damnitzhemanth-oss/FusionBoard/Images/Additional/DaVinciWho.png

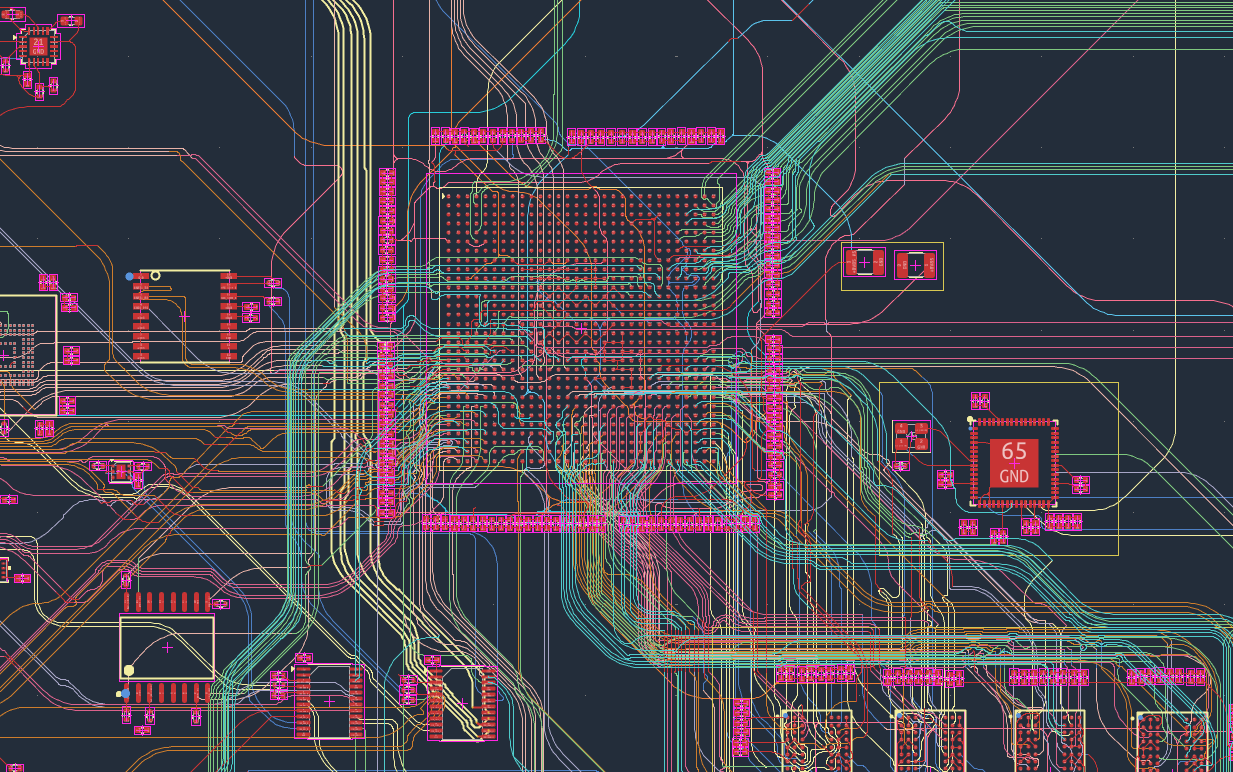
Images/Additional/DaVinciWho.png
