damnitzhemanth-oss/FusionBoard/Images/Additional/DRC.png

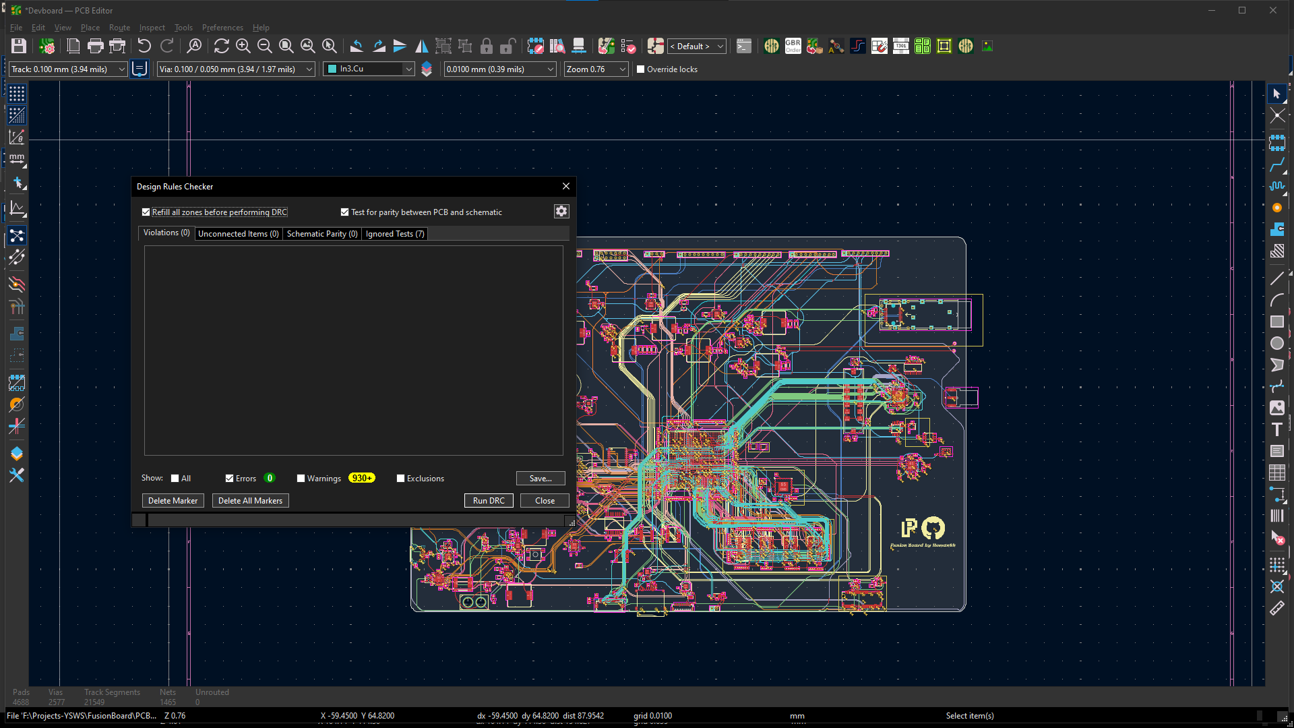
Images/Additional/DRC.png
