damnitzhemanth-oss/FusionBoard/Images/PCB/B-3D.png

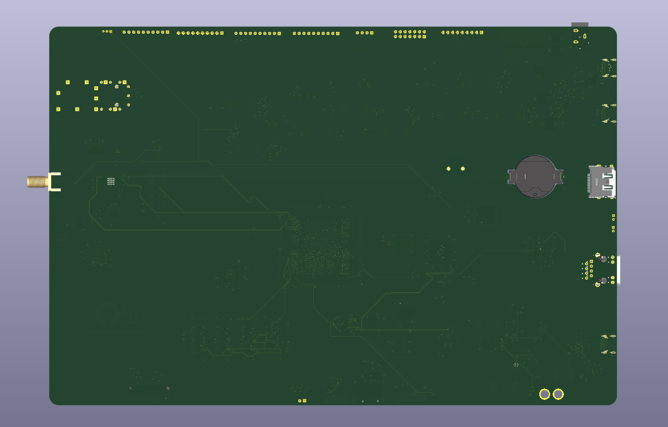
Images/PCB/B-3D.png
