damnitzhemanth-oss/FusionBoard/Images/PCB/DRC.png

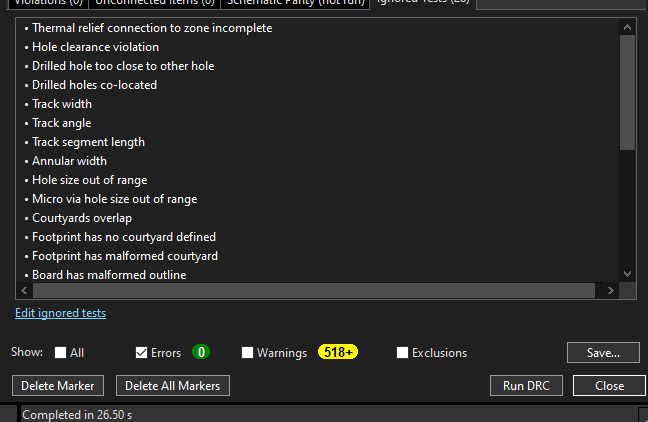
Images/PCB/DRC.png
