damnitzhemanth-oss/FusionBoard/Images/PCB/F-3D.png

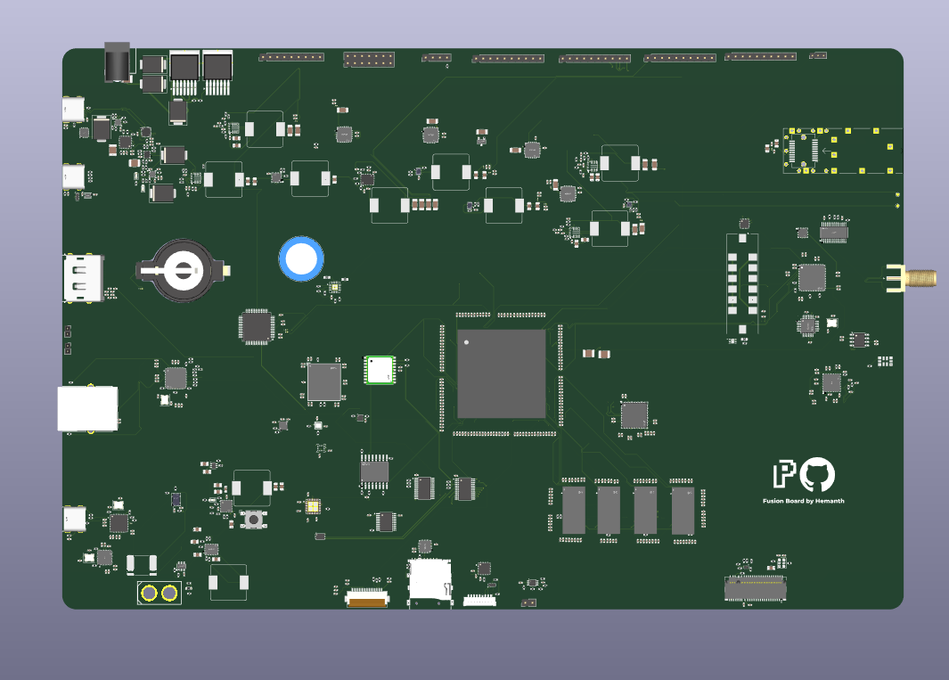
Images/PCB/F-3D.png
