damnitzhemanth-oss/FusionBoard/Images/PCB/F.cu.png

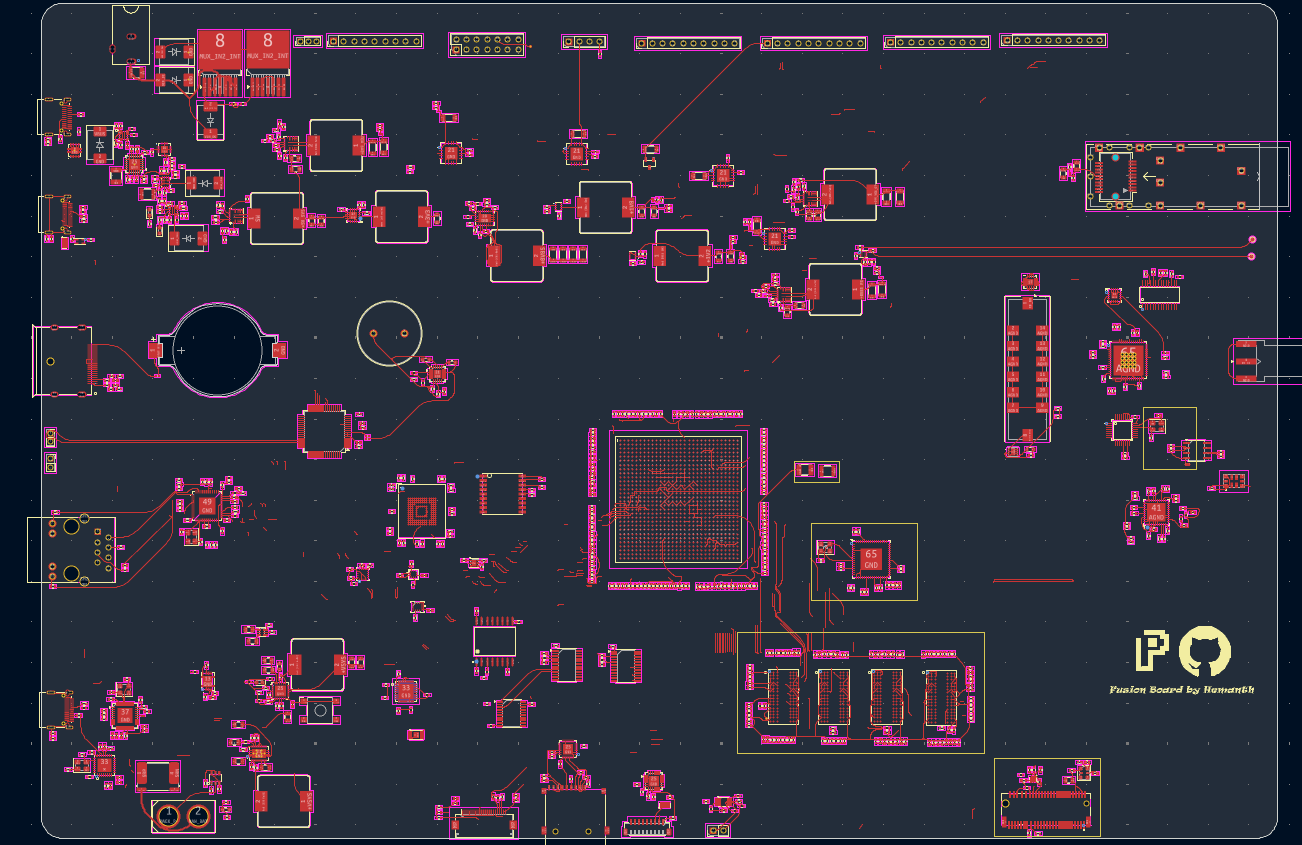
Images/PCB/F.cu.png
