damnitzhemanth-oss/FusionBoard/Images/PCB/Hero_3D.png

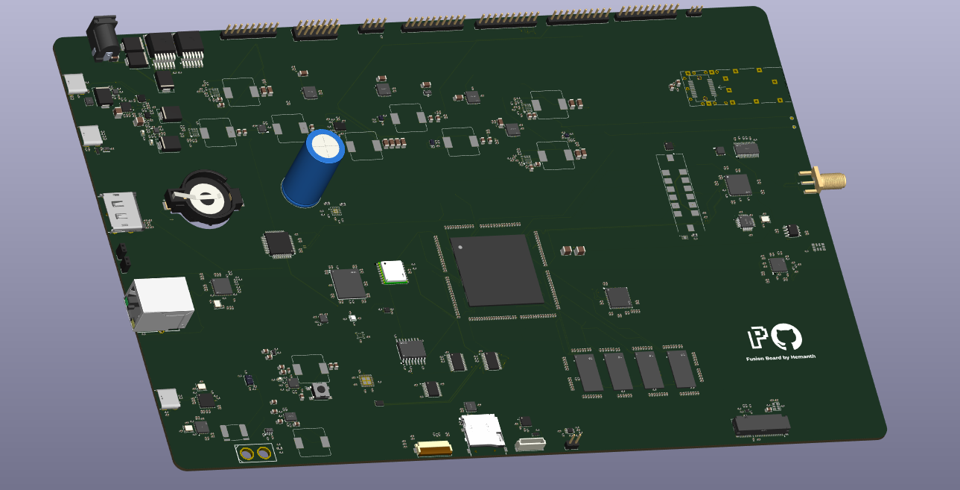
Images/PCB/Hero_3D.png
