damnitzhemanth-oss/FusionBoard/Images/PCB/In1.cu.png

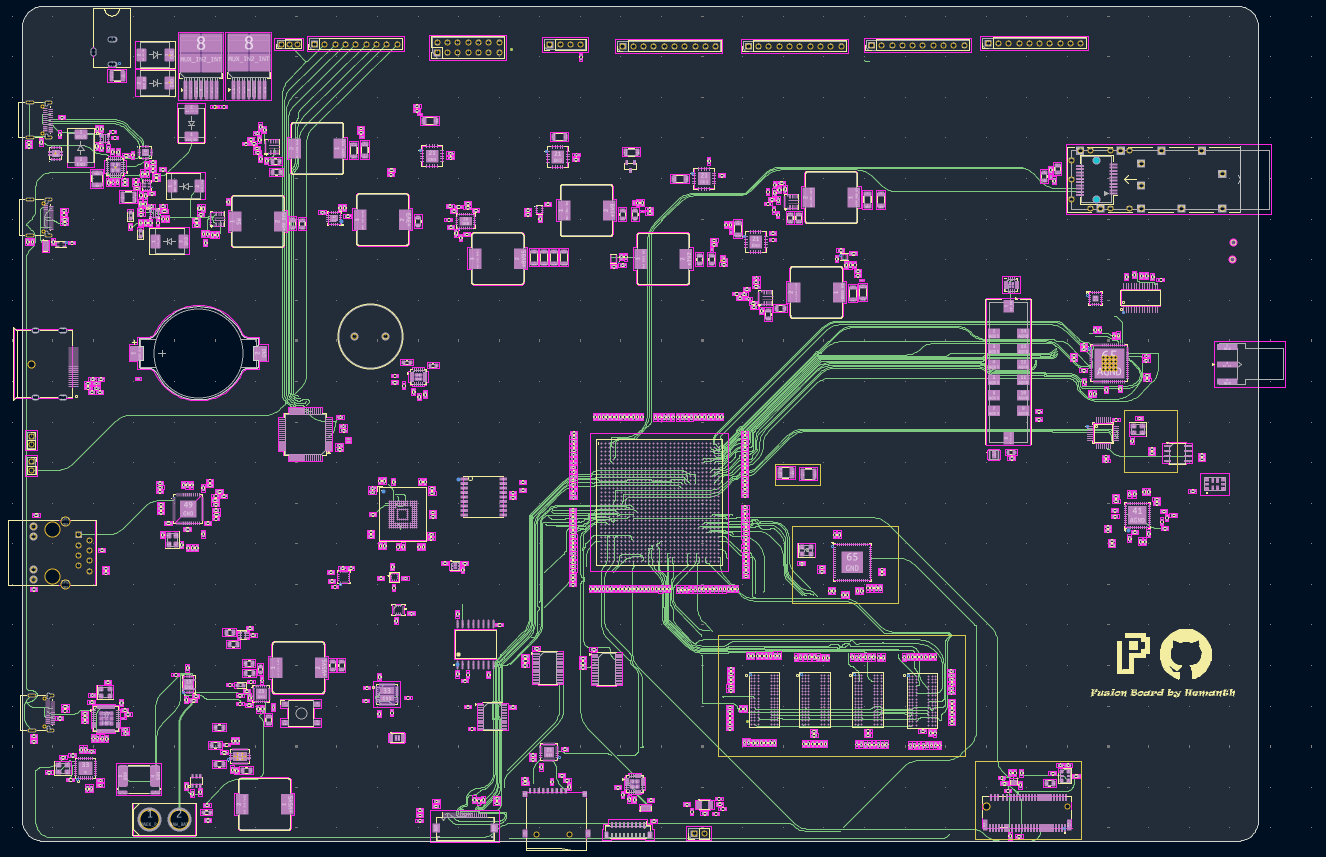
Images/PCB/In1.cu.png
