damnitzhemanth-oss/FusionBoard/Images/PCB/In2.cu.png

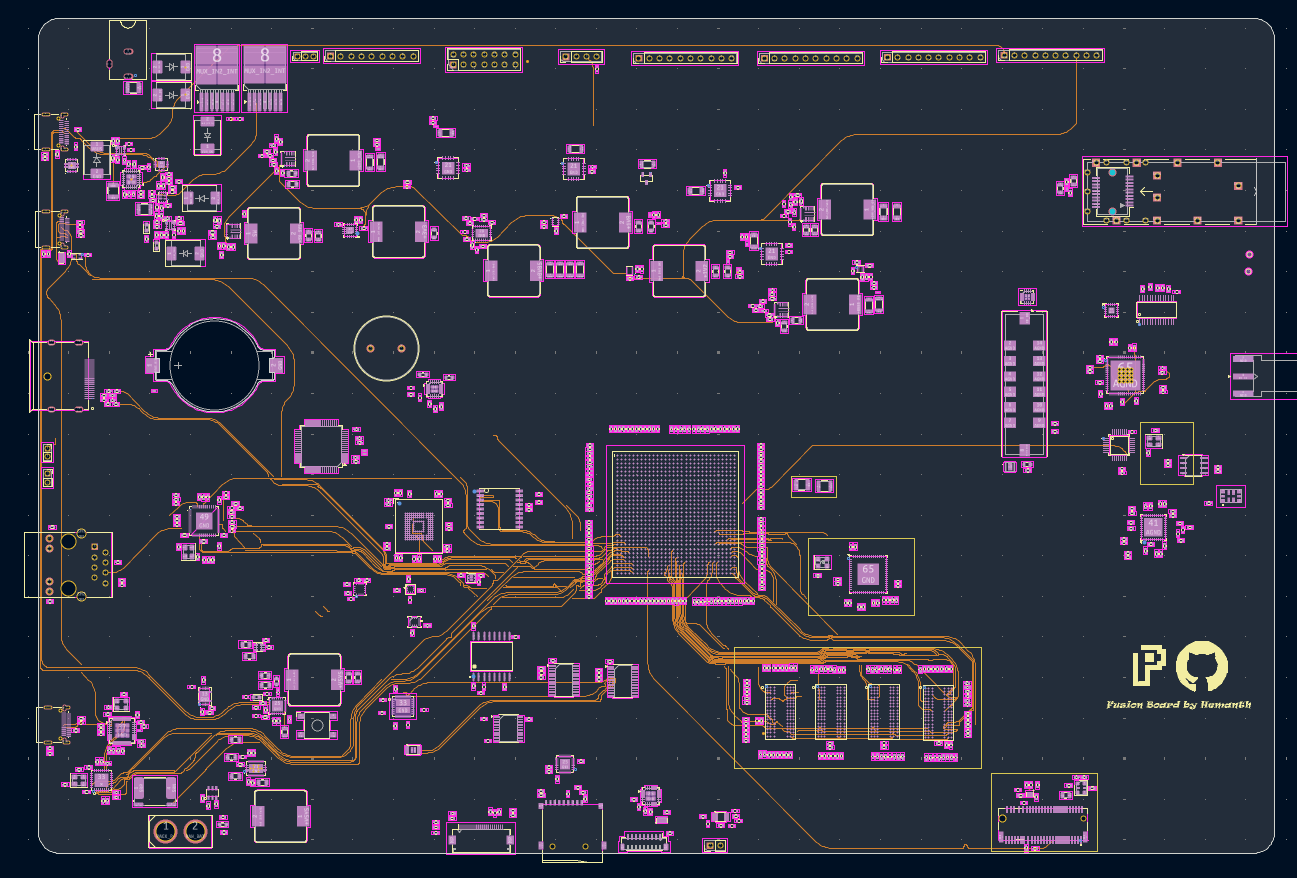
Images/PCB/In2.cu.png
