damnitzhemanth-oss/FusionBoard/Images/PCB/In3.cu.png

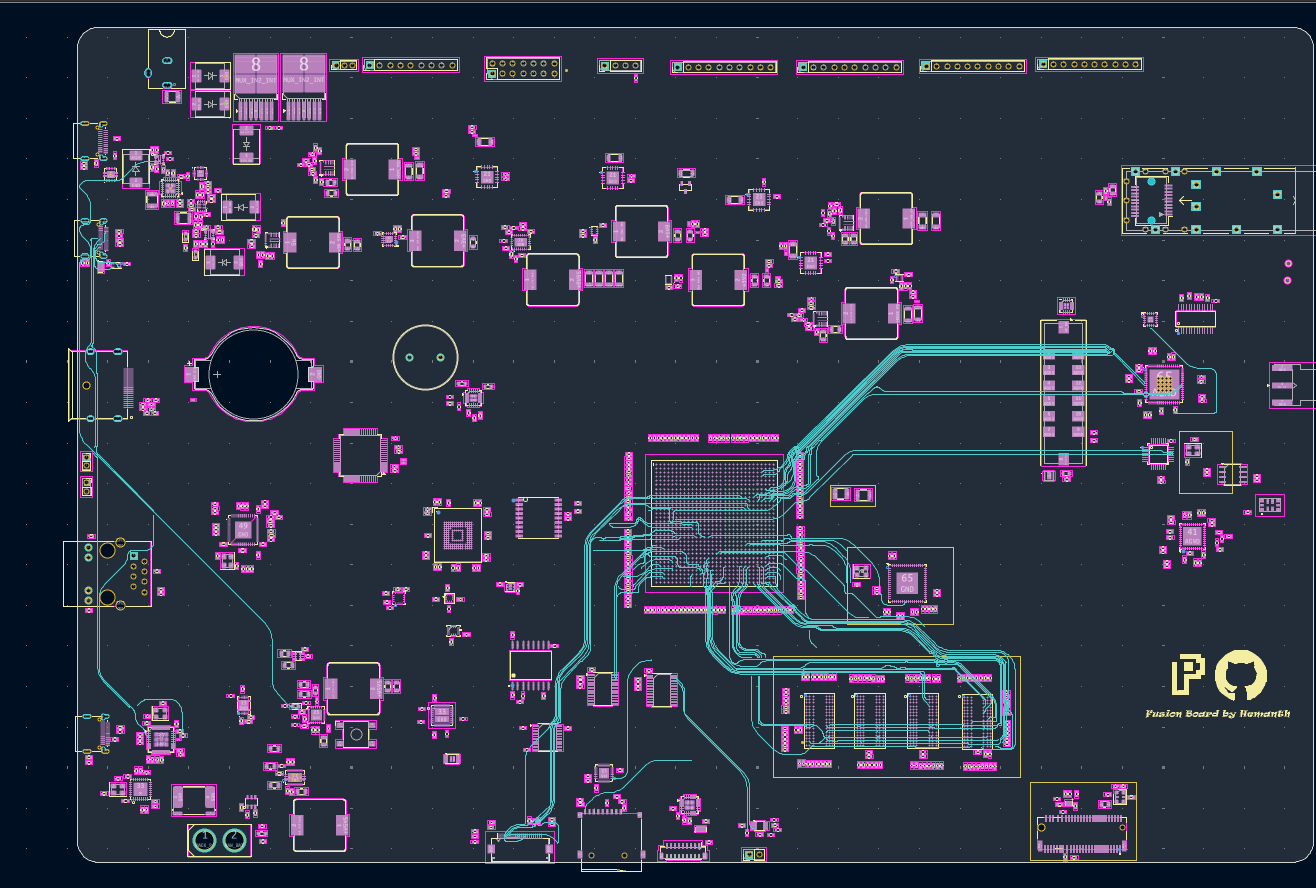
Images/PCB/In3.cu.png
