damnitzhemanth-oss/FusionBoard/Images/PCB/In4.cu.png

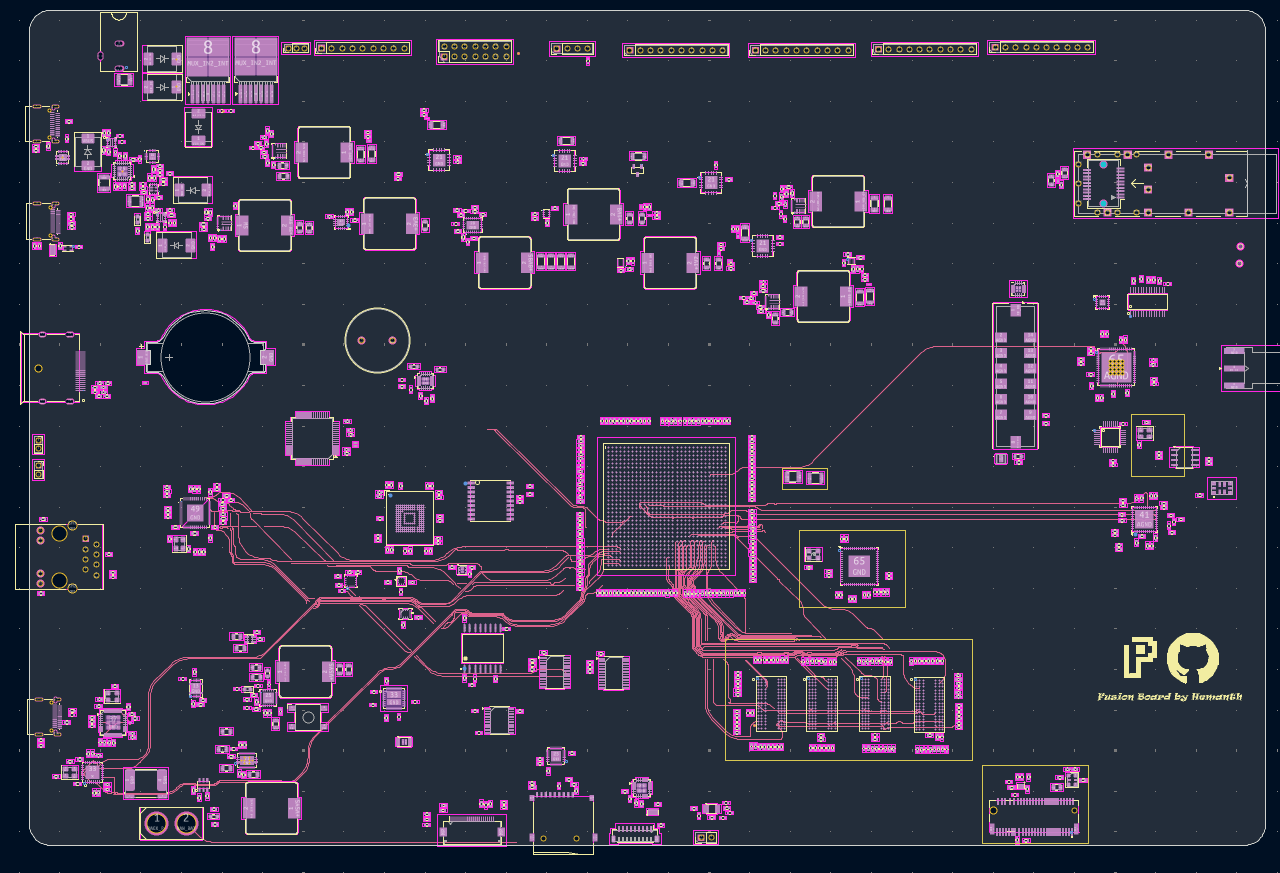
Images/PCB/In4.cu.png
