damnitzhemanth-oss/FusionBoard/Images/PCB/In5.cu.png

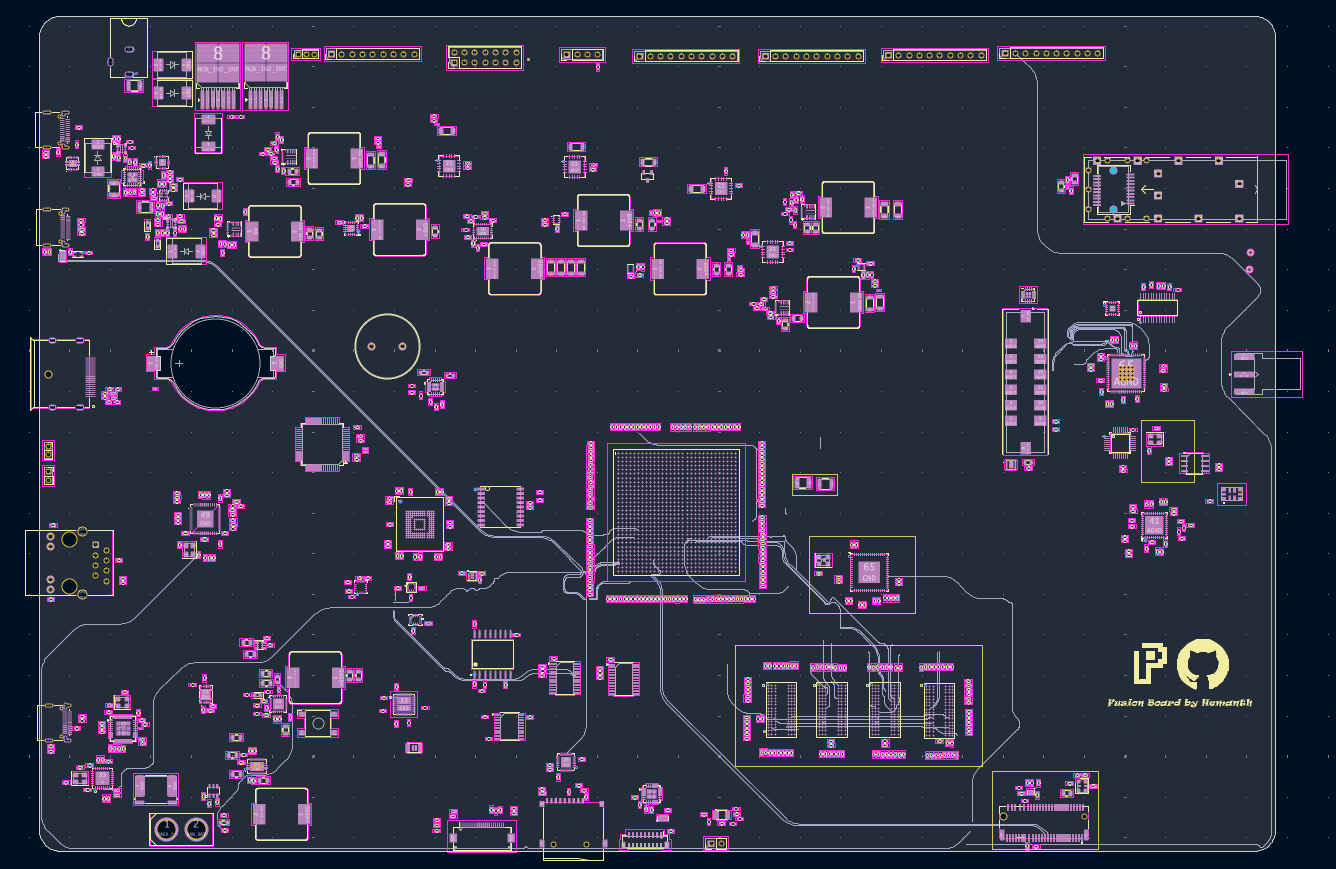
Images/PCB/In5.cu.png
