damnitzhemanth-oss/FusionBoard/PCB/Devboard/images/Schematic/01_Power/S1.5.png

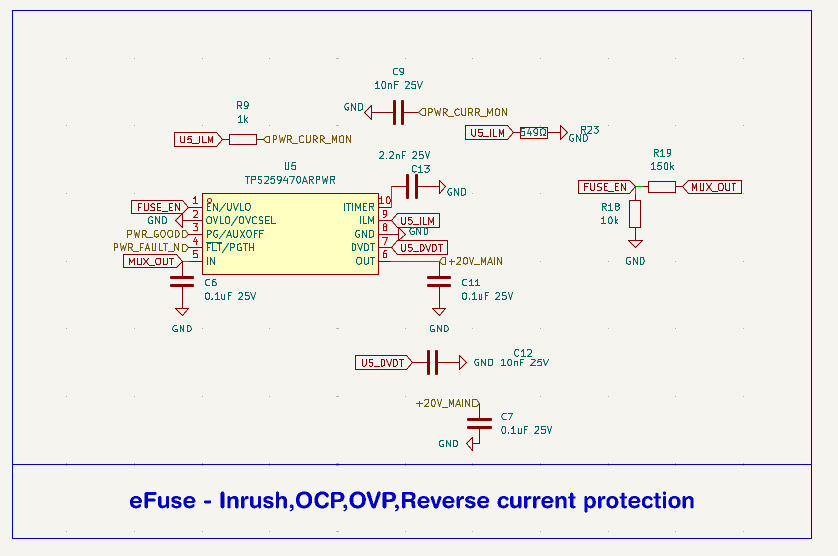
PCB/Devboard/images/Schematic/01_Power/S1.5.png
