damnitzhemanth-oss/FusionBoard/PCB/Devboard/images/Schematic/02_Battery/S2.4.png

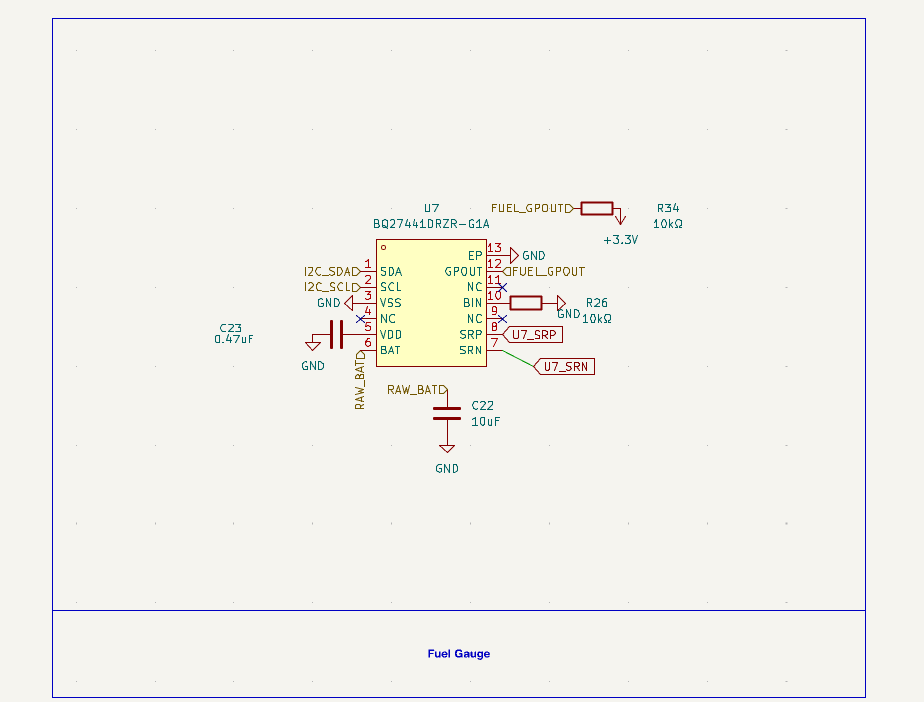
PCB/Devboard/images/Schematic/02_Battery/S2.4.png
