damnitzhemanth-oss/FusionBoard/PCB/Devboard/images/Schematic/02_Battery/S2.5.png

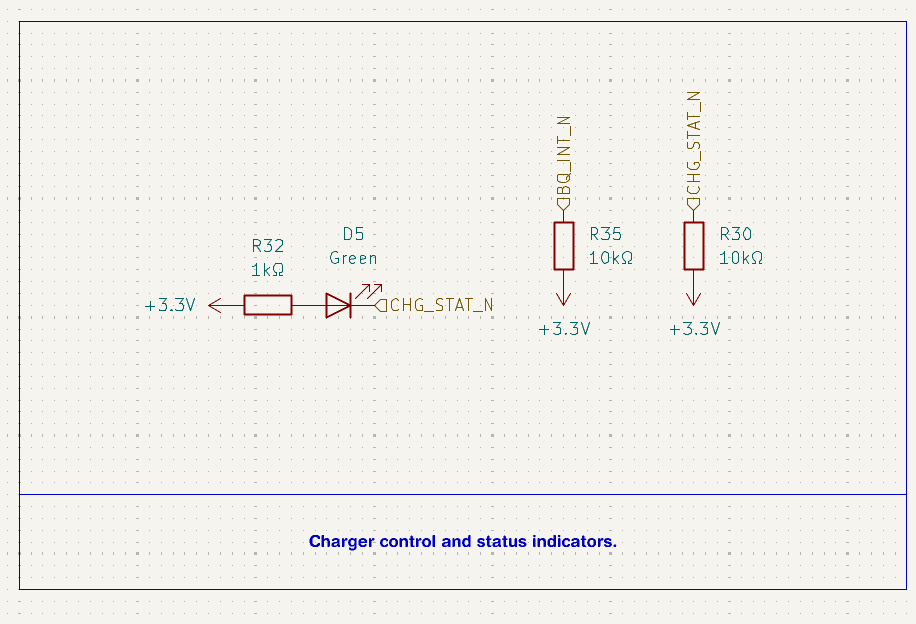
PCB/Devboard/images/Schematic/02_Battery/S2.5.png
