damnitzhemanth-oss/FusionBoard/PCB/Devboard/images/Schematic/03_Power_Tree/S3.1.png

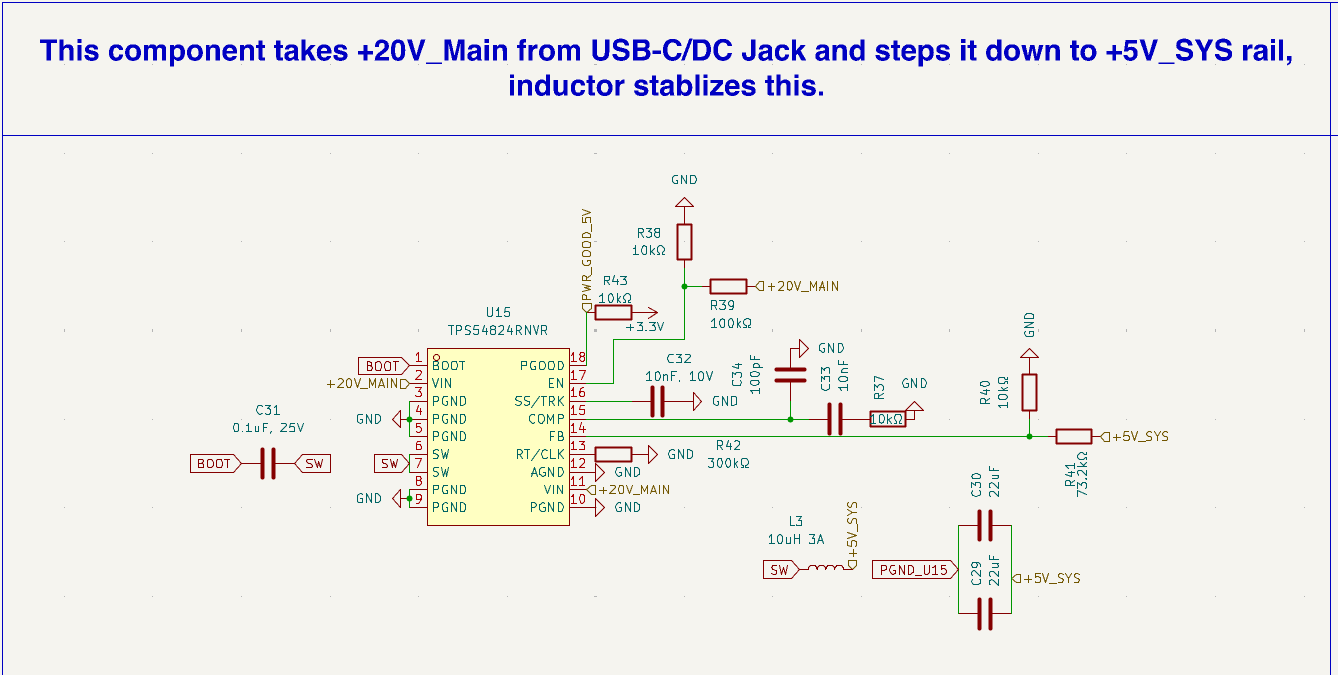
PCB/Devboard/images/Schematic/03_Power_Tree/S3.1.png
