damnitzhemanth-oss/FusionBoard/PCB/Devboard/images/Schematic/03_Power_Tree/S3.2.png

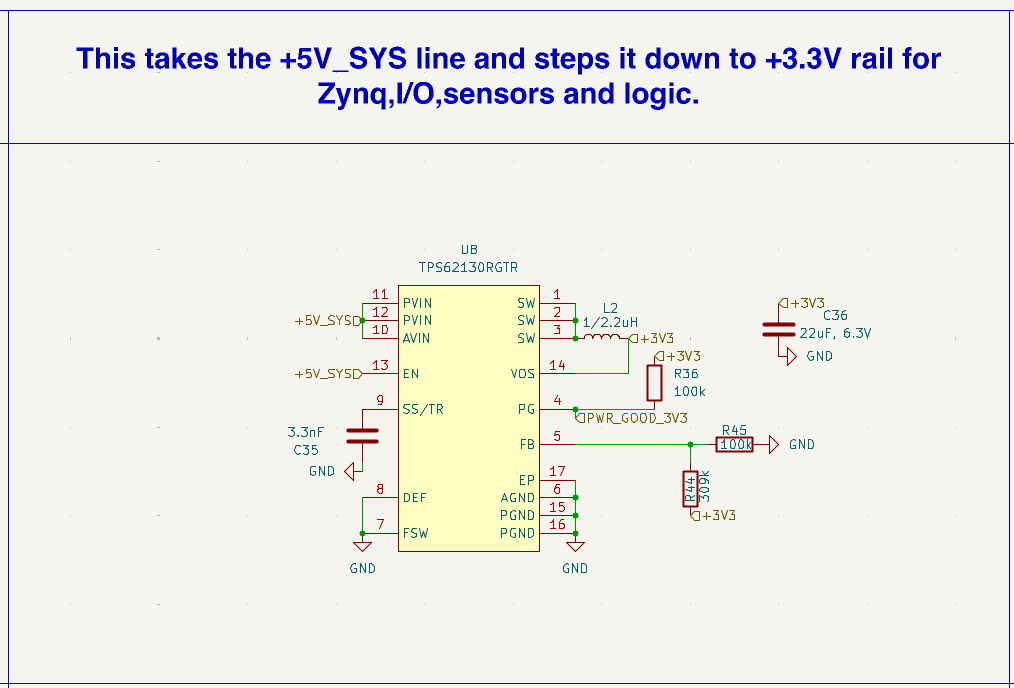
PCB/Devboard/images/Schematic/03_Power_Tree/S3.2.png
