damnitzhemanth-oss/FusionBoard/PCB/images/Before Routing.png

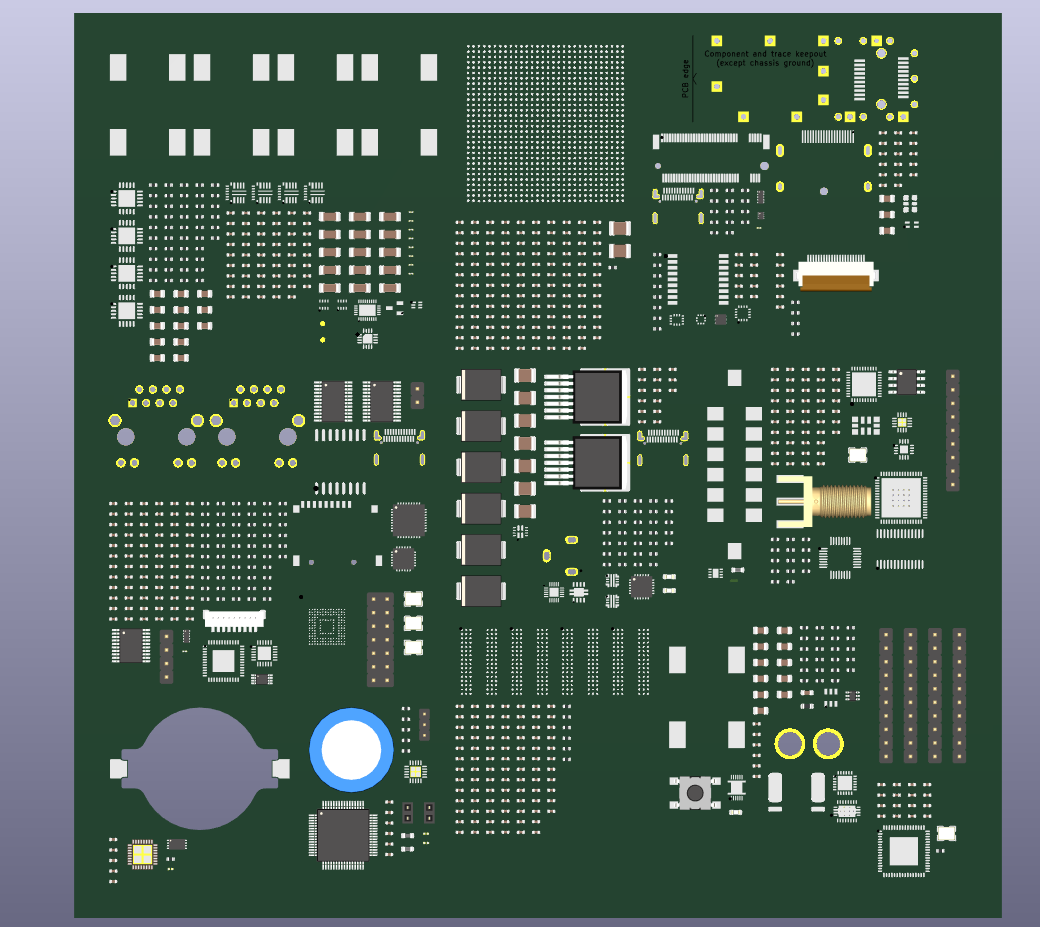
PCB/images/Before Routing.png
