damnitzhemanth-oss/FusionBoard/PCB/images/Schematic/01_Power/S1.1.png

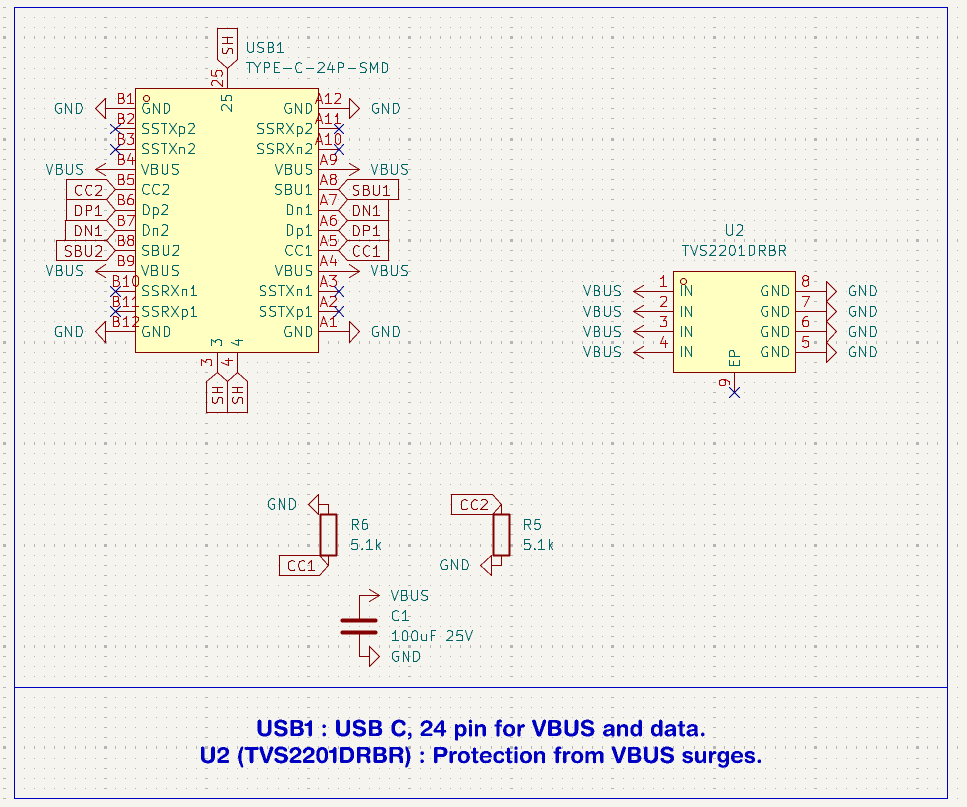
PCB/images/Schematic/01_Power/S1.1.png
