damnitzhemanth-oss/FusionBoard/PCB/images/Schematic/01_Power/S1.4.png

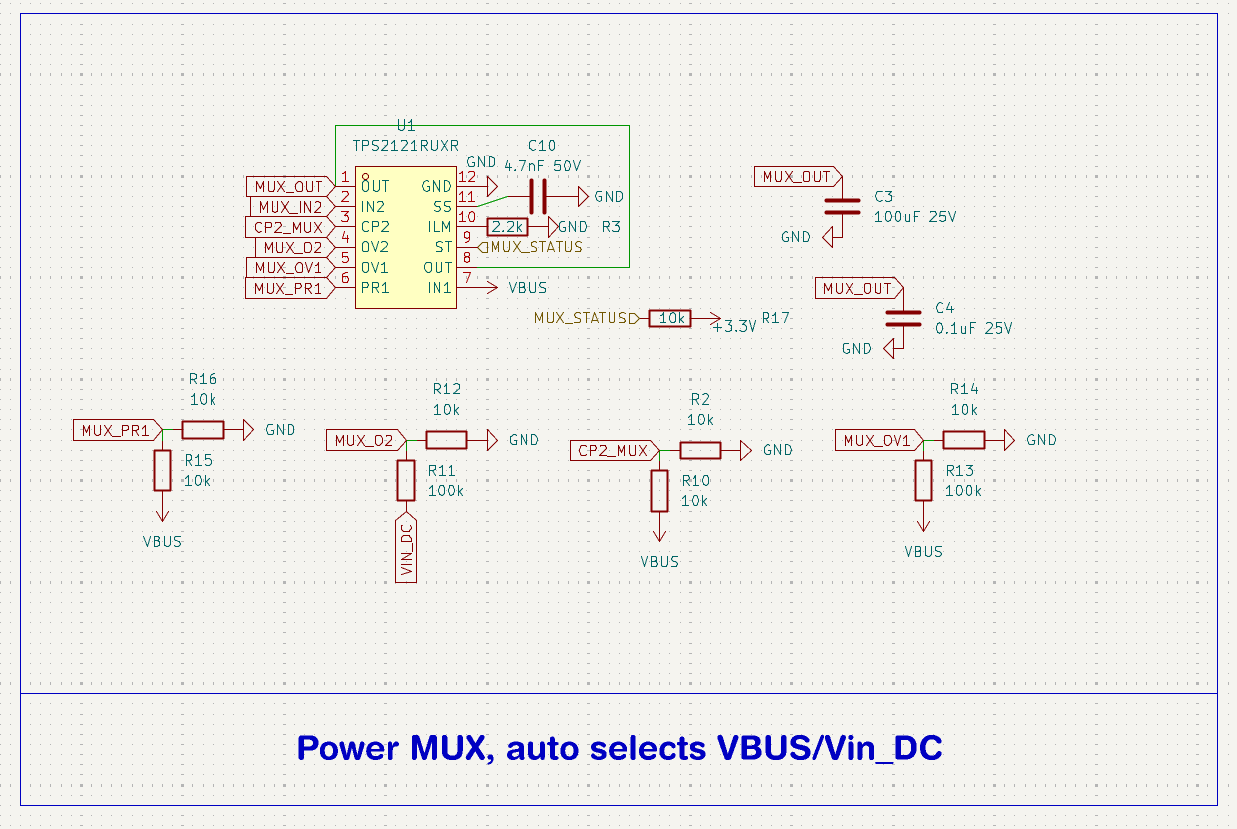
PCB/images/Schematic/01_Power/S1.4.png
