damnitzhemanth-oss/FusionBoard/PCB/images/Schematic/02_Battery/S2.1.png

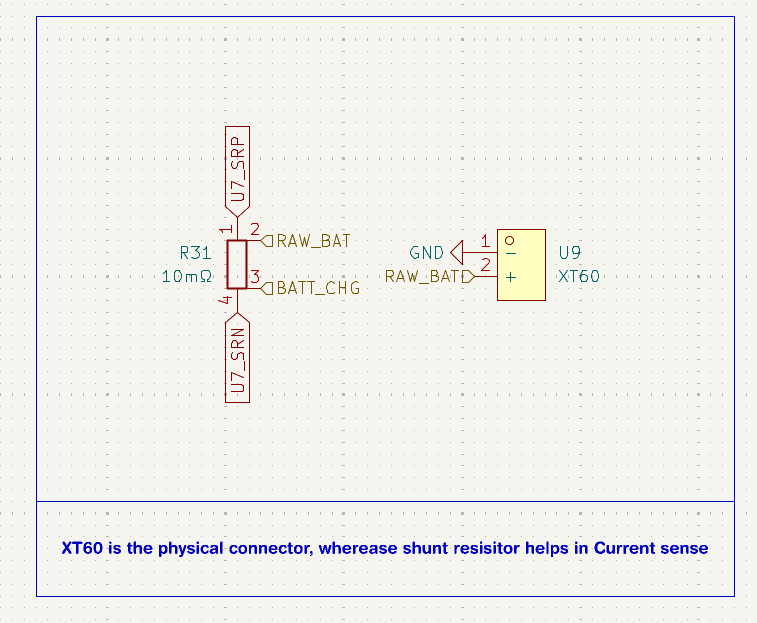
PCB/images/Schematic/02_Battery/S2.1.png
