damnitzhemanth-oss/FusionBoard/PCB/images/Schematic/02_Battery/S2.3.png

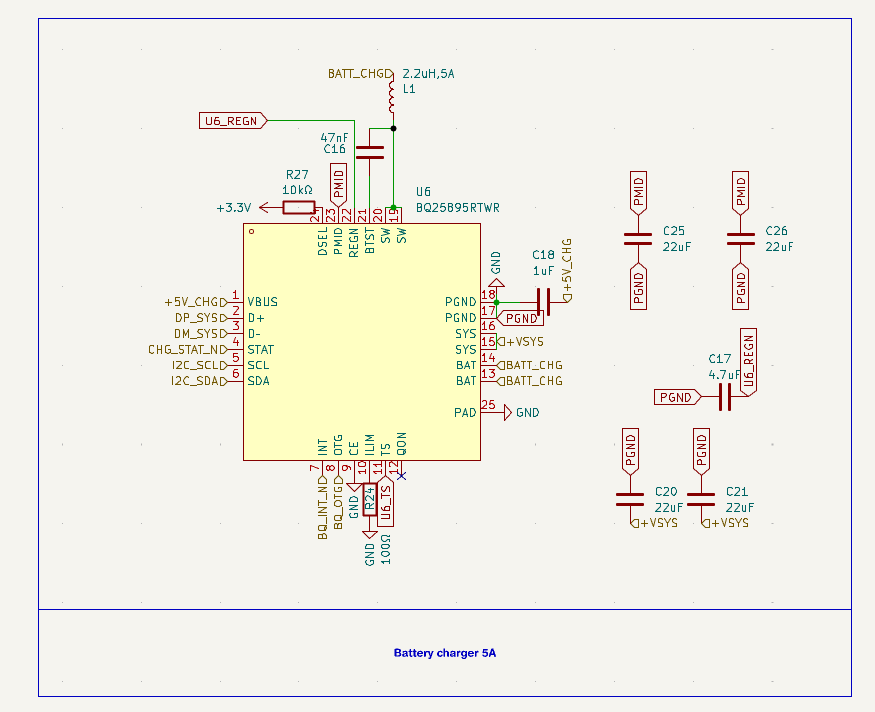
PCB/images/Schematic/02_Battery/S2.3.png
