damnitzhemanth-oss/FusionBoard/PCB/images/Schematic/02_Battery/S2.6.png

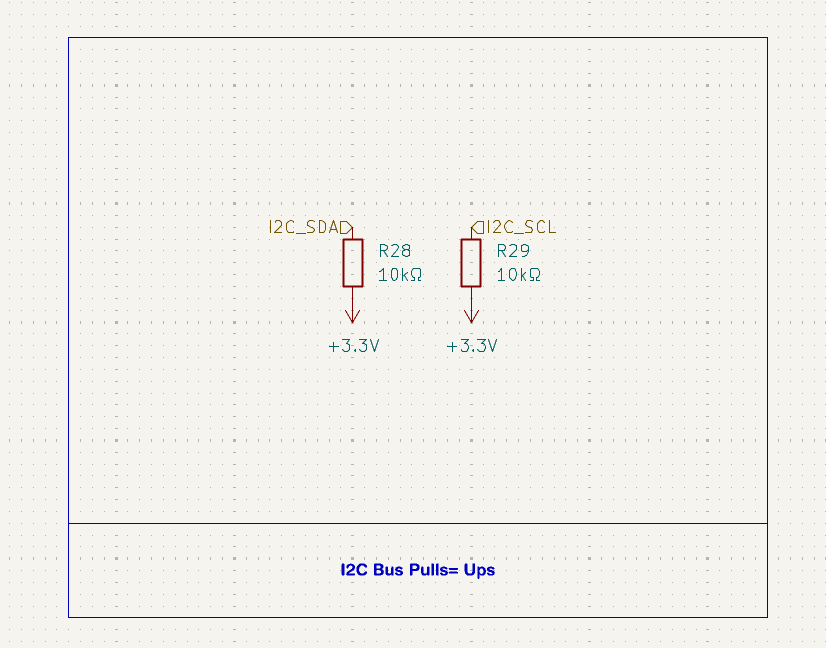
PCB/images/Schematic/02_Battery/S2.6.png
