damnitzhemanth-oss/FusionBoard/PCB/images/Schematic/03_Power_Tree/S3.3.png

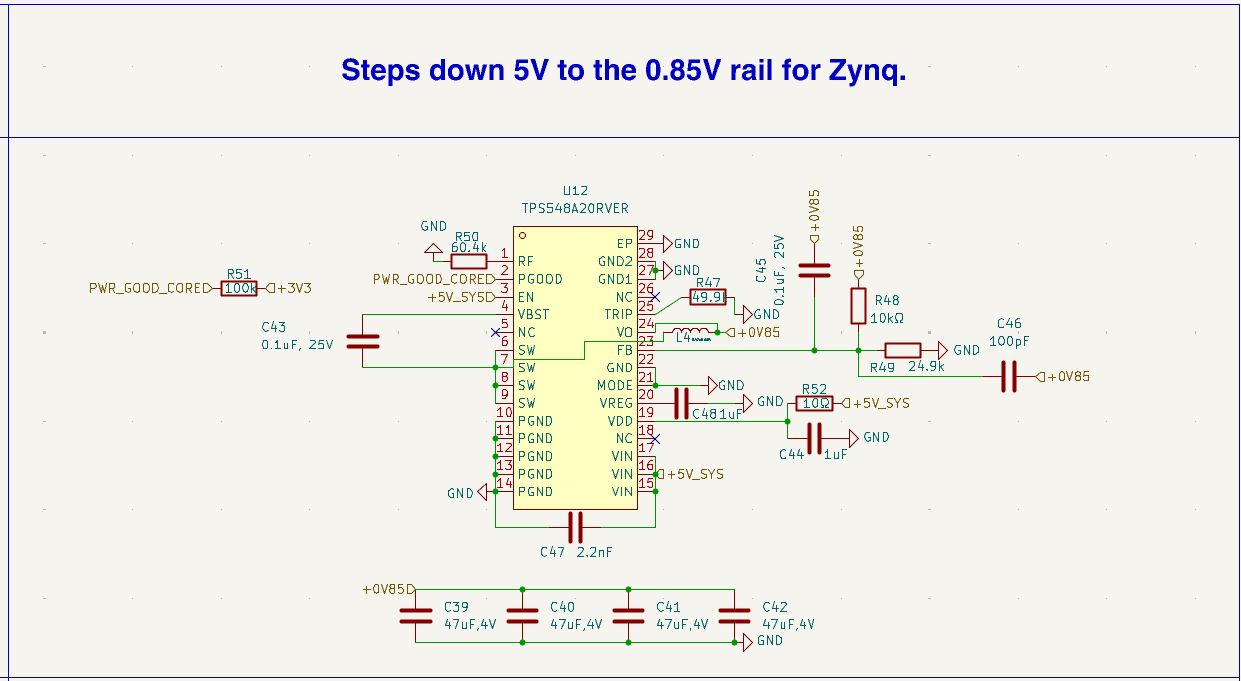
PCB/images/Schematic/03_Power_Tree/S3.3.png
