damnitzhemanth-oss/FusionBoard/PCB/images/Schematic/03_Power_Tree/S3.5.png

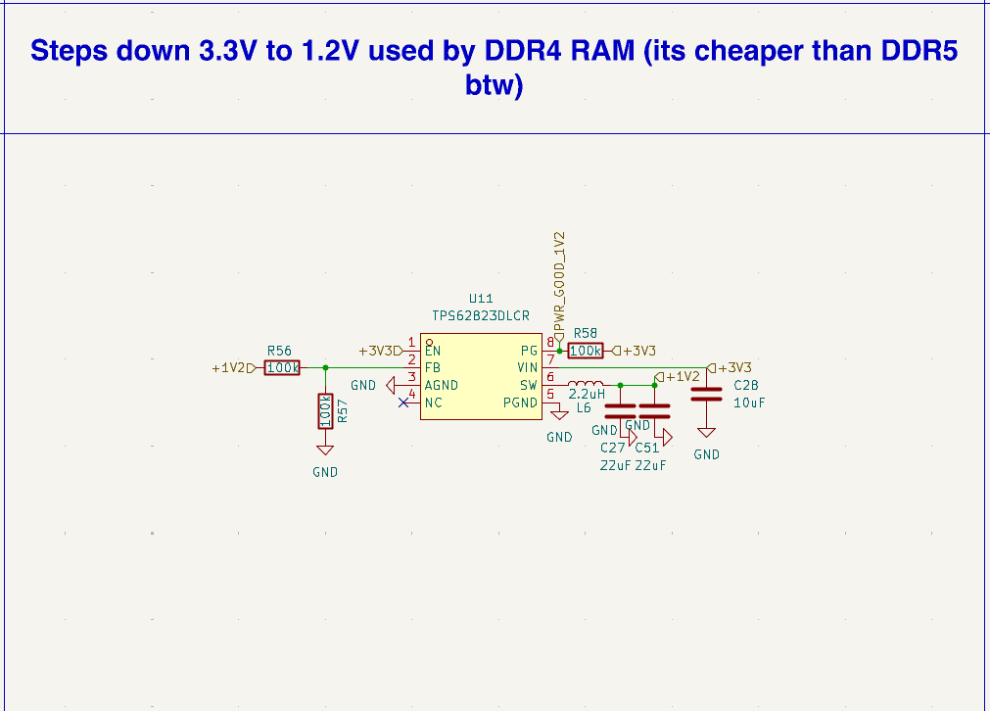
PCB/images/Schematic/03_Power_Tree/S3.5.png
