damnitzhemanth-oss/FusionBoard/Production/BOM/BillOfMaterials.csv

Reference | Qty | Value | DNP | Exclude from BOM | Exclude from Board | Exclude from Simulation | Exclude from Position Files | Footprint | Datasheet | Description | # | LCSC Part
BT1 | 1 | Battery_Cell |  |  |  |  | ${EXCLUDE_FROM_POS_FILES} | Battery:BatteryHolder_Keystone_1057_1x2032 |  | Single-cell battery | 1
C1,C3,C8 | 3 | 1uF |  |  |  |  | ${EXCLUDE_FROM_POS_FILES} | Capacitor_SMD:C_1210_3225Metric |  | Unpolarized capacitor | 2
C2,C9,C15 | 3 | 100uF 35V |  |  |  |  | ${EXCLUDE_FROM_POS_FILES} | Capacitor_SMD:C_1210_3225Metric |  | Unpolarized capacitor | 3
C4 | 1 | 100nF |  |  |  |  | ${EXCLUDE_FROM_POS_FILES} | Capacitor_SMD:C_1210_3225Metric |  | Unpolarized capacitor | 4
C5,C10 | 2 | 1uF 25V |  |  |  |  | ${EXCLUDE_FROM_POS_FILES} | Capacitor_SMD:C_0402_1005Metric |  | Unpolarized capacitor | 5
C6 | 1 | 2.2uF |  |  |  |  | ${EXCLUDE_FROM_POS_FILES} | Capacitor_SMD:C_0402_1005Metric |  | Unpolarized capacitor | 6
C7,C26,C31,C412,C413,C414,C415,C416,C417,C418,C419,C420,C421,C423,C425,C426,C427,C428,C430,C448,C449,C450,C452,C456,C458,C460,C461,C462,C463,C464,C467,C471,C476,C480,C491,C492,C500 | 37 | 100nF |  |  |  |  | ${EXCLUDE_FROM_POS_FILES} | Capacitor_SMD:C_0402_1005Metric |  | Unpolarized capacitor | 7
C11 | 1 | 0.1uF 50V X7R |  |  |  |  | ${EXCLUDE_FROM_POS_FILES} | Capacitor_SMD:C_0402_1005Metric |  | Unpolarized capacitor | 8
C12,C13,C20 | 3 | 10nF 25V |  |  |  |  | ${EXCLUDE_FROM_POS_FILES} | Capacitor_SMD:C_0402_1005Metric |  | Unpolarized capacitor | 9
C14,C81,C85,C111,C_shield1 | 5 | 4.7nF 50V |  |  |  |  | ${EXCLUDE_FROM_POS_FILES} | Capacitor_SMD:C_0402_1005Metric |  | Unpolarized capacitor | 10
C16 | 1 | 2.2nF 25V |  |  |  |  | ${EXCLUDE_FROM_POS_FILES} | Capacitor_SMD:C_0402_1005Metric |  | Unpolarized capacitor | 11
C17,C18,C66,C68,C70,C72,C74,C94,C105,C119 | 10 | 0.1uF 25V |  |  |  |  | ${EXCLUDE_FROM_POS_FILES} | Capacitor_SMD:C_0402_1005Metric |  | Unpolarized capacitor | 12
C19,C21 | 2 | 0.1uF 50V |  |  |  |  | ${EXCLUDE_FROM_POS_FILES} | Capacitor_SMD:C_0402_1005Metric |  | Unpolarized capacitor | 13
C22 | 1 | 47nF |  |  |  |  | ${EXCLUDE_FROM_POS_FILES} | Capacitor_SMD:C_0402_1005Metric |  | Unpolarized capacitor | 14
C23,C24,C28,C29,C30,C50,C52,C60,C61,C64,C65 | 11 | 22uF |  |  |  |  | ${EXCLUDE_FROM_POS_FILES} | Capacitor_SMD:C_0805_2012Metric |  | Unpolarized capacitor | 15
C25,C45,C48,C62,C101,C102,C117,C342,C344,C346,C348,C350,C352,C353,C355,C357,C359,C361,C391,C393,C394,C395,C396,C398,C400,C404,C457,C459,C466,C468,C470,C472,C479,C497,C498 | 35 | 1uF |  |  |  |  | ${EXCLUDE_FROM_POS_FILES} | Capacitor_SMD:C_0402_1005Metric |  | Unpolarized capacitor | 16
C27 | 1 | 4.7uF |  |  |  |  | ${EXCLUDE_FROM_POS_FILES} | Capacitor_SMD:C_0603_1608Metric |  | Unpolarized capacitor | 17
C32,C33,C37 | 3 | 1uF |  |  |  |  | ${EXCLUDE_FROM_POS_FILES} | Capacitor_SMD:C_0805_2012Metric |  | Unpolarized capacitor | 18
C34 | 1 | 0.47uF |  |  |  |  | ${EXCLUDE_FROM_POS_FILES} | Capacitor_SMD:C_0402_1005Metric |  | Unpolarized capacitor | 19
C35,C39 | 2 | 10nF |  |  |  |  | ${EXCLUDE_FROM_POS_FILES} | Capacitor_SMD:C_0805_2012Metric |  | Unpolarized capacitor | 20
C36,C58,C59,C63,C67,C69,C71,C73,C75,C95,C98,C100,C106,C108,C120,C451,C453,C454,C455,C465,C469,C484,C486,C488,C490,C507 | 26 | 10uF |  |  |  |  | ${EXCLUDE_FROM_POS_FILES} | Capacitor_SMD:C_0402_1005Metric |  | Unpolarized capacitor | 21
C38 | 1 | 0.1uF |  |  |  |  | ${EXCLUDE_FROM_POS_FILES} | Capacitor_SMD:C_0805_2012Metric |  | Unpolarized capacitor | 22
C40 | 1 | 22uF, 6.3V |  |  |  |  | ${EXCLUDE_FROM_POS_FILES} | Capacitor_SMD:C_0805_2012Metric |  | Unpolarized capacitor | 23
C41,C49 | 2 | 0.1uF, 25V |  |  |  |  | ${EXCLUDE_FROM_POS_FILES} | Capacitor_SMD:C_0402_1005Metric |  | Unpolarized capacitor | 24
C42,C43,C82,C86,C103,C112,C477,C478,C495,C496 | 10 | 100pF |  |  |  |  | ${EXCLUDE_FROM_POS_FILES} | Capacitor_SMD:C_0402_1005Metric |  | Unpolarized capacitor | 25
C44 | 1 | 10nF, 10V |  |  |  |  | ${EXCLUDE_FROM_POS_FILES} | Capacitor_SMD:C_0402_1005Metric |  | Unpolarized capacitor | 26
C46,C79,C83,C109 | 4 | 10nF |  |  |  |  | ${EXCLUDE_FROM_POS_FILES} | Capacitor_SMD:C_0402_1005Metric |  | Unpolarized capacitor | 27
C47 | 1 | 3.3nF |  |  |  |  | ${EXCLUDE_FROM_POS_FILES} | Capacitor_SMD:C_0402_1005Metric |  | Unpolarized capacitor | 28
C51 | 1 | 2.2nF |  |  |  |  | ${EXCLUDE_FROM_POS_FILES} | Capacitor_SMD:C_0402_1005Metric |  | Unpolarized capacitor | 29
C53,C54,C55,C56 | 4 | 47uF,4V |  |  |  |  | ${EXCLUDE_FROM_POS_FILES} | Capacitor_SMD:C_1206_3216Metric |  | Unpolarized capacitor | 30
C57,C97,C99,C107,C113 | 5 | 47uF |  |  |  |  | ${EXCLUDE_FROM_POS_FILES} | Capacitor_SMD:C_1206_3216Metric |  | Unpolarized capacitor | 31
C76,C78,C104 | 3 | 0.1uF 25v |  |  |  |  | ${EXCLUDE_FROM_POS_FILES} | Capacitor_SMD:C_0402_1005Metric |  | Unpolarized capacitor | 32
C77,C121,C122,C123,C124,C125,C126,C127,C128,C129,C130,C131,C132,C133,C134,C135,C136,C137,C138,C139,C140,C141,C142,C143,C144,C145,C146,C147,C148,C149,C150,C151,C152,C153,C155,C156,C157,C158,C159,C160,C161,C162,C163,C164,C165,C166,C167,C168,C169,C170,C171,C172,C173,C175,C176,C177,C178,C179,C180,C181,C182,C183,C184,C185,C186,C187,C188,C189,C190,C191,C192,C193,C194,C195,C196,C197,C198,C199,C200,C201,C202,C203,C204,C205,C206,C207,C208,C209,C210,C211,C212,C213,C214,C215,C216,C217,C218,C219,C220,C221,C222,C223,C224,C225,C226,C227,C228,C229,C230,C231,C232,C233,C234,C235,C236,C237,C238,C239,C240,C241,C242,C243,C244,C245,C246,C247,C248,C249,C250,C251,C252,C253,C254,C255,C256,C257,C258,C259,C260,C261,C262,C263,C264,C265,C266,C267,C268,C269,C270,C271,C272,C273,C274,C275,C276,C277,C278,C279,C280,C281,C282,C283,C284,C285,C286,C287,C288,C289,C290,C291,C292,C293,C294,C295,C296,C297,C298,C299,C300,C301,C302,C303,C304,C305,C306,C307,C308,C309,C310,C311,C312,C313,C314,C315,C316,C317,C318,C319,C320,C321,C322,C323,C324,C325,C326,C327,C328,C329,C330,C331,C332,C333,C334,C335,C336,C337,C338,C339,C340,C341,C343,C345,C347,C349,C351,C354,C356,C358,C360,C362,C363,C364,C365,C366,C367,C371,C374,C376,C377,C378,C379,C384,C386,C387,C388,C389,C390,C397,C399,C401,C402,C403,C405,C406,C407,C410,C411,C432,C433,C434,C435,C436,C437,C438,C439,C440,C441,C442,C443,C444,C445,C446,C447,C483,C485,C487,C489,C493,C494,C501,C502,C503,C504,C505,C506,C508,C509,C510,C511,C512,C513,C514,C515,C516,C517,C519,C520,C521,C522,C523 | 300 | 0.1uF |  |  |  |  | ${EXCLUDE_FROM_POS_FILES} | Capacitor_SMD:C_0402_1005Metric |  | Unpolarized capacitor | 33
C80,C84,C91,C96,C110,C118 | 6 | 22uf 25v |  |  |  |  | ${EXCLUDE_FROM_POS_FILES} | Capacitor_SMD:C_0805_2012Metric |  | Unpolarized capacitor | 34
C87,C88,C114,C481,C482 | 5 | 22pF |  |  |  |  | ${EXCLUDE_FROM_POS_FILES} | Capacitor_SMD:C_0402_1005Metric |  | Unpolarized capacitor | 35
C89,C90,C92,C93,C115,C116 | 6 | 47uF 6.3V |  |  |  |  | ${EXCLUDE_FROM_POS_FILES} | Capacitor_SMD:C_1206_3216Metric |  | Unpolarized capacitor | 36
C154,C174 | 2 | 47uF |  |  |  |  | ${EXCLUDE_FROM_POS_FILES} | Capacitor_SMD:C_1210_3225Metric |  | Unpolarized capacitor | 37
C368,C369,C370,C380,C381,C382,C383,C392,C422 | 9 | 1nF |  |  |  |  | ${EXCLUDE_FROM_POS_FILES} | Capacitor_SMD:C_0402_1005Metric |  | Unpolarized capacitor | 38
C372,C373,C408,C409 | 4 | 33pF |  |  |  |  | ${EXCLUDE_FROM_POS_FILES} | Capacitor_SMD:C_0402_1005Metric |  | Unpolarized capacitor | 39
C375,C385 | 2 | 22uF |  |  |  |  | ${EXCLUDE_FROM_POS_FILES} | Capacitor_SMD:C_0402_1005Metric |  | Unpolarized capacitor | 40
C424,C429,C431 | 3 | 10uF |  |  |  |  | ${EXCLUDE_FROM_POS_FILES} | Capacitor_SMD:C_0805_2012Metric |  | Unpolarized capacitor | 41
C473 | 1 | 0.56 nF |  |  |  |  | ${EXCLUDE_FROM_POS_FILES} | Capacitor_SMD:C_0402_1005Metric |  | Unpolarized capacitor | 42
C474 | 1 | 330 nF |  |  |  |  | ${EXCLUDE_FROM_POS_FILES} | Capacitor_SMD:C_0402_1005Metric |  | Unpolarized capacitor | 43
C475 | 1 | 3.3 nF |  |  |  |  | ${EXCLUDE_FROM_POS_FILES} | Capacitor_SMD:C_0402_1005Metric |  | Unpolarized capacitor | 44
C499 | 1 | 0.1 uF |  |  |  |  | ${EXCLUDE_FROM_POS_FILES} | Capacitor_SMD:C_0402_1005Metric |  | Unpolarized capacitor | 45
C518 | 1 | 22F 5.5V |  |  |  |  | ${EXCLUDE_FROM_POS_FILES} | Capacitor_THT:C_Radial_D16.0mm_H31.5mm_P7.50mm |  | Unpolarized capacitor | 46
Card1 | 1 | TF-01A |  |  |  |  | ${EXCLUDE_FROM_POS_FILES} | Devboard_Footprints:TF-SMD_TF-01A | https://lcsc.com/product-detail/Card-Sockets_TF-01A_C91145.html |  | 47 | C91145
CN1 | 1 | 1-2199230-6 |  |  |  |  | ${EXCLUDE_FROM_POS_FILES} | Devboard_Footprints:PCIE-SMD_1-2199230-6 | https://www.lcsc.com/datasheet/C4710843.pdf |  | 48 | C4710843
D1 | 1 | SMBJ20A |  |  |  |  | ${EXCLUDE_FROM_POS_FILES} | Diode_SMD:D_SMC |  | Bidirectional transient-voltage-suppression diode | 49
D2 | 1 | 15V |  |  |  |  | ${EXCLUDE_FROM_POS_FILES} | Diode_SMD:D_SMC |  | Zener diode | 50
D3 | 1 | TP7.OSMD24CA-XC |  |  |  |  | ${EXCLUDE_FROM_POS_FILES} | Diode_SMD:D_SMC |  | Bidirectional transient-voltage-suppression diode | 51
D4 | 1 | LSMB24CAH |  |  |  |  | ${EXCLUDE_FROM_POS_FILES} | Diode_SMD:D_SMC |  | Bidirectional transient-voltage-suppression diode | 52
D5 | 1 | Red |  |  |  |  | ${EXCLUDE_FROM_POS_FILES} | LED_SMD:LED_0603_1608Metric |  | Light emitting diode | 53
D6,D9 | 2 | Green |  |  |  |  | ${EXCLUDE_FROM_POS_FILES} | LED_SMD:LED_0603_1608Metric |  | Light emitting diode | 54
D7,D8 | 2 | D_Schottky |  |  |  |  | ${EXCLUDE_FROM_POS_FILES} | Diode_SMD:D_SMC |  | Schottky diode | 55
D10,D11,D12 | 3 | RB521S30 |  |  |  |  | ${EXCLUDE_FROM_POS_FILES} | Diode_SMD:D_0201_0603Metric |  | Schottky diode | 56
DC1 | 1 | PJ-102AH_C3096093 |  |  |  |  | ${EXCLUDE_FROM_POS_FILES} | Devboard_Footprints:DC-IN-TH_PJ-102AH | https://www.lcsc.com/datasheet/C3096093.pdf |  | 57 | C3096093
FB1,FB2,FB3,FB4,FB5,FB6,FB7,FB8,FB10 | 9 | 120Ω@100MHz |  |  |  |  | ${EXCLUDE_FROM_POS_FILES} | Inductor_SMD:L_01005_0402Metric |  | Ferrite bead | 58
FB9 | 1 | BLM18 |  |  |  |  | ${EXCLUDE_FROM_POS_FILES} | Inductor_SMD:L_01005_0402Metric |  | Ferrite bead | 59
J1 | 1 | HR911105A_C12074 |  |  |  |  | ${EXCLUDE_FROM_POS_FILES} | Devboard_Footprints:RJ45-TH_HR911105A | https://lcsc.com/product-detail/RJ45_RJ45-LED_C12074.html | RJ45-LED | 60 | C12074
J2 | 1 | Conn_01x03_Pin |  |  |  |  | ${EXCLUDE_FROM_POS_FILES} | Connector_PinHeader_2.00mm:PinHeader_1x03_P2.00mm_Vertical |  | Generic connector, single row, 01x03, script generated | 61
J3 | 1 | USB3_B |  |  |  |  | ${EXCLUDE_FROM_POS_FILES} | Connector_JST:JST_SH_BM09B-SRSS-TB_1x09-1MP_P1.00mm_Vertical |  | USB 3.0 B connector | 62
J4,J5 | 2 | Conn_01x02_Pin |  |  |  |  | ${EXCLUDE_FROM_POS_FILES} | Connector_PinSocket_2.00mm:PinSocket_1x02_P2.00mm_Vertical |  | Generic connector, single row, 01x02, script generated | 63
J6 | 1 | 3.3V_I2C |  |  |  |  | ${EXCLUDE_FROM_POS_FILES} | Connector_PinHeader_2.54mm:PinHeader_1x02_P2.54mm_Vertical |  | Generic connector, single row, 01x02, script generated | 64
J7,J14,J15,J16 | 4 | Conn_01x10 |  |  |  |  | ${EXCLUDE_FROM_POS_FILES} | Connector_PinHeader_2.54mm:PinHeader_1x10_P2.54mm_Vertical |  | Generic connector, single row, 01x10, script generated (kicad-library-utils/schlib/autogen/connector/) | 65
J8 | 1 | Conn_01x09_Pin |  |  |  |  | ${EXCLUDE_FROM_POS_FILES} | Connector_PinHeader_2.54mm:PinHeader_1x09_P2.54mm_Vertical |  | Generic connector, single row, 01x09, script generated | 66
J9 | 1 | Conn_Coaxial |  |  |  |  | ${EXCLUDE_FROM_POS_FILES} | Connector_Coaxial:SMA_Amphenol_132289_EdgeMount |  | coaxial connector (BNC, SMA, SMB, SMC, Cinch/RCA, LEMO, ...) | 67
J10 | 1 | Conn_02x07_Odd_Even |  |  |  |  | ${EXCLUDE_FROM_POS_FILES} | Connector_PinHeader_2.54mm:PinHeader_2x07_P2.54mm_Vertical |  | Generic connector, double row, 02x07, odd/even pin numbering scheme (row 1 odd numbers, row 2 even numbers), script generated (kicad-library-utils/schlib/autogen/connector/) | 68
J11 | 1 | Conn_01x04_Pin |  |  |  |  | ${EXCLUDE_FROM_POS_FILES} | Connector_PinHeader_2.54mm:PinHeader_1x04_P2.54mm_Vertical |  | Generic connector, single row, 01x04, script generated | 69
J12 | 1 | SFP+ |  |  |  |  | ${EXCLUDE_FROM_POS_FILES} | Connector:Connector_SFP_and_Cage | https://members.snia.org/document/dl/25892 | Connector for Small Form Factor Pluggable (SFP+) module, 10 Gbit/s, serial-to-serial data-agnostic optical transceiver | 70
J13 | 1 | Conn_01x22 |  |  |  |  | ${EXCLUDE_FROM_POS_FILES} | Connector_FFC-FPC:Hirose_FH12-22S-0.5SH_1x22-1MP_P0.50mm_Horizontal |  | Generic connector, single row, 01x22, script generated (kicad-library-utils/schlib/autogen/connector/) | 71
L1,L2 | 2 | 2.2uH,5A |  |  |  |  | ${EXCLUDE_FROM_POS_FILES} | Inductor_SMD:L_Bourns_SRP1245A |  | Inductor | 72
L3 | 1 | 1/2.2uH |  |  |  |  | ${EXCLUDE_FROM_POS_FILES} | Inductor_SMD:L_Bourns_SRP1245A |  | Inductor | 73
L4 | 1 | 0.47uH 15A |  |  |  |  | ${EXCLUDE_FROM_POS_FILES} | Inductor_SMD:L_Bourns_SRP1245A |  | Inductor | 74
L5 | 1 | 10uH 12A |  |  |  |  | ${EXCLUDE_FROM_POS_FILES} | Inductor_SMD:L_Bourns_SRP1245A |  | Inductor | 75
L6,L7 | 2 | 2.2uH |  |  |  |  | ${EXCLUDE_FROM_POS_FILES} | Inductor_SMD:L_Bourns_SRP1245A |  | Inductor | 76
L8,L9,L10 | 3 | 1uH |  |  |  |  | ${EXCLUDE_FROM_POS_FILES} | Inductor_SMD:L_Bourns_SRP1245A |  | Inductor | 77
L11 | 1 | DLW21HN900SQ2L-CUTTAPE |  |  |  |  | ${EXCLUDE_FROM_POS_FILES} | Devboard_Footprints:FILTER-SMD_4P-L2.0-W1.3-BL_DLW21 | https://lcsc.com/product-detail/Common-Mode-Chokes-Filters_Murata-Electronics_DLW21HN900SQ2L-CUTTAPE_Murata-Electronics-DLW21HN900SQ2L-CUTTAPE_C80529.html |  | 78 | C80529
L12,L13,L14 | 3 | 220 nH |  |  |  |  | ${EXCLUDE_FROM_POS_FILES} | Inductor_SMD:L_0603_1608Metric |  | Inductor | 79
Q1,Q2 | 2 | IPB180P04P4L-02 |  |  |  |  | ${EXCLUDE_FROM_POS_FILES} | Package_TO_SOT_SMD:TO-263-7_TabPin8 | https://www.lcsc.com/datasheet/C21547650.pdf |  | 80 | C21547650
R1,R3,R135,R138,R163,R164 | 6 | 5.1kΩ |  |  |  |  | ${EXCLUDE_FROM_POS_FILES} | Resistor_SMD:R_0402_1005Metric |  | Resistor | 81
R2,R13,R41,R49,R50,R52,R54,R56,R59,R153,R155,R165,R166 | 13 | 100kΩ |  |  |  |  | ${EXCLUDE_FROM_POS_FILES} | Resistor_SMD:R_0402_1005Metric |  | Resistor | 82
R4,R7,R20,R21,R22,R23,R24,R29,R75 | 9 | 10k |  |  |  |  | ${EXCLUDE_FROM_POS_FILES} | Resistor_SMD:R_0402_1005Metric |  | Resistor | 83
R5 | 1 | 100Ω |  |  |  |  | ${EXCLUDE_FROM_POS_FILES} | Resistor_SMD:R_0402_1005Metric |  | Resistor | 84
R6,R8,R177,R178,R181 | 5 | 4.7kΩ |  |  |  |  | ${EXCLUDE_FROM_POS_FILES} | Resistor_SMD:R_0402_1005Metric |  | Resistor | 85
R9,R25 | 2 | 124k |  |  |  |  | ${EXCLUDE_FROM_POS_FILES} | Resistor_SMD:R_0402_1005Metric |  | Resistor | 86
R10,R27,R34,R35,R36,R43,R44,R46,R47,R51,R53,R57,R61,R62,R66,R68,R79,R80,R83,R84,R96,R97,R98,R111,R113,R114,R115,R116,R117,R118,R119,R120,R121,R123,R130,R131,R141,R143,R151,R158,R162,R170,R172,R173,R174,R179,R180,R188,R189,R190,R194,R198,R207,R212 | 54 | 10kΩ |  |  |  |  | ${EXCLUDE_FROM_POS_FILES} | Resistor_SMD:R_0402_1005Metric |  | Resistor | 87
R11,R12,R60,R65,R70,R73,R74,R76,R78,R90,R101 | 11 | 100k |  |  |  |  | ${EXCLUDE_FROM_POS_FILES} | Resistor_SMD:R_0402_1005Metric |  | Resistor | 88
R14 | 1 | 549Ω |  |  |  |  | ${EXCLUDE_FROM_POS_FILES} | Resistor_SMD:R_0402_1005Metric |  | Resistor | 89
R15,R26 | 2 | 750Ω |  |  |  |  | ${EXCLUDE_FROM_POS_FILES} | Resistor_SMD:R_0402_1005Metric |  | Resistor | 90
R16,R17 | 2 | 470R |  |  |  |  | ${EXCLUDE_FROM_POS_FILES} | Resistor_SMD:R_0402_1005Metric |  | Resistor | 91
R18 | 1 | 29.8k |  |  |  |  | ${EXCLUDE_FROM_POS_FILES} | Resistor_SMD:R_0402_1005Metric |  | Resistor | 92
R19,R92 | 2 | 120k |  |  |  |  | ${EXCLUDE_FROM_POS_FILES} | Resistor_SMD:R_0402_1005Metric |  | Resistor | 93
R28 | 1 | 5.9kΩ |  |  |  |  | ${EXCLUDE_FROM_POS_FILES} | Resistor_SMD:R_0402_1005Metric |  | Resistor | 94
R30 | 1 | 442k |  |  |  |  | ${EXCLUDE_FROM_POS_FILES} | Resistor_SMD:R_0402_1005Metric |  | Resistor | 95
R31 | 1 | 210k |  |  |  |  | ${EXCLUDE_FROM_POS_FILES} | Resistor_SMD:R_0402_1005Metric |  | Resistor | 96
R32 | 1 | 20.5k |  |  |  |  | ${EXCLUDE_FROM_POS_FILES} | Resistor_SMD:R_0402_1005Metric |  | Resistor | 97
R33 | 1 | 10mΩ |  |  |  |  | ${EXCLUDE_FROM_POS_FILES} | Resistor_SMD:R_Shunt_Isabellenhuette_BVR4026 |  | Shunt resistor with Kelvin connections | 98
R37,R48,R104,R105,R140,R145 | 6 | 1kΩ |  |  |  |  | ${EXCLUDE_FROM_POS_FILES} | Resistor_SMD:R_0402_1005Metric |  | Resistor | 99
R38 | 1 | 1k |  |  |  |  | ${EXCLUDE_FROM_POS_FILES} | Resistor_SMD:R_0402_1005Metric |  | Resistor | 100
R39 | 1 | 100 |  |  |  |  | ${EXCLUDE_FROM_POS_FILES} | Resistor_SMD:R_0402_1005Metric |  | Resistor | 101
R40 | 1 | 180Ω |  |  |  |  | ${EXCLUDE_FROM_POS_FILES} | Resistor_SMD:R_0402_1005Metric |  | Resistor | 102
R42 | 1 | 30.1kΩ |  |  |  |  | ${EXCLUDE_FROM_POS_FILES} | Resistor_SMD:R_0402_1005Metric |  | Resistor | 103
R45 | 1 | 5.23kΩ |  |  |  |  | ${EXCLUDE_FROM_POS_FILES} | Resistor_SMD:R_0402_1005Metric |  | Resistor | 104
R55 | 1 | 31.6K |  |  |  |  | ${EXCLUDE_FROM_POS_FILES} | Resistor_SMD:R_0402_1005Metric |  | Resistor | 105
R58 | 1 | 60.4k |  |  |  |  | ${EXCLUDE_FROM_POS_FILES} | Resistor_SMD:R_0402_1005Metric |  | Resistor | 106
R63 | 1 | 49.9k |  |  |  |  | ${EXCLUDE_FROM_POS_FILES} | Resistor_SMD:R_0402_1005Metric |  | Resistor | 107
R64 | 1 | 24.3kΩ |  |  |  |  | ${EXCLUDE_FROM_POS_FILES} | Resistor_SMD:R_0402_1005Metric |  | Resistor | 108
R67,R183,R187 | 3 | 10Ω |  |  |  |  | ${EXCLUDE_FROM_POS_FILES} | Resistor_SMD:R_0402_1005Metric |  | Resistor | 109
R69 | 1 | 73.2kΩ |  |  |  |  | ${EXCLUDE_FROM_POS_FILES} | Resistor_SMD:R_0402_1005Metric |  | Resistor | 110
R71 | 1 | 249kΩ |  |  |  |  | ${EXCLUDE_FROM_POS_FILES} | Resistor_SMD:R_0402_1005Metric |  | Resistor | 111
R72 | 1 | 309k |  |  |  |  | ${EXCLUDE_FROM_POS_FILES} | Resistor_SMD:R_0402_1005Metric |  | Resistor | 112
R77 | 1 | 200k |  |  |  |  | ${EXCLUDE_FROM_POS_FILES} | Resistor_SMD:R_0402_1005Metric |  | Resistor | 113
R81,R82 | 2 | 49.9kΩ |  |  |  |  | ${EXCLUDE_FROM_POS_FILES} | Resistor_SMD:R_0402_1005Metric |  | Resistor | 114
R85,R87,R99 | 3 | 20k |  |  |  |  | ${EXCLUDE_FROM_POS_FILES} | Resistor_SMD:R_0402_1005Metric |  | Resistor | 115
R86,R89,R100 | 3 | 50K |  |  |  |  | ${EXCLUDE_FROM_POS_FILES} | Resistor_SMD:R_0402_1005Metric |  | Resistor | 116
R88 | 1 | 182kΩ |  |  |  |  | ${EXCLUDE_FROM_POS_FILES} | Resistor_SMD:R_0402_1005Metric |  | Resistor | 117
R91,R93,R102 | 3 | 249k |  |  |  |  | ${EXCLUDE_FROM_POS_FILES} | Resistor_SMD:R_0402_1005Metric |  | Resistor | 118
R94 | 1 | 3.24kΩ |  |  |  |  | ${EXCLUDE_FROM_POS_FILES} | Resistor_SMD:R_0402_1005Metric |  | Resistor | 119
R95 | 1 | 14.7kΩ |  |  |  |  | ${EXCLUDE_FROM_POS_FILES} | Resistor_SMD:R_0402_1005Metric |  | Resistor | 120
R103 | 1 | 220Ω |  |  |  |  | ${EXCLUDE_FROM_POS_FILES} | Resistor_SMD:R_0402_1005Metric |  | Resistor | 121
R106,R107,R108,R109 | 4 | 240Ω |  |  |  |  | ${EXCLUDE_FROM_POS_FILES} | Resistor_SMD:R_0402_1005Metric |  | Resistor | 122
R110,R112,R122,R125,R126,R127,R128,R133,R134,R136,R139 | 11 | 22Ω |  |  |  |  | ${EXCLUDE_FROM_POS_FILES} | Resistor_SMD:R_0402_1005Metric |  | Resistor | 123
R124 | 1 | 11kΩ |  |  |  |  | ${EXCLUDE_FROM_POS_FILES} | Resistor_SMD:R_0402_1005Metric |  | Resistor | 124
R129,R132 | 2 | 470Ω |  |  |  |  | ${EXCLUDE_FROM_POS_FILES} | Resistor_SMD:R_0402_1005Metric |  | Resistor | 125
R137 | 1 | 8.06kΩ |  |  |  |  | ${EXCLUDE_FROM_POS_FILES} | Resistor_SMD:R_0402_1005Metric |  | Resistor | 126
R142,R144 | 2 | 2.49kΩ |  |  |  |  | ${EXCLUDE_FROM_POS_FILES} | Resistor_SMD:R_0402_1005Metric |  | Resistor | 127
R146 | 1 | 47.5kΩ |  |  |  |  | ${EXCLUDE_FROM_POS_FILES} | Resistor_SMD:R_0402_1005Metric |  | Resistor | 128
R147 | 1 | 22.1kΩ |  |  |  |  | ${EXCLUDE_FROM_POS_FILES} | Resistor_SMD:R_0402_1005Metric |  | Resistor | 129
R148,R167,R176,R209,R210 | 5 | 1MΩ |  |  |  |  | ${EXCLUDE_FROM_POS_FILES} | Resistor_SMD:R_0402_1005Metric |  | Resistor | 130
R149,R150,R152,R156,R157,R159,R160,R199,R200 | 9 | 2.2kΩ |  |  |  |  | ${EXCLUDE_FROM_POS_FILES} | Resistor_SMD:R_0402_1005Metric |  | Resistor | 131
R154 | 1 | 200kΩ |  |  |  |  | ${EXCLUDE_FROM_POS_FILES} | Resistor_SMD:R_0402_1005Metric |  | Resistor | 132
R161 | 1 | 12kΩ |  |  |  |  | ${EXCLUDE_FROM_POS_FILES} | Resistor_SMD:R_0402_1005Metric |  | Resistor | 133
R168,R175,R186,R192,R193,R195 | 6 | 50Ω |  |  |  |  | ${EXCLUDE_FROM_POS_FILES} | Resistor_SMD:R_0402_1005Metric |  | Resistor | 134
R169,R171 | 2 | 33Ω |  |  |  |  | ${EXCLUDE_FROM_POS_FILES} | Resistor_SMD:R_0402_1005Metric |  | Resistor | 135
R182,R184,R185 | 3 | 27Ω |  |  |  |  | ${EXCLUDE_FROM_POS_FILES} | Resistor_SMD:R_0402_1005Metric |  | Resistor | 136
R191 | 1 | 1.92kΩ |  |  |  |  | ${EXCLUDE_FROM_POS_FILES} | Resistor_SMD:R_0402_1005Metric |  | Resistor | 137
R196,R197,R201,R202,R203,R204,R205,R206 | 8 | 5kΩ |  |  |  |  | ${EXCLUDE_FROM_POS_FILES} | Resistor_SMD:R_0402_1005Metric |  | Resistor | 138
R208 | 1 | 4.02MΩ |  |  |  |  | ${EXCLUDE_FROM_POS_FILES} | Resistor_SMD:R_0402_1005Metric |  | Resistor | 139
R211 | 1 | 3MΩ |  |  |  |  | ${EXCLUDE_FROM_POS_FILES} | Resistor_SMD:R_0402_1005Metric |  | Resistor | 140
RT1 | 1 | 10k NTC |  |  |  |  | ${EXCLUDE_FROM_POS_FILES} | Resistor_SMD:R_0603_1608Metric |  | Temperature dependent resistor, negative temperature coefficient | 141
R_shield1 | 1 | 1 M |  |  |  |  | ${EXCLUDE_FROM_POS_FILES} | Resistor_SMD:R_0402_1005Metric |  | Resistor | 142
SW1 | 1 | SW_Push |  |  |  |  | ${EXCLUDE_FROM_POS_FILES} | Button_Switch_SMD:SW_SPST_Omron_B3FS-100xP |  | Push button switch, generic, two pins | 143
SW2 | 1 | SW_SPDT |  |  |  |  | ${EXCLUDE_FROM_POS_FILES} | Devboard_Footprints:LFCSP-16-1EP_3x3mm_P0.5mm_EP1.6x1.6mm |  | Switch, single pole double throw | 144
TP1,TP2 | 2 | TestPoint |  |  |  |  | ${EXCLUDE_FROM_POS_FILES} | TestPoint:TestPoint_Pad_D1.0mm |  | test point | 145
U1 | 1 | TPD6S300ARUKR |  |  |  |  | ${EXCLUDE_FROM_POS_FILES} | Devboard_Footprints:WQFN-20_L3.0-W3.0-P0.40-TL-EP1.7 | https://www.lcsc.com/datasheet/C2876380.pdf |  | 146 | C2876380
U2 | 1 | STUSB4500QTR |  |  |  |  | ${EXCLUDE_FROM_POS_FILES} | Package_DFN_QFN:QFN-24-1EP_4x4mm_P0.5mm_EP2.7x2.7mm | https://www.st.com/resource/en/datasheet/stusb4500.pdf | Stand-alone USB PD controller (with sink Auto-run mode), QFN-24 | 147
U3 | 1 | TVS2201DRBR |  |  |  |  | ${EXCLUDE_FROM_POS_FILES} | Devboard_Footprints:VSON-8_L3.0-W3.0-P0.65-BL-EP | https://www.lcsc.com/datasheet/C1849889.pdf |  | 148 | C1849889
U4,U6 | 2 | TPS259470ARPWR |  |  |  |  | ${EXCLUDE_FROM_POS_FILES} | Devboard_Footprints:VQFN-10_L2.0-W2.0-P0.45-TL | https://www.lcsc.com/datasheet/C3662799.pdf |  | 149 | C3662799
U5 | 1 | TPS2121RUXR |  |  |  |  | ${EXCLUDE_FROM_POS_FILES} | Devboard_Footprints:VQFN-HR-12_L2.5-W2.0-P0.50-BL | https://lcsc.com/product-detail/New-Arrivals_Texas-Instruments-Texas-Instruments-TPS2121RUXR_C485916.html |  | 150 | C485916
U7 | 1 | XT60 |  |  |  |  | ${EXCLUDE_FROM_POS_FILES} | Custom_Footprints:CONN-TH_XT60 | https://www.lcsc.com/datasheet/C98733.pdf |  | 151 | C98733
U8 | 1 | DW06 |  |  |  |  | ${EXCLUDE_FROM_POS_FILES} | Devboard_Footprints:SOT-23-6_L2.9-W1.6-P0.95-LS2.8-BL | https://lcsc.com/product-detail/PMIC-Battery-Management_JSMSEMI-DW06_C917080.html |  | 152 | C917080
U9 | 1 | BQ25895RTWR |  |  |  |  | ${EXCLUDE_FROM_POS_FILES} | Devboard_Footprints:QFN-24_L4.0-W4.0-P0.50-TL-EP2.7 | https://lcsc.com/product-detail/PMIC-Battery-Management_TI_BQ25895RTWR_BQ25895RTWR_C80200.html |  | 153 | C80200
U10 | 1 | BQ27441DRZR-G1A |  |  |  |  | ${EXCLUDE_FROM_POS_FILES} | Devboard_Footprints:SON-12_L4.0-W2.5-P0.40-BL-EP | https://lcsc.com/product-detail/PMIC-Battery-Management_Texas-Instruments-Texas-Instruments-BQ27441DRZR-G1A_C473397.html |  | 154 | C473397
U11 | 1 | LM66100DCK |  |  |  |  | ${EXCLUDE_FROM_POS_FILES} | Package_TO_SOT_SMD:SOT-363_SC-70-6 | https://www.ti.com/lit/ds/symlink/lm66100.pdf | Ideal Diode With Input Polarity Protection 1.5 - 5.5V Input Voltage, 1.5A Output Current, Ron 141 mOhm, SC-70-6 | 155
U12 | 1 | TPS61088RHLR |  |  |  |  | ${EXCLUDE_FROM_POS_FILES} | Devboard_Footprints:VQFN-20_L4.6-W3.6-P0.50-BL | https://lcsc.com/product-detail/DC-DC-Converters_TI_TPS61088RHLR_TPS61088RHLR_C87357.html |  | 156 | C87357
U13 | 1 | TPS548A20RVER |  |  |  |  | ${EXCLUDE_FROM_POS_FILES} | Devboard_Footprints:VQFN-CLIP-28_L4.5-W3.5-P0.40-BL-EP | https://lcsc.com/product-detail/DC-DC-Converters_Texas-Instruments-Texas-Instruments-TPS548A20RVER_C468255.html |  | 157 | C468255
U14 | 1 | TPS62130RGTR |  |  |  |  | ${EXCLUDE_FROM_POS_FILES} | Devboard_Footprints:QFN-16_L3.0-W3.0-P0.50-TL-EP1.7 | https://lcsc.com/product-detail/DC-DC-Converters_TI_TPS62130RGTR_TPS62130RGTR_C43590.html | Buck Step Down Regulator with 3 to 17 V Input and 0.9 to 6 V Output, -40 to 85 degC, 16-Pin QFN (RGT), Green (RoHS no SbBr) | 158 | C43590
U15,U20,U21,U25 | 4 | TPS54824RNVR |  |  |  |  | ${EXCLUDE_FROM_POS_FILES} | Custom_Footprints:VQFN-18_L3.5-W3.5-P0.50-BL_TPS54824RNVR | https://www.lcsc.com/datasheet/C2070614.pdf |  | 159 | C2070614
U16 | 1 | TPS62823DLCR |  |  |  |  | ${EXCLUDE_FROM_POS_FILES} | Devboard_Footprints:VSON-8_L2.0-W1.5-P0.50-BL | https://www.lcsc.com/datasheet/C2693497.pdf |  | 160 | C2693497
U17 | 1 | TPS62822DLCR |  |  |  |  | ${EXCLUDE_FROM_POS_FILES} | Devboard_Footprints:VSON-8_L2.0-W1.5-P0.50-BL | https://lcsc.com/product-detail/DC-DC-Converters_Texas-Instruments-Texas-Instruments-TPS62822DLCR_C473385.html |  | 161 | C473385
U18,U22,U23,U26 | 4 | TPS7A4700RGWR |  |  |  |  | ${EXCLUDE_FROM_POS_FILES} | Devboard_Footprints:VQFN-20_L5.0-W5.0-P0.65-TL-EP | https://lcsc.com/product-detail/PMIC-AC-DC-Converters_TI_TPS7A4700RGWR_TPS7A4700RGWR_C114839.html |  | 162 | C114839
U19 | 1 | TPS3700DSET |  |  |  |  | ${EXCLUDE_FROM_POS_FILES} | Devboard_Footprints:WSON-6_L1.5-W1.5-P0.50-TL | https://www.lcsc.com/datasheet/C2869244.pdf |  | 163 | C2869244
U24 | 1 | RS3112-1.25XSF3 |  |  |  |  | ${EXCLUDE_FROM_POS_FILES} | Devboard_Footprints:SOT-23-3_L2.9-W1.3-P0.95-LS2.4-BR | https://www.lcsc.com/datasheet/C19269195.pdf |  | 164 | C19269195
U27 | 1 | xczu4evfbvb900pkg |  |  |  |  | ${EXCLUDE_FROM_POS_FILES} | Devboard_Footprints:XCZU4EVFBVB900PKG | kicad-embed://XCZU4EVFBVB900PKG.pdf | 900 PIN AMD Board Zynq Ultrascale+ Architecture. | 165
U28 | 1 | TXS02612RTWR |  |  |  |  | ${EXCLUDE_FROM_POS_FILES} | Devboard_Footprints:WQFN-24_L4.0-W4.0-P0.50-TL-EP2.5 | https://lcsc.com/product-detail/Interface-ICs_TI_TXS02612RTWR_TXS02612RTWR_C140276.html |  | 166 | C140276
U29 | 1 | MT25QU256ABA8ESF-0SIT TR |  |  |  |  | ${EXCLUDE_FROM_POS_FILES} | Devboard_Footprints:SOP-16_L10.3-W7.5-P1.27-LS10.4-BL | https://www.lcsc.com/datasheet/C2061781.pdf |  | 167 | C2061781
U30 | 1 | FEMDNN032G-A3A55 |  |  |  |  | ${EXCLUDE_FROM_POS_FILES} | Devboard_Footprints:FBGA-153_L13.0-W11.5-P0.50_KLMAG1JETD-B041 | https://www.lcsc.com/datasheet/C5117593.pdf |  | 168 | C5117593
U31 | 1 | DP83867IRRGZR |  |  |  |  | ${EXCLUDE_FROM_POS_FILES} | Devboard_Footprints:VQFN-48_L7.0-W7.0-P0.50-TL-EP4.1 | https://www.lcsc.com/datasheet/C2678038.pdf |  | 169 | C2678038
U32 | 1 | CP2102N-A02-GQFN24 |  |  |  |  | ${EXCLUDE_FROM_POS_FILES} | Package_DFN_QFN:QFN-24-1EP_4x4mm_P0.5mm_EP2.6x2.6mm | https://www.silabs.com/documents/public/data-sheets/cp2102n-datasheet.pdf | USB to UART master bridge, QFN-24 | 170
U33 | 1 | USB3320C-EZK-TR |  |  |  |  | ${EXCLUDE_FROM_POS_FILES} | Devboard_Footprints:QFN-32_L5.0-W5.0-P0.50-BL-EP3.4 | https://lcsc.com/product-detail/USB_MICROCHIP_USB3320C-EZK-TR_USB3320C-EZK-TR_C132156.html |  | 171 | C132156
U34,U39 | 2 | TPD4E05U06DQA |  |  |  |  | ${EXCLUDE_FROM_POS_FILES} | Package_SON:USON-10_2.5x1.0mm_P0.5mm | https://www.ti.com/lit/ds/symlink/tpd4e05u06.pdf | 4-Channel ESD Protection for Super-Speed USB 3.0 Interface, USON-10 | 172
U35,U53 | 2 | TCA9548APWR |  |  |  |  | ${EXCLUDE_FROM_POS_FILES} | Package_SO:TSSOP-24_4.4x7.8mm_P0.65mm | http://www.ti.com/lit/ds/symlink/tca9548a.pdf | Low voltage 8-channel I2C switch with reset, TSSOP-24 | 173
U36 | 1 | TXB0108PW |  |  |  |  | ${EXCLUDE_FROM_POS_FILES} | Package_SO:TSSOP-20_4.4x6.5mm_P0.65mm | http://www.ti.com/lit/ds/symlink/txb0108.pdf | 8-Bit Bidirectional Voltage-Level Translator, Auto Direction Sensing and ±15-kV ESD Protection, 1.2 - 3.6V APort, 1.65 - 5.5V BPort, TSSOP-20 | 174
U37 | 1 | PCA9306 |  |  |  |  | ${EXCLUDE_FROM_POS_FILES} | Package_SO:VSSOP-8_2.3x2mm_P0.5mm | http://www.ti.com/lit/ds/symlink/pca9306.pdf | Dual bidirectional I2C Bus and SMBus voltage level translator | 175
U38 | 1 | USB2514B_Bi |  |  |  |  | ${EXCLUDE_FROM_POS_FILES} | Package_DFN_QFN:QFN-36-1EP_6x6mm_P0.5mm_EP3.7x3.7mm | http://ww1.microchip.com/downloads/en/DeviceDoc/00001692C.pdf | USB 2.0 Hi-Speed Hub Controller | 176
U40 | 1 | TXS0102DQE |  |  |  |  | ${EXCLUDE_FROM_POS_FILES} | Package_SON:X2SON-8_1.4x1mm_P0.35mm | http://www.ti.com/lit/gpn/txs0102 | 2-Bit Bidirectional Voltage-Level Shifter for Open-Drain and Push-Pull Application, X2SON-8 | 177
U41 | 1 | SI5341A-D12636-GM |  |  |  |  | ${EXCLUDE_FROM_POS_FILES} | Devboard_Footprints:QFN-64_L9.0-W9.0-P0.50-TL-EP5.2 | https://www.lcsc.com/datasheet/C3609093.pdf |  | 178 | C3609093
U42 | 1 | REF5025AD |  |  |  |  | ${EXCLUDE_FROM_POS_FILES} | Package_SO:SOIC-8_3.9x4.9mm_P1.27mm | https://www.ti.com/lit/ds/symlink/ref5030a-q1.pdf | 2.5V 0.1% 10mA Low Noise Precision Voltage Reference, SO-8 | 179
U43 | 1 | LMX2594RHAR |  |  |  |  | ${EXCLUDE_FROM_POS_FILES} | Devboard_Footprints:QFN-40_L6.0-W6.0-P0.50-BL-EP4.5 | https://www.lcsc.com/datasheet/C2862572.pdf |  | 180 | C2862572
U44 | 1 | ADS131M08IPBS |  |  |  |  | ${EXCLUDE_FROM_POS_FILES} | Devboard_Footprints:TQFP-32_L5.0-W5.0-P0.50-LS7.0-TL | https://www.lcsc.com/datasheet/C2685451.pdf |  | 181 | C2685451
U45 | 1 | ADS4245IRGCT |  |  |  |  | ${EXCLUDE_FROM_POS_FILES} | Devboard_Footprints:VQFN-64_L9.0-W9.0-P0.50-TL-EP7.4 | https://www.lcsc.com/datasheet/C2670075.pdf |  | 182 | C2670075
U46 | 1 | AD9744ARUZRL7 |  |  |  |  | ${EXCLUDE_FROM_POS_FILES} | Devboard_Footprints:TSSOP-28_L9.7-W4.4-P0.65-LS6.4-BL | https://lcsc.com/product-detail/Digital-To-Analog-Converters-DACs_Analog-Devices-ADI-AD9744ARUZRL7_C461519.html |  | 183 | C461519
U47 | 1 | THS4509RGTT |  |  |  |  | ${EXCLUDE_FROM_POS_FILES} | Devboard_Footprints:VQFN-16_L3.0-W3.0-P0.50-TL-EP1.5 | https://www.lcsc.com/datasheet/C2057531.pdf |  | 184 | C2057531
U48 | 1 | ADL8100ACPZN |  |  |  |  | ${EXCLUDE_FROM_POS_FILES} | Devboard_Footprints:CP-8-30_ADI | ADL8100ACPZN |  | 185
U49 | 1 | BPF-A355 |  |  |  |  | ${EXCLUDE_FROM_POS_FILES} | RF_Mini-Circuits:Mini-Circuits_HQ1157 | https://www.minicircuits.com/pdfs/BPF-A355+.pdf | Bandpass Filter, 310 to 400 MHz, 50 Ohm, Mini-Circuits HQ1157 | 186
U50 | 1 | TMP117DRVR |  |  |  |  | ${EXCLUDE_FROM_POS_FILES} | Package_SON:WSON-6-1EP_2x2mm_P0.65mm_EP1x1.6mm | https://www.ti.com/lit/ds/symlink/tmp116.pdf | Digital Temperature Sensor with I2C/SMBus Interface, 16 bits, ±0.3°C, one-shot conversion, alert, nist traceable, EEPROM, WSON | 187
U51 | 1 | ICM-42688-P |  |  |  |  | ${EXCLUDE_FROM_POS_FILES} | Custom_Footprints:LGA14_2P5X3X0P91_TDK-L | ICM-42688-P |  | 188
U52 | 1 | MMC5983MA |  |  |  |  | ${EXCLUDE_FROM_POS_FILES} | Devboard_Footprints:LGA-16_L3.0-W3.0-P0.50-BL_SQ | https://lcsc.com/product-detail/Magnetic-Sensors_MEMSIC-MMC5983MA_C404329.html |  | 189 | C404329
U54 | 1 | BMP581 |  |  |  |  | ${EXCLUDE_FROM_POS_FILES} | Devboard_Footprints:LGA-10_L2.0-W2.0-P0.50-TL_BMP581 | https://www.lcsc.com/datasheet/C5362283.pdf |  | 190 | C5362283
U55 | 1 | MAX-M10S-00B |  |  |  |  | ${EXCLUDE_FROM_POS_FILES} | Devboard_Footprints:SMD-18_L10.1-W9.7-P1.10-TL_SKG09F | https://www.lcsc.com/datasheet/C4153167.pdf |  | 191 | C4153167
U56 | 1 | ATECC608B-MAHDA |  |  |  |  | ${EXCLUDE_FROM_POS_FILES} | Package_DFN_QFN:DFN-8-1EP_3x2mm_P0.5mm_EP1.3x1.5mm | https://ww1.microchip.com/downloads/aemDocuments/documents/SCBU/ProductDocuments/DataSheets/ATECC608B-CryptoAuthentication-Device-Summary-Data-Sheet-DS4000223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 | Cryptographic Co-Processor with Secure Hardware-based 16 Key Storage, ECDSA and ECDH support, I2C, UDFN-8 | 192
U57 | 1 | OPTIGA TPM SLB 9673 FW26 |  |  |  |  | ${EXCLUDE_FROM_POS_FILES} | Devboard_Footprints:QFN50P500X500X60-33N-V2 |  |  | 193
U58 | 1 | BQ25570 |  |  |  |  | ${EXCLUDE_FROM_POS_FILES} | Package_DFN_QFN:QFN-20-1EP_3.5x3.5mm_P0.5mm_EP2x2mm | http://www.ti.com/lit/ds/symlink/bq25570.pdf | Nano Power Boost Charger and Buck Converter for Energy Harvester Powered Applications, QFN-20 | 194
U59 | 1 | STM32G0B1RBT6 |  |  |  |  | ${EXCLUDE_FROM_POS_FILES} | Package_QFP:LQFP-64_10x10mm_P0.5mm | https://www.st.com/resource/en/datasheet/stm32g0b1rb.pdf | STMicroelectronics Arm Cortex-M0+ MCU, 128KB flash, 144KB RAM, 64 MHz, 1.7-3.6V, 60 GPIO, LQFP64 | 195
USB1,USB2,USB3 | 3 | TYPE-C-24P-SMD |  |  |  |  | ${EXCLUDE_FROM_POS_FILES} | Devboard_Footprints:USB-C-SMD_TYPE-C-24P-SMD | https://www.lcsc.com/datasheet/C53207146.pdf |  | 196 | C53207146
USB4 | 1 | 472720001 |  |  |  |  | ${EXCLUDE_FROM_POS_FILES} | Devboard_Footprints:CONN-SMD_472720001 | https://lcsc.com/product-detail/Pre-ordered-Products_MOLEX_472720001_MOLEX-472720001_C587824.html |  | 197 | C587824
U_RAM1,U_RAM2,U_RAM3,U_RAM4 | 4 | MT40A512M16LY-075:E |  |  |  |  | ${EXCLUDE_FROM_POS_FILES} | Devboard_Footprints:FBGA-96_L13.5-W7.5-R16-C6-P0.80-TL | https://lcsc.com/product-detail/Pre-ordered-Products_Micron-Tech_MT40A512M16LY-075-E_Micron-Tech-MT40A512M16LY-075-E_C598779.html |  | 198 | C598779
Y1,Y2,Y7 | 3 | 25 MHz |  |  |  |  | ${EXCLUDE_FROM_POS_FILES} | Crystal:Crystal_SMD_3225-4Pin_3.2x2.5mm |  | Four pin crystal, GND on pins 2 and 4 | 199
Y3 | 1 | 26 MHz |  |  |  |  | ${EXCLUDE_FROM_POS_FILES} | Crystal:Crystal_SMD_3225-4Pin_3.2x2.5mm |  | Four pin crystal, GND on pins 2 and 4 | 200
Y4 | 1 | SiT9365AI-4B2-33E100.0000000 |  |  |  |  | ${EXCLUDE_FROM_POS_FILES} | Oscillator:Oscillator_SMD_SiTime_PQFD-6L_3.2x2.5mm | https://www.sitime.com/datasheet/SiT9365 | SiTime Standard Frequency Ultra-low Jitter Differential Oscillator, 25-325MHz, PQFD-6, 3.2x2.5mm (with enable pin) | 201
Y5 | 1 | ECS_480-8-37-A-D-P-TR |  |  |  |  | ${EXCLUDE_FROM_POS_FILES} | Crystal:Crystal_SMD_3225-4Pin_3.2x2.5mm |  | Four pin crystal, GND on pins 2 and 4 | 202
Y6 | 1 | SiT5356AI-FP-25VT-16.367667 |  |  |  |  | ${EXCLUDE_FROM_POS_FILES} | Devboard_Footprints:Ceramic_QFN_5032_10pins | https://www.sitime.com/support/resource-library/datasheets/sit5356-datasheet | Stratum 3 Elite Platform +/-100 ppb precision MEMS Super-TCXO | 203
