damnitzhemanth-oss/FusionBoard/Guides/RepoNav.md

``` Repo nav (generated using my plugin)
FusionBoard
├── CAD
│   └── Devboard-gencad.cad
├── Guides
│   ├── DetailsForNerds.md
│   ├── GuideForReviewers.md
│   ├── RepoNav.md
│   └── journal.md
├── Images
│   ├── Additional
│   │   ├── DRC.png
│   │   └── DaVinciWho.png
│   ├── PCB
│   │   ├── 3D_HERO.png
│   │   ├── F.cu.png
│   │   ├── In1.cu.png
│   │   ├── In2.cu.png
│   │   ├── In3.cu.png
│   │   ├── In4.cu.png
│   │   ├── In5.cu.png
│   │   ├── PCB.png
│   │   └── PCB_NZ.png
│   └── Schematics
│       ├── 01_Power
│       │   └── Devboard-Power,Input,Protection.svg
│       ├── 02_Battery
│       │   └── Devboard-Battery.Charger,Fuel Gauge.svg
│       ├── 03_Power_Tree
│       │   └── Devboard-Power Tree.svg
│       ├── 04_Zynq
│       │   ├── Devboard-Zynq Section-DDR4 Memory.svg
│       │   ├── Devboard-Zynq Section-High Speed Peripherals.svg
│       │   ├── Devboard-Zynq Section-Peripherals.svg
│       │   ├── Devboard-Zynq Section-Zynq CORE.svg
│       │   └── Devboard-Zynq Section.svg
│       ├── 05_Clocking
│       │   └── Devboard-Clocking.svg
│       ├── 06_Video
│       │   └── Devboard-Video.svg
│       ├── 07_Analog_RF
│       │   └── Devboard-Analog_RF.svg
│       ├── 08_Sensors_GNSS
│       │   └── Devboard-Sensors and GNSS.svg
│       ├── 09_RTC_Security
│       │   └── Devboard-RTC & Security.svg
│       ├── 10_Harvester_BMC_Telemetry
│       │   └── Devboard-Harvester, BMC, Telemetry.svg
│       ├── 11_ePaper
│       │   └── Devboard-ePaper Ink Display.svg
│       ├── 12_Expansion
│       │   └── Devboard-Expansion.svg
│       └── Devboard.svg
├── License.md
├── PCB
│   ├── .history
│   │   ├── Devboard.kicad_pcb
│   │   ├── Devboard.kicad_sch
│   │   ├── README.txt
│   │   ├── schematics
│   │   │   ├── 01_Power
│   │   │   │   └── Power_Input_Protection.kicad_sch
│   │   │   ├── 02_Battery
│   │   │   │   └── Battery_Charger_FuelGauge.kicad_sch
│   │   │   ├── 03_Power_Tree
│   │   │   │   └── 03_Power_Tree.kicad_sch
│   │   │   ├── 04_Zynq
│   │   │   │   ├── 04_Zynq.kicad_sch
│   │   │   │   ├── 04a_Zynq_Core.kicad_sch
│   │   │   │   ├── 04b_Zynq_DDR4.kicad_sch
│   │   │   │   ├── 04c_Zynq_PS_Perhipherals.kicad_sch
│   │   │   │   └── 04d_Zynq_PS_HighSpeed.kicad_sch
│   │   │   ├── 05_Clocking
│   │   │   │   └── 05_Clocking.kicad_sch
│   │   │   ├── 06_Video
│   │   │   │   └── 06_Video.kicad_sch
│   │   │   ├── 07_Analog_RF
│   │   │   │   └── 07_Analog_RF.kicad_sch
│   │   │   ├── 08_Sensors_GNSS
│   │   │   │   └── 08_Sensors_GNSS.kicad_sch
│   │   │   ├── 08_Sesnsors_GNSS
│   │   │   │   └── 08_Sensors_GNSS.kicad_sch
│   │   │   ├── 09_RTC_Security
│   │   │   │   └── 09_RTC_Security.kicad_sch
│   │   │   ├── 10_Harvester_BMC_Telemetry
│   │   │   │   └── 10_Harvester_BMC_Telemetry.kicad_sch
│   │   │   ├── 11_ePaper
│   │   │   │   └── 11_ePaper.kicad_sch
│   │   │   └── 12_Expansion
│   │   │       └── 12_Expansion.kicad_sch
│   │   └── ~.repo..lck
│   ├── Devboard.kicad_pcb
│   ├── Devboard.kicad_prl
│   ├── Devboard.kicad_pro
│   ├── Devboard.kicad_sch
│   ├── Devboard.round-tracks-config
│   ├── Libraries
│   │   ├── 3DModeld.pretty
│   │   │   └── ddr4.kicad_mod
│   │   ├── 3dmodels
│   │   │   ├── CONN-SMD_472720001.step
│   │   │   ├── CONN-SMD_APCI0120-P001A.step
│   │   │   ├── CP-8-30_ADI.step
│   │   │   ├── DC-IN-TH_PJ-102AH.step
│   │   │   ├── FBGA-153_L13.0-W11.5-H1.1-P0.50_KLMAG1JETD-B041.step
│   │   │   ├── Infineon-PG-UQFN-32-1_3D_STP-Package-v01_00-EN.stp
│   │   │   ├── LGA-10_L2.0-W2.0-P0.50-TL_BMP581.step
│   │   │   ├── LGA-16_L3.0-W3.0-H0.9-P0.50.step
│   │   │   ├── MSOP-10_L3.0-W3.0-H1.1-LS5.0-P0.50.step
│   │   │   ├── PCIE-SMD_1-2199230-6.step
│   │   │   ├── QFN-16_L3.0-W3.0-P0.50-EP1.7.step
│   │   │   ├── QFN-24_L4.0-W4.0-P0.50-TL-EP2.7.step
│   │   │   ├── QFN-32_L5.0-W5.0-H0.9-P0.50.step
│   │   │   ├── QFN-40_L6.0-W6.0-H0.8-P0.50.step
│   │   │   ├── QFN-64_L9.0-W9.0-P0.50-TL-EP5.2.step
│   │   │   ├── RJ45 to SFP Adapter.stp
│   │   │   ├── RJ45-TH_HR911105A.step
│   │   │   ├── SMD-18_L10.1-W9.7-P1.10-TL_SKG09F.step
│   │   │   ├── SMD-4_L2.0-W1.2-H1.3.step
│   │   │   ├── SON-12_L4.0-W2.5-H1-P0.40-BL-EP.step
│   │   │   ├── SOP-16_L10.3-W7.5-H2.1-LS10.0-P1.27.step
│   │   │   ├── SOT-23-3P_L2.9-W1.3-H1.0-LS2.4-P0.95.step
│   │   │   ├── SOT-23-6_L2.9-W1.6-H1.5-LS2.8-P0.95.step
│   │   │   ├── SiT5356AI-FP-25VT-16.367667.stp
│   │   │   ├── TF-SMD_TF-01A.step
│   │   │   ├── TO-263-7_L10.2-W9.2-P1.27-LS15.4.step
│   │   │   ├── TQFP-32_L5.0-W5.0-H1.2-LS7.0-P0.50.step
│   │   │   ├── TSSOP-28_L9.7-W4.4-H1.0-LS6.4-P0.65.step
│   │   │   ├── USB-C-SMD_TYPE-C-24P-SMD.step
│   │   │   ├── VQFN-10_L2.0-W2.0-P0.45-TL.step
│   │   │   ├── VQFN-16_L3.0-W3.0-P0.50-TL-EP1.5.step
│   │   │   ├── VQFN-20_L4.5-W3.5-H1.0-P0.50.step
│   │   │   ├── VQFN-20_L5.0-W5.0-H1.0-P0.65.step
│   │   │   ├── VQFN-48_L7.0-W7.0-P0.50-TL-EP4.1.step
│   │   │   ├── VQFN-64_L9.0-W9.0-P0.50-TL-EP7.4.step
│   │   │   ├── VQFN-CLIP-28_L4.5-W3.5-H0.9-P0.40-BL-EP.step
│   │   │   ├── VQFN-HR-12_L2.5-W2.0-H1.0-P0.50-BL.step
│   │   │   ├── VSON-8_L2.0-W1.5-H1.0-P0.50-BL.step
│   │   │   ├── VSON-8_L3.0-W3.0-H0.9-P0.65.step
│   │   │   ├── WQFN-20_L3.0-W3.0-H0.8-P0.40-TL-EP1.7.step
│   │   │   ├── WQFN-24_L4.0-W4.0-H0.8-P0.50.step
│   │   │   ├── WSON-10_L3.0-W3.0-H1.0-P0.50.step
│   │   │   └── WSON-6_L1.5-W1.5-H0.8-P0.50-TL.step
│   │   ├── Devboard_custom.kicad_sym
│   │   │   ├── 2026-10-31_03-35-15.kicad_sym
│   │   │   ├── OPTIGA TPM SLB 9673 FW26.kicad_sym
│   │   │   ├── SiT5356AI-FP-25VT-16_367667.kicad_sym
│   │   │   ├── easyeda2kicad.kicad_sym
│   │   │   └── my_zynq.kicad_sym
│   │   ├── custom
│   │   │   ├── my_zynq.bak
│   │   │   ├── my_zynq.kicad_sym
│   │   │   └── xczu4evfbvb900pkg.csv
│   │   └── footprints.pretty
│   │       ├── CONN-SMD_472720001.kicad_mod
│   │       ├── CONN-SMD_APCI0120-P001A.kicad_mod
│   │       ├── CP-8-30_ADI-L.kicad_mod
│   │       ├── CP-8-30_ADI-M.kicad_mod
│   │       ├── CP-8-30_ADI.kicad_mod
│   │       ├── Ceramic_QFN_5032_10pins.kicad_mod
│   │       ├── DC-IN-TH_PJ-102AH.kicad_mod
│   │       ├── FBGA-153_L13.0-W11.5-P0.50_KLMAG1JETD-B041.kicad_mod
│   │       ├── FBGA-96_L13.5-W7.5-R16-C6-P0.80-TL.kicad_mod
│   │       ├── FILTER-SMD_4P-L2.0-W1.3-BL_DLW21.kicad_mod
│   │       ├── Github.kicad_mod
│   │       ├── INDUCTOR.kicad_mod
│   │       ├── LFCSP-16-1EP_3x3mm_P0.5mm_EP1.6x1.6mm.kicad_mod
│   │       ├── LGA-10_L2.0-W2.0-P0.50-TL_BMP581.kicad_mod
│   │       ├── LGA-16_L3.0-W3.0-P0.50-BL_SQ.kicad_mod
│   │       ├── MSOP-10_L3.0-W3.0-P0.50-LS5.0-BL-EP.kicad_mod
│   │       ├── PCIE-SMD_1-2199230-6.kicad_mod
│   │       ├── Pixl.kicad_mod
│   │       ├── QFN-16_L3.0-W3.0-P0.50-TL-EP1.7.kicad_mod
│   │       ├── QFN-24_L4.0-W4.0-P0.50-TL-EP2.7.kicad_mod
│   │       ├── QFN-32_L5.0-W5.0-P0.50-BL-EP3.4.kicad_mod
│   │       ├── QFN-40_L6.0-W6.0-P0.50-BL-EP4.5.kicad_mod
│   │       ├── QFN-64_L9.0-W9.0-P0.50-TL-EP5.2.kicad_mod
│   │       ├── QFN50P500X500X60-33N-V2.kicad_mod
│   │       ├── RJ45-TH_HR911105A.kicad_mod
│   │       ├── SMD-18_L10.1-W9.7-P1.10-TL_SKG09F.kicad_mod
│   │       ├── SON-12_L4.0-W2.5-P0.40-BL-EP.kicad_mod
│   │       ├── SOP-16_L10.3-W7.5-P1.27-LS10.4-BL.kicad_mod
│   │       ├── SOT-23-3_L2.9-W1.3-P0.95-LS2.4-BR.kicad_mod
│   │       ├── SOT-23-6_L2.9-W1.6-P0.95-LS2.8-BL.kicad_mod
│   │       ├── SOT-23-6_L2.9-W1.6-P0.95-LS2.8-BR.kicad_mod
│   │       ├── TF-SMD_TF-01A.kicad_mod
│   │       ├── TO-263-7_L10.2-W9.2-P1.27-LS15.0-TL.kicad_mod
│   │       ├── TQFP-32_L5.0-W5.0-P0.50-LS7.0-TL.kicad_mod
│   │       ├── TSSOP-28_L9.7-W4.4-P0.65-LS6.4-BL.kicad_mod
│   │       ├── USB-C-SMD_TYPE-C-24P-SMD.kicad_mod
│   │       ├── VQFN-10_L2.0-W2.0-P0.45-TL.kicad_mod
│   │       ├── VQFN-16_L3.0-W3.0-P0.50-TL-EP1.5.kicad_mod
│   │       ├── VQFN-20_L4.6-W3.6-P0.50-BL.kicad_mod
│   │       ├── VQFN-20_L5.0-W5.0-P0.65-TL-EP.kicad_mod
│   │       ├── VQFN-48_L7.0-W7.0-P0.50-TL-EP4.1.kicad_mod
│   │       ├── VQFN-64_L9.0-W9.0-P0.50-TL-EP7.4.kicad_mod
│   │       ├── VQFN-CLIP-28_L4.5-W3.5-P0.40-BL-EP.kicad_mod
│   │       ├── VQFN-HR-12_L2.5-W2.0-P0.50-BL.kicad_mod
│   │       ├── VSON-8_L2.0-W1.5-P0.50-BL.kicad_mod
│   │       ├── VSON-8_L3.0-W3.0-P0.65-BL-EP.kicad_mod
│   │       ├── WQFN-20_L3.0-W3.0-P0.40-TL-EP1.7.kicad_mod
│   │       ├── WQFN-24_L4.0-W4.0-P0.50-TL-EP2.5.kicad_mod
│   │       ├── WSON-10_L3.0-W3.0-P0.50-BL-EP.kicad_mod
│   │       ├── WSON-6_L1.5-W1.5-P0.50-TL.kicad_mod
│   │       └── XCZU4EVFBVB900PKG.kicad_mod
│   ├── Schematics
│   │   ├── 01_Power
│   │   │   └── Power_Input_Protection.kicad_sch
│   │   ├── 02_Battery
│   │   │   └── Battery_Charger_FuelGauge.kicad_sch
│   │   ├── 03_Power_Tree
│   │   │   ├── 03_Power_Tree.kicad_sch
│   │   │   └── 04d_Zynq_PS_HighSpeed.kicad_sch
│   │   ├── 04_Zynq
│   │   │   ├── 04_Zynq.kicad_sch
│   │   │   ├── 04a_Zynq_Core.kicad_sch
│   │   │   ├── 04b_Zynq_DDR4.kicad_sch
│   │   │   ├── 04c_Zynq_PS_Perhipherals.kicad_sch
│   │   │   └── 04d_Zynq_PS_HighSpeed.kicad_sch
│   │   ├── 05_Clocking
│   │   │   └── 05_Clocking.kicad_sch
│   │   ├── 06_Video
│   │   │   └── 06_Video.kicad_sch
│   │   ├── 07_Analog_RF
│   │   │   └── 07_Analog_RF.kicad_sch
│   │   ├── 08_Sesnsors_GNSS
│   │   │   └── 08_Sensors_GNSS.kicad_sch
│   │   ├── 09_RTC_Security
│   │   │   └── 09_RTC_Security.kicad_sch
│   │   ├── 10_Harvester_BMC_Telemetry
│   │   │   └── 10_Harvester_BMC_Telemetry.kicad_sch
│   │   ├── 11_ePaper
│   │   │   └── 11_ePaper.kicad_sch
│   │   └── 12_Expansion
│   │       └── 12_Expansion.kicad_sch
│   ├── gerber_to_order
│   │   ├── Devboard_304.55x205.56mm_for_Default
│   │   │   ├── Devboard-B_Cu.gbr
│   │   │   ├── Devboard-B_Mask.gbr
│   │   │   ├── Devboard-B_Paste.gbr
│   │   │   ├── Devboard-B_Silks.gbr
│   │   │   ├── Devboard-Edge_Cuts.gbr
│   │   │   ├── Devboard-F_Cu.gbr
│   │   │   ├── Devboard-F_Mask.gbr
│   │   │   ├── Devboard-F_Paste.gbr
│   │   │   ├── Devboard-F_Silks.gbr
│   │   │   ├── Devboard-In1_Cu.gbr
│   │   │   ├── Devboard-In2_Cu.gbr
│   │   │   ├── Devboard-In3_Cu.gbr
│   │   │   └── Devboard-In4_Cu.gbr
│   │   └── Devboard_304.55x205.56mm_for_JLCPCB
│   │       ├── Devboard-B_Cu.gbl
│   │       ├── Devboard-B_Mask.gbs
│   │       ├── Devboard-B_Paste.gbp
│   │       ├── Devboard-B_Silks.gbo
│   │       ├── Devboard-Edge_Cuts.gm1
│   │       ├── Devboard-F_Cu.gtl
│   │       ├── Devboard-F_Mask.gts
│   │       ├── Devboard-F_Paste.gtp
│   │       ├── Devboard-F_Silks.gto
│   │       ├── Devboard-In1_Cu.g1
│   │       ├── Devboard-In2_Cu.g2
│   │       ├── Devboard-In3_Cu.g3
│   │       └── Devboard-In4_Cu.g4
│   ├── ~Devboard.kicad_pcb.lck
│   └── ~Devboard.kicad_pro.lck
├── Production
│   ├── BOM
│   │   ├── BillOfMaterials.csv
│   │   ├── BillOfMaterials.md
│   │   └── ibom.html
│   ├── Devboard-all-pos.csv
│   └── Gerbers
│       ├── Gerbers.zip
│       └── RawFiles
│           ├── Devboard-B_Cu.gbr
│           ├── Devboard-B_Mask.gbr
│           ├── Devboard-B_Paste.gbr
│           ├── Devboard-B_Silkscreen.gbr
│           ├── Devboard-Edge_Cuts.gbr
│           ├── Devboard-F_Cu.gbr
│           ├── Devboard-F_Mask.gbr
│           ├── Devboard-F_Paste.gbr
│           ├── Devboard-F_Silkscreen.gbr
│           ├── Devboard-In10_Cu.gbr
│           ├── Devboard-In11_Cu.gbr
│           ├── Devboard-In12_Cu.gbr
│           ├── Devboard-In13_Cu.gbr
│           ├── Devboard-In14_Cu.gbr
│           ├── Devboard-In1_Cu.gbr
│           ├── Devboard-In2_Cu.gbr
│           ├── Devboard-In3_Cu.gbr
│           ├── Devboard-In4_Cu.gbr
│           ├── Devboard-In5_Cu.gbr
│           ├── Devboard-In6_Cu.gbr
│           ├── Devboard-In7_Cu.gbr
│           ├── Devboard-In8_Cu.gbr
│           ├── Devboard-In9_Cu.gbr
│           ├── Devboard-NPTH.drl
│           ├── Devboard-PTH.drl
│           └── Devboard-job.gbrjob
├── README.md
└── firmware.c
```
