damnitzhemanth-oss/FusionBoard/Guides/GuideForReviewers.md

For tech justif, read README.
For additional notes checkout my repo.

I added round corners as Om told, and tried KiCanvas which worked but the link didnt work.

You should watch around 100 minutes of lapse sob.
