damnitzhemanth-oss/FusionBoard/journal.md

# Journal : Fusion Board

*Author : Hemanth*
*YSWS : Pixl*
*Goal : Make a beacon worthy project and put up at least 100 hours*

---

## Notes :

Please read this Journal for clear day to day insights + not so funny jokes + AI Usage.

---

## Session 1 :
[Lapse](https://lapse.hackclub.com/timelapse/AL27EAvf0Gup)

**Time : 6 hr 15 min**

I decided to make a custom Dev Board which is *Unique*, *Hard to make* and most importantly *built from scratch* with least amount of **AI usage**. 

Today I completed setup of my project, setup included Pixl Project, Github Repo, File structure and KiCad setup. 

I planned the design and layout, basically all my other projects till this point involved Sections in a sheet, but thats not enough for a Dev Board this scale. so it requires multiple hierarchical sheets with separate sections.

Today I completed Section 1 which is related to Power. It simply receives power and safely passes it to other section.

**AI USAGE** : 5-15 minutes, when we search in google we get AI insights so I just read them, and used Deepseek for connections in only two instants where I didn't understand connections of MUX so I used Deepseek

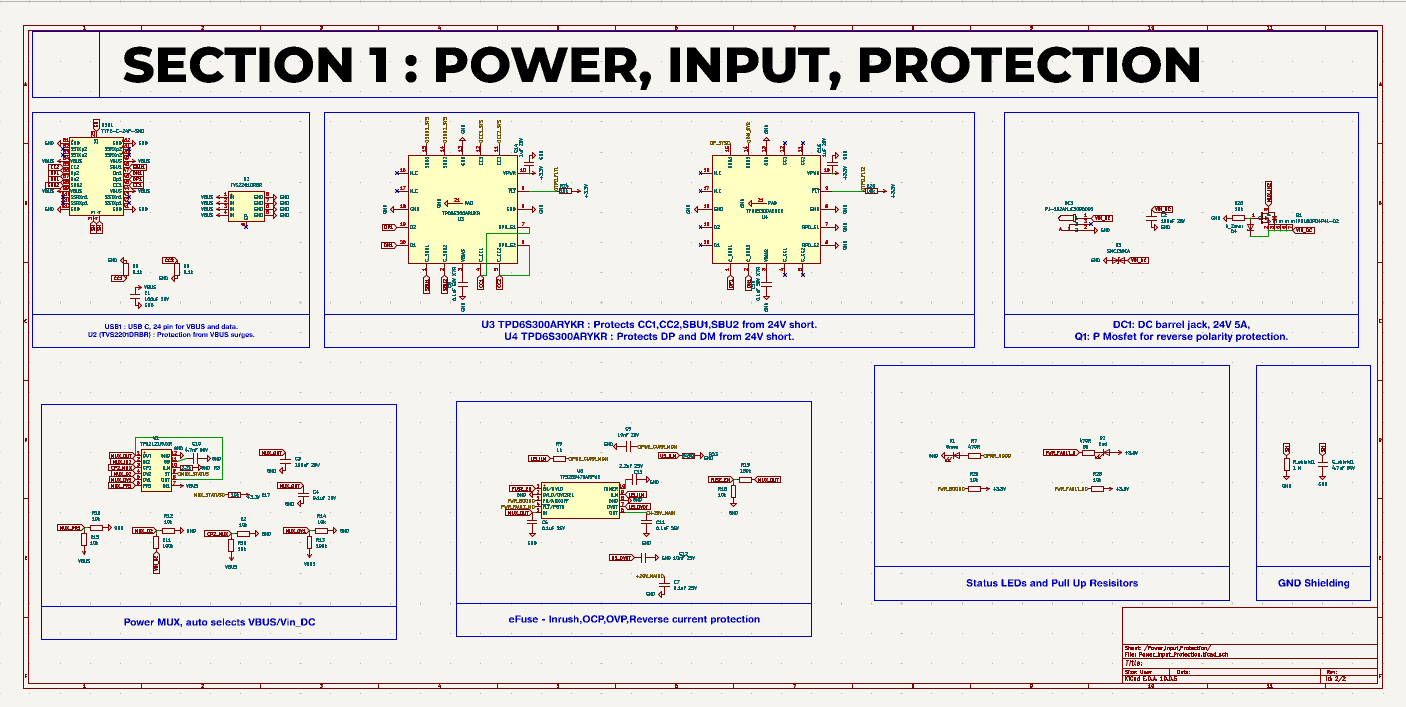
[picture p37: PCB/Devboard/images/Schematic/01_Power/S01_Full.png]
Schematic


---

## Session 2 :

[Lapse](https://lapse.hackclub.com/timelapse/RgZXFPeaefZ3)

**Time : 2 hr 30 min**

Today I completed Section 1 and worked on Section 2. Section 2 is about battery charging + power gauge. 

**AI USAGE** : 2 minutes, once I used to check pin names of a shunt resistor and ideal connection (Search insights). And once to verify sanity.

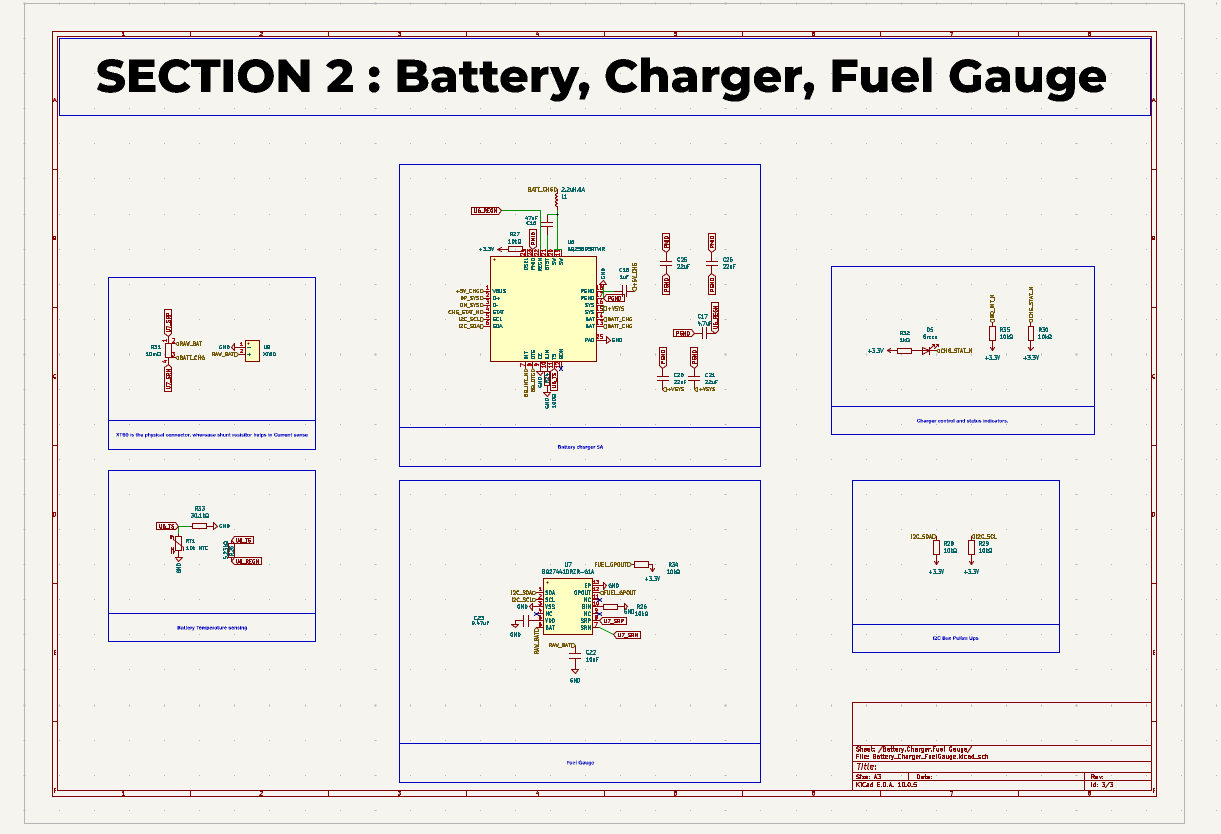
[picture p38: PCB/Devboard/images/Schematic/02_Battery/S2.png]
Schematic


---

## Session 3 : 

[Lapse](https://lapse.hackclub.com/timelapse/42OSYWENe3S8)

**Time : 4 hrs 18 min**

Today I completed Section 3 which is responsible to step-down main power line into different voltages like +5V, +3.3V, +0.8V, +1.5V.
And this time I actually read datasheets !!

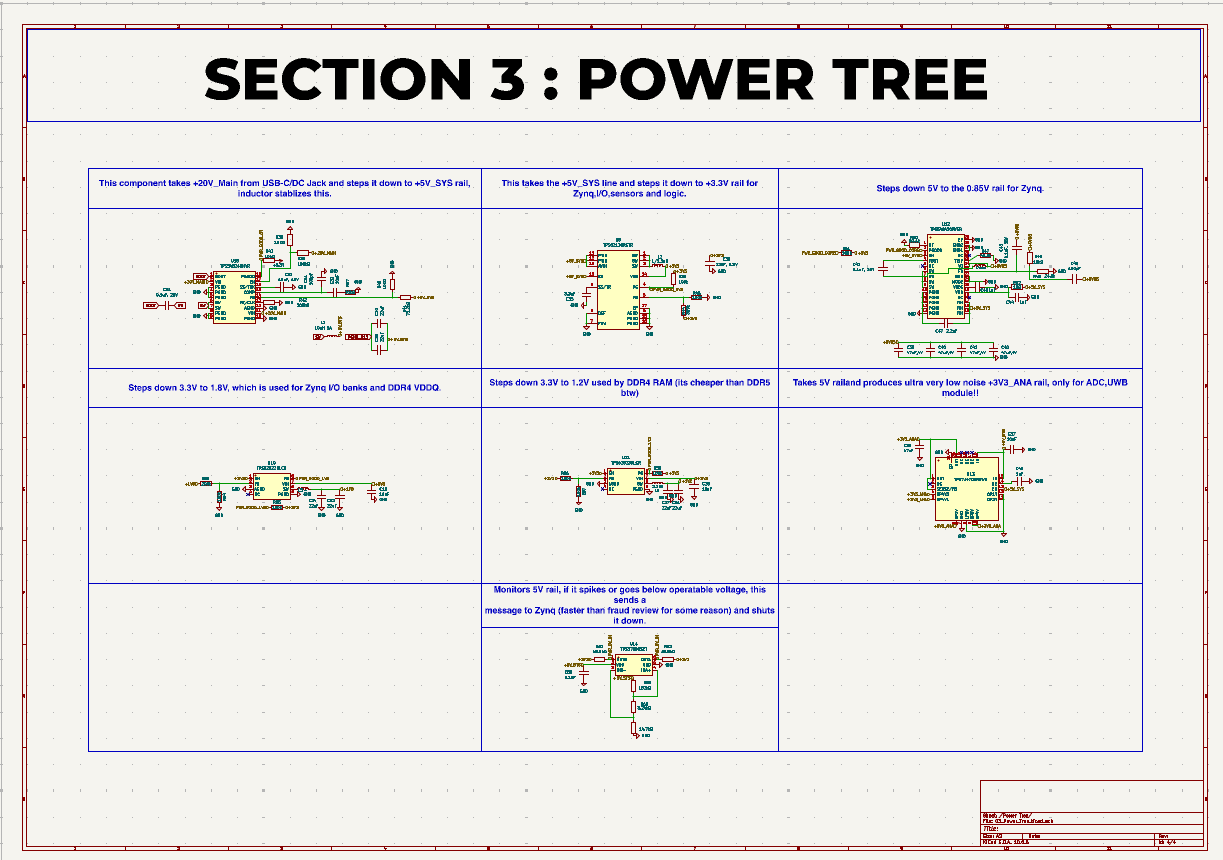
[picture p39: PCB/Devboard/images/Schematic/03_Power_Tree/S3_F.png]
Schematic


And I created new repo !!

**AI USAGE** : None.

---

## Session 4 :

**Time : 11 hrs 52 min**

[Lapse](https://lapse.hackclub.com/timelapse/BUebwhysWVGx)

Fixed a few mistakes in previous section, chose 900 pin Zynq (regretting my life choices), and discovered KiPart a python package to create Symbol, and created footprint manually.

**AI USAGE**: None.

---

## Session 5 :

[Lapse](https://lapse.hackclub.com/timelapse/Iurz7R1SKVbi)

**Time : 7 hr 32 min**

Began on DDR4 memory and realized that I followed wrong datasheet, and had to scrap it and begin over.

**AI USAGE** : Two small instances (less than 2 minutes) for understanding chinese parts of my datasheet.

---

##  Session 6 :

[Lapse](https://lapse.hackclub.com/timelapse/Otw7jyXCwGHQ)

**Time : 2 hr 42 min**

Fixed mistakes and began on Zynq, completed power rails + capacitors.

**AI USAGE** : None.

---

## Decision 

I decided to not use AI at all (very strict). Not even for understanding something. (Google search insights excluded).

---

## Session 7 : 

[Lapse](https://lapse.hackclub.com/timelapse/XaJOH0bwTB7O)

**Time : 1 hr 19 min**

Before I begin Zynq again I corrected few mistakes, and checked from beginning. Read Zynq User guide once again.
Restructured Repo.

- [x] Section 1
- [x] Section 2
- [x] Section 3
- [x] Check 1
- [x] Check 2
- [ ] Power Section, adding missing nets.
- [ ] Zynq
- [ ] DDR4 Memory

**AI USAGE** : None.

---

## Summary of WEEK 1

| Session | Time | Work completed / summary | Lapse link | AI usage (0–5) | AI usage notes |
|---|---:|---|---|---:|---|
| 1 | 6 hr 15 min | Project setup: Pixl project, GitHub repo, file structure, KiCad setup; planned hierarchical sheets; completed Power Section 1. | [Lapse](https://lapse.hackclub.com/timelapse/AL27EAvf0Gup) | **3** | 5–15 min total: Google AI insights; DeepSeek used twice for MUX connections. |
| 2 | 2 hr 30 min | Completed Section 1; worked on Section 2: battery charging + power gauge. | [Lapse](https://lapse.hackclub.com/timelapse/RgZXFPeaefZ3) | **1** | ~2 min: shunt resistor pin names/ideal connection; sanity check via search insights. |
| 3 | 4 hr 18 min | Completed Section 3: power tree stepping down to +5V, +3.3V, +0.8V, +1.5V; read datasheets; created new repo. | [Lapse](https://lapse.hackclub.com/timelapse/42OSYWENe3S8) | **0** | None. |
| 4 | 11 hr 52 min | Fixed previous-section mistakes; chose 900-pin Zynq; used KiPart to create symbol; created footprint manually. | [Lapse](https://lapse.hackclub.com/timelapse/BUebwhysWVGx) | **0** | None. |
| 5 | 7 hr 32 min | Began DDR4 memory; found wrong datasheet and scrapped/restarted. | [Lapse](https://lapse.hackclub.com/timelapse/Iurz7R1SKVbi) | **1** | <2 min total: two small instances for understanding Chinese parts of datasheet. |
| 6 | 2 hr 42 min | Fixed mistakes; began Zynq; completed power rails + capacitors. | [Lapse](https://lapse.hackclub.com/timelapse/Otw7jyXCwGHQ) | **0** | None. |
| 7 | 1 hr 19 min | Corrected mistakes; rechecked from beginning; reread Zynq User Guide; updated checklist: S1–S3 + Check 1/2 done; power missing nets, Zynq, DDR4 pending. | [Lapse](https://lapse.hackclub.com/timelapse/XaJOH0bwTB7O) | **0** | None. |
| 8 | ~ 4 hr | Journal, etc | - | 0 | None. |
| **Total** | **40 hr 12 min** |  |  |  |  |

**AI usage score:** `0 = none`, `5 = Highest in this log.` (Session 1); brief or minor lookups scored as `1`. Google search AI insights are counted only where the log explicitly mentions them.

**Decision after Session 6:** strict no-AI policy — not even for understanding something; Google search insights excluded.

---

## Session 8

[Lapse](https://lapse.hackclub.com/timelapse/mQAbmNkva20k)

**Time : 7 hrs**

Today I read Zynq Ultrascale+ user guide + datasheets and added missing power lines and completed wiring up power portions of Zynq. Then I added decoupling caps (200+). Next I planned future components like USB2,USB3 and created global labels for I2C, System Monitor etc. 

Next Steps : 
- [ ] DDR4 Memory
- [ ] Peripherals

Challenges :

We were facing severe droughts here in our area, fortunately it rained today but electricity went off. So 9 hours turned into 7 hours, but in free time I read datasheets , don't know whether I need to journal it.

Feat :

Nearing 50 hrs !!

**AI USAGE** : None.

---

## Session 9

[Lapse](https://lapse.hackclub.com/timelapse/UzQu37tnS4zK)

**Time : 6 hrs 50 min**

Today I completed DDR4 Memory section (4GB of memory). And I started working on peripherals (completed SD Card, Ethernet etc)
My goal today was 9 hrs but I read datasheets offline so I was not able to hit it. And my phone's USB Port is damaged so USB tethering had problems (this is the reason I check time frequently in Lapse). 
Next Steps : 
- [x] DDR4 Memory
- [ ] Complete Peripherals

Challenges :

Loose USB + Power Cuts.

Feat :

50 hours completed !!!

**AI USAGE** : None.

---

## Session 10

[Lapse](https://lapse.hackclub.com/timelapse/eKkvBAt7k13z)

**Time : 1 hrs 22 min**

Today I completed a part of Peripherals. 

Next Steps : 
- [x] DDR4 Memory
- [ ] Complete Peripherals

Challenges :

Loose USB + Power Cuts.

**AI USAGE** : None.

---

## Session 11

[Lapse](https://lapse.hackclub.com/timelapse/DB7lABWo2sH_)

**Time : 2 hrs 54 min**

Completed peripherals, and added high speed peripherals.

Next Steps : 
- [x] Peripherals
- [ ] High Speed Peripherals

Challenges :

Kicad Crash so PC got struck.

**AI USAGE** : None.

---
