damnitzhemanth-oss/FusionBoard/PCB/Devboard.kicad_pcb

## KiCad design PCB/Devboard.kicad_pcb (2026-11-09)

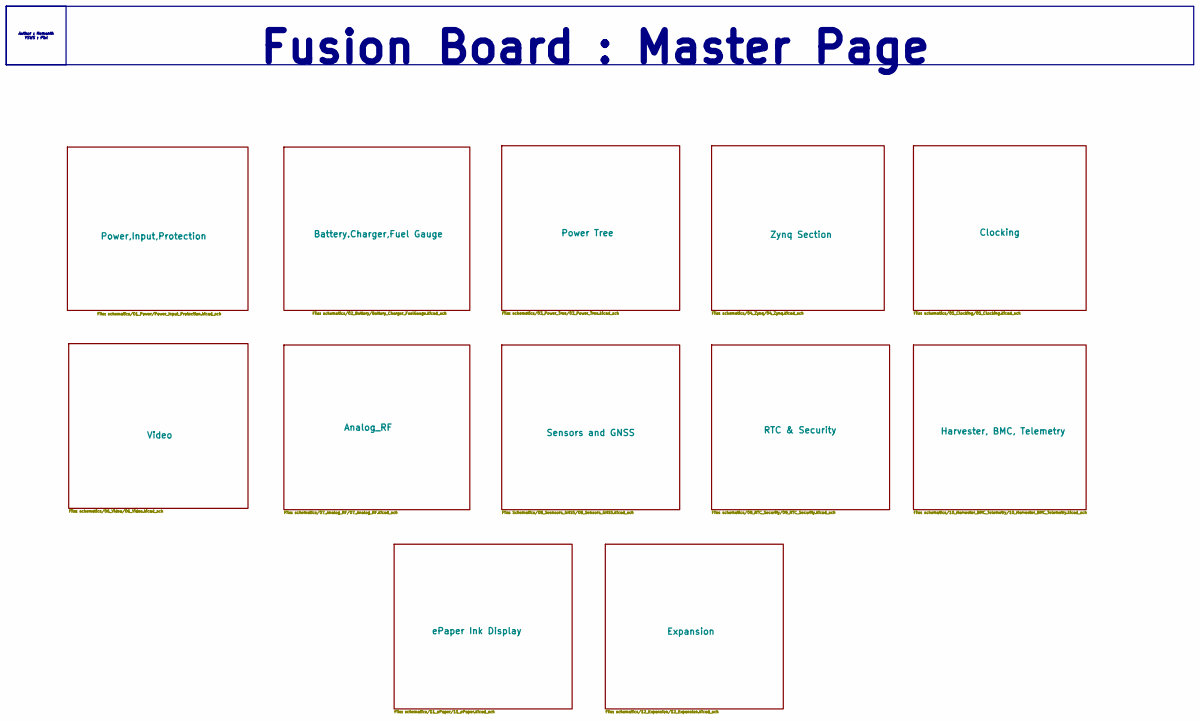
[picture p40: schematic Devboard.kicad_sch]

Notes on the sheet:
Fusion Board : Master Page
Author : Hemanth YSWS : Pixl

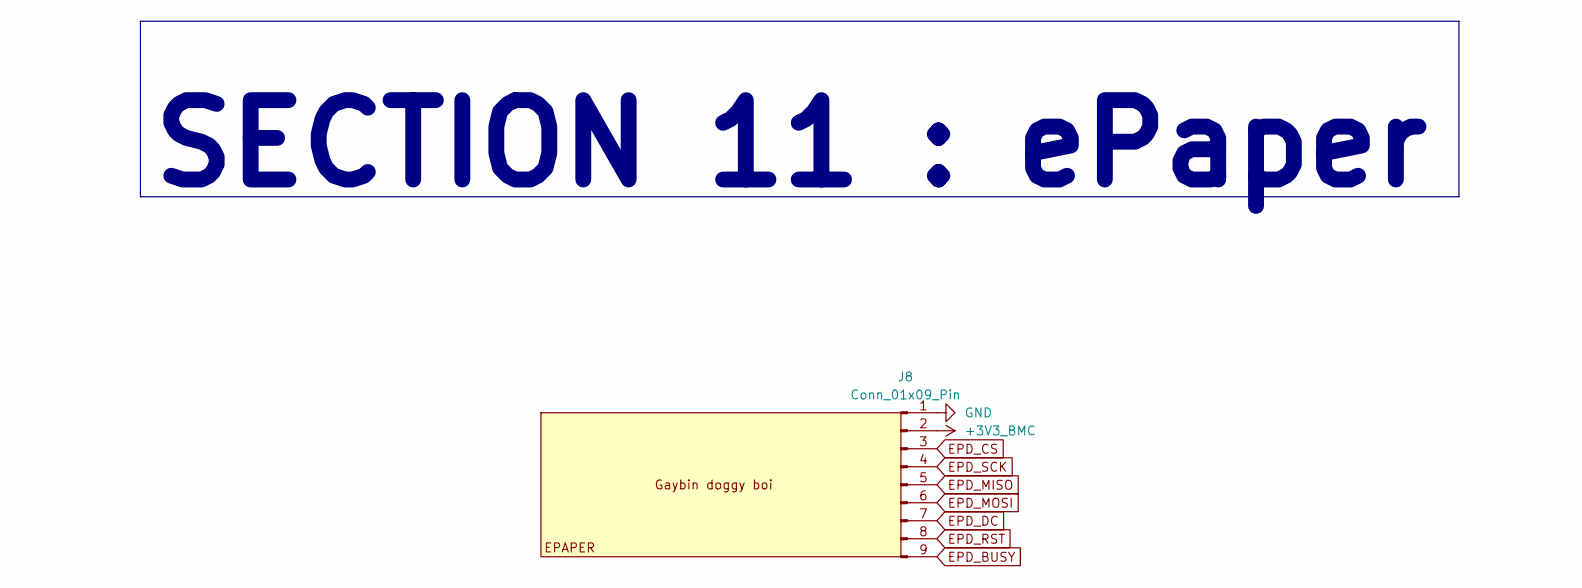
[picture p41: schematic 11_ePaper.kicad_sch]

Parts:
J8: Conn_01x09_Pin; PinHeader_1x09_P2.54mm_Vertical

Connections:
+3V3_BMC: J8.2; also elsewhere on the board
EPD_BUSY: J8.9; also elsewhere on the board
EPD_CS: J8.3; also elsewhere on the board
EPD_DC: J8.7; also elsewhere on the board
EPD_MISO: J8.5; also elsewhere on the board
EPD_MOSI: J8.6; also elsewhere on the board
EPD_RST: J8.8; also elsewhere on the board
EPD_SCK: J8.4; also elsewhere on the board
GND: J8.1; also elsewhere on the board

Notes on the sheet:
SECTION 11 : ePaper

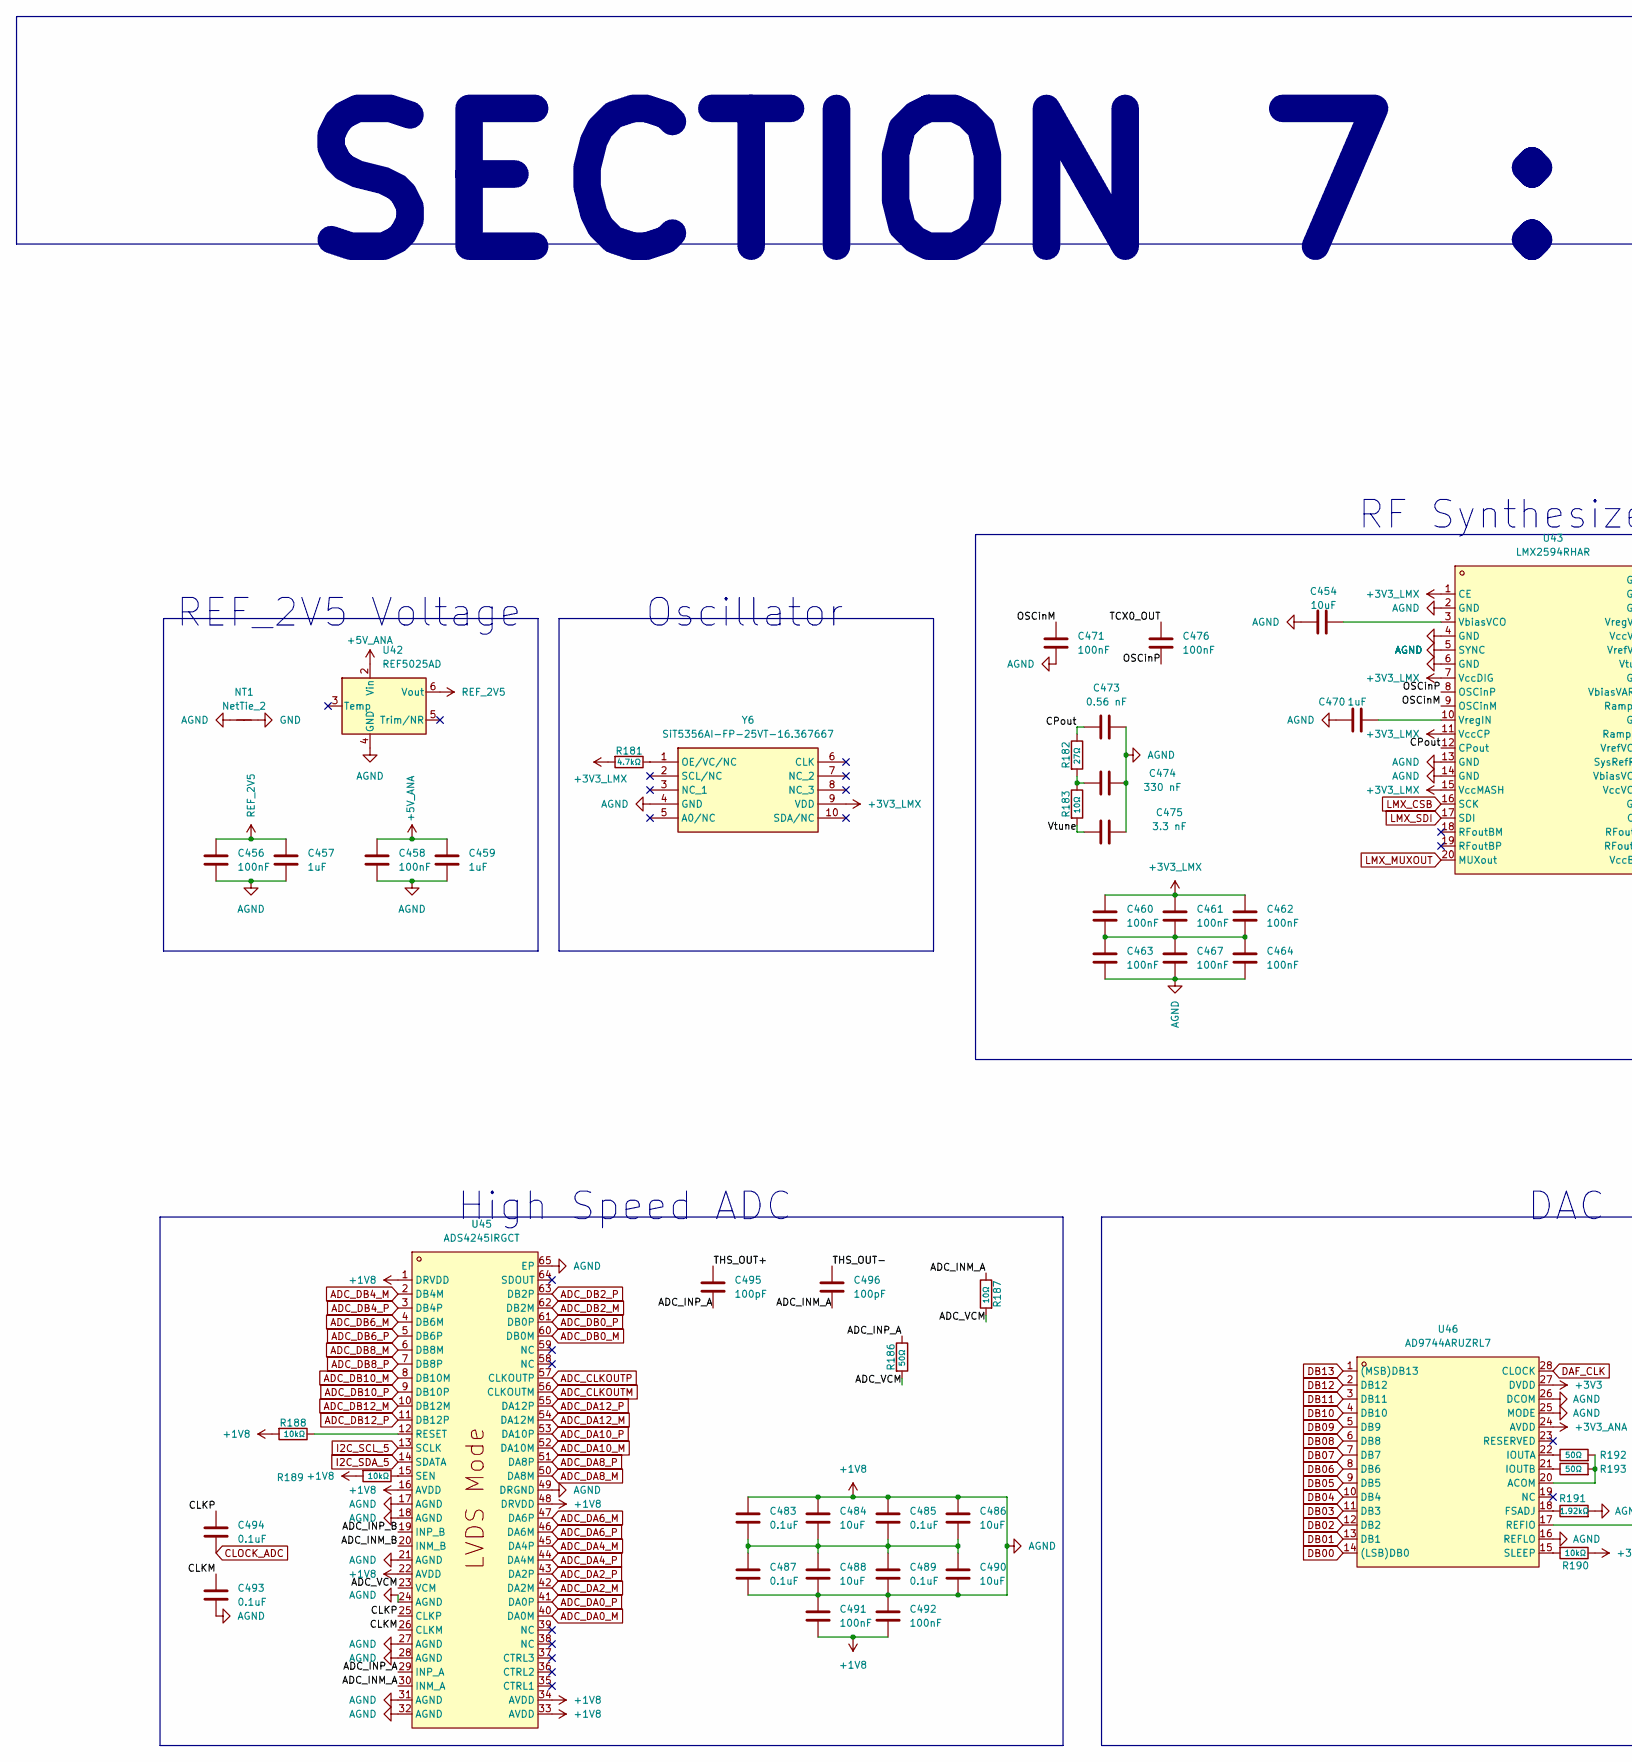
[picture p42: schematic 07_Analog_RF.kicad_sch, part in row 1, column 1]

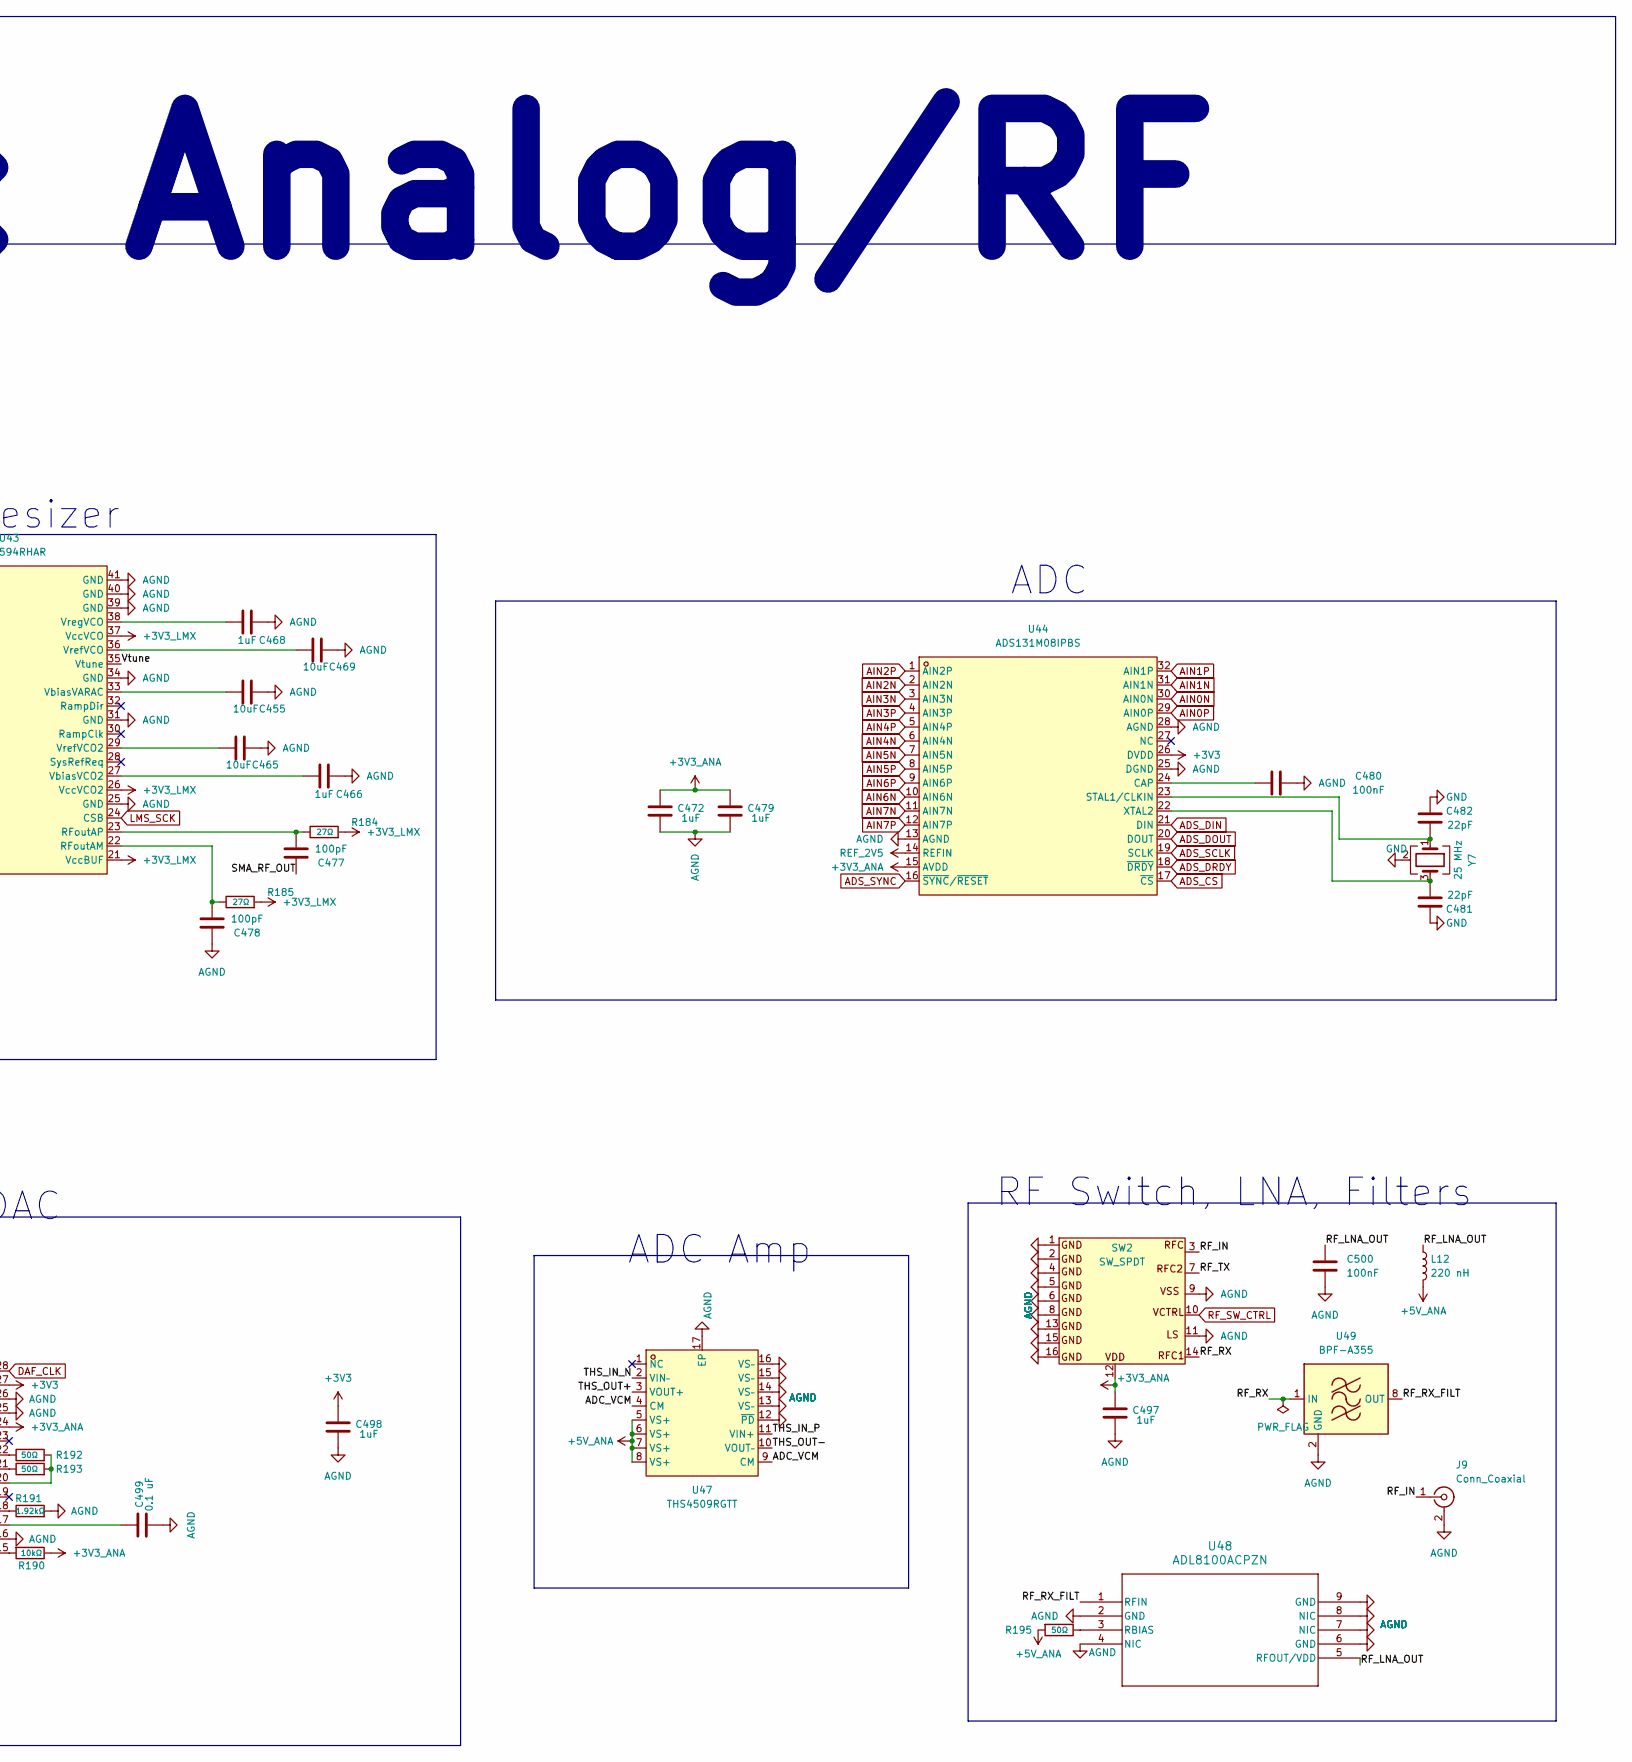
[picture p43: schematic 07_Analog_RF.kicad_sch, part in row 1, column 2]

Parts:
C454, C455, C465, C469, C484, C486, C488, C490: 10uF; C_0402_1005Metric
C456, C458, C460, C461, C462, C463, C464, C467, C471, C476, C480, C491, C492, C500: 100nF; C_0402_1005Metric
C457, C459, C466, C468, C470, C472, C479, C497, C498: 1uF; C_0402_1005Metric
C473: 0.56 nF; C_0402_1005Metric
C474: 330 nF; C_0402_1005Metric
C475: 3.3 nF; C_0402_1005Metric
C477, C478, C495, C496: 100pF; C_0402_1005Metric
C481, C482: 22pF; C_0402_1005Metric
C483, C485, C487, C489, C493, C494: 0.1uF; C_0402_1005Metric
C499: 0.1 uF; C_0402_1005Metric
J9: Conn_Coaxial; SMA_Amphenol_132289_EdgeMount
L12: 220 nH; L_0603_1608Metric
NT1: NetTie_2; NetTie-2_SMD_Pad0.5mm
R181: 4.7kΩ; R_0402_1005Metric
R182, R184, R185: 27Ω; R_0402_1005Metric
R183, R187: 10Ω; R_0402_1005Metric
R186, R192, R193, R195: 50Ω; R_0402_1005Metric
R188, R189, R190: 10kΩ; R_0402_1005Metric
R191: 1.92kΩ; R_0402_1005Metric
SW2: SW_SPDT; LFCSP-16-1EP_3x3mm_P0.5mm_EP1.6x1.6mm
U42: REF5025AD; SOIC-8_3.9x4.9mm_P1.27mm
U43: LMX2594RHAR; QFN-40_L6.0-W6.0-P0.50-BL-EP4.5; MPN LMX2594RHAR; LCSC Part C2862572
U44: ADS131M08IPBS; TQFP-32_L5.0-W5.0-P0.50-LS7.0-TL; MPN ADS131M08IPBS; LCSC Part C2685451
U45: ADS4245IRGCT; VQFN-64_L9.0-W9.0-P0.50-TL-EP7.4; MPN ADS4245IRGCT; LCSC Part C2670075
U46: AD9744ARUZRL7; TSSOP-28_L9.7-W4.4-P0.65-LS6.4-BL; MPN AD9744ARUZRL7; LCSC Part C461519
U47: THS4509RGTT; VQFN-16_L3.0-W3.0-P0.50-TL-EP1.5; MPN THS4509RGTT; LCSC Part C2057531
U48: ADL8100ACPZN; CP-8-30_ADI
U49: BPF-A355; Mini-Circuits_HQ1157
Y6: SiT5356AI-FP-25VT-16.367667; Ceramic_QFN_5032_10pins; Manufacturer_Part_Number SiT5356AI-FP-25VT-16.367667
Y7: 25 MHz; Crystal_SMD_3225-4Pin_3.2x2.5mm

Connections:
+1V8: C454.1, C455.1, C456.1, C457.1, C458.1, C459.1, C463.1, C464.1, C465.1, C466.1, C467.1, C468.1, C469.1, C470.1, C471.1, C472.1, C473.1, C474.1, C475.1, C478.2, C479.1, C480.1, C483.1, C484.2, C485.1, C486.2, C487.2, C488.1, C489.2, C490.1, C491.1, C491.2, C492.1, C492.2, C493.2, C497.1, C498.1, C499.1, C500.2, J9.2 (Ext), NT1.1, R188.2, R189.2, R191.2, SW2.1 (GND), SW2.2 (GND), SW2.4 (GND), SW2.5 (GND), SW2.6 (GND), SW2.8 (GND), SW2.9 (VSS), SW2.11 (LS), SW2.13 (GND), SW2.15 (GND), SW2.16 (GND), U42.4 (GND), U43.2 (GND), U43.4 (GND), U43.5 (SYNC), U43.6 (GND), U43.13 (GND), U43.14 (GND), U43.25 (GND), U43.31 (GND), U43.34 (GND), U43.39 (GND), U43.40 (GND), U43.41 (GND), U44.13 (AGND), U44.25 (DGND), U44.28 (AGND), U45.1 (DRVDD), U45.16 (AVDD), U45.17 (AGND), U45.18 (AGND), U45.21 (AGND), U45.22 (AVDD), U45.24 (AGND), U45.27 (AGND), U45.28 (AGND), U45.31 (AGND), U45.32 (AGND), U45.33 (AVDD), U45.34 (AVDD), U45.48 (DRVDD), U45.49 (DRGND), U45.65 (EP), U46.16 (REFLO), U46.25 (MODE), U46.26 (DCOM), U47.12 (~PD), U47.13 (VS–), U47.14 (VS–), U47.15 (VS–), U47.16 (VS–), U47.17 (EP), U48.2 (GND), U48.4 (NIC), U48.6 (GND), U48.7 (NIC), U48.8 (NIC), U48.9 (GND), U49.2 (GND), U49.3 (GND), U49.4 (GND), U49.5 (GND), U49.6 (GND), U49.7 (GND), U49.9 (GND), U49.10 (GND), U49.11 (GND), U49.12 (GND), U49.13 (GND), U49.14 (GND), Y6.4 (GND); also elsewhere on the board
+3V3: C498.2, U44.26 (DVDD), U46.27 (DVDD); also elsewhere on the board
+3V3_ANA: C472.2, C479.2, C497.2, R190.1, SW2.12 (VDD), U44.15 (AVDD), U46.24 (AVDD); also elsewhere on the board
+3V3_LMX: C460.2, C461.2, C462.2, R181.2, R184.2, R185.2, U43.1 (CE), U43.7 (VccDIG), U43.11 (VccCP), U43.15 (VccMASH), U43.21 (VccBUF), U43.26 (VccVCO2), U43.37 (VccVCO), Y6.9 (VDD); also elsewhere on the board
+5V_ANA: C458.2, C459.2, L12.2, R195.2, U42.2 (Vin), U47.5 (VS+), U47.6 (VS+), U47.7 (VS+), U47.8 (VS+); also elsewhere on the board
/Analog_RF/ADC_INM_A: C496.2, R187.1, U45.30 (INM_A)
/Analog_RF/ADC_INM_B: U45.20 (INM_B)
/Analog_RF/ADC_INP_A: C495.2, R186.1, U45.29 (INP_A)
/Analog_RF/ADC_INP_B: U45.19 (INP_B)
/Analog_RF/ADC_VCM: R186.2, R187.2, U45.23 (VCM), U47.4 (CM), U47.9 (CM)
/Analog_RF/CLKM: C493.1, U45.26 (CLKM)
/Analog_RF/CLKP: C494.1, U45.25 (CLKP)
/Analog_RF/CPout: C473.2, R182.1, U43.12 (CPout)
/Analog_RF/OSCinM: C471.2, U43.9 (OSCinM)
/Analog_RF/OSCinP: C476.1, U43.8 (OSCinP)
/Analog_RF/RF_IN: J9.1 (In), SW2.3 (RFC)
/Analog_RF/RF_LNA_OUT: C500.1, L12.1, U48.5 (RFOUT/VDD)
/Analog_RF/RF_RX: SW2.14 (RF2), U49.1 (IN)
/Analog_RF/RF_RX_FILT: U48.1 (RFIN), U49.8 (OUT)
/Analog_RF/RF_TX: SW2.7 (RF2)
/Analog_RF/SMA_RF_OUT: C477.2
/Analog_RF/TCX0_OUT: C476.2
/Analog_RF/THS_IN_N: U47.2 (VIN–)
/Analog_RF/THS_IN_P: U47.11 (VIN+)
/Analog_RF/THS_OUT+: C495.1, U47.3 (VOUT+)
/Analog_RF/THS_OUT-: C496.1, U47.10 (VOUT–)
/Analog_RF/Vtune: C475.2, R183.2, U43.35 (Vtune)
ADC_CLKOUTM: U45.56 (CLKOUTM); also elsewhere on the board
ADC_CLKOUTP: U45.57 (CLKOUTP); also elsewhere on the board
ADC_DA0_M: U45.40 (DA0M); also elsewhere on the board
ADC_DA0_P: U45.41 (DA0P); also elsewhere on the board
ADC_DA2_M: U45.42 (DA2M); also elsewhere on the board
ADC_DA2_P: U45.43 (DA2P); also elsewhere on the board
ADC_DA4_M: U45.45 (DA4P); also elsewhere on the board
ADC_DA4_P: U45.44 (DA4M); also elsewhere on the board
ADC_DA6_M: U45.47 (DA6P); also elsewhere on the board
ADC_DA6_P: U45.46 (DA6M); also elsewhere on the board
ADC_DA8_M: U45.50 (DA8M); also elsewhere on the board
ADC_DA8_P: U45.51 (DA8P); also elsewhere on the board
ADC_DA10_M: U45.52 (DA10M); also elsewhere on the board
ADC_DA10_P: U45.53 (DA10P); also elsewhere on the board
ADC_DA12_M: U45.54 (DA12M); also elsewhere on the board
ADC_DA12_P: U45.55 (DA12P); also elsewhere on the board
ADC_DB0_M: U45.60 (DB0M); also elsewhere on the board
ADC_DB0_P: U45.61 (DB0P); also elsewhere on the board
ADC_DB2_M: U45.62 (DB2M); also elsewhere on the board
ADC_DB2_P: U45.63 (DB2P); also elsewhere on the board
ADC_DB4_M: U45.2 (DB4M); also elsewhere on the board
ADC_DB4_P: U45.3 (DB4P); also elsewhere on the board
ADC_DB6_M: U45.4 (DB6M); also elsewhere on the board
ADC_DB6_P: U45.5 (DB6P); also elsewhere on the board
ADC_DB8_M: U45.6 (DB8M); also elsewhere on the board
ADC_DB8_P: U45.7 (DB8P); also elsewhere on the board
ADC_DB10_M: U45.8 (DB10M); also elsewhere on the board
ADC_DB10_P: U45.9 (DB10P); also elsewhere on the board
ADC_DB12_M: U45.10 (DB12M); also elsewhere on the board
ADC_DB12_P: U45.11 (DB12P); also elsewhere on the board
ADS_CS: U44.17 (~CS); also elsewhere on the board
ADS_DIN: U44.21 (DIN); also elsewhere on the board
ADS_DOUT: U44.20 (DOUT); also elsewhere on the board
ADS_DRDY: U44.18 (~DRDY); also elsewhere on the board
ADS_SCLK: U44.19 (SCLK); also elsewhere on the board
ADS_SYNC: U44.16 (~SYNC/~RESET); also elsewhere on the board
AIN0N: U44.30 (AIN0N)
AIN0P: U44.29 (AIN0P)
AIN1N: U44.31 (AIN1N)
AIN1P: U44.32 (AIN1P)
AIN2N: U44.2 (AIN2N)
AIN2P: U44.1 (AIN2P)
AIN3N: U44.3 (AIN3N)
AIN3P: U44.4 (AIN3P)
AIN4N: U44.6 (AIN4N)
AIN4P: U44.5 (AIN4P)
AIN5N: U44.7 (AIN5N)
AIN5P: U44.8 (AIN5P)
AIN6N: U44.10 (AIN6N)
AIN6P: U44.9 (AIN6P)
AIN7N: U44.11 (AIN7N)
AIN7P: U44.12 (AIN7P)
CLOCK_ADC: C494.2; also elsewhere on the board
DAF_CLK: U46.28 (CLOCK); also elsewhere on the board
DB00: U46.14 ((LSB)DB0)
DB01: U46.13 (DB1)
DB02: U46.12 (DB2)
DB03: U46.11 (DB3)
DB04: U46.10 (DB4)
DB05: U46.9 (DB5)
DB06: U46.8 (DB6)
DB07: U46.7 (DB7)
DB08: U46.6 (DB8)
DB09: U46.5 (DB9)
DB10: U46.4 (DB10)
DB11: U46.3 (DB11)
DB12: U46.2 (DB12)
DB13: U46.1 ((MSB)DB13)
GND: C481.1, C482.1, NT1.2, Y7.2 (G), Y7.4 (G); also elsewhere on the board
I2C_SCL_5: U45.13 (SCLK); also elsewhere on the board
I2C_SDA_5: U45.14 (SDATA); also elsewhere on the board
LMS_SCK: U43.24 (CSB); also elsewhere on the board
LMX_CSB: U43.16 (SCK); also elsewhere on the board
LMX_MUXOUT: U43.20 (MUXout); also elsewhere on the board
LMX_SDI: U43.17 (SDI); also elsewhere on the board
unnamed: C460.1, C461.1, C462.1, C463.2, C464.2, C467.2
unnamed: C474.2, R182.2, R183.1
unnamed: C483.2, C484.1, C485.2, C486.1, C487.1, C488.2, C489.1, C490.2
unnamed: C478.1, R185.1, U43.22 (RFoutAM)
unnamed: C477.1, R184.1, U43.23 (RFoutAP)
unnamed: C455.2, U43.33 (VbiasVARAC)
unnamed: C466.2, U43.27 (VbiasVCO2)
unnamed: C454.2, U43.3 (VbiasVCO)
unnamed: C465.2, U43.29 (VrefVCO2)
unnamed: C469.2, U43.36 (VrefVCO)
unnamed: C470.2, U43.10 (VregIN)
unnamed: C468.2, U43.38 (VregVCO)
unnamed: C480.2, U44.24 (CAP)
unnamed: C482.2, U44.23 (STAL1/CLKIN), Y7.1
unnamed: C481.2, U44.22 (XTAL2), Y7.3
unnamed: R188.1, U45.12 (RESET)
unnamed: R189.1, U45.15 (SEN)
unnamed: R192.2, R193.2, U46.20 (ACOM)
unnamed: R191.1, U46.18 (FSADJ)
unnamed: R192.1, U46.22 (IOUTA)
unnamed: R193.1, U46.21 (IOUTB)
unnamed: C499.2, U46.17 (REFIO)
unnamed: R190.2, U46.15 (SLEEP)
unnamed: R195.1, U48.3 (RBIAS)
unnamed: R181.1, Y6.1 (OE/VC/NC)
REF_2V5: C456.2, C457.2, U42.6 (Vout), U44.14 (REFIN)
RF_SW_CTRL: SW2.10 (VCTRL)

Notes on the sheet:
ADC Amp
DAC
RF Synthesizer
REF_2V5 Voltage
High Speed ADC
RF Switch, LNA, Filters
ADC
Oscillator
SECTION 7 : Analog/RF

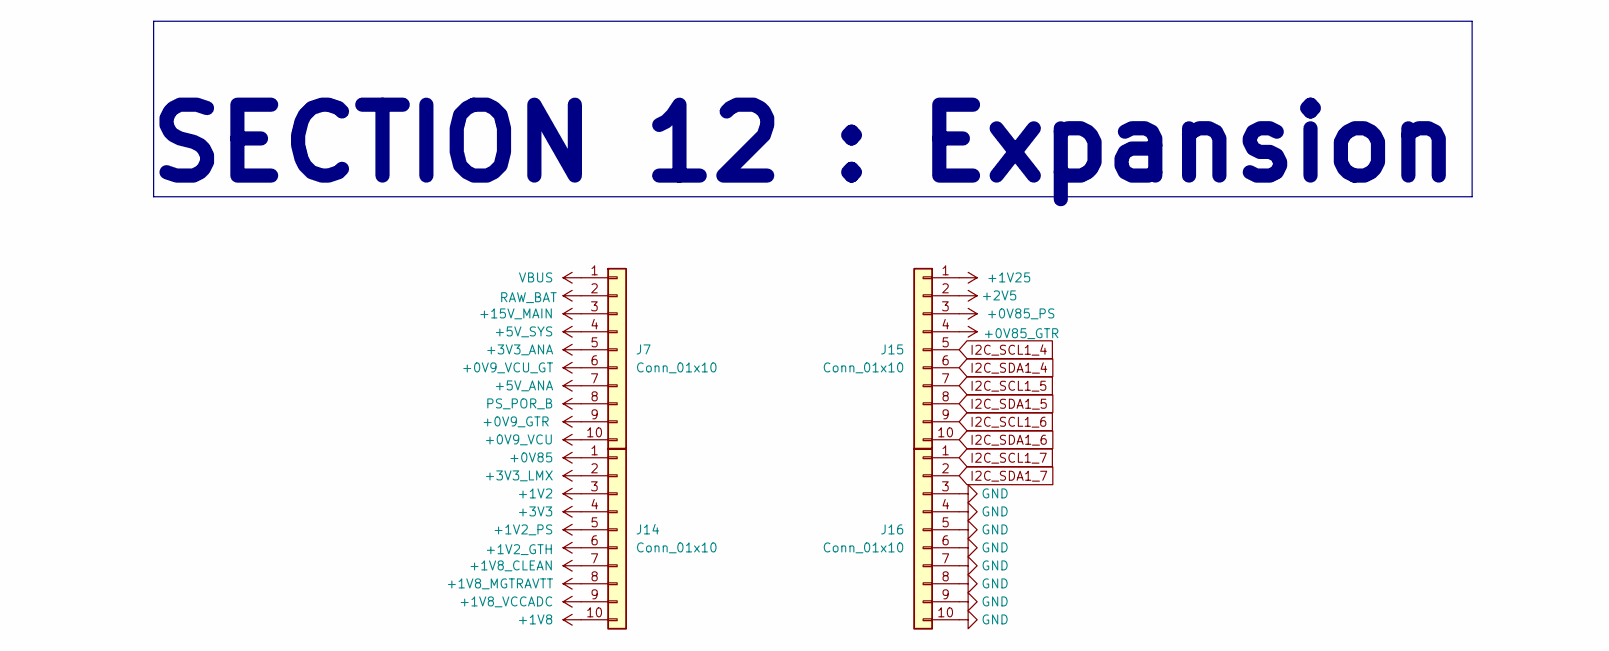
[picture p44: schematic 12_Expansion.kicad_sch]

Parts:
J7, J14, J15, J16: Conn_01x10; PinHeader_1x10_P2.54mm_Vertical

Connections:
+0V9_GTR: J7.9; also elsewhere on the board
+0V9_VCU: J7.10; also elsewhere on the board
+0V9_VCU_GT: J7.6; also elsewhere on the board
+0V85: J14.1; also elsewhere on the board
+0V85_GTR: J15.4; also elsewhere on the board
+0V85_PS: J15.3; also elsewhere on the board
+1V2: J14.3; also elsewhere on the board
+1V2_GTH: J14.6; also elsewhere on the board
+1V2_PS: J14.5; also elsewhere on the board
+1V8: J14.10; also elsewhere on the board
+1V8_CLEAN: J14.7; also elsewhere on the board
+1V8_MGTRAVTT: J14.8; also elsewhere on the board
+1V8_VCCADC: J14.9; also elsewhere on the board
+1V25: J15.1; also elsewhere on the board
+2V5: J15.2; also elsewhere on the board
+3V3: J14.4; also elsewhere on the board
+3V3_ANA: J7.5; also elsewhere on the board
+3V3_LMX: J14.2; also elsewhere on the board
+5V_ANA: J7.7; also elsewhere on the board
+5V_SYS: J7.4; also elsewhere on the board
+15V_MAIN: J7.3; also elsewhere on the board
GND: J16.3, J16.4, J16.5, J16.6, J16.7, J16.8, J16.9, J16.10; also elsewhere on the board
I2C_SCL1_4: J15.5; also elsewhere on the board
I2C_SCL1_5: J15.7; also elsewhere on the board
I2C_SCL1_6: J15.9; also elsewhere on the board
I2C_SCL1_7: J16.1; also elsewhere on the board
I2C_SDA1_4: J15.6; also elsewhere on the board
I2C_SDA1_5: J15.8; also elsewhere on the board
I2C_SDA1_6: J15.10; also elsewhere on the board
I2C_SDA1_7: J16.2; also elsewhere on the board
PS_POR_B: J7.8; also elsewhere on the board
RAW_BAT: J7.2; also elsewhere on the board
VBUS: J7.1; also elsewhere on the board

Notes on the sheet:
SECTION 12 : Expansion
