damnitzhemanth-oss/FusionBoard/PCB/Devboard.kicad_pcb

## KiCad design PCB/Devboard.kicad_pcb (continued)

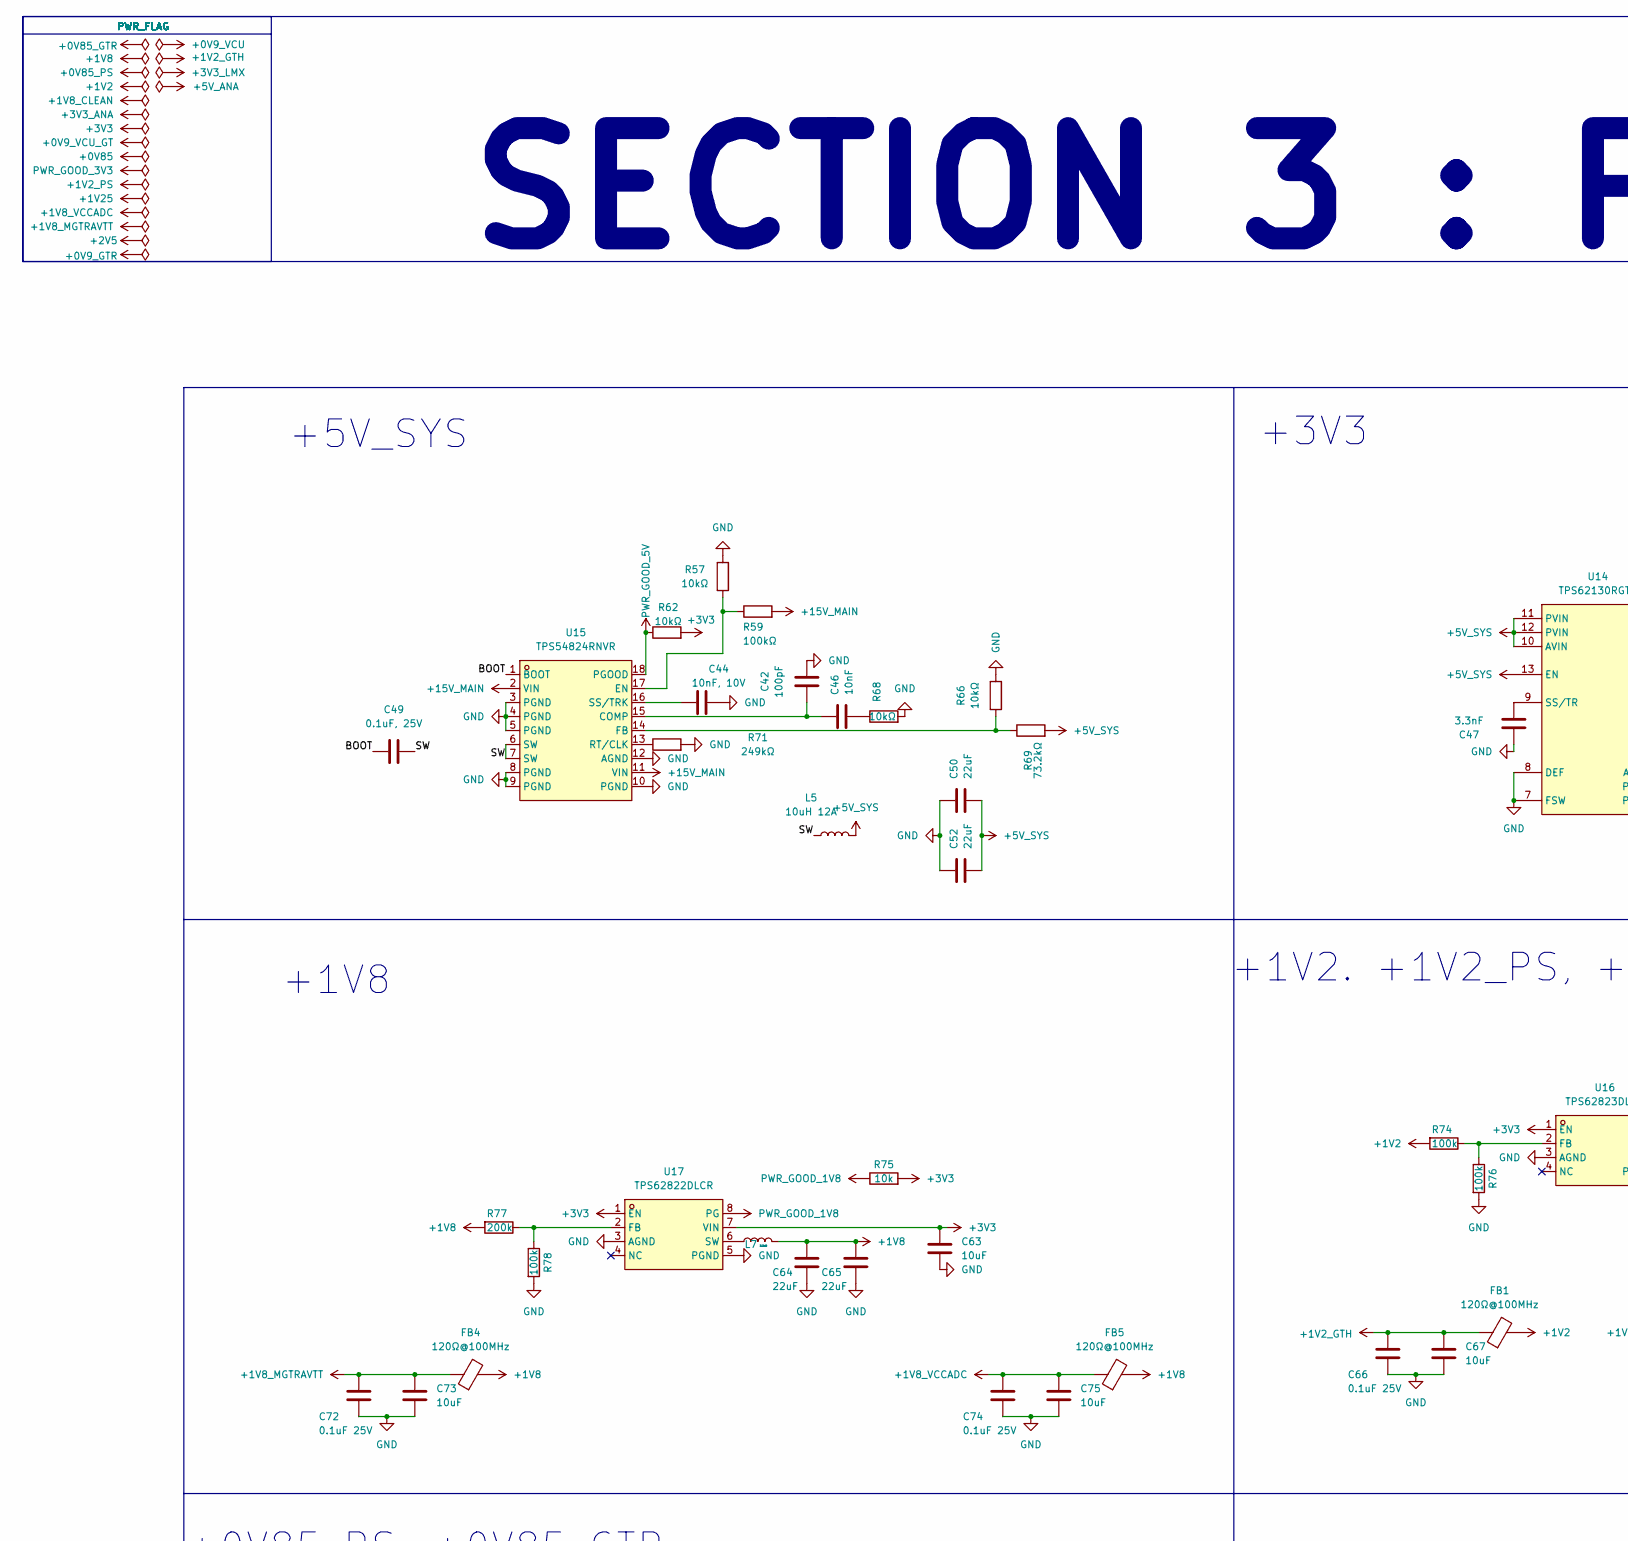
[picture p45: schematic 03_Power_Tree.kicad_sch, part in row 1, column 1]

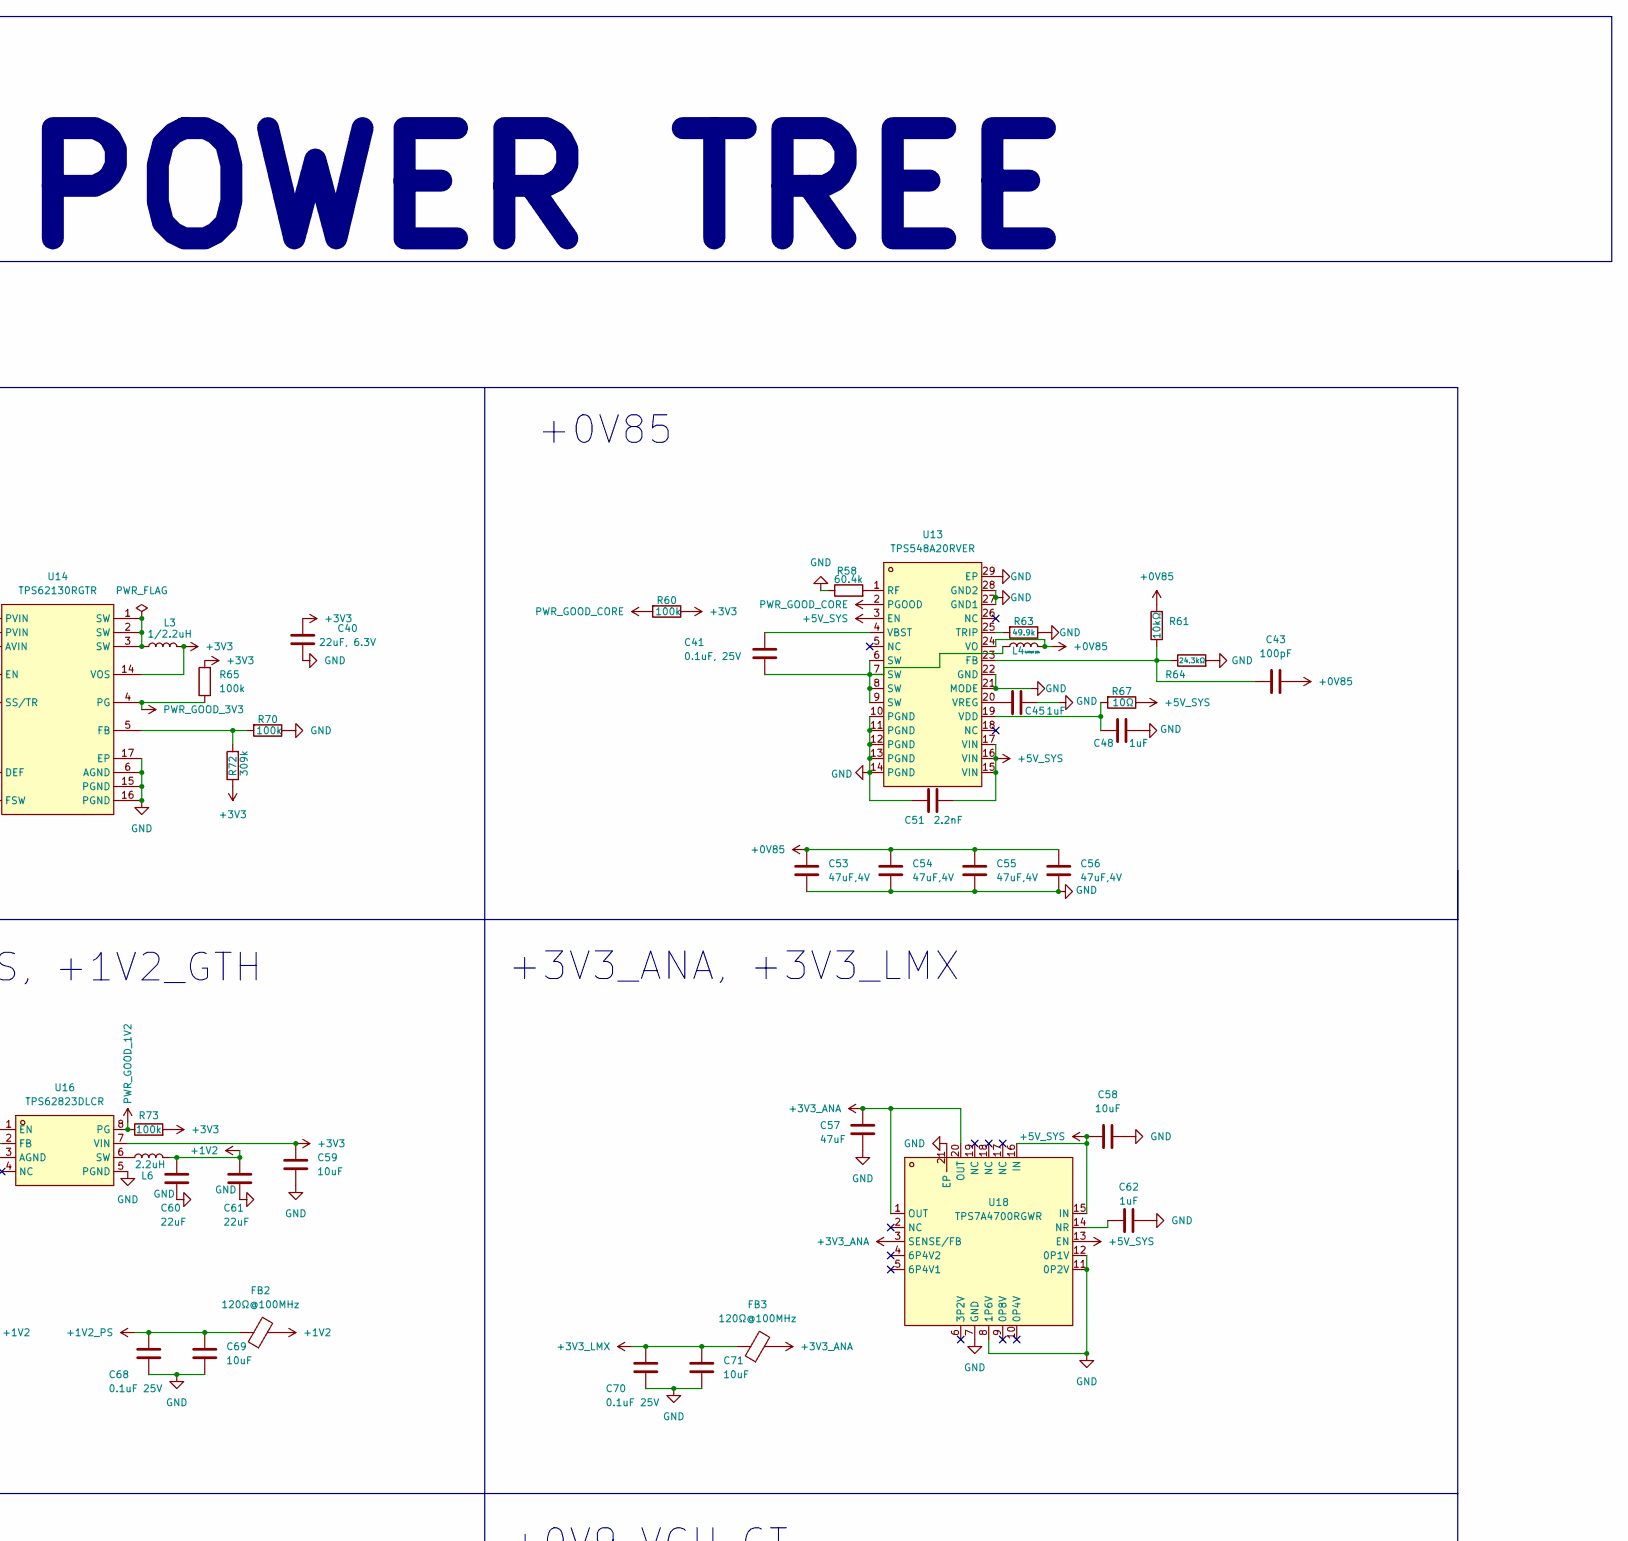
[picture p46: schematic 03_Power_Tree.kicad_sch, part in row 1, column 2]

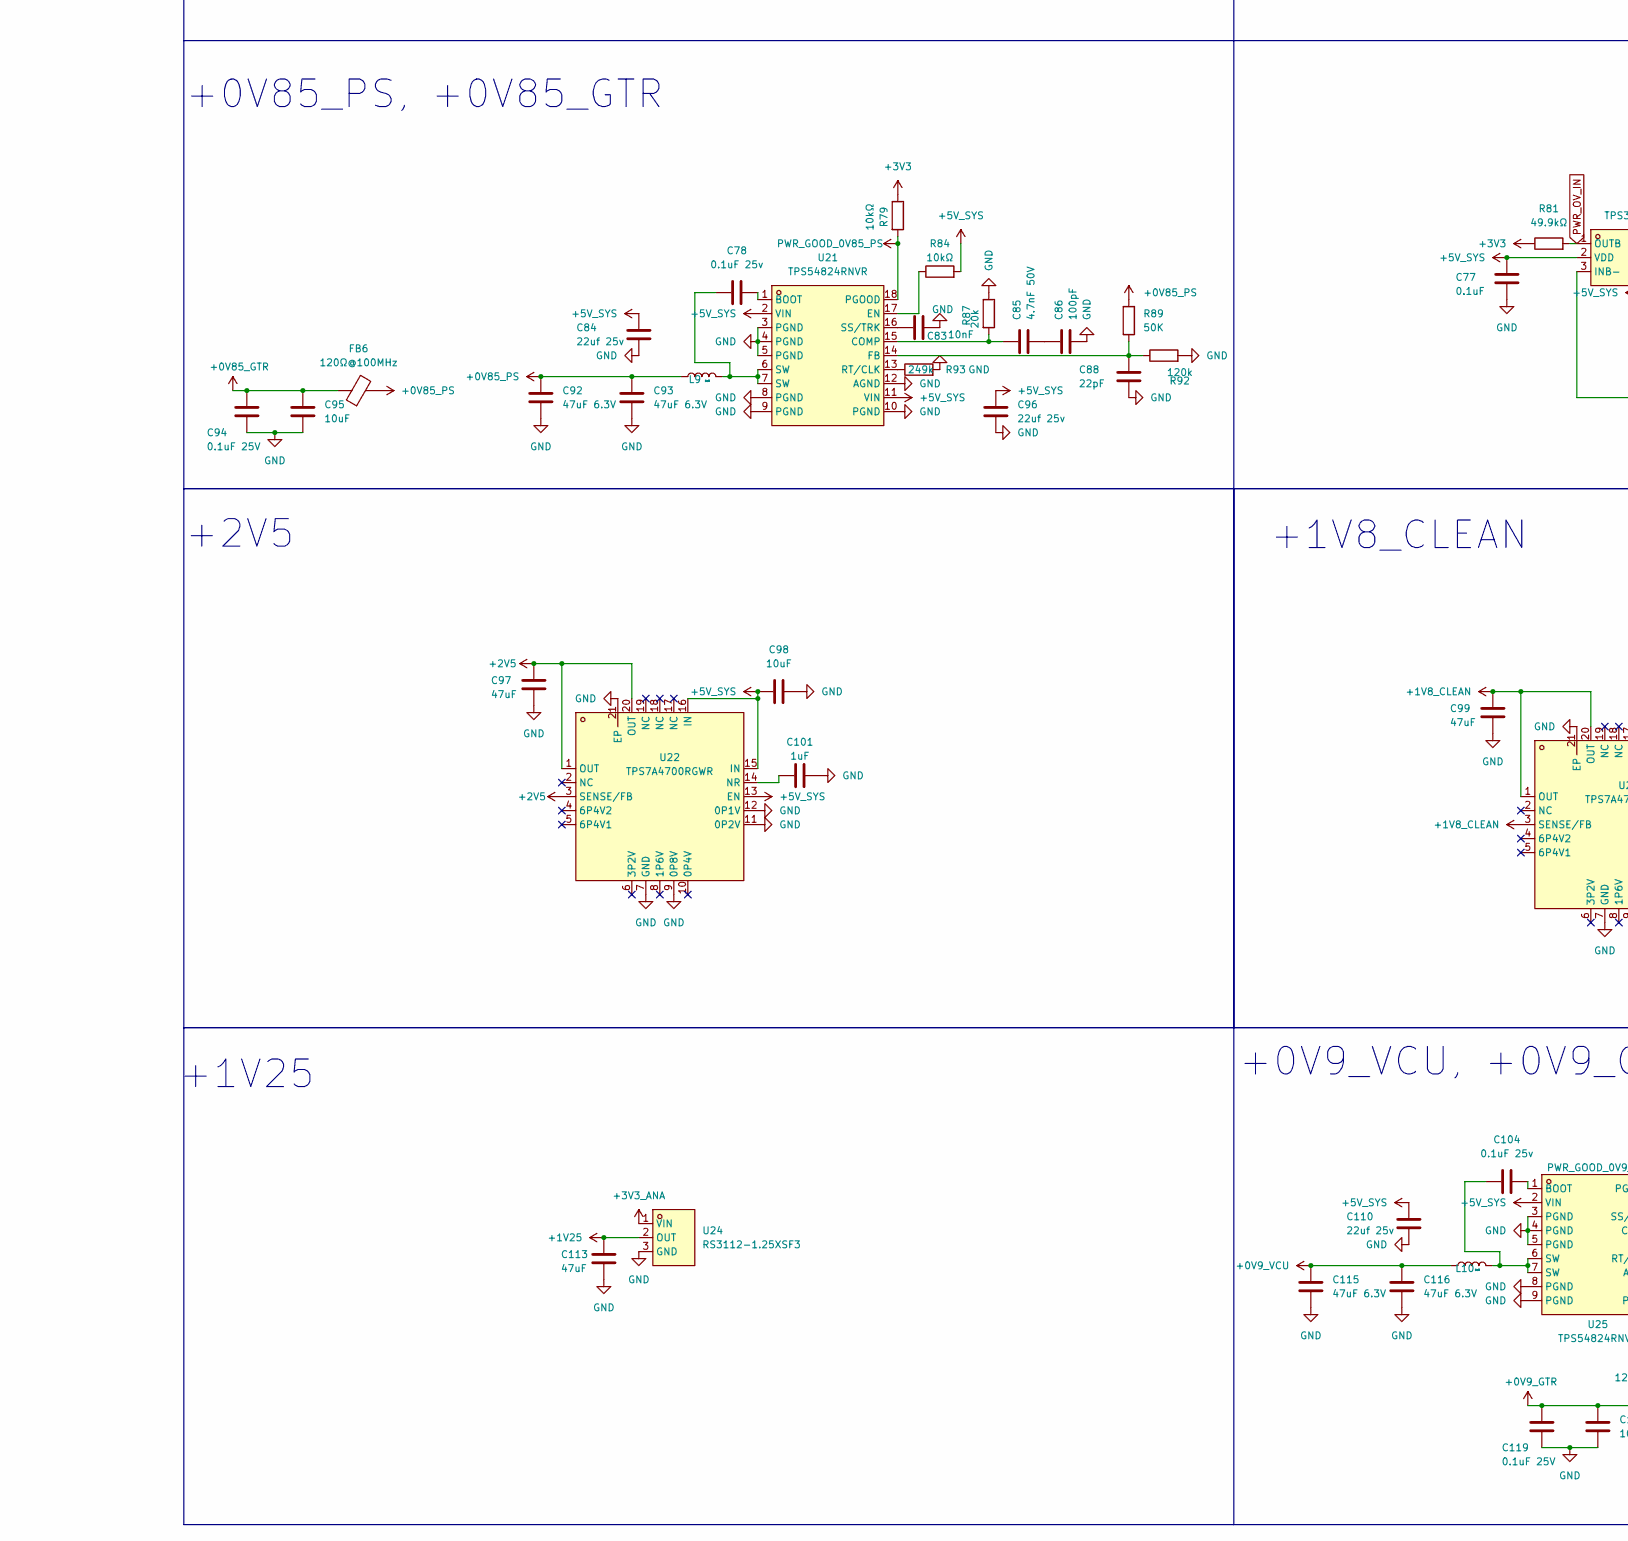
[picture p47: schematic 03_Power_Tree.kicad_sch, part in row 2, column 1]

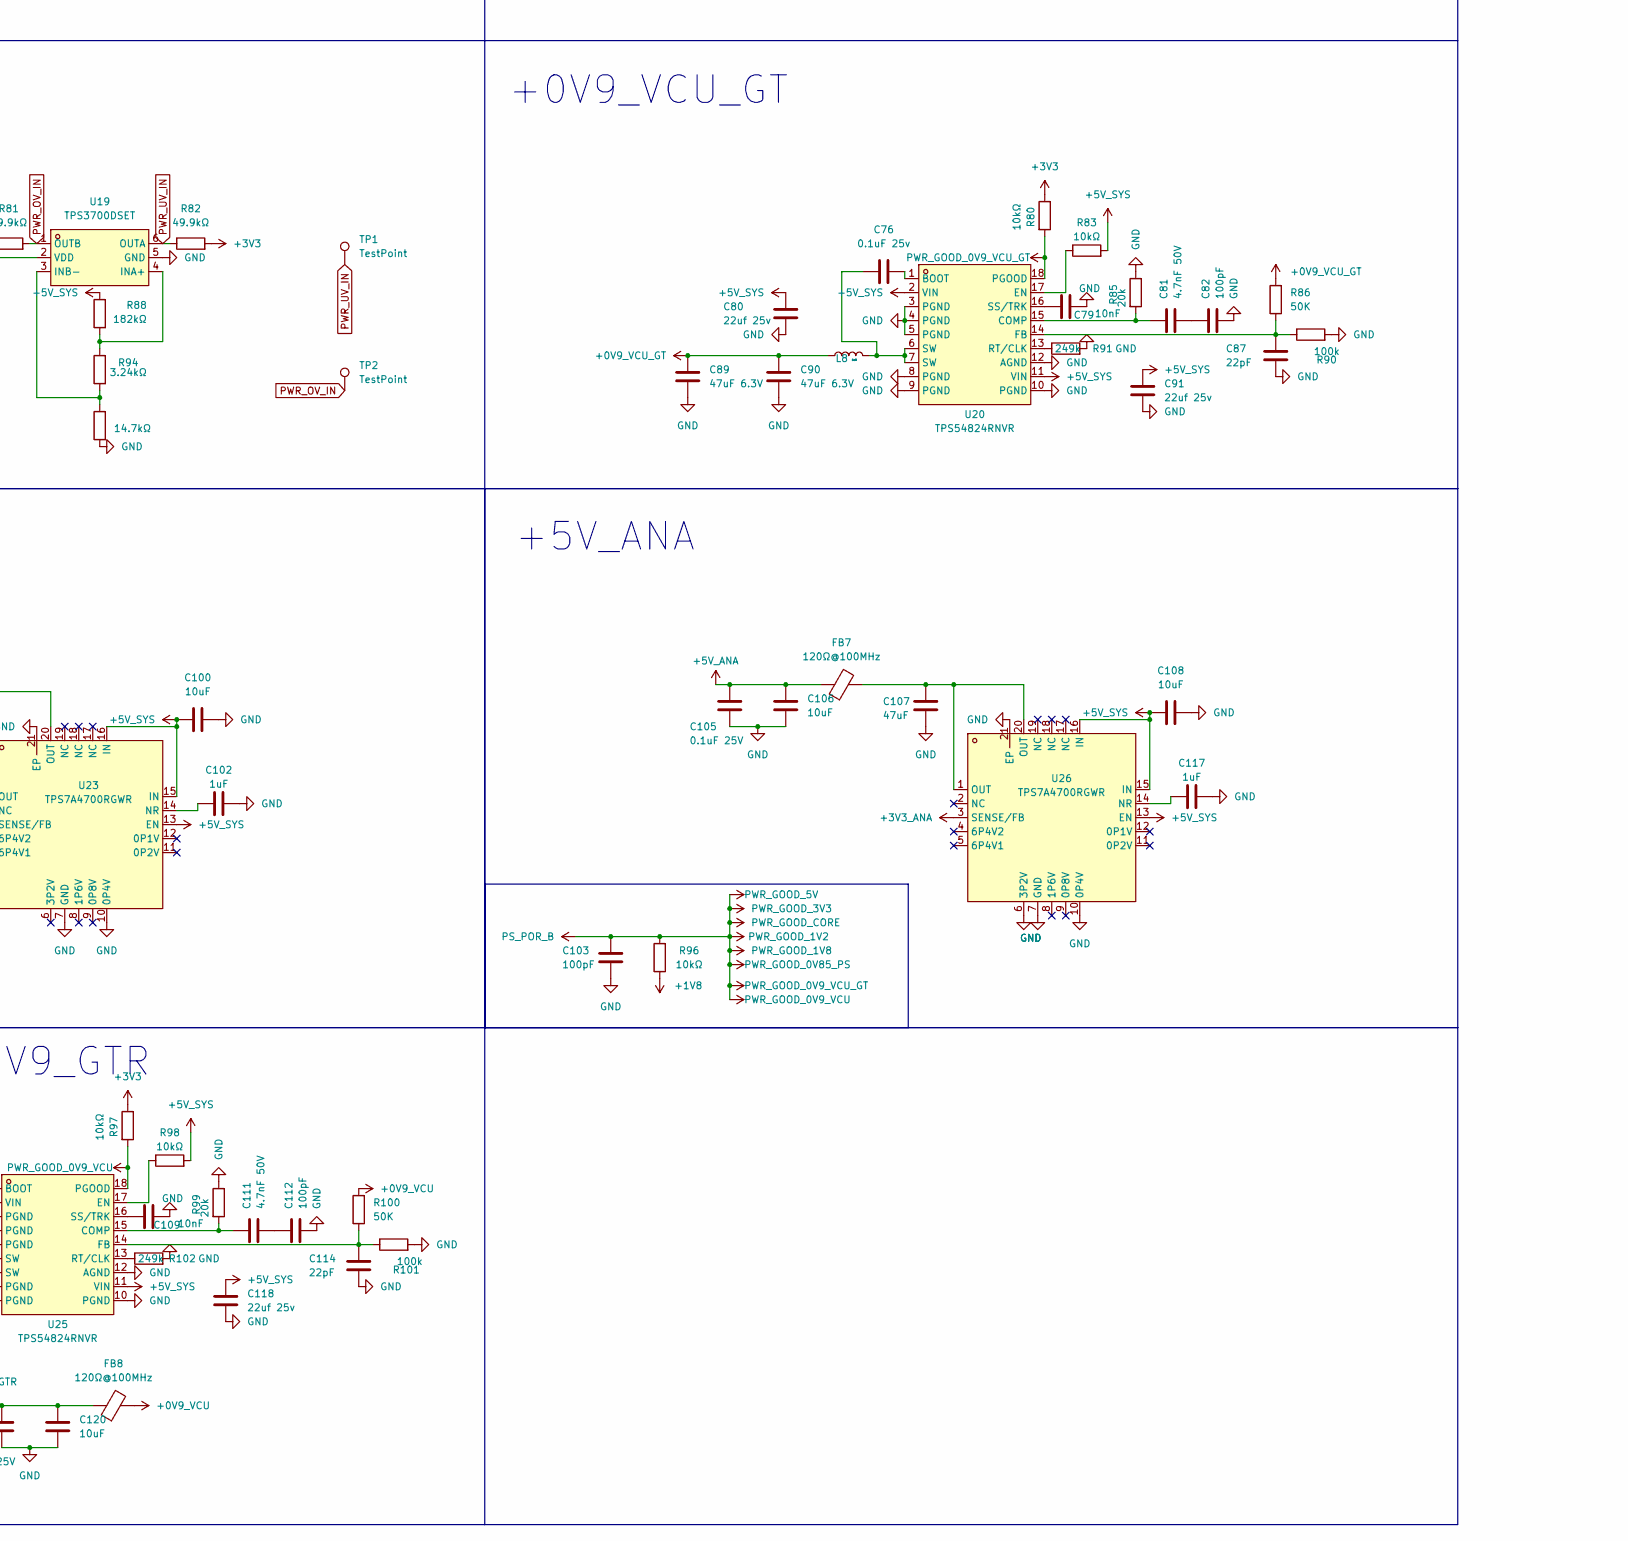
[picture p48: schematic 03_Power_Tree.kicad_sch, part in row 2, column 2]

Parts:
C40: 22uF, 6.3V; C_0805_2012Metric
C41, C49: 0.1uF, 25V; C_0402_1005Metric
C42, C43, C82, C86, C103, C112: 100pF; C_0402_1005Metric
C44: 10nF, 10V; C_0402_1005Metric
C45, C48, C62, C101, C102, C117: 1uF; C_0402_1005Metric
C46, C79, C83, C109: 10nF; C_0402_1005Metric
C47: 3.3nF; C_0402_1005Metric
C50, C52, C60, C61, C64, C65: 22uF; C_0805_2012Metric
C51: 2.2nF; C_0402_1005Metric
C53, C54, C55, C56: 47uF,4V; C_1206_3216Metric
C57, C97, C99, C107, C113: 47uF; C_1206_3216Metric
C58, C59, C63, C67, C69, C71, C73, C75, C95, C98, C100, C106, C108, C120: 10uF; C_0402_1005Metric
C66, C68, C70, C72, C74, C94, C105, C119: 0.1uF 25V; C_0402_1005Metric
C76, C78, C104: 0.1uF 25v; C_0402_1005Metric
C77: 0.1uF; C_0402_1005Metric
C80, C84, C91, C96, C110, C118: 22uf 25v; C_0805_2012Metric
C81, C85, C111: 4.7nF 50V; C_0402_1005Metric
C87, C88, C114: 22pF; C_0402_1005Metric
C89, C90, C92, C93, C115, C116: 47uF 6.3V; C_1206_3216Metric
FB1, FB2, FB3, FB4, FB5, FB6, FB7, FB8: 120Ω@100MHz; L_01005_0402Metric
L3: 1/2.2uH; INDUCTOR
L4: 0.47uH 15A; INDUCTOR
L5: 10uH 12A; INDUCTOR
L6, L7: 2.2uH; INDUCTOR
L8, L9, L10: 1uH; INDUCTOR
R57, R61, R62, R66, R68, R79, R80, R83, R84, R96, R97, R98: 10kΩ; R_0402_1005Metric
R58: 60.4k; R_0402_1005Metric
R59: 100kΩ; R_0402_1005Metric
R60, R65, R70, R73, R74, R76, R78, R90, R101: 100k; R_0402_1005Metric
R63: 49.9k; R_0402_1005Metric
R64: 24.3kΩ; R_0402_1005Metric
R67: 10Ω; R_0402_1005Metric
R69: 73.2kΩ; R_0402_1005Metric
R71: 249kΩ; R_0402_1005Metric
R72: 309k; R_0402_1005Metric
R75: 10k; R_0402_1005Metric
R77: 200k; R_0402_1005Metric
R81, R82: 49.9kΩ; R_0402_1005Metric
R85, R87, R99: 20k; R_0402_1005Metric
R86, R89, R100: 50K; R_0402_1005Metric
R88: 182kΩ; R_0402_1005Metric
R91, R93, R102: 249k; R_0402_1005Metric
R92: 120k; R_0402_1005Metric
R94: 3.24kΩ; R_0402_1005Metric
R95: 14.7kΩ; R_0402_1005Metric
TP1, TP2: TestPoint; TestPoint_Pad_D1.0mm
U13: TPS548A20RVER; VQFN-CLIP-28_L4.5-W3.5-P0.40-BL-EP; MPN TPS548A20RVER; LCSC Part C468255
U14: TPS62130RGTR; QFN-16_L3.0-W3.0-P0.50-TL-EP1.7; MPN TPS62130RGTR; LCSC Part C43590
U15, U20, U21, U25: TPS54824RNVR; VQFN-18_L3.5-W3.5-P0.50-BL_TPS54824RNVR; MPN TPS54824RNVR; LCSC Part C2070614
U16: TPS62823DLCR; VSON-8_L2.0-W1.5-P0.50-BL; MPN TPS62823DLCR; LCSC Part C2693497
U17: TPS62822DLCR; VSON-8_L2.0-W1.5-P0.50-BL; MPN TPS62822DLCR; LCSC Part C473385
U18, U22, U23, U26: TPS7A4700RGWR; VQFN-20_L5.0-W5.0-P0.65-TL-EP; MPN TPS7A4700RGWR; LCSC Part C114839
U19: TPS3700DSET; WSON-6_L1.5-W1.5-P0.50-TL; MPN TPS3700DSET; LCSC Part C2869244
U24: RS3112-1.25XSF3; SOT-23-3_L2.9-W1.3-P0.95-LS2.4-BR; MPN RS3112-1.25XSF3; LCSC Part C19269195

Connections:
+0V9_GTR: C119.1, C120.2, FB8.1; also elsewhere on the board
+0V9_VCU: C115.1, C116.1, FB8.2, L10.1, R100.2; also elsewhere on the board
+0V9_VCU_GT: C89.1, C90.1, L8.1, R86.2; also elsewhere on the board
+0V85: C43.2, C53.1, C54.1, C55.1, C56.1, L4.2, R61.2, U13.24 (VO); also elsewhere on the board
+0V85_GTR: C94.1, C95.2, FB6.1; also elsewhere on the board
+0V85_PS: C92.1, C93.1, FB6.2, L9.1, R89.2; also elsewhere on the board
+1V2: C60.1, C61.1, FB1.2, FB2.2, L6.2, R74.2; also elsewhere on the board
+1V2_GTH: C66.1, C67.2, FB1.1; also elsewhere on the board
+1V2_PS: C68.1, C69.2, FB2.1; also elsewhere on the board
+1V8: C64.1, C65.1, FB4.2, FB5.2, L7.2, R77.2, R96.1; also elsewhere on the board
+1V8_CLEAN: C99.1, U23.1 (OUT), U23.3 (SENSE/FB), U23.20 (OUT); also elsewhere on the board
+1V8_MGTRAVTT: C72.1, C73.2, FB4.1; also elsewhere on the board
+1V8_VCCADC: C74.1, C75.2, FB5.1; also elsewhere on the board
+1V25: C113.1, U24.2 (OUT); also elsewhere on the board
+2V5: C97.1, U22.1 (OUT), U22.3 (SENSE/FB), U22.20 (OUT); also elsewhere on the board
+3V3: C40.1, C59.1, C63.1, L3.2, R60.1, R62.2, R65.2, R72.1, R73.2, R75.2, R79.1, R80.1, R81.1, R82.2, R97.1, U14.14 (VOS), U16.1 (EN), U16.7 (VIN), U17.1 (EN), U17.7 (VIN); also elsewhere on the board
+3V3_ANA: C57.1, FB3.2, U18.1 (OUT), U18.3 (SENSE/FB), U18.20 (OUT), U24.1 (VIN), U26.3 (SENSE/FB); also elsewhere on the board
+3V3_LMX: C70.1, C71.2, FB3.1; also elsewhere on the board
+5V_ANA: C105.1, C106.2, FB7.1; also elsewhere on the board
+5V_SYS: C50.2, C51.2, C52.2, C58.1, C77.1, C80.1, C84.1, C91.1, C96.1, C98.1, C100.1, C108.1, C110.1, C118.1, L5.2, R67.1, R69.2, R83.2, R84.2, R88.1, R98.2, U13.3 (EN), U13.15 (VIN), U13.16 (VIN), U13.17 (VIN), U14.10 (AVIN), U14.11 (PVIN), U14.12 (PVIN), U14.13 (EN), U18.13 (EN), U18.15 (IN), U18.16 (IN), U19.2 (VDD), U20.2 (VIN), U20.11 (VIN), U21.2 (VIN), U21.11 (VIN), U22.13 (EN), U22.15 (IN), U22.16 (IN), U23.13 (EN), U23.15 (IN), U23.16 (IN), U25.2 (VIN), U25.11 (VIN), U26.13 (EN), U26.15 (IN), U26.16 (IN); also elsewhere on the board
+15V_MAIN: R59.2, U15.2 (VIN), U15.11 (VIN); also elsewhere on the board
/Power Tree/BOOT: C49.1, U15.1 (BOOT)
/Power Tree/SW: C49.2, L5.1, U15.6 (SW), U15.7 (SW)
GND: C40.2, C42.2, C44.2, C45.2, C47.1, C48.2, C50.1, C51.1, C52.1, C53.2, C54.2, C55.2, C56.2, C57.2, C58.2, C59.2, C60.2, C61.2, C62.2, C63.2, C64.2, C65.2, C66.2, C67.1, C68.2, C69.1, C70.2, C71.1, C72.2, C73.1, C74.2, C75.1, C77.2, C79.2, C80.2, C82.2, C83.2, C84.2, C86.2, C87.2, C88.2, C89.2, C90.2, C91.2, C92.2, C93.2, C94.2, C95.1, C96.2, C97.2, C98.2, C99.2, C100.2, C101.2, C102.2, C103.1, C105.2, C106.1, C107.2, C108.2, C109.2, C110.2, C112.2, C113.2, C114.2, C115.2, C116.2, C117.2, C118.2, C119.2, C120.1, R57.2, R58.1, R63.1, R64.2, R66.2, R68.2, R70.1, R71.2, R76.2, R78.2, R85.1, R87.1, R90.2, R91.2, R92.2, R93.2, R95.2, R99.1, R101.2, R102.2, U13.10 (PGND), U13.11 (PGND), U13.12 (PGND), U13.13 (PGND), U13.14 (PGND), U13.21 (MODE), U13.22 (GND), U13.27 (GND1), U13.28 (GND2), U13.29 (EP), U14.6 (AGND), U14.7 (FSW), U14.8 (DEF), U14.15 (PGND), U14.16 (PGND), U14.17 (EP), U15.3 (PGND), U15.4 (PGND), U15.5 (PGND), U15.8 (PGND), U15.9 (PGND), U15.10 (PGND), U15.12 (AGND), U16.3 (AGND), U16.5 (PGND), U17.3 (AGND), U17.5 (PGND), U18.7 (GND), U18.8 (1P6V), U18.11 (0P2V), U18.12 (0P1V), U18.21 (EP), U19.5 (GND), U20.3 (PGND), U20.4 (PGND), U20.5 (PGND), U20.8 (PGND), U20.9 (PGND), U20.10 (PGND), U20.12 (AGND), U21.3 (PGND), U21.4 (PGND), U21.5 (PGND), U21.8 (PGND), U21.9 (PGND), U21.10 (PGND), U21.12 (AGND), U22.7 (GND), U22.9 (0P8V), U22.11 (0P2V), U22.12 (0P1V), U22.21 (EP), U23.7 (GND), U23.10 (0P4V), U23.21 (EP), U24.3 (GND), U25.3 (PGND), U25.4 (PGND), U25.5 (PGND), U25.8 (PGND), U25.9 (PGND), U25.10 (PGND), U25.12 (AGND), U26.6 (3P2V), U26.7 (GND), U26.10 (0P4V), U26.21 (EP); also elsewhere on the board
unnamed: C41.1, L4.1, U13.6 (SW), U13.7 (SW), U13.8 (SW), U13.9 (SW)
unnamed: C46.2, R68.1
unnamed: C76.1, L8.2, U20.6 (SW), U20.7 (SW)
unnamed: C78.1, L9.2, U21.6 (SW), U21.7 (SW)
unnamed: C81.2, C82.1
unnamed: C85.2, C86.1
unnamed: C104.1, L10.2, U25.6 (SW), U25.7 (SW)
unnamed: C107.1, FB7.2, U26.1 (OUT), U26.20 (OUT)
unnamed: C111.2, C112.1
unnamed: L3.1, U14.1 (SW), U14.2 (SW), U14.3 (SW)
unnamed: C43.1, R61.1, R64.1, U13.23 (FB)
unnamed: R58.2, U13.1 (RF)
unnamed: R63.2, U13.25 (TRIP)
unnamed: C41.2, U13.4 (VBST)
unnamed: C48.1, R67.2, U13.19 (VDD)
unnamed: C45.1, U13.20 (VREG)
unnamed: R70.2, R72.2, U14.5 (FB)
unnamed: C47.2, U14.9 (SS/TR)
unnamed: C42.1, C46.1, U15.15 (COMP)
unnamed: R57.1, R59.1, U15.17 (EN)
unnamed: R66.1, R69.1, U15.14 (FB)
unnamed: R71.1, U15.13 (RT/CLK)
unnamed: C44.1, U15.16 (SS/TRK)
unnamed: R74.1, R76.1, U16.2 (FB)
unnamed: L6.1, U16.6 (SW)
unnamed: R77.1, R78.1, U17.2 (FB)
unnamed: L7.1, U17.6 (SW)
unnamed: C62.1, U18.14 (NR)
unnamed: R88.2, R94.1, U19.4 (INA+)
unnamed: R94.2, R95.1, U19.3 (INB-)
unnamed: C76.2, U20.1 (BOOT)
unnamed: C81.1, R85.2, U20.15 (COMP)
unnamed: R83.1, U20.17 (EN)
unnamed: C87.1, R86.1, R90.1, U20.14 (FB)
unnamed: R91.1, U20.13 (RT/CLK)
unnamed: C79.1, U20.16 (SS/TRK)
unnamed: C78.2, U21.1 (BOOT)
unnamed: C85.1, R87.2, U21.15 (COMP)
unnamed: R84.1, U21.17 (EN)
unnamed: C88.1, R89.1, R92.1, U21.14 (FB)
unnamed: R93.1, U21.13 (RT/CLK)
unnamed: C83.1, U21.16 (SS/TRK)
unnamed: C101.1, U22.14 (NR)
unnamed: C102.1, U23.14 (NR)
unnamed: C104.2, U25.1 (BOOT)
unnamed: C111.1, R99.2, U25.15 (COMP)
unnamed: R98.1, U25.17 (EN)
unnamed: C114.1, R100.1, R101.1, U25.14 (FB)
unnamed: R102.1, U25.13 (RT/CLK)
unnamed: C109.1, U25.16 (SS/TRK)
unnamed: C117.1, U26.14 (NR)
PS_POR_B: C103.2, R60.2, R62.1, R65.1, R73.1, R75.1, R79.2, R80.2, R96.2, R97.2, U13.2 (PGOOD), U14.4 (PG), U15.18 (PGOOD), U16.8 (PG), U17.8 (PG), U20.18 (PGOOD), U21.18 (PGOOD), U25.18 (PGOOD); also elsewhere on the board
PWR_OV_IN: R81.2, TP2.1 (1_1), U19.1 (OUTB)
PWR_UV_IN: R82.1, TP1.1 (1_1), U19.6 (OUTA)

Notes on the sheet:
+1V8
+0V9_VCU, +0V9_GTR
+1V8_CLEAN
+3V3_ANA, +3V3_LMX
+1V25
+5V_SYS
+3V3
+0V85_PS, +0V85_GTR
SECTION 3 : POWER TREE
+1V2. +1V2_PS, +1V2_GTH
+0V85
+2V5
+0V9_VCU_GT
+5V_ANA

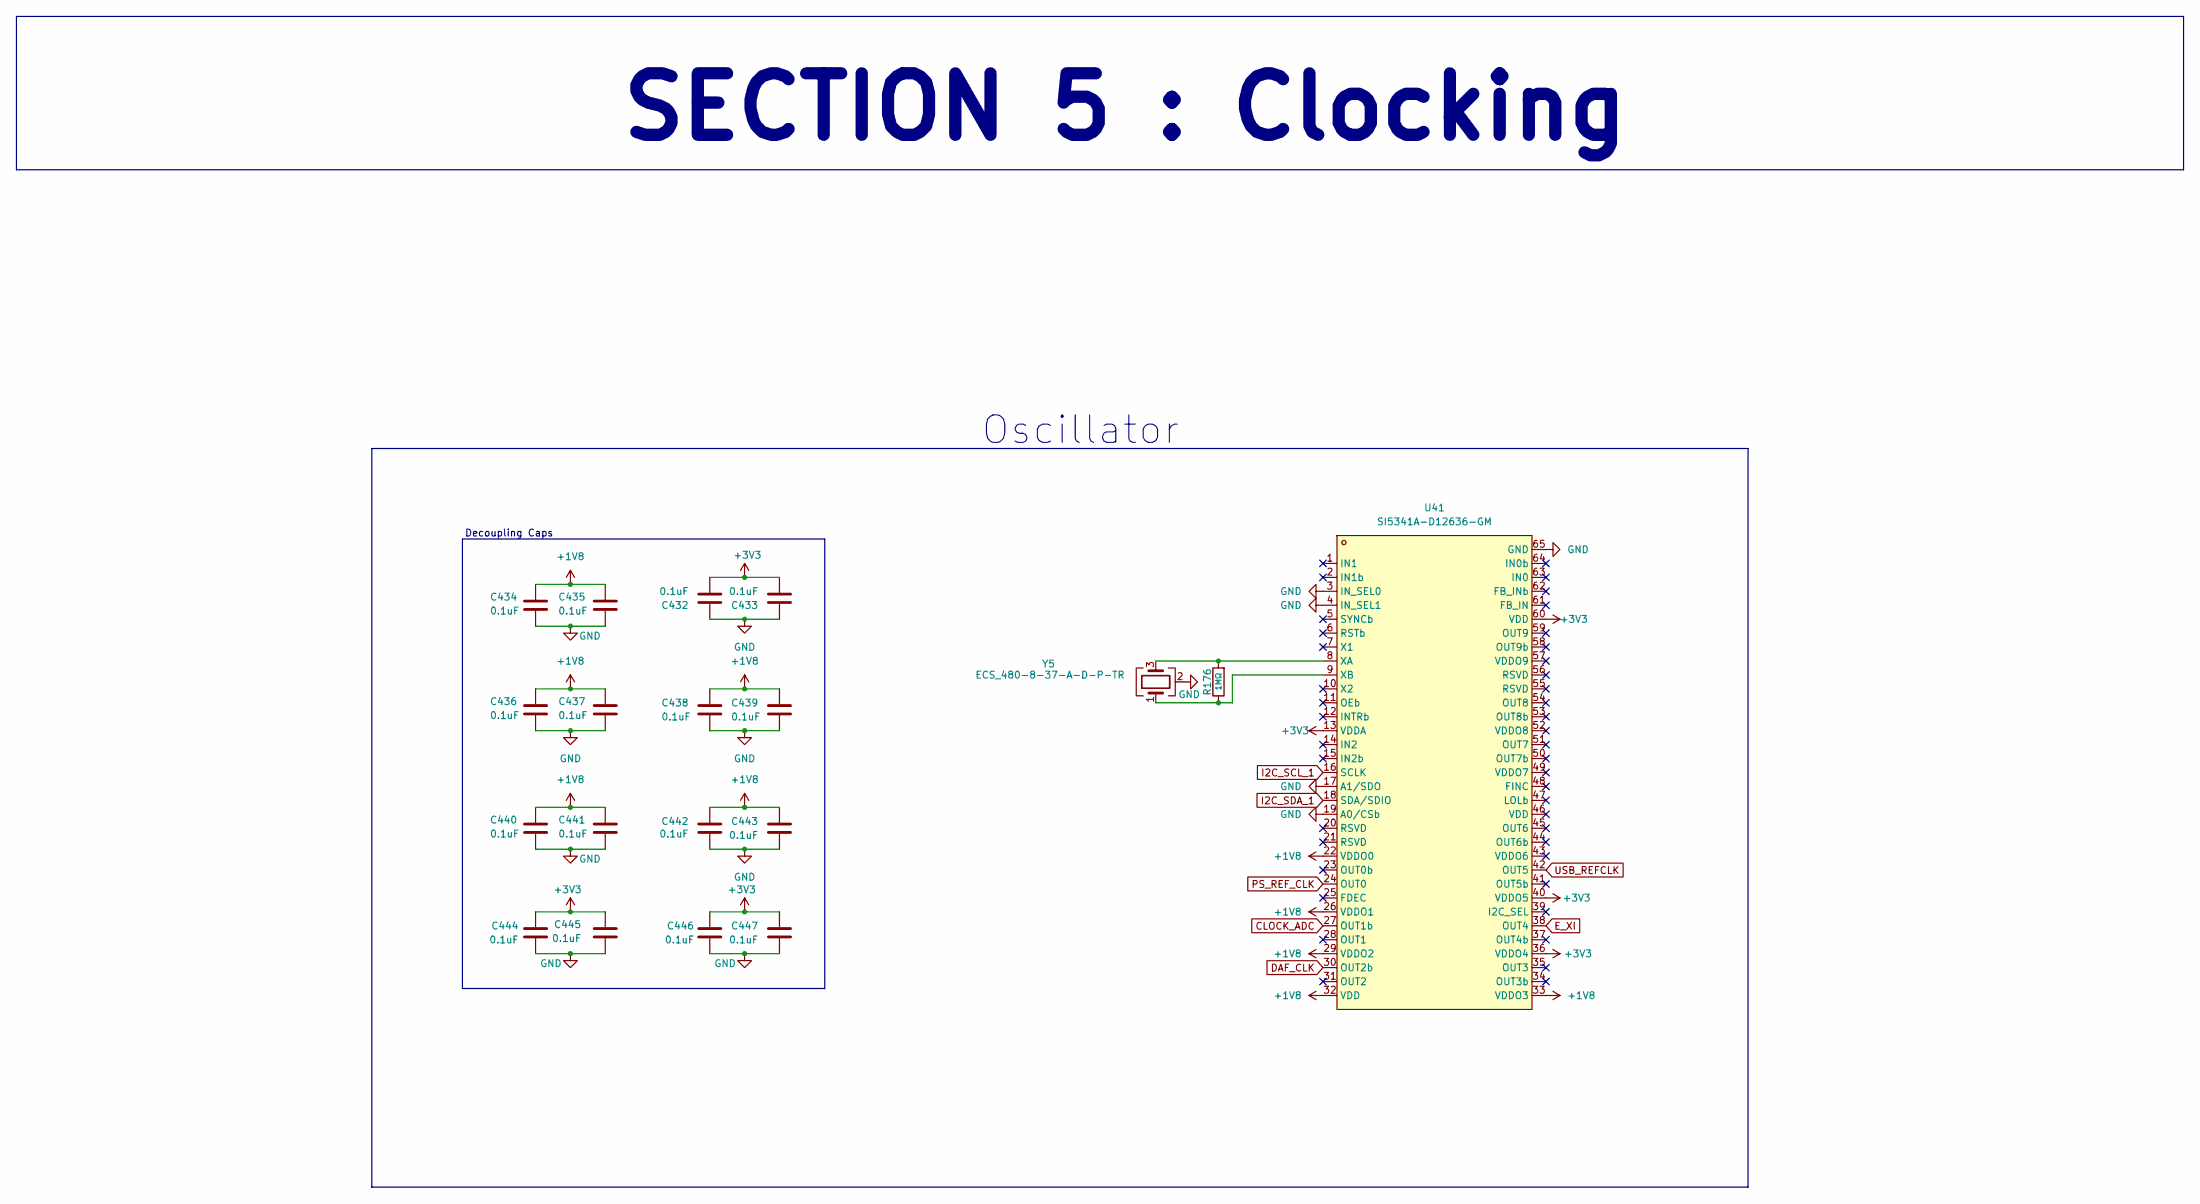
[picture p49: schematic 05_Clocking.kicad_sch]

Parts:
C432, C433, C434, C435, C436, C437, C438, C439, C440, C441, C442, C443, C444, C445, C446, C447: 0.1uF; C_0402_1005Metric
R176: 1MΩ; R_0402_1005Metric
U41: SI5341A-D12636-GM; QFN-64_L9.0-W9.0-P0.50-TL-EP5.2; MPN SI5341A-D12636-GM; LCSC Part C3609093
Y5: ECS_480-8-37-A-D-P-TR; Crystal_SMD_3225-4Pin_3.2x2.5mm

Connections:
+1V8: C434.1, C435.1, C436.1, C437.1, C438.1, C439.1, C440.1, C441.1, C442.1, C443.1, U41.22 (VDDO0), U41.26 (VDDO1), U41.29 (VDDO2), U41.32 (VDD), U41.33 (VDDO3); also elsewhere on the board
+3V3: C432.2, C433.2, C444.1, C445.1, C446.1, C447.1, U41.13 (VDDA), U41.36 (VDDO4), U41.40 (VDDO5), U41.60 (VDD); also elsewhere on the board
CLOCK_ADC: U41.27 (OUT1b); also elsewhere on the board
DAF_CLK: U41.30 (OUT2b); also elsewhere on the board
E_XI: U41.38 (OUT4); also elsewhere on the board
GND: C432.1, C433.1, C434.2, C435.2, C436.2, C437.2, C438.2, C439.2, C440.2, C441.2, C442.2, C443.2, C444.2, C445.2, C446.2, C447.2, U41.3 (IN_SEL0), U41.4 (IN_SEL1), U41.17 (A1/SDO), U41.19 (A0/CSb), U41.65 (GND), Y5.2 (G), Y5.4 (G); also elsewhere on the board
I2C_SCL_1: U41.16 (SCLK); also elsewhere on the board
I2C_SDA_1: U41.18 (SDA/SDIO); also elsewhere on the board
unnamed: R176.2, U41.8 (XA), Y5.3
unnamed: R176.1, U41.9 (XB), Y5.1
PS_REF_CLK: U41.24 (OUT0); also elsewhere on the board
USB_REFCLK: U41.42 (OUT5); also elsewhere on the board

Notes on the sheet:
Decoupling Caps
SECTION 5 : Clocking
Oscillator
