damnitzhemanth-oss/FusionBoard/PCB/Devboard.kicad_pcb

## KiCad design PCB/Devboard.kicad_pcb (continued)

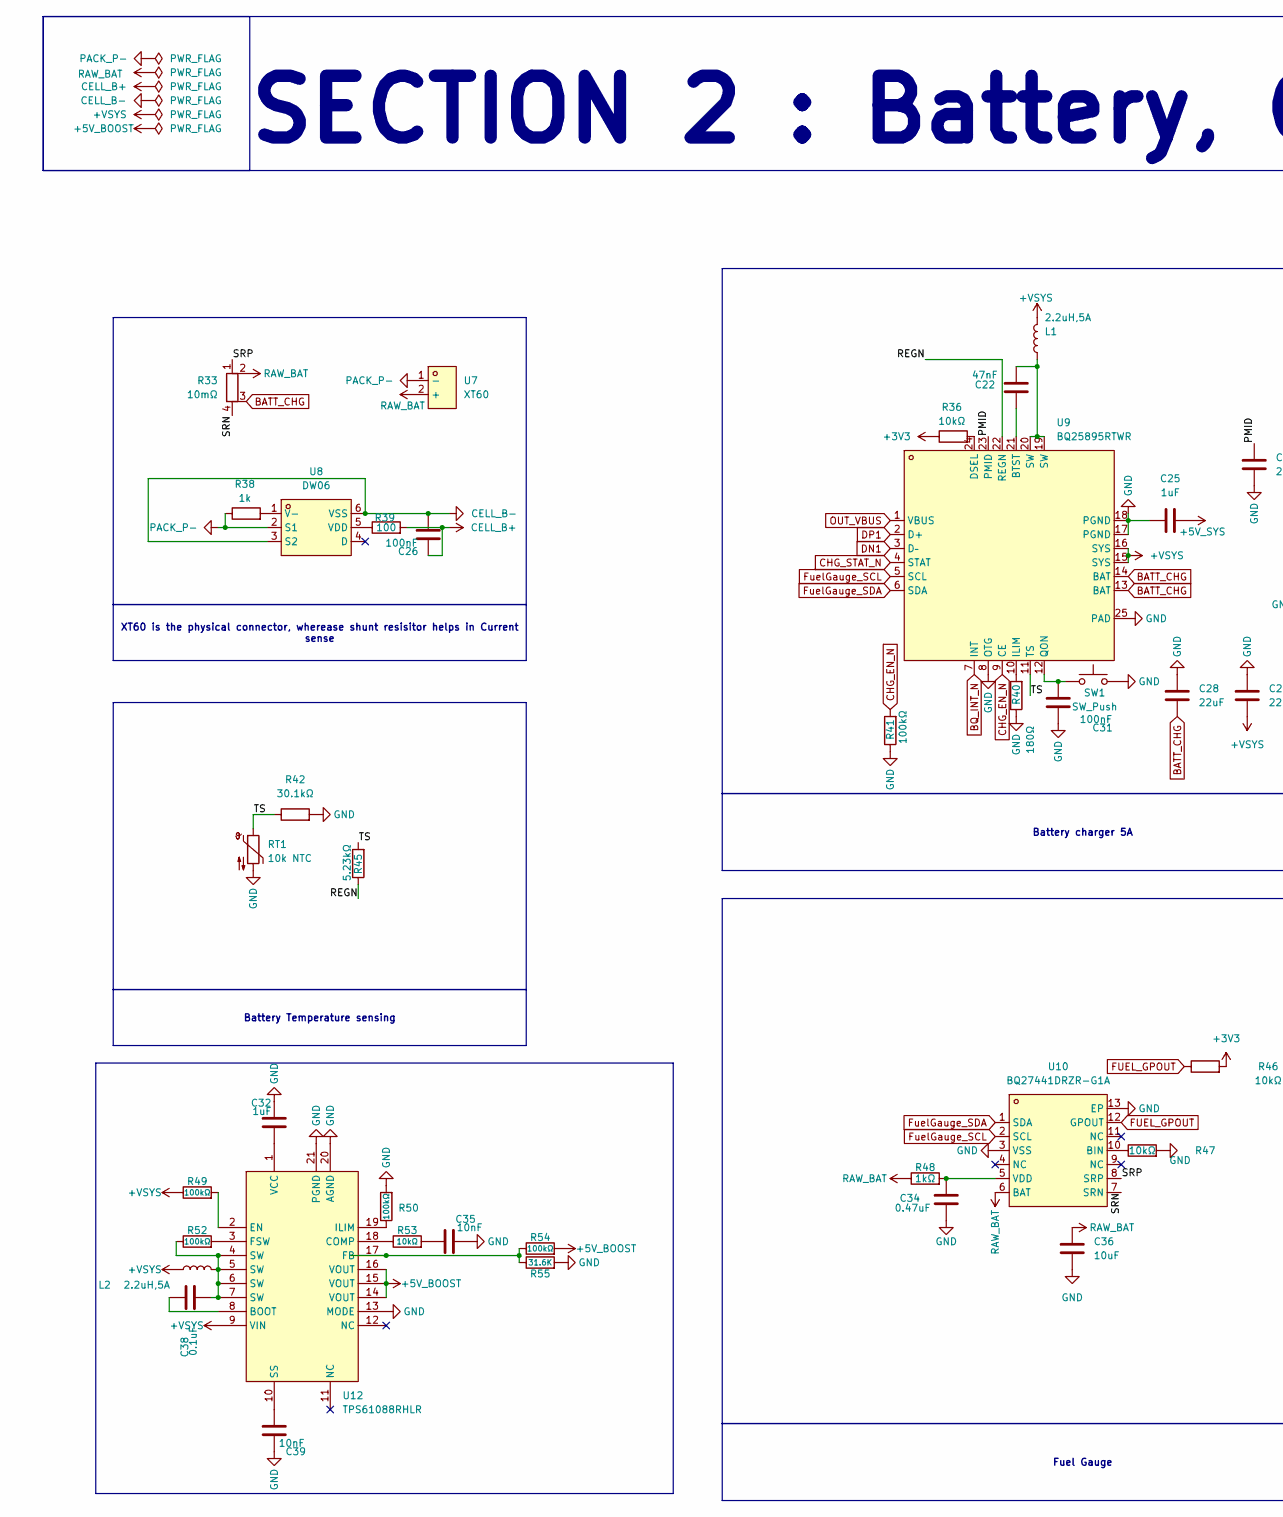
[picture p50: schematic Battery_Charger_FuelGauge.kicad_sch, part in row 1, column 1]

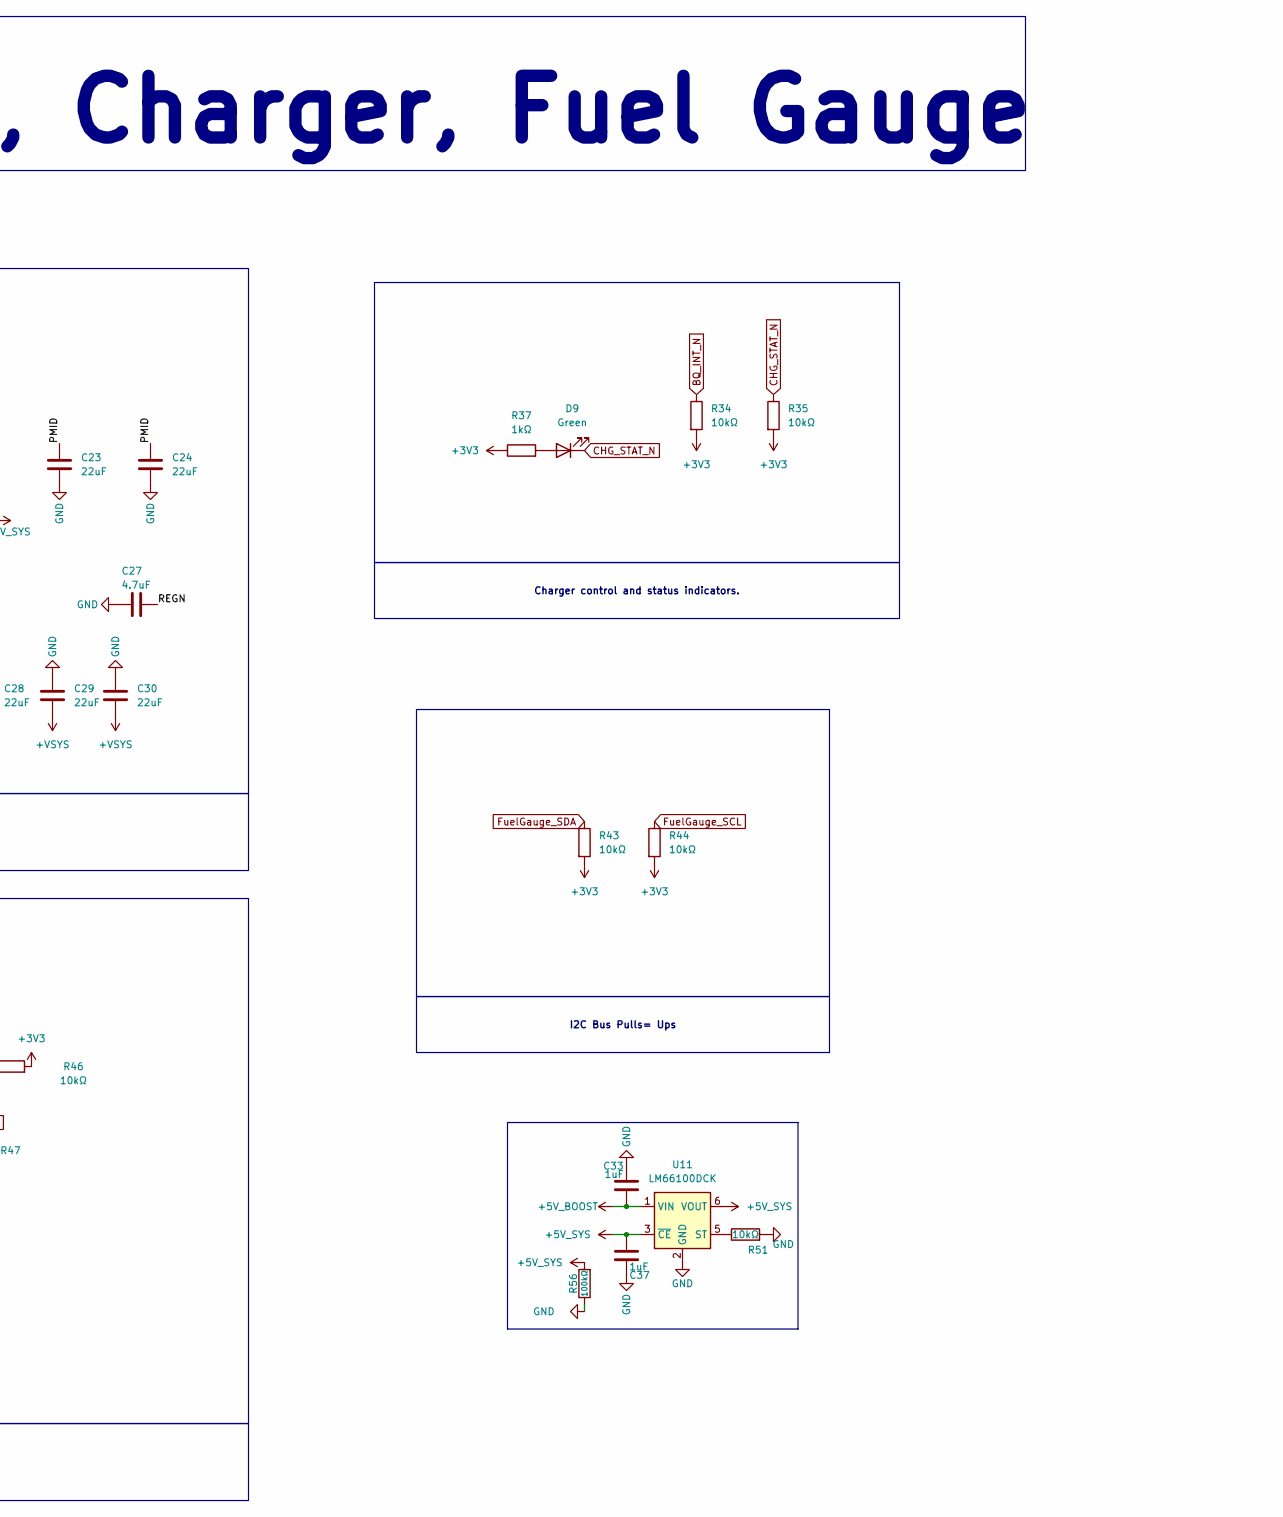
[picture p51: schematic Battery_Charger_FuelGauge.kicad_sch, part in row 1, column 2]

Parts:
C22: 47nF; C_0402_1005Metric
C23, C24, C28, C29, C30: 22uF; C_0805_2012Metric
C25: 1uF; C_0402_1005Metric
C26, C31: 100nF; C_0402_1005Metric
C27: 4.7uF; C_0603_1608Metric
C32, C33, C37: 1uF; C_0805_2012Metric
C34: 0.47uF; C_0402_1005Metric
C35, C39: 10nF; C_0805_2012Metric
C36: 10uF; C_0402_1005Metric
C38: 0.1uF; C_0805_2012Metric
D9: Green; LED_0603_1608Metric
L1, L2: 2.2uH,5A; INDUCTOR
R33: 10mΩ; R_Shunt_Isabellenhuette_BVR4026
R34, R35, R36, R43, R44, R46, R47, R51, R53: 10kΩ; R_0402_1005Metric
R37, R48: 1kΩ; R_0402_1005Metric
R38: 1k; R_0402_1005Metric
R39: 100; R_0402_1005Metric
R40: 180Ω; R_0402_1005Metric
R41, R49, R50, R52, R54, R56: 100kΩ; R_0402_1005Metric
R42: 30.1kΩ; R_0402_1005Metric
R45: 5.23kΩ; R_0402_1005Metric
R55: 31.6K; R_0402_1005Metric
RT1: 10k NTC; R_0603_1608Metric
SW1: SW_Push; SW_SPST_Omron_B3FS-100xP
U7: XT60; CONN-TH_XT60; MPN XT60-M.; LCSC Part C98733
U8: DW06; SOT-23-6_L2.9-W1.6-P0.95-LS2.8-BL; MPN DW06; LCSC Part C917080
U9: BQ25895RTWR; QFN-24_L4.0-W4.0-P0.50-TL-EP2.7; MPN BQ25895RTWR; LCSC Part C80200
U10: BQ27441DRZR-G1A; SON-12_L4.0-W2.5-P0.40-BL-EP; MPN BQ27441DRZR-G1A; LCSC Part C473397
U11: LM66100DCK; SOT-363_SC-70-6
U12: TPS61088RHLR; VQFN-20_L4.6-W3.6-P0.50-BL; MPN TPS61088RHLR; LCSC Part C87357

Connections:
+3V3: R34.2, R35.2, R36.1, R37.1, R43.2, R44.2, R46.2; also elsewhere on the board
+5V_BOOST: C33.2, R54.2, U11.1 (VIN), U12.14 (VOUT), U12.15 (VOUT), U12.16 (VOUT)
+5V_SYS: C25.2, C37.2, R56.2, U11.3 (~CE), U11.6 (VOUT); also elsewhere on the board
+VSYS: C29.1, C30.1, L1.2, L2.1, R49.1, U9.15 (SYS), U9.16 (SYS), U12.9 (VIN)
/Battery.Charger,Fuel Gauge/PMID: C23.2, C24.2, U9.23 (PMID)
/Battery.Charger,Fuel Gauge/REGN: C27.1, R45.1, U9.22 (REGN)
/Battery.Charger,Fuel Gauge/SRN: R33.4, U10.7 (SRN)
/Battery.Charger,Fuel Gauge/SRP: R33.1, U10.8 (SRP)
/Battery.Charger,Fuel Gauge/TS: R42.1, R45.2, RT1.1, U9.11 (TS)
BATT_CHG: C28.1, R33.3, U9.13 (BAT), U9.14 (BAT)
BQ_INT_N: R34.1, U9.7 (INT)
CELL_B+: C26.1, R39.2
CELL_B-: C26.2, U8.3 (S2), U8.6 (VSS)
CHG_EN_N: R41.2, U9.9 (CE)
CHG_STAT_N: D9.1 (K), R35.1, U9.4 (STAT)
DN1: U9.3 (D–); also elsewhere on the board
DP1: U9.2 (D+); also elsewhere on the board
FUEL_GPOUT: R46.1, U10.12 (GPOUT)
FuelGauge_SCL: R44.1, U9.5 (SCL), U10.2 (SCL)
FuelGauge_SDA: R43.1, U9.6 (SDA), U10.1 (SDA)
GND: C23.1, C24.1, C25.1, C27.2, C28.2, C29.2, C30.2, C31.1, C32.1, C33.1, C34.1, C35.1, C36.1, C37.1, C39.1, R40.1, R41.1, R42.2, R47.2, R50.2, R51.2, R55.2, R56.1, RT1.2, SW1.2, U9.8 (OTG), U9.17 (PGND), U9.18 (PGND), U9.25 (PAD), U10.3 (VSS), U10.13 (EP), U11.2 (GND), U12.13 (MODE), U12.20 (AGND), U12.21 (PGND); also elsewhere on the board
unnamed: C22.2, L1.1, U9.19 (SW), U9.20 (SW)
unnamed: C35.2, R53.2
unnamed: C38.1, L2.2, R52.1, U12.4 (SW), U12.5 (SW), U12.6 (SW), U12.7 (SW)
unnamed: D9.2 (A), R37.2
unnamed: R38.2, U8.1 (V-)
unnamed: R39.1, U8.5 (VDD)
unnamed: C22.1, U9.21 (BTST)
unnamed: R36.2, U9.24 (DSEL)
unnamed: R40.2, U9.10 (ILIM)
unnamed: C31.2, SW1.1, U9.12 (QON)
unnamed: R47.1, U10.10 (BIN)
unnamed: C34.2, R48.2, U10.5 (VDD)
unnamed: R51.1, U11.5 (ST)
unnamed: C38.2, U12.8 (BOOT)
unnamed: R53.1, U12.18 (COMP)
unnamed: R49.2, U12.2 (EN)
unnamed: R54.1, R55.1, U12.17 (FB)
unnamed: R52.2, U12.3 (FSW)
unnamed: R50.1, U12.19 (ILIM)
unnamed: C39.2, U12.10 (SS)
unnamed: C32.2, U12.1 (VCC)
OUT_VBUS: U9.1 (VBUS); also elsewhere on the board
PACK_P-: R38.1, U7.1 (-), U8.2 (S1)
RAW_BAT: C36.2, R33.2, R48.1, U7.2 (+), U10.6 (BAT); also elsewhere on the board

Notes on the sheet:
SECTION 2 : Battery, Charger, Fuel Gauge
I2C Bus Pulls= Ups
Charger control and status indicators.
Battery Temperature sensing
Fuel Gauge
XT60 is the physical connector, wherease shunt resisitor helps in Current sense
Battery charger 5A

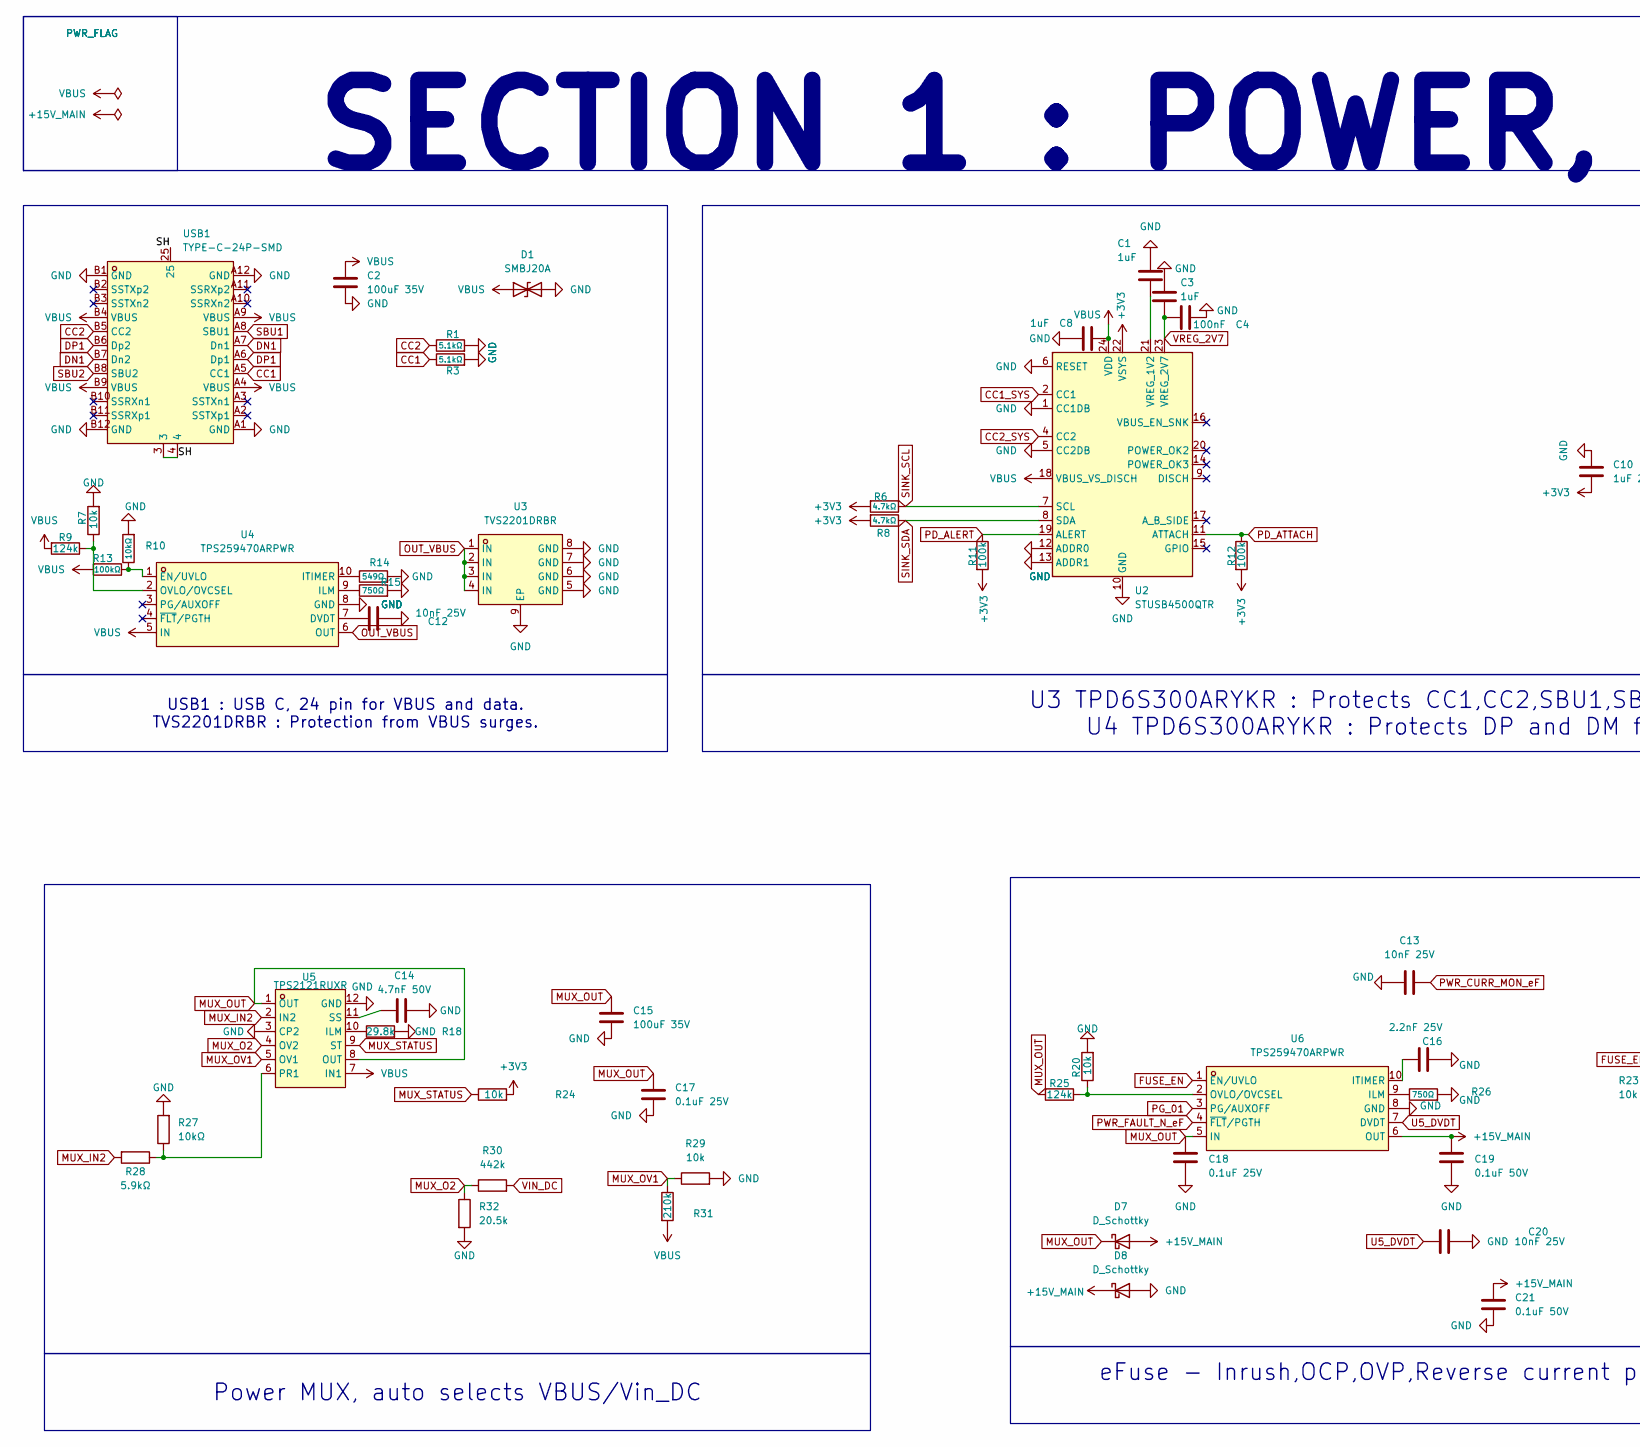
[picture p52: schematic Power_Input_Protection.kicad_sch, part in row 1, column 1]

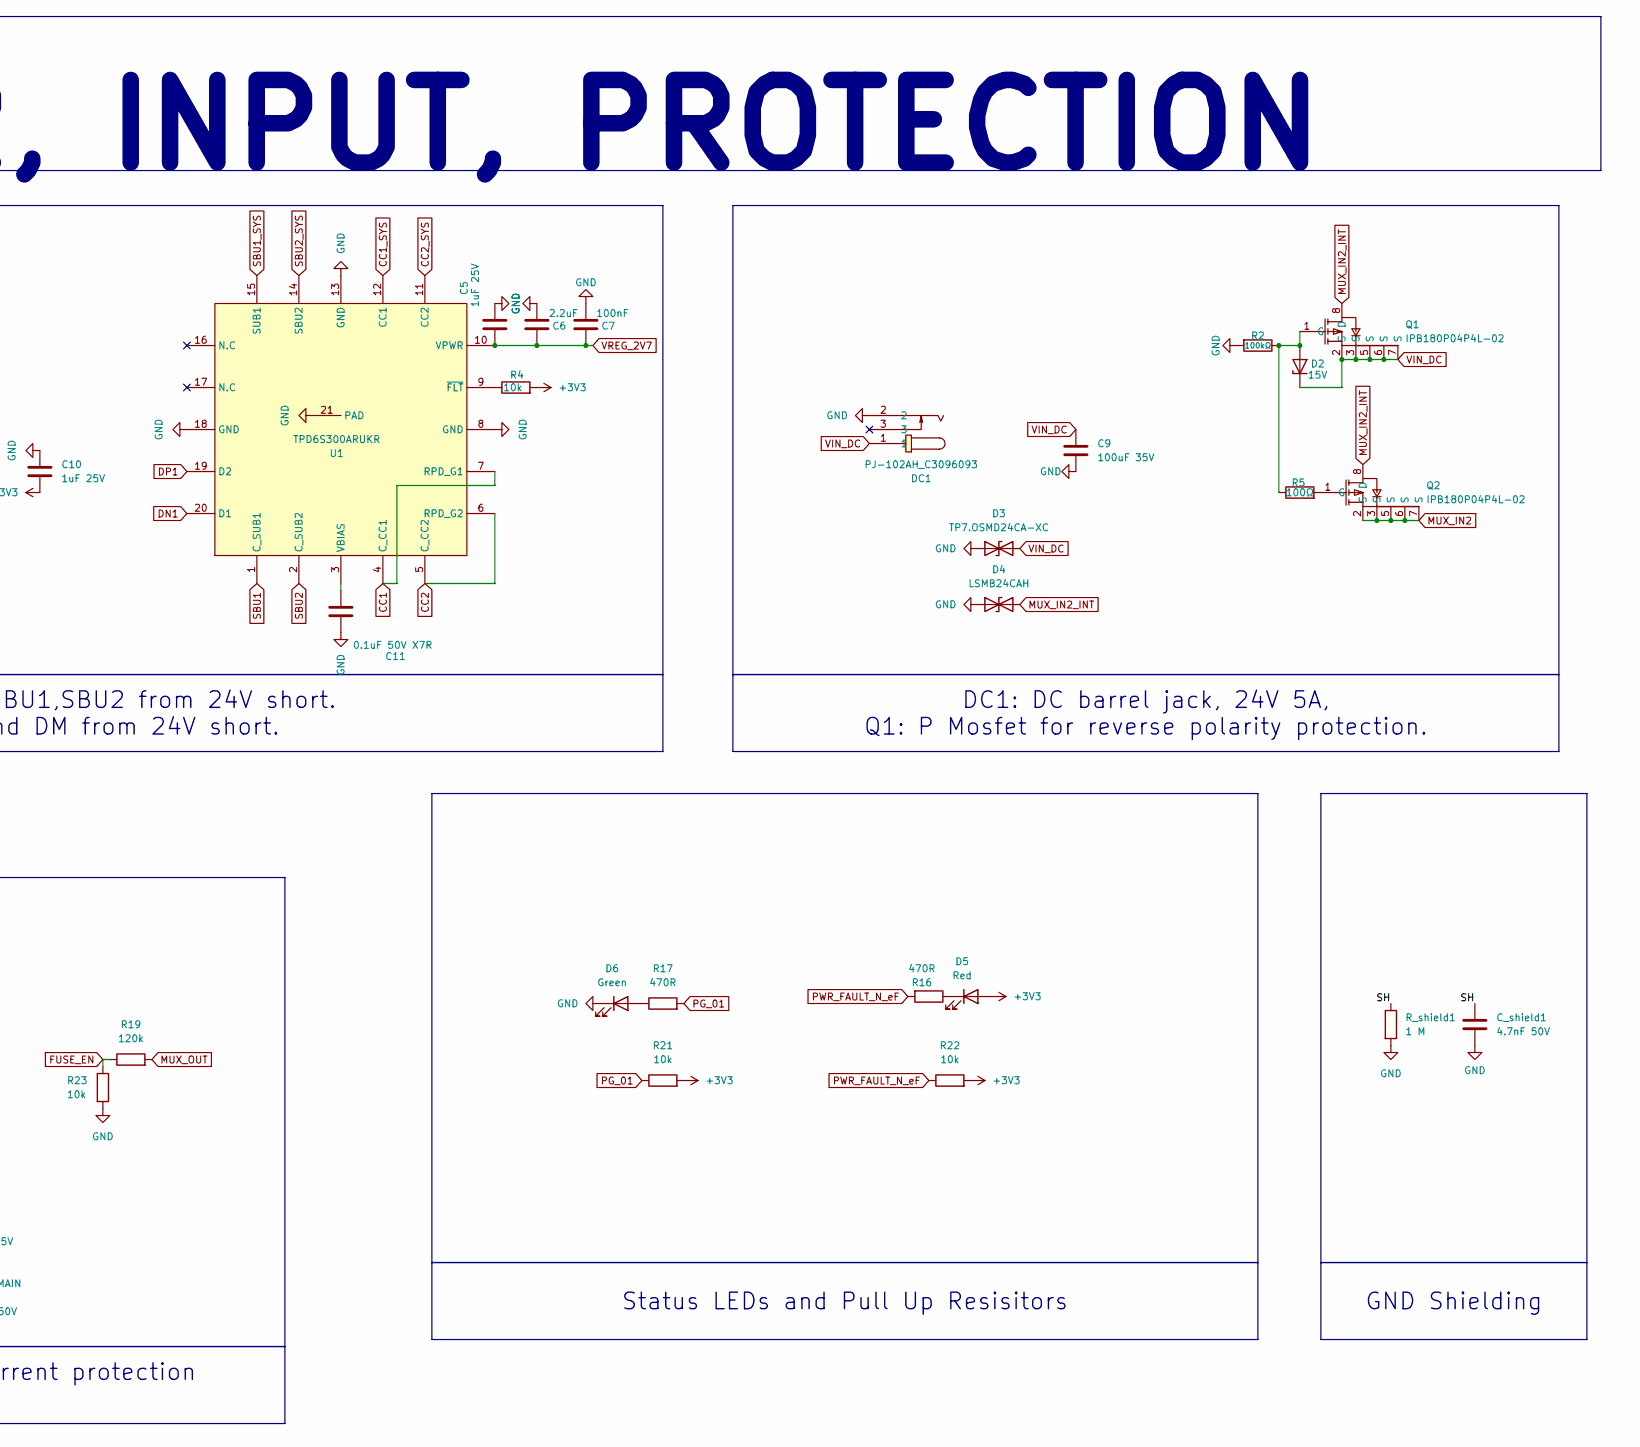
[picture p53: schematic Power_Input_Protection.kicad_sch, part in row 1, column 2]

Parts:
C1, C3: 1uF; C_0402_1005Metric
C2: 100uF 35V; C_0402_1005Metric
C4, C7: 100nF; C_0402_1005Metric
C5, C10: 1uF 25V; C_0402_1005Metric
C6: 2.2uF; C_0402_1005Metric
C8: 1uF; C_1210_3225Metric
C9, C15: 100uF 35V; C_1210_3225Metric
C11: 0.1uF 50V X7R; C_0402_1005Metric
C12, C13, C20: 10nF 25V; C_0402_1005Metric
C14: 4.7nF 50V; C_0402_1005Metric
C16: 2.2nF 25V; C_0402_1005Metric
C17, C18: 0.1uF 25V; C_0402_1005Metric
C19, C21: 0.1uF 50V; C_0402_1005Metric
C_shield1: 4.7nF 50V; C_0402_1005Metric
D1: SMBJ20A; D_SMC
D2: 15V; D_SMC
D3: TP7.OSMD24CA-XC; D_SMC
D4: LSMB24CAH; D_SMC
D5: Red; LED_0603_1608Metric
D6: Green; LED_0603_1608Metric
D7, D8: D_Schottky; D_SMC
DC1: PJ-102AH_C3096093; DC-IN-TH_PJ-102AH; MPN PJ-102AH; LCSC Part C3096093
Q1, Q2: IPB180P04P4L-02; TO-263-7_TabPin8; MPN IPB180P04P4L-02(TOKMAS); LCSC Part C21547650
R1, R3: 5.1kΩ; R_0402_1005Metric
R2, R13: 100kΩ; R_0402_1005Metric
R4, R7, R20, R21, R22, R23, R24, R29: 10k; R_0402_1005Metric
R5: 100Ω; R_0402_1005Metric
R6, R8: 4.7kΩ; R_0402_1005Metric
R9, R25: 124k; R_0402_1005Metric
R10, R27: 10kΩ; R_0402_1005Metric
R11, R12: 100k; R_0402_1005Metric
R14: 549Ω; R_0402_1005Metric
R15, R26: 750Ω; R_0402_1005Metric
R16, R17: 470R; R_0402_1005Metric
R18: 29.8k; R_0402_1005Metric
R19: 120k; R_0402_1005Metric
R28: 5.9kΩ; R_0402_1005Metric
R30: 442k; R_0402_1005Metric
R31: 210k; R_0402_1005Metric
R32: 20.5k; R_0402_1005Metric
R_shield1: 1 M; R_0402_1005Metric
U1: TPD6S300ARUKR; WQFN-20_L3.0-W3.0-P0.40-TL-EP1.7; MPN TPD6S300ARUKR; LCSC Part C2876380
U2: STUSB4500QTR; QFN-24-1EP_4x4mm_P0.5mm_EP2.7x2.7mm
U3: TVS2201DRBR; VSON-8_L3.0-W3.0-P0.65-BL-EP; MPN TVS2201DRBR; LCSC Part C1849889
U4, U6: TPS259470ARPWR; VQFN-10_L2.0-W2.0-P0.45-TL; MPN TPS259470ARPWR; LCSC Part C3662799
U5: TPS2121RUXR; VQFN-HR-12_L2.5-W2.0-P0.50-BL; MPN TPS2121RUXR; LCSC Part C485916
USB1: TYPE-C-24P-SMD; USB-C-SMD_TYPE-C-24P-SMD; MPN TYPE-C-24P-SMD; LCSC Part C53207146

Connections:
+3V3: C10.2, D5.2 (A), R4.2, R6.2, R8.2, R11.2, R12.2, R21.2, R22.2, R24.2, U2.22 (VSYS); also elsewhere on the board
+15V_MAIN: C19.1, C21.1, D7.2 (A), D8.1 (K), U6.6 (OUT); also elsewhere on the board
/Power,Input,Protection/SH: C_shield1.1, R_shield1.1, USB1.3, USB1.4, USB1.25
CC1: R3.1, U1.4 (C_CC1), U1.7 (RPD_G1), USB1.A5 (CC1)
CC1_SYS: U1.12 (CC1), U2.2 (CC1)
CC2: R1.1, U1.5 (C_CC2), U1.6 (RPD_G2), USB1.B5 (CC2)
CC2_SYS: U1.11 (CC2), U2.4 (CC2)
DN1: U1.20 (D1), USB1.A7 (Dn1), USB1.B7 (Dn2); also elsewhere on the board
DP1: U1.19 (D2), USB1.A6 (Dp1), USB1.B6 (Dp2); also elsewhere on the board
FUSE_EN: R19.1, R23.1, U6.1 (EN/UVLO)
GND: C1.2, C2.2, C3.2, C4.1, C5.1, C6.1, C7.1, C8.2, C9.2, C10.1, C11.1, C12.2, C13.1, C14.2, C15.2, C16.2, C17.2, C18.2, C19.2, C20.2, C21.2, C_shield1.2, D1.2 (A2), D3.1 (A1), D4.1 (A1), D6.1 (K), D8.2 (A), DC1.2, R1.2, R2.2, R3.2, R7.2, R10.2, R14.2, R15.2, R18.2, R20.2, R23.2, R26.2, R27.2, R29.2, R32.2, R_shield1.2, U1.8 (GND), U1.13 (GND), U1.18 (GND), U1.21 (PAD), U2.1 (CC1DB), U2.5 (CC2DB), U2.6 (RESET), U2.10 (GND), U2.12 (ADDR0), U2.13 (ADDR1), U2.25 (GND), U3.5 (GND), U3.6 (GND), U3.7 (GND), U3.8 (GND), U3.9 (EP), U4.8 (GND), U5.3 (CP2), U5.12 (GND), U6.8 (GND), USB1.A1 (GND), USB1.A12 (GND), USB1.B1 (GND), USB1.B12 (GND); also elsewhere on the board
MUX_IN2: Q2.2 (S), Q2.3 (S), Q2.5 (S), Q2.6 (S), Q2.7 (S), R28.2, U5.2 (IN2)
MUX_IN2_INT: D4.2 (A2), Q1.8 (D), Q2.8 (D)
MUX_O2: R30.1, R32.1, U5.4 (OV2)
MUX_OUT: C15.1, C17.1, C18.1, D7.1 (K), R19.2, R25.2, U5.1 (OUT), U5.8 (OUT), U6.5 (IN)
MUX_OV1: R29.1, R31.1, U5.5 (OV1)
MUX_STATUS: R24.1, U5.9 (ST)
unnamed: D2.2 (A), Q1.1 (G), R2.1, R5.1
unnamed: D5.1 (K), R16.1
unnamed: D6.2 (A), R17.1
unnamed: Q2.1 (G), R5.2
unnamed: C11.2, U1.3 (VBIAS)
unnamed: R4.1, U1.9 (~FLT)
unnamed: C1.1, U2.21 (VREG_1V2)
unnamed: C12.1, U4.7 (DVDT)
unnamed: R10.1, R13.1, U4.1 (EN/UVLO)
unnamed: R15.1, U4.9 (ILM)
unnamed: R14.1, U4.10 (ITIMER)
unnamed: R7.1, R9.1, U4.2 (OVLO/OVCSEL)
unnamed: R18.1, U5.10 (ILM)
unnamed: R27.1, R28.1, U5.6 (PR1)
unnamed: C14.1, U5.11 (SS)
unnamed: R26.1, U6.9 (ILM)
unnamed: C16.1, U6.10 (ITIMER)
unnamed: R20.1, R25.1, U6.2 (OVLO/OVCSEL)
OUT_VBUS: U3.1 (IN), U3.2 (IN), U3.3 (IN), U3.4 (IN), U4.6 (OUT); also elsewhere on the board
PD_ALERT: R11.1, U2.19 (ALERT)
PD_ATTACH: R12.1, U2.11 (ATTACH)
PG_01: R17.2, R21.1, U6.3 (PG/AUXOFF)
PWR_CURR_MON_eF: C13.2
PWR_FAULT_N_eF: R16.2, R22.1, U6.4 (~FLT/PGTH)
SBU1: U1.1 (C_SUB1), USB1.A8 (SBU1)
SBU1_SYS: U1.15 (SUB1)
SBU2: U1.2 (C_SUB2), USB1.B8 (SBU2)
SBU2_SYS: U1.14 (SBU2)
SINK_SCL: R6.1, U2.7 (SCL)
SINK_SDA: R8.1, U2.8 (SDA)
U5_DVDT: C20.1, U6.7 (DVDT)
VBUS: C2.1, C8.1, D1.1 (A1), R9.2, R13.2, R31.2, U2.18 (VBUS_VS_DISCH), U2.24 (VDD), U4.5 (IN), U5.7 (IN1), USB1.A4 (VBUS), USB1.A9 (VBUS), USB1.B4 (VBUS), USB1.B9 (VBUS); also elsewhere on the board
VIN_DC: C9.1, D2.1 (K), D3.2 (A2), DC1.1, Q1.2 (S), Q1.3 (S), Q1.5 (S), Q1.6 (S), Q1.7 (S), R30.2
VREG_2V7: C3.1, C4.2, C5.2, C6.2, C7.2, U1.10 (VPWR), U2.23 (VREG_2V7)

Notes on the sheet:
SECTION 1 : POWER, INPUT, PROTECTION
USB1 : USB C, 24 pin for VBUS and data. TVS2201DRBR : Protection from VBUS surges.
eFuse - Inrush,OCP,OVP,Reverse current protection
DC1: DC barrel jack, 24V 5A, Q1: P Mosfet for reverse polarity protection.
Power MUX, auto selects VBUS/Vin_DC
Status LEDs and Pull Up Resisitors
U3 TPD6S300ARYKR : Protects CC1,CC2,SBU1,SBU2 from 24V short. U4 TPD6S300ARYKR : Protects DP and DM from 24V short.
GND Shielding

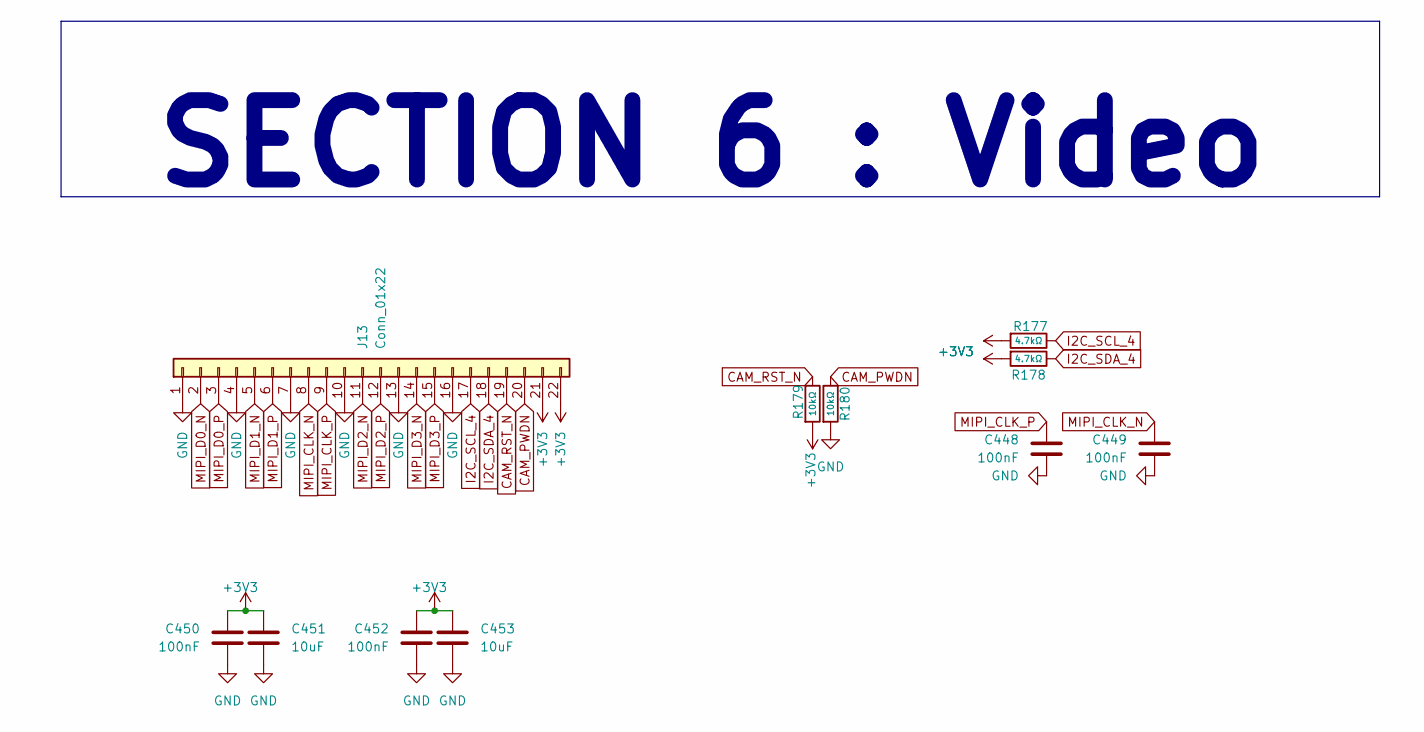
[picture p54: schematic 06_Video.kicad_sch]

Parts:
C448, C449, C450, C452: 100nF; C_0402_1005Metric
C451, C453: 10uF; C_0402_1005Metric
J13: Conn_01x22; Hirose_FH12-22S-0.5SH_1x22-1MP_P0.50mm_Horizontal
R177, R178: 4.7kΩ; R_0402_1005Metric
R179, R180: 10kΩ; R_0402_1005Metric

Connections:
+3V3: C450.1, C451.2, C452.1, C453.2, J13.21, J13.22, R177.2, R178.2, R179.2; also elsewhere on the board
CAM_PWDN: J13.20, R180.1; also elsewhere on the board
CAM_RST_N: J13.19, R179.1; also elsewhere on the board
GND: C448.2, C449.2, C450.2, C451.1, C452.2, C453.1, J13.1, J13.4, J13.7, J13.10, J13.13, J13.16, R180.2; also elsewhere on the board
I2C_SCL_4: J13.17, R177.1; also elsewhere on the board
I2C_SDA_4: J13.18, R178.1; also elsewhere on the board
MIPI_CLK_N: C449.1, J13.8; also elsewhere on the board
MIPI_CLK_P: C448.1, J13.9; also elsewhere on the board
MIPI_D0_N: J13.2; also elsewhere on the board
MIPI_D0_P: J13.3; also elsewhere on the board
MIPI_D1_N: J13.5; also elsewhere on the board
MIPI_D1_P: J13.6; also elsewhere on the board
MIPI_D2_N: J13.11; also elsewhere on the board
MIPI_D2_P: J13.12; also elsewhere on the board
MIPI_D3_N: J13.14; also elsewhere on the board
MIPI_D3_P: J13.15; also elsewhere on the board

Notes on the sheet:
SECTION 6 : Video

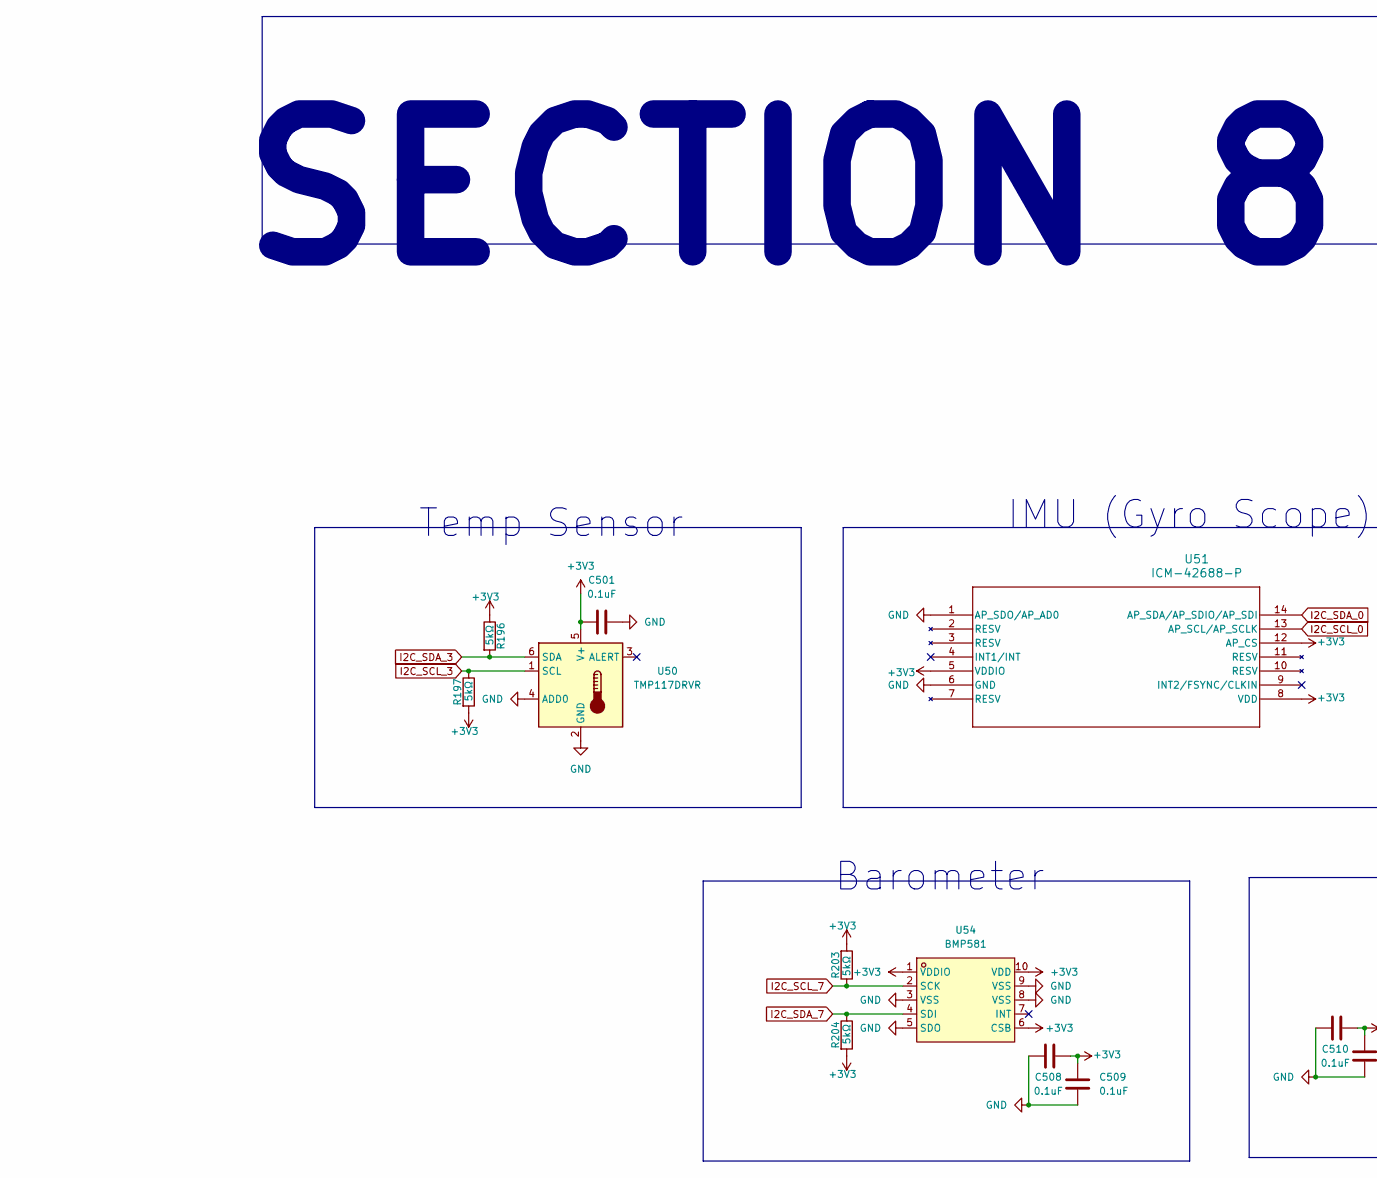
[picture p55: schematic 08_Sensors_GNSS.kicad_sch, part in row 1, column 1]

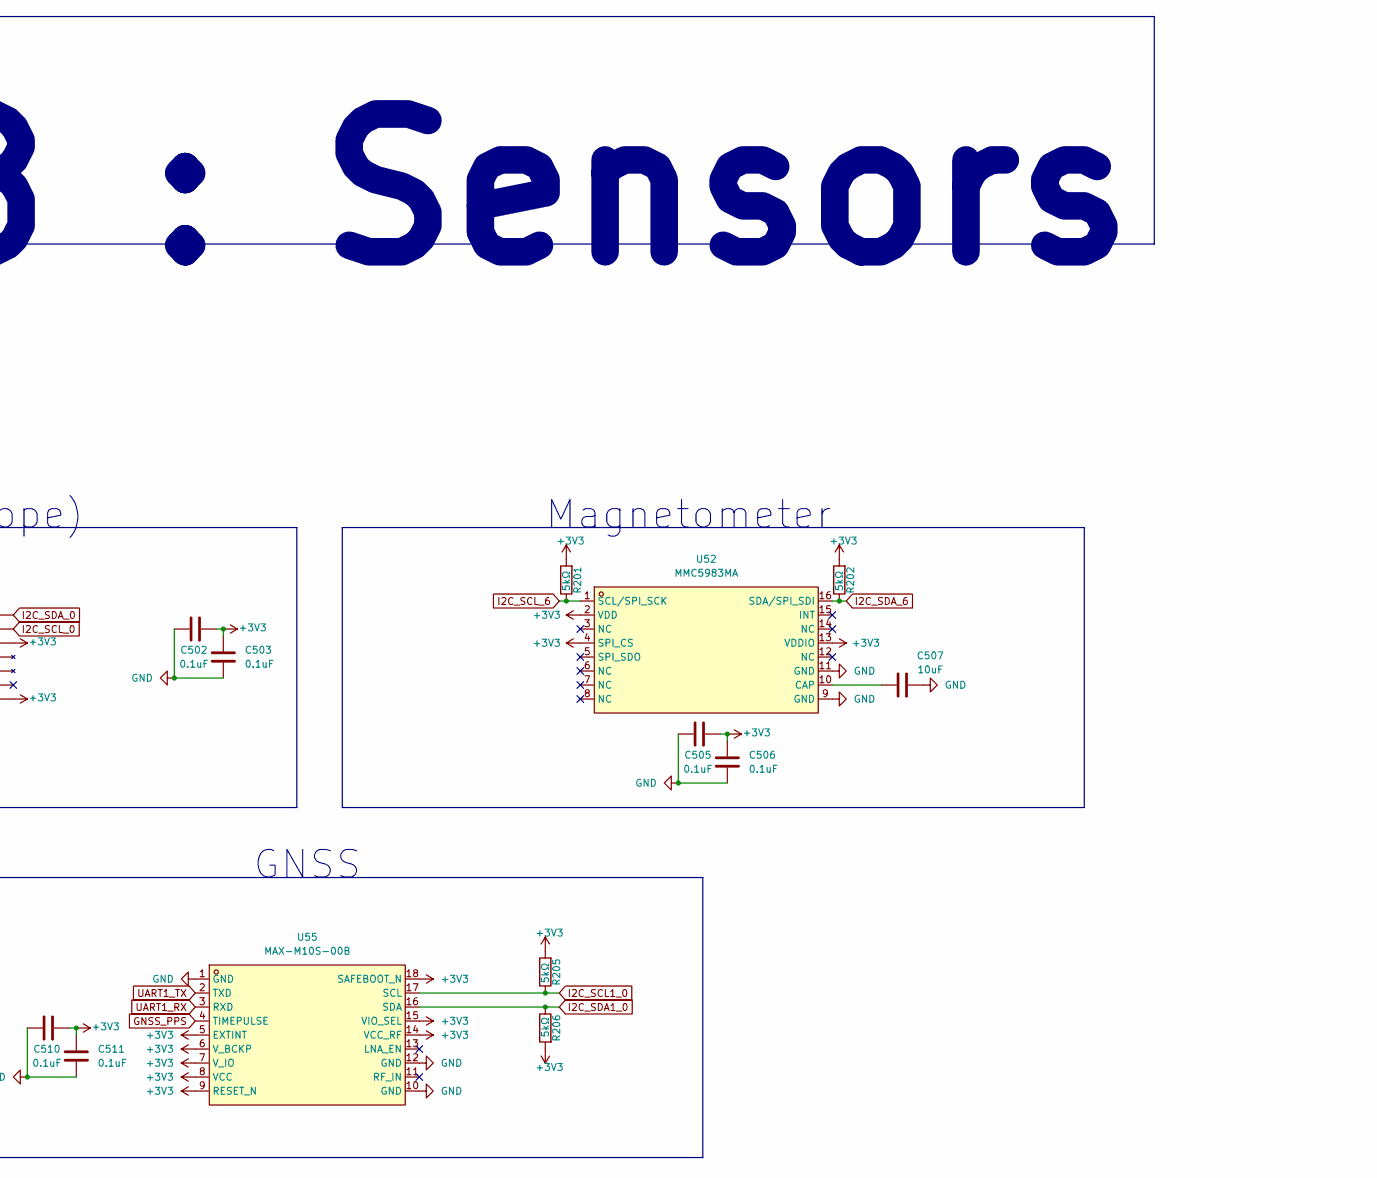
[picture p56: schematic 08_Sensors_GNSS.kicad_sch, part in row 1, column 2]

Parts:
C501, C502, C503, C505, C506, C508, C509, C510, C511: 0.1uF; C_0402_1005Metric
C507: 10uF; C_0402_1005Metric
R196, R197, R201, R202, R203, R204, R205, R206: 5kΩ; R_0402_1005Metric
U50: TMP117DRVR; WSON-6-1EP_2x2mm_P0.65mm_EP1x1.6mm
U51: ICM-42688-P; LGA14_2P5X3X0P91_TDK-L
U52: MMC5983MA; LGA-16_L3.0-W3.0-P0.50-BL_SQ; MPN MMC5983MA; LCSC Part C404329
U54: BMP581; LGA-10_L2.0-W2.0-P0.50-TL_BMP581; MPN BMP581; LCSC Part C5362283
U55: MAX-M10S-00B; SMD-18_L10.1-W9.7-P1.10-TL_SKG09F; MPN MAX-M10S-00B; LCSC Part C4153167

Connections:
+3V3: C501.2, C502.1, C503.2, C505.1, C506.2, C508.1, C509.2, C510.1, C511.2, R196.1, R197.2, R201.2, R202.2, R203.2, R204.2, R205.2, R206.2, U50.5 (V+), U51.5 (VDDIO), U51.8 (VDD), U51.12 (AP_CS), U52.2 (VDD), U52.4 (SPI_CS), U52.13 (VDDIO), U54.1 (VDDIO), U54.6 (CSB), U54.10 (VDD), U55.5 (EXTINT), U55.6 (V_BCKP), U55.7 (V_IO), U55.8 (VCC), U55.9 (RESET_N), U55.14 (VCC_RF), U55.15 (VIO_SEL), U55.18 (SAFEBOOT_N); also elsewhere on the board
GND: C501.1, C502.2, C503.1, C505.2, C506.1, C507.1, C508.2, C509.1, C510.2, C511.1, U50.2 (GND), U50.4 (ADD0), U51.1 (AP_SDO/AP_AD0), U51.6 (GND), U52.9 (GND), U52.11 (GND), U54.3 (VSS), U54.5 (SDO), U54.8 (VSS), U54.9 (VSS), U55.1 (GND), U55.10 (GND), U55.12 (GND); also elsewhere on the board
GNSS_PPS: U55.4 (TIMEPULSE); also elsewhere on the board
I2C_SCL1_0: R205.1, U55.17 (SCL); also elsewhere on the board
I2C_SCL_0: U51.13 (AP_SCL/AP_SCLK); also elsewhere on the board
I2C_SCL_3: R197.1, U50.1 (SCL); also elsewhere on the board
I2C_SCL_6: R201.1, U52.1 (SCL/SPI_SCK); also elsewhere on the board
I2C_SCL_7: R203.1, U54.2 (SCK); also elsewhere on the board
I2C_SDA1_0: R206.1, U55.16 (SDA); also elsewhere on the board
I2C_SDA_0: U51.14 (AP_SDA/AP_SDIO/AP_SDI); also elsewhere on the board
I2C_SDA_3: R196.2, U50.6 (SDA); also elsewhere on the board
I2C_SDA_6: R202.1, U52.16 (SDA/SPI_SDI); also elsewhere on the board
I2C_SDA_7: R204.1, U54.4 (SDI); also elsewhere on the board
unnamed: C507.2, U52.10 (CAP)
UART1_RX: U55.3 (RXD); also elsewhere on the board
UART1_TX: U55.2 (TXD); also elsewhere on the board

Notes on the sheet:
SECTION 8 : Sensors
IMU (Gyro Scope)
Magnetometer
GNSS
Temp Sensor
Barometer

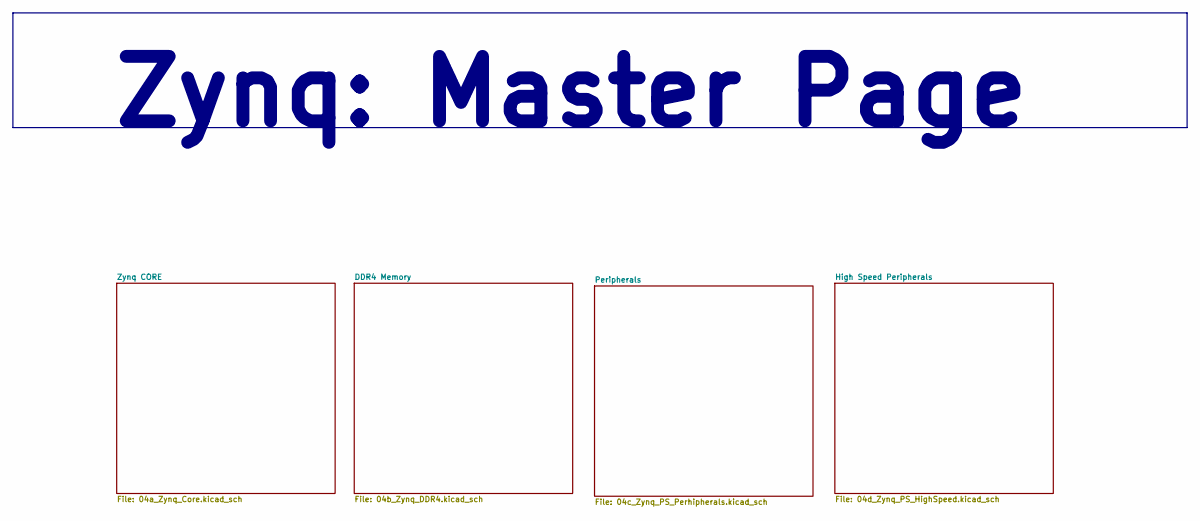
[picture p57: schematic 04_Zynq.kicad_sch]

Notes on the sheet:
Zynq: Master Page
