damnitzhemanth-oss/FusionBoard/PCB/Devboard.kicad_pcb

## KiCad design PCB/Devboard.kicad_pcb (continued)

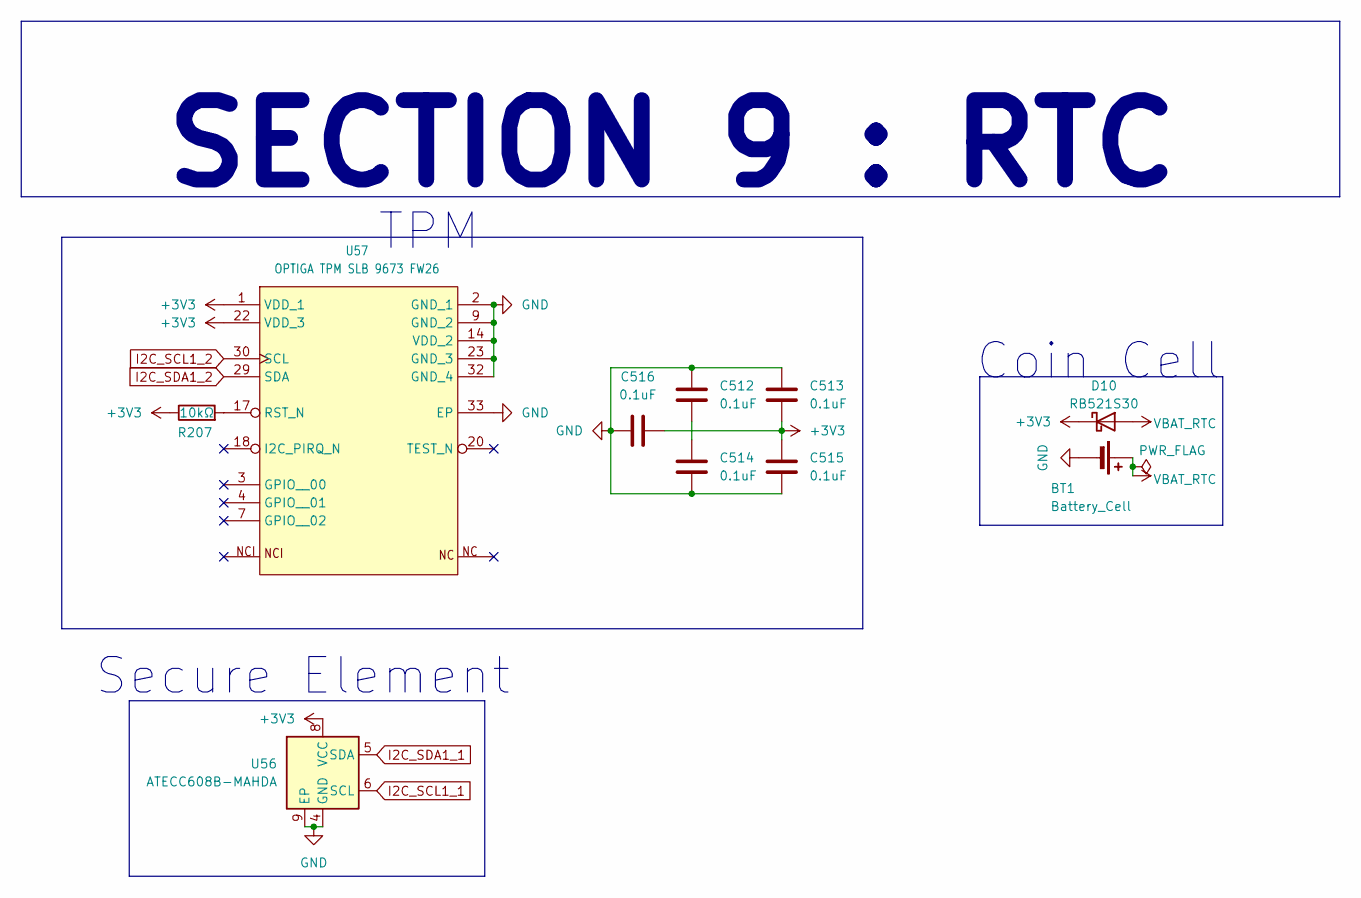
[picture p58: schematic 09_RTC_Security.kicad_sch]

Parts:
BT1: Battery_Cell; BatteryHolder_Keystone_1057_1x2032
C512, C513, C514, C515, C516: 0.1uF; C_0402_1005Metric
D10: RB521S30; D_0201_0603Metric
R207: 10kΩ; R_0402_1005Metric
U56: ATECC608B-MAHDA; DFN-8-1EP_3x2mm_P0.5mm_EP1.3x1.5mm
U57: OPTIGA TPM SLB 9673 FW26; QFN50P500X500X60-33N-V2

Connections:
+3V3: C513.1, C515.2, C516.1, D10.1 (K), R207.1, U56.8 (VCC), U57.1 (VDD_1), U57.22 (VDD_3); also elsewhere on the board
GND: BT1.2 (-), C512.2, C513.2, C514.1, C515.1, C516.2, U56.4 (GND), U56.9 (EP), U57.2 (GND_1), U57.9 (GND_2), U57.14 (VDD_2), U57.23 (GND_3), U57.32 (GND_4), U57.33 (EP); also elsewhere on the board
I2C_SCL1_1: U56.6 (SCL); also elsewhere on the board
I2C_SCL1_2: U57.30 (SCL); also elsewhere on the board
I2C_SDA1_1: U56.5 (SDA); also elsewhere on the board
I2C_SDA1_2: U57.29 (SDA); also elsewhere on the board
unnamed: C512.1, C514.2
unnamed: R207.2, U57.17 (RST_N)
VBAT_RTC: BT1.1 (+), D10.2 (A)

Notes on the sheet:
Coin Cell
TPM
Secure Element
SECTION 9 : RTC

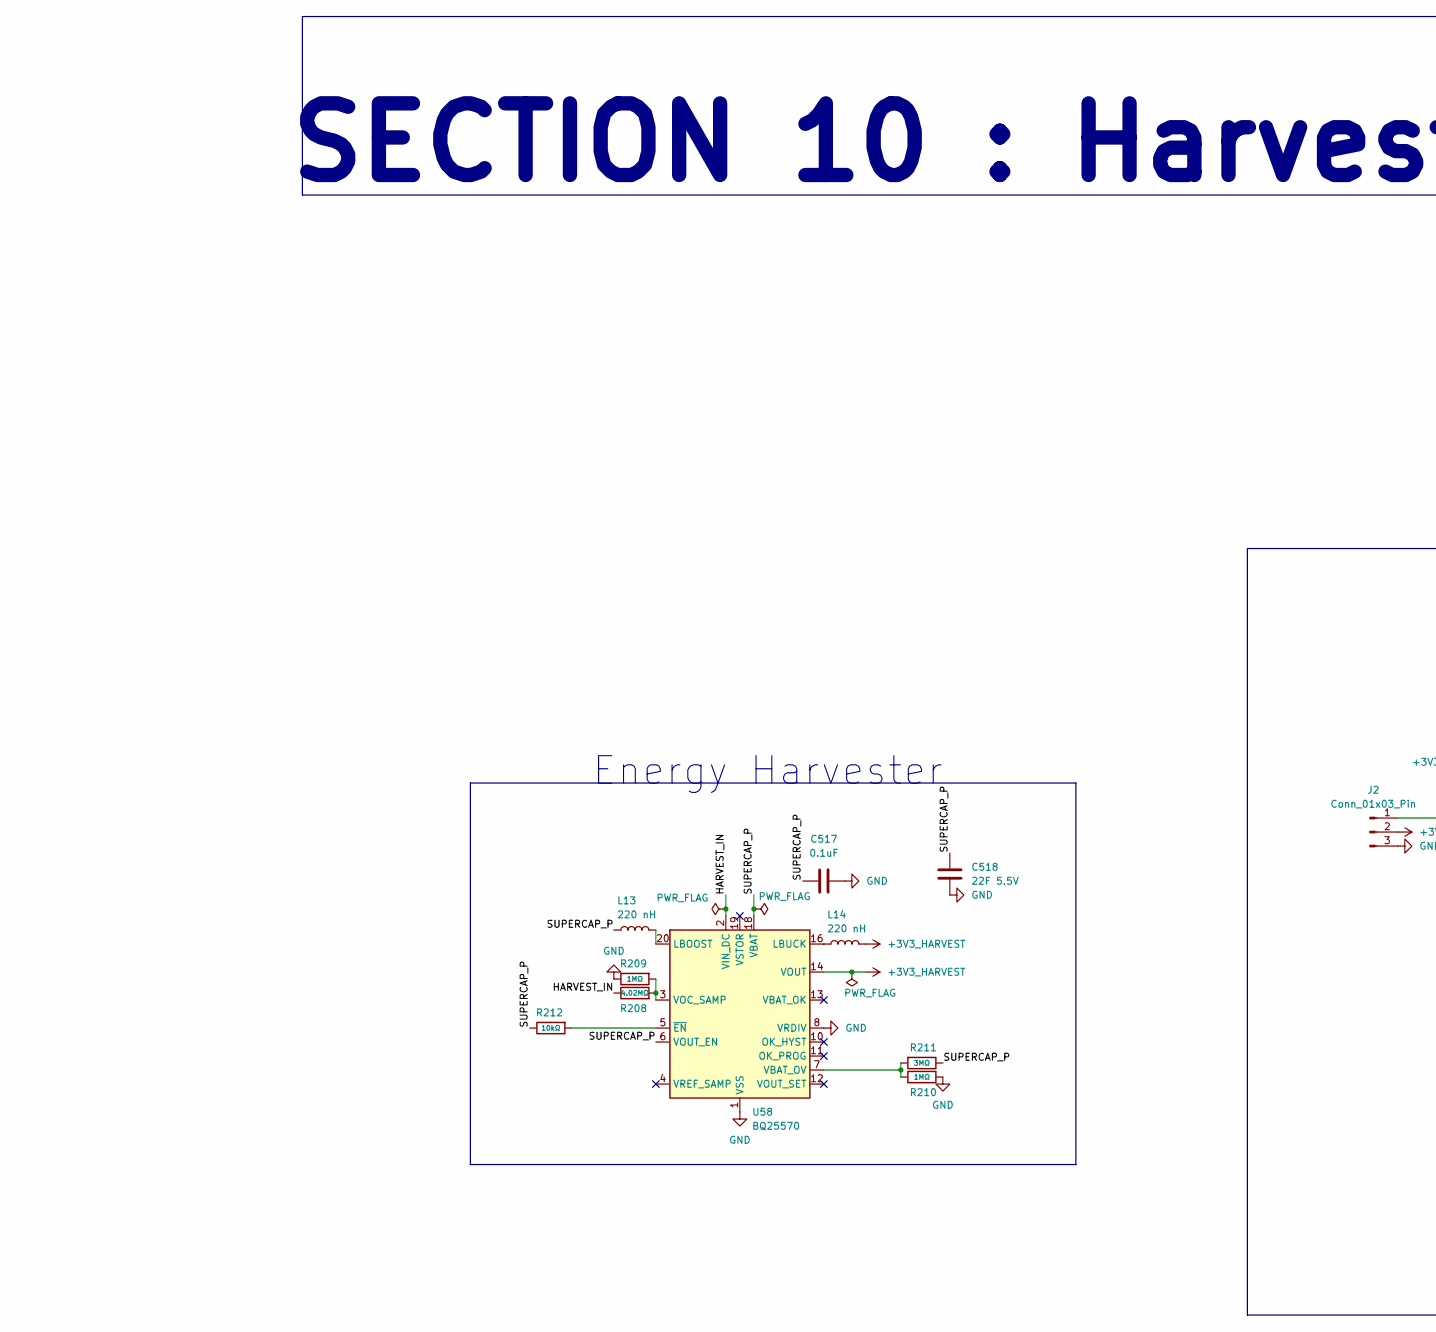
[picture p59: schematic 10_Harvester_BMC_Telemetry.kicad_sch, part in row 1, column 1]

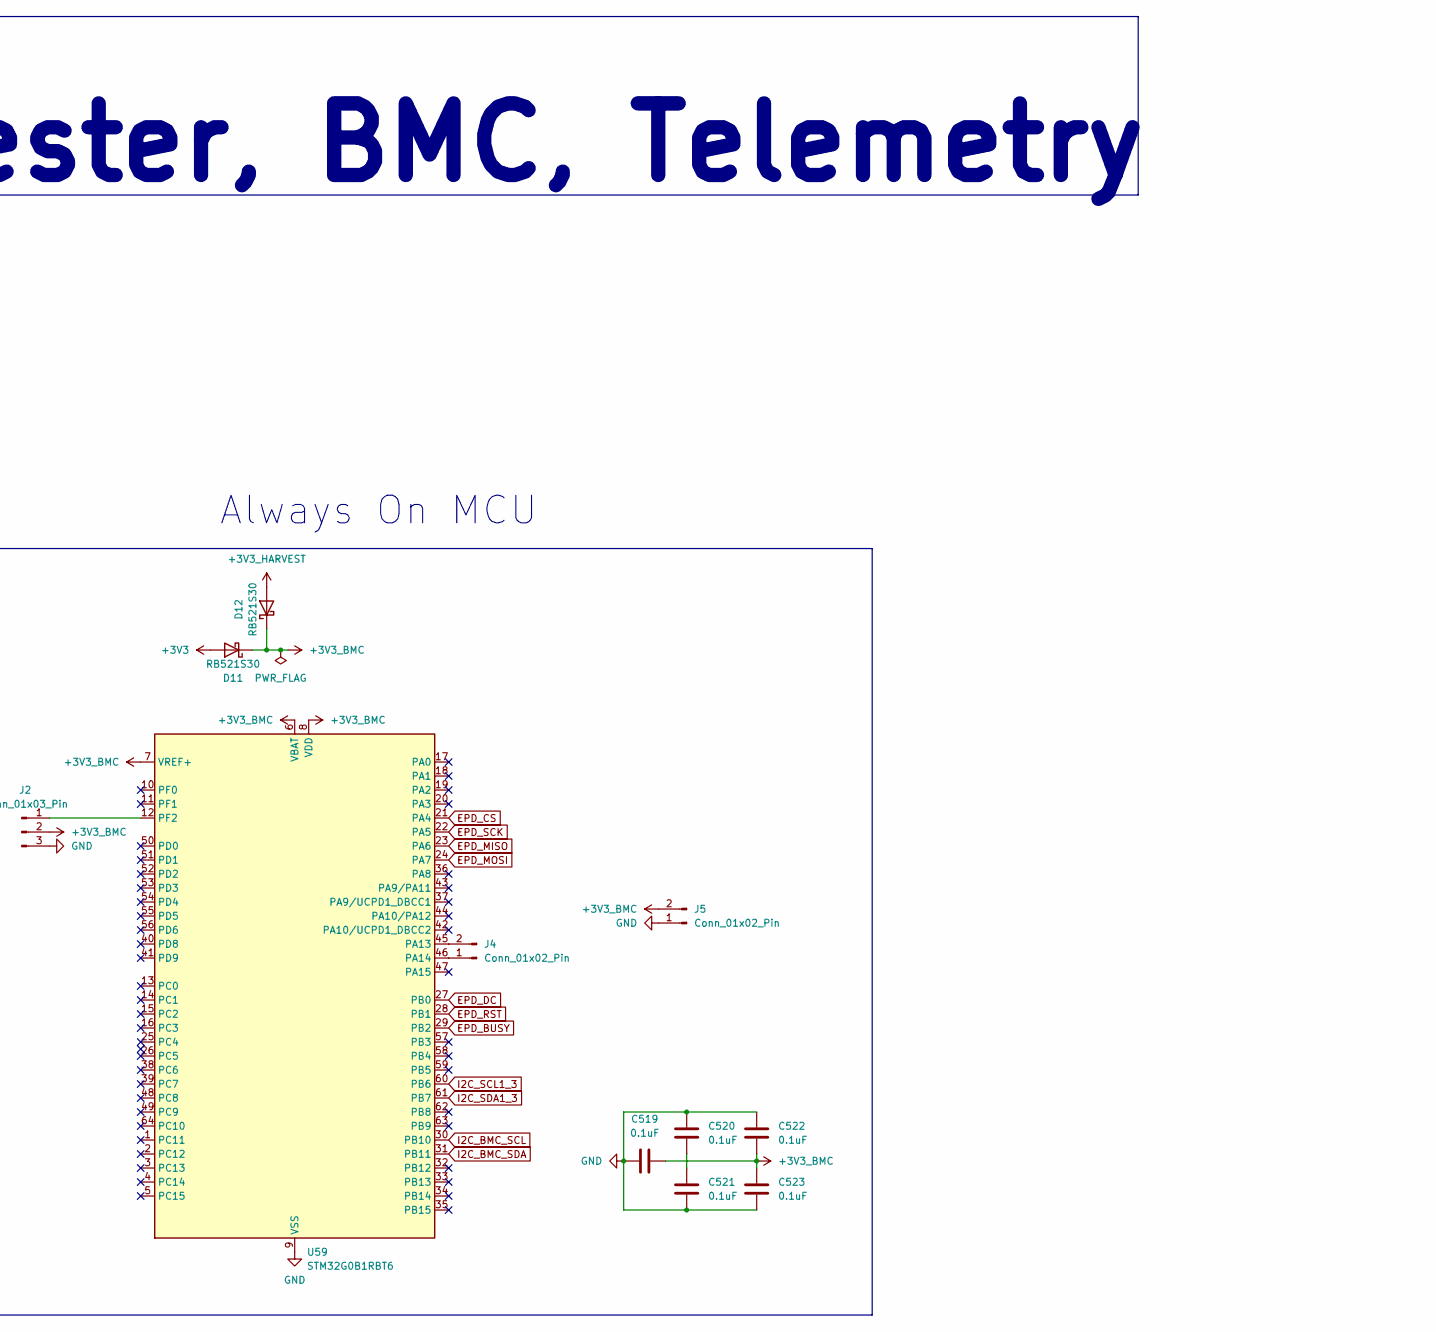
[picture p60: schematic 10_Harvester_BMC_Telemetry.kicad_sch, part in row 1, column 2]

Parts:
C517, C519, C520, C521, C522, C523: 0.1uF; C_0402_1005Metric
C518: 22F 5.5V; C_Radial_D16.0mm_H31.5mm_P7.50mm
D11, D12: RB521S30; D_0201_0603Metric
J2: Conn_01x03_Pin; PinHeader_1x03_P2.00mm_Vertical
J4, J5: Conn_01x02_Pin; PinSocket_1x02_P2.00mm_Vertical
L13, L14: 220 nH; L_0603_1608Metric
R208: 4.02MΩ; R_0402_1005Metric
R209, R210: 1MΩ; R_0402_1005Metric
R211: 3MΩ; R_0402_1005Metric
R212: 10kΩ; R_0402_1005Metric
U58: BQ25570; QFN-20-1EP_3.5x3.5mm_P0.5mm_EP2x2mm
U59: STM32G0B1RBT6; LQFP-64_10x10mm_P0.5mm

Connections:
+3V3: D11.2 (A); also elsewhere on the board
+3V3_BMC: C519.1, C522.1, C523.2, D11.1 (K), D12.1 (K), J2.2, J5.2, U59.6 (VBAT), U59.7 (VREF+), U59.8 (VDD); also elsewhere on the board
+3V3_HARVEST: D12.2 (A), L14.2, U58.14 (VOUT)
/Harvester, BMC, Telemetry/HARVEST_IN: R208.1, U58.2 (VIN_DC)
/Harvester, BMC, Telemetry/SUPERCAP_P: C517.2, C518.1, L13.1, R211.1, R212.1, U58.6 (VOUT_EN), U58.18 (VBAT)
EPD_BUSY: U59.29 (PB2); also elsewhere on the board
EPD_CS: U59.21 (PA4); also elsewhere on the board
EPD_DC: U59.27 (PB0); also elsewhere on the board
EPD_MISO: U59.23 (PA6); also elsewhere on the board
EPD_MOSI: U59.24 (PA7); also elsewhere on the board
EPD_RST: U59.28 (PB1); also elsewhere on the board
EPD_SCK: U59.22 (PA5); also elsewhere on the board
GND: C517.1, C518.2, C519.2, C520.2, C521.1, C522.2, C523.1, J2.3, J5.1, R209.1, R210.1, U58.1 (VSS), U58.8 (VRDIV), U58.9 (VSS), U58.15 (VSS), U58.17 (VSS), U58.21 (VSS), U59.9 (VSS); also elsewhere on the board
I2C_BMC_SCL: U59.30 (PB10)
I2C_BMC_SDA: U59.31 (PB11)
I2C_SCL1_3: U59.60 (PB6); also elsewhere on the board
I2C_SDA1_3: U59.61 (PB7); also elsewhere on the board
unnamed: C520.1, C521.2
unnamed: J2.1, U59.12 (PF2)
unnamed: J4.1, U59.46 (PA14)
unnamed: J4.2, U59.45 (PA13)
unnamed: L13.2, U58.20 (LBOOST)
unnamed: L14.1, U58.16 (LBUCK)
unnamed: R210.2, R211.2, U58.7 (VBAT_OV)
unnamed: R208.2, R209.2, U58.3 (VOC_SAMP)
unnamed: R212.2, U58.5 (~EN)

Notes on the sheet:
Energy Harvester
SECTION 10 : Harvester, BMC, Telemetry
Always On MCU

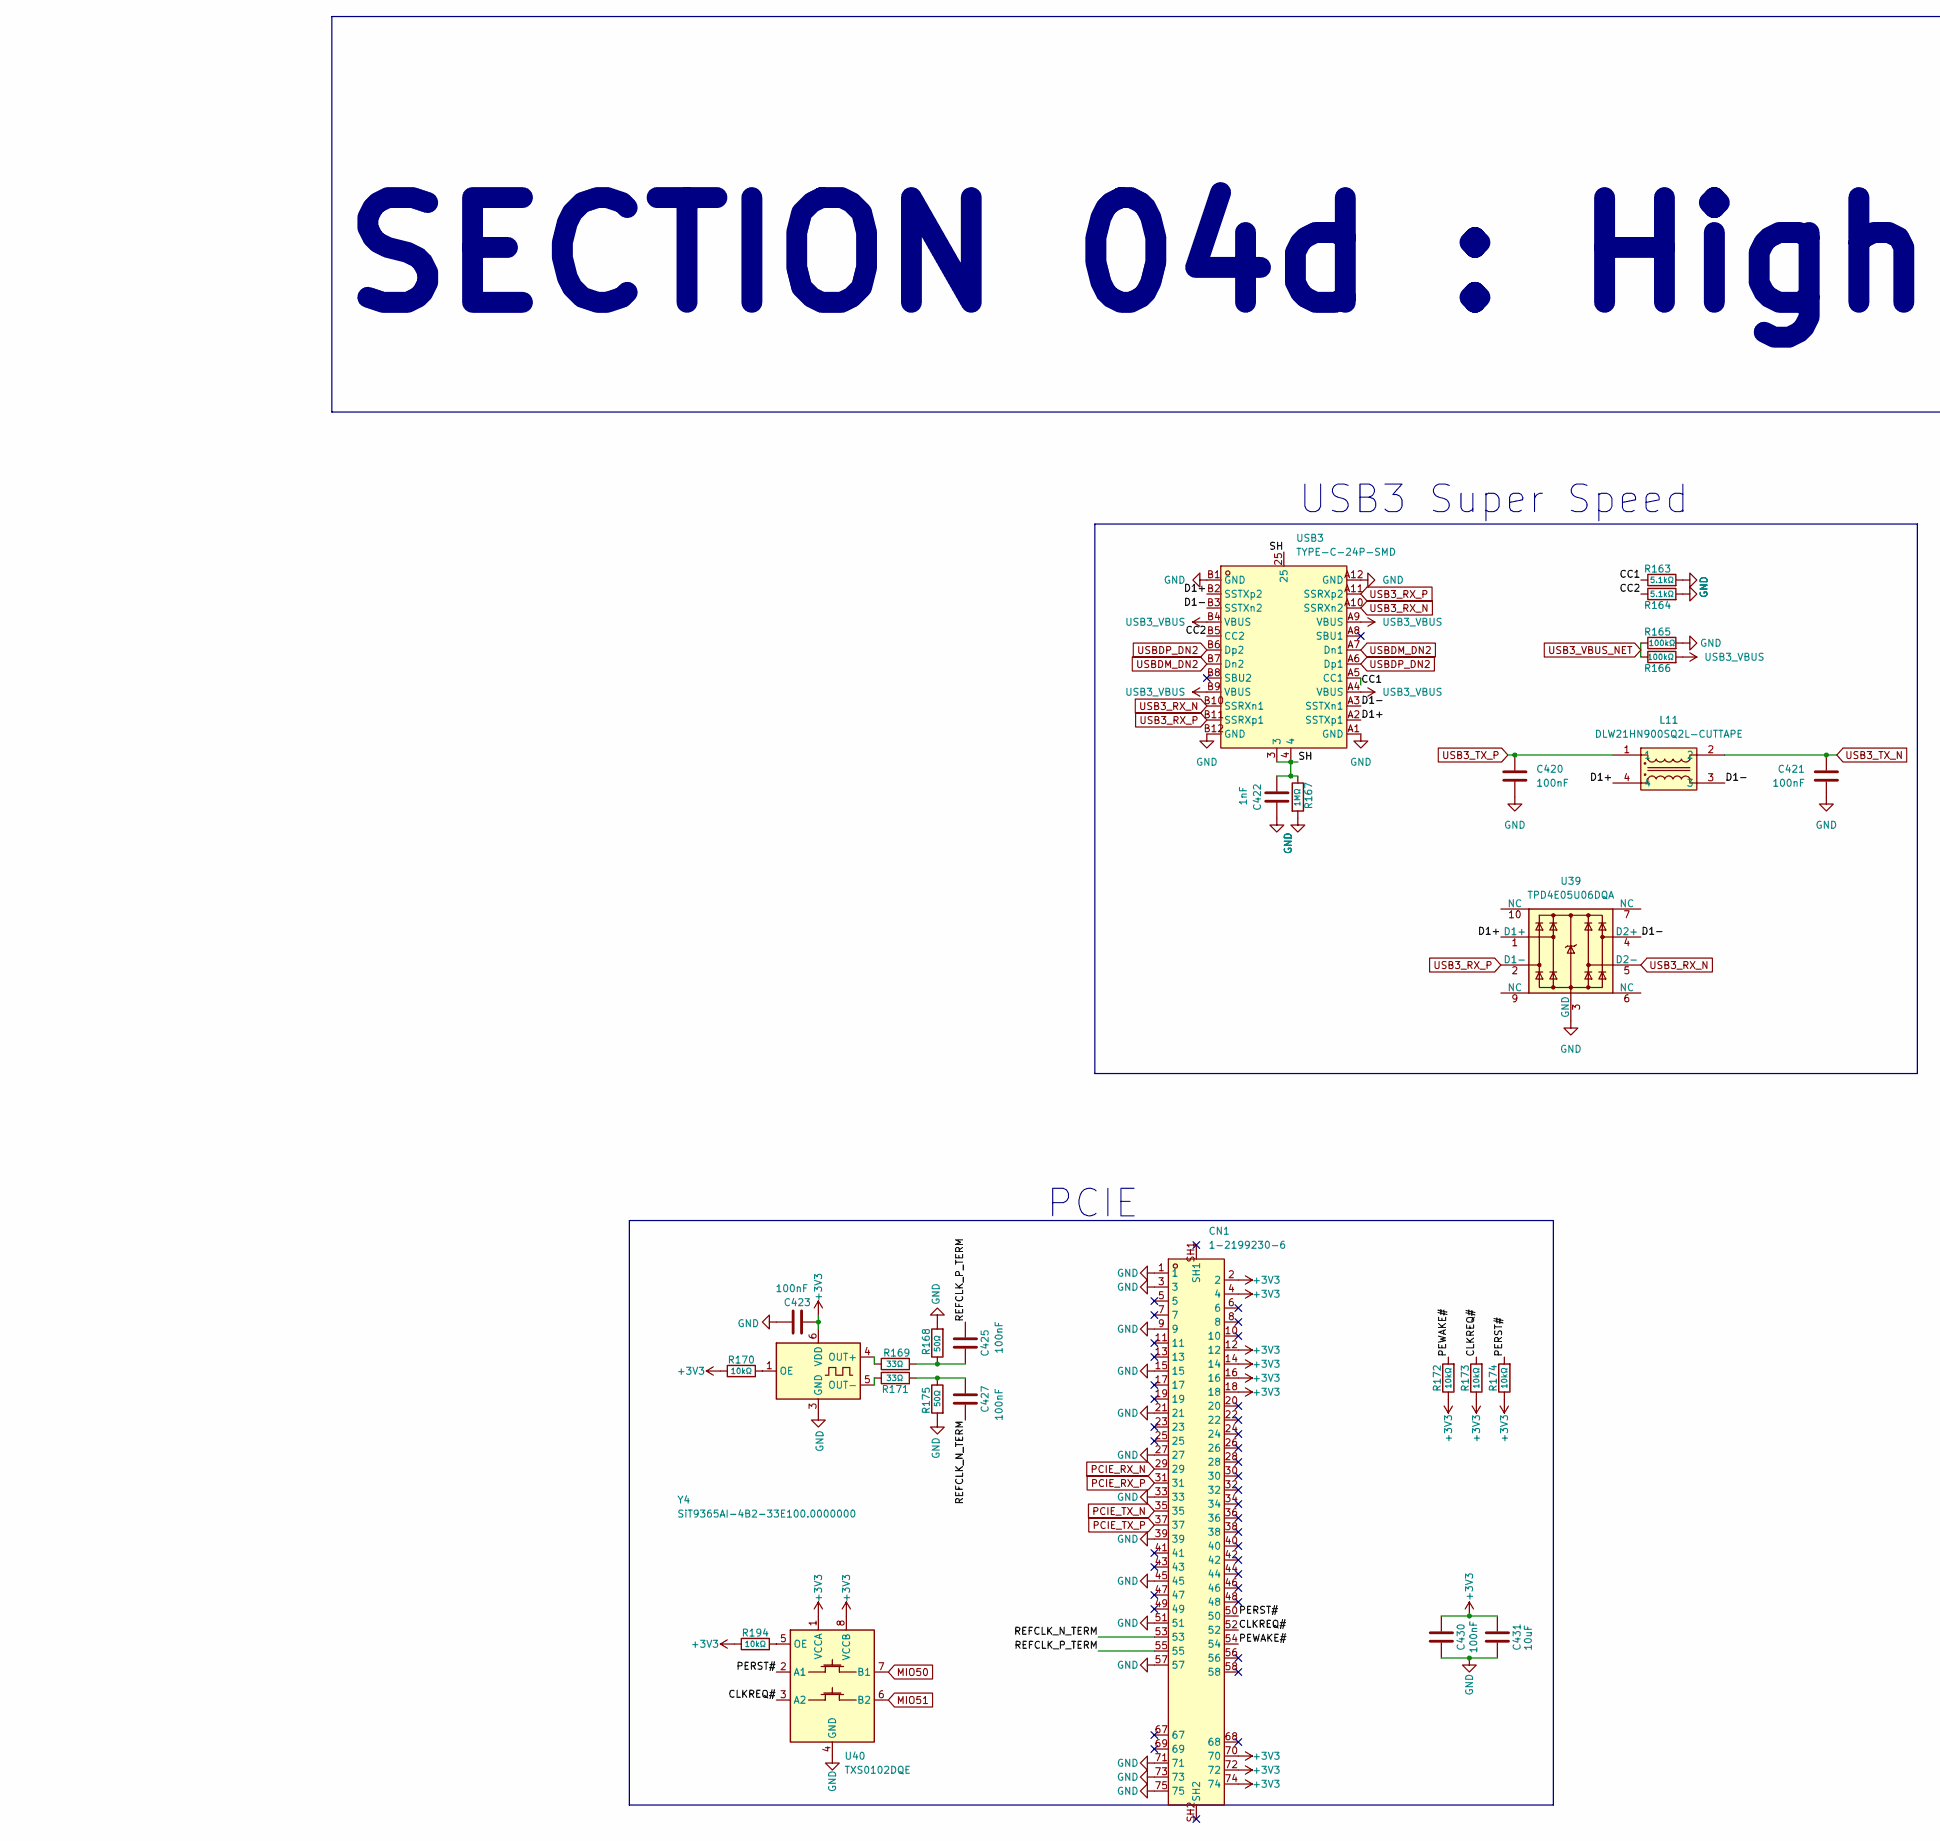
[picture p61: schematic 04d_Zynq_PS_HighSpeed.kicad_sch, part in row 1, column 1]

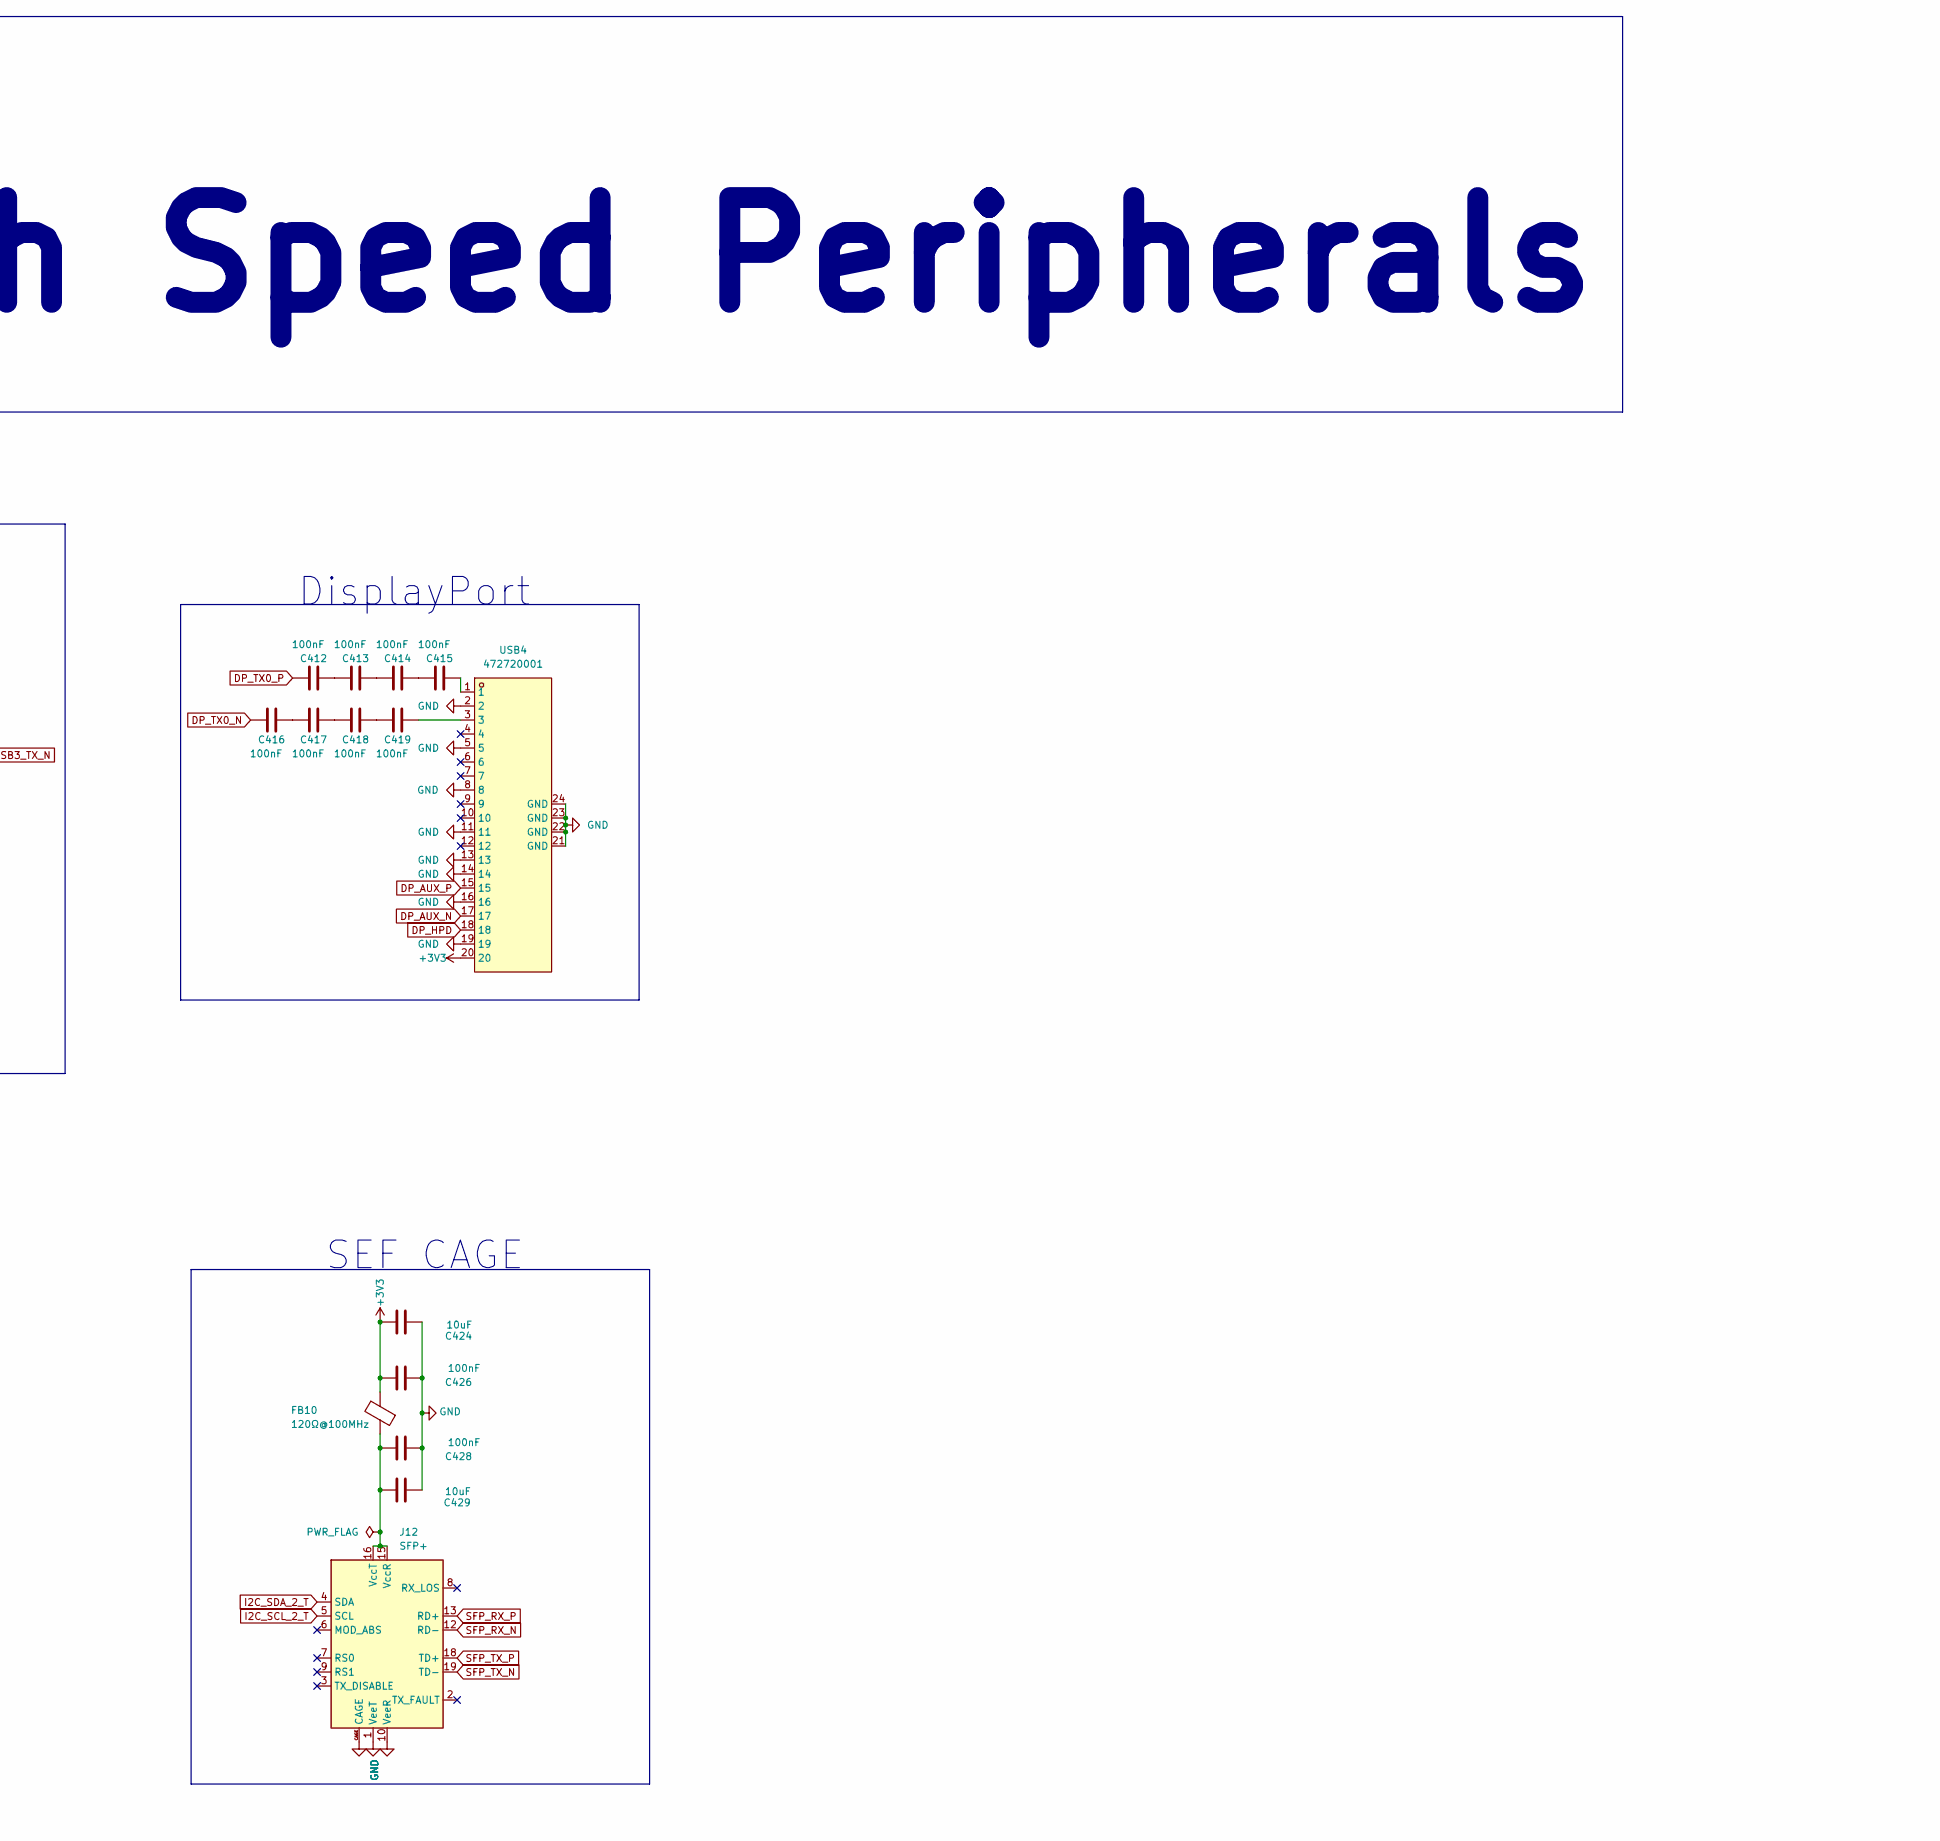
[picture p62: schematic 04d_Zynq_PS_HighSpeed.kicad_sch, part in row 1, column 2]

Parts:
C412, C413, C414, C415, C416, C417, C418, C419, C420, C421, C423, C425, C426, C427, C428, C430: 100nF; C_0402_1005Metric
C422: 1nF; C_0402_1005Metric
C424, C429, C431: 10uF; C_0805_2012Metric
CN1: 1-2199230-6; PCIE-SMD_1-2199230-6; MPN 1-2199230-6; LCSC Part C4710843
FB10: 120Ω@100MHz; L_01005_0402Metric
J12: SFP+; Connector_SFP_and_Cage
L11: DLW21HN900SQ2L-CUTTAPE; FILTER-SMD_4P-L2.0-W1.3-BL_DLW21; MPN DLW21HN900SQ2L; LCSC Part C80529
R163, R164: 5.1kΩ; R_0402_1005Metric
R165, R166: 100kΩ; R_0402_1005Metric
R167: 1MΩ; R_0402_1005Metric
R168, R175: 50Ω; R_0402_1005Metric
R169, R171: 33Ω; R_0402_1005Metric
R170, R172, R173, R174, R194: 10kΩ; R_0402_1005Metric
U39: TPD4E05U06DQA; USON-10_2.5x1.0mm_P0.5mm
U40: TXS0102DQE; X2SON-8_1.4x1mm_P0.35mm
USB3: TYPE-C-24P-SMD; USB-C-SMD_TYPE-C-24P-SMD; MPN TYPE-C-24P-SMD; LCSC Part C53207146
USB4: 472720001; CONN-SMD_472720001; MPN 472720001; LCSC Part C587824
Y4: SiT9365AI-4B2-33E100.0000000; Oscillator_SMD_SiTime_PQFD-6L_3.2x2.5mm

Connections:
+3V3: C423.2, C424.2, C426.2, C430.2, C431.2, CN1.2, CN1.4, CN1.12, CN1.14, CN1.16, CN1.18, CN1.70, CN1.72, CN1.74, FB10.2, R170.1, R172.1, R173.1, R174.1, R194.1, U40.1 (VCCA), U40.8 (VCCB), USB4.20, Y4.6 (VDD); also elsewhere on the board
/Zynq Section/High Speed Peripherals/CC1: R163.1, USB3.A5 (CC1)
/Zynq Section/High Speed Peripherals/CC2: R164.1, USB3.B5 (CC2)
/Zynq Section/High Speed Peripherals/CLKREQ#: CN1.52, R173.2, U40.3 (A2)
/Zynq Section/High Speed Peripherals/D1+: L11.4, U39.1 (D1+), USB3.A2 (SSTXp1), USB3.B2 (SSTXp2)
/Zynq Section/High Speed Peripherals/D1-: L11.3, U39.4 (D2+), USB3.A3 (SSTXn1), USB3.B3 (SSTXn2)
/Zynq Section/High Speed Peripherals/PERST#: CN1.50, R174.2, U40.2 (A1)
/Zynq Section/High Speed Peripherals/PEWAKE#: CN1.54, R172.2
/Zynq Section/High Speed Peripherals/REFCLK_N_TERM: C427.1, CN1.53
/Zynq Section/High Speed Peripherals/REFCLK_P_TERM: C425.1, CN1.55
/Zynq Section/High Speed Peripherals/SH: C422.2, R167.1, USB3.3, USB3.4, USB3.25
DP_AUX_N: USB4.17; also elsewhere on the board
DP_AUX_P: USB4.15; also elsewhere on the board
DP_HPD: USB4.18
DP_TX0_N: C416.1; also elsewhere on the board
DP_TX0_P: C412.1; also elsewhere on the board
GND: C420.2, C421.2, C422.1, C423.1, C424.1, C426.1, C428.1, C429.1, C430.1, C431.1, CN1.1, CN1.3, CN1.9, CN1.15, CN1.21, CN1.27, CN1.33, CN1.39, CN1.45, CN1.51, CN1.57, CN1.71, CN1.73, CN1.75, J12.1 (VeeT), J12.10 (VeeR), J12.11 (VeeR), J12.14 (VeeR), J12.17 (VeeT), J12.20 (VeeT), J12.CAGE, R163.2, R164.2, R165.2, R167.2, R168.2, R175.2, U39.3 (GND), U39.8 (GND), U40.4 (GND), USB3.A1 (GND), USB3.A12 (GND), USB3.B1 (GND), USB3.B12 (GND), USB4.2, USB4.5, USB4.8, USB4.11, USB4.13, USB4.14, USB4.16, USB4.19, USB4.21 (GND), USB4.22 (GND), USB4.23 (GND), USB4.24 (GND), Y4.3 (GND); also elsewhere on the board
I2C_SCL_2_T: J12.5 (SCL); also elsewhere on the board
I2C_SDA_2_T: J12.4 (SDA); also elsewhere on the board
MIO50: U40.7 (B1); also elsewhere on the board
MIO51: U40.6 (B2); also elsewhere on the board
unnamed: C412.2, C413.1
unnamed: C413.2, C414.1
unnamed: C414.2, C415.1
unnamed: C415.2, USB4.1
unnamed: C416.2, C417.1
unnamed: C417.2, C418.1
unnamed: C418.2, C419.1
unnamed: C419.2, USB4.3
unnamed: C425.2, R168.1, R169.2
unnamed: C427.2, R171.2, R175.1
unnamed: C428.2, C429.2, FB10.1, J12.15 (VccR), J12.16 (VccT)
unnamed: R194.2, U40.5 (OE)
unnamed: R170.2, Y4.1 (OE)
unnamed: R169.1, Y4.4 (OUT+)
unnamed: R171.1, Y4.5 (OUT-)
PCIE_RX_N: CN1.29; also elsewhere on the board
PCIE_RX_P: CN1.31; also elsewhere on the board
PCIE_TX_N: CN1.35; also elsewhere on the board
PCIE_TX_P: CN1.37; also elsewhere on the board
SFP_RX_N: J12.12 (RD-); also elsewhere on the board
SFP_RX_P: J12.13 (RD+); also elsewhere on the board
SFP_TX_N: J12.19 (TD-); also elsewhere on the board
SFP_TX_P: J12.18 (TD+); also elsewhere on the board
USB3_RX_N: U39.5 (D2-), USB3.A10 (SSRXn2), USB3.B10 (SSRXn1); also elsewhere on the board
USB3_RX_P: U39.2 (D1-), USB3.A11 (SSRXp2), USB3.B11 (SSRXp1); also elsewhere on the board
USB3_TX_N: C421.1, L11.2; also elsewhere on the board
USB3_TX_P: C420.1, L11.1; also elsewhere on the board
USB3_VBUS: R166.2, USB3.A4 (VBUS), USB3.A9 (VBUS), USB3.B4 (VBUS), USB3.B9 (VBUS); also elsewhere on the board
USB3_VBUS_NET: R165.1, R166.1; also elsewhere on the board
USBDM_DN2: USB3.A7 (Dn1), USB3.B7 (Dn2); also elsewhere on the board
USBDP_DN2: USB3.A6 (Dp1), USB3.B6 (Dp2); also elsewhere on the board

Notes on the sheet:
SECTION 04d : High Speed Peripherals
DisplayPort
USB3 Super Speed
PCIE
SEF CAGE
