damnitzhemanth-oss/FusionBoard/PCB/Devboard.kicad_pcb

## KiCad design PCB/Devboard.kicad_pcb (continued)

Schematic: 04a_Zynq_Core.kicad_sch

Parts:
C121, C122, C123, C124, C125, C126, C127, C128, C129, C130, C131, C132, C133, C134, C135, C136, C137, C138, C139, C140, C141, C142, C143, C144, C145, C146, C147, C148, C149, C150, C151, C152, C153, C155, C156, C157, C158, C159, C160, C161, C162, C163, C164, C165, C166, C167, C168, C169, C170, C171, C172, C173, C175, C176, C177, C178, C179, C180, C181, C182, C183, C184, C185, C186, C187, C188, C189, C190, C191, C192, C193, C194, C195, C196, C197, C198, C199, C200, C201, C202, C203, C204, C205, C206, C207, C208, C209, C210, C211, C212, C213, C214, C215, C216, C217, C218, C219, C220, C221, C222, C223, C224, C225, C226, C227, C228, C229, C230, C231, C232, C233, C234, C235, C236, C237, C238, C239, C240, C241, C242, C243, C244, C245, C246, C247, C248, C249, C250, C251: 0.1uF; C_0402_1005Metric
C154, C174: 47uF; C_1210_3225Metric
R103: 220Ω; R_0402_1005Metric
U27: xczu4evfbvb900pkg; XCZU4EVFBVB900PKG

Connections:
+0V9_GTR: C204.2, C206.2, C217.1, C219.1, U27.A10 (MGTAVCC_R), U27.C10 (MGTAVCC_R), U27.F8 (MGTAVCC_R), U27.H8 (MGTAVCC_R), U27.M8 (MGTAVCC_R), U27.P8 (MGTAVCC_R); also elsewhere on the board
+0V9_VCU: C166.2, C167.2, C183.1, C184.1, U27.AB18 (VCCINT_VCU), U27.AB19 (VCCINT_VCU), U27.AB20 (VCCINT_VCU), U27.AB21 (VCCINT_VCU), U27.V8 (VCCINT_IO); also elsewhere on the board
+0V85: C121.2, C135.2, C136.2, C137.2, C138.2, C139.2, C140.1, C154.1, C155.1, C156.1, C157.1, C158.1, U27.L11 (VCCINT), U27.L13 (VCCINT), U27.L17 (VCCINT), U27.M12 (VCCINT), U27.M14 (VCCINT), U27.M16 (VCCINT), U27.M18 (VCCINT), U27.N11 (VCCINT), U27.N13 (VCCINT), U27.N15 (VCCINT), U27.N17 (VCCINT), U27.P12 (VCCINT), U27.P14 (VCCINT), U27.P16 (VCCINT), U27.R10 (VCCBRAM), U27.R11 (VCCINT), U27.R13 (VCCINT), U27.R17 (VCCINT), U27.T9 (VCCINT_IO), U27.T10 (VCCBRAM), U27.T12 (VCCINT), U27.T16 (VCCINT), U27.U8 (VCCINT_IO), U27.U9 (VCCINT_IO), U27.U10 (VCCBRAM), U27.U11 (VCCINT), U27.U13 (VCCINT), U27.U17 (VCCINT), U27.V10 (VCCBRAM), U27.V12 (VCCINT), U27.V16 (VCCINT), U27.W11 (VCCINT), U27.W13 (VCCINT), U27.W15 (VCCINT), U27.Y12 (VCCINT), U27.Y14 (VCCINT); also elsewhere on the board
+0V85_GTR: C192.2, C201.1, U27.J23 (PS_MGTRAVCC), U27.L23 (PS_MGTRAVCC); also elsewhere on the board
+0V85_PS: C159.2, C161.2, C162.2, C164.2, C165.2, C172.2, C173.2, C174.1, C176.1, C178.1, C179.1, C181.1, C182.1, U27.AA18 (VCC_PSINTFP), U27.AA20 (VCC_PSINTFP), U27.AA21 (VCC_PSINTFP_DDR), U27.AA22 (VCC_PSINTFP_DDR), U27.V17 (VCC_PSINTLP), U27.V18 (VCC_PSINTLP), U27.V19 (VCC_PSINTLP), U27.W17 (VCC_PSINTLP), U27.W19 (VCC_PSINTLP), U27.W20 (VCC_PSINTLP), U27.Y16 (VCC_PSINTFP), U27.Y17 (VCC_PSINTFP), U27.Y18 (VCC_PSINTFP), U27.Y19 (VCC_PSINTFP), U27.Y20 (VCC_PSINTFP), U27.Y22 (VCC_PSINTFP_DDR); also elsewhere on the board
+1V2: C189.2, C191.2, C195.2, C198.1, C200.1, U27.AA4 (VCCO_66), U27.AA24 (VCCO_PSDDR_504), U27.AB27 (VCCO_PSDDR_504), U27.AC25 (VCCO_PSDDR_504), U27.AD3 (VCCO_66), U27.AD8 (VCCO_66), U27.AD28 (VCCO_PSDDR_504), U27.AE26 (VCCO_PSDDR_504), U27.AG27 (VCCO_PSDDR_504), U27.AK26 (VCCO_PSDDR_504); also elsewhere on the board
+1V2_GTH: C207.2, C211.2, C214.2, C215.1, C220.1, C224.1, U27.A6 (MGTAVTT_R), U27.B8 (MGTAVTT_R), U27.C6 (MGTAVTT_R), U27.D8 (MGTAVTT_R), U27.E6 (MGTAVTT_R), U27.G6 (MGTAVTT_R), U27.J6 (MGTAVTT_R), U27.L6 (MGTAVTT_R), U27.N6 (MGTAVTT_R), U27.R6 (MGTAVTT_R), U27.U6 (MGTAVTT_R); also elsewhere on the board
+1V2_PS: C194.2, C203.1, U27.U18 (VCC_PSDDR_PLL), U27.U19 (VCC_PSDDR_PLL); also elsewhere on the board
+1V8: C168.2, C169.2, C170.2, C171.2, C175.2, C185.1, C186.1, C187.1, C188.1, C212.2, C225.1, C229.2, C230.2, C231.2, C232.2, C238.2, C239.1, C243.1, C244.1, C245.1, C246.1, U27.AC15 (VCCO_64), U27.AE11 (VCCO_65), U27.AF14 (VCCO_64), U27.AG7 (VCCO_65), U27.AG17 (VCCO_64), U27.AH10 (VCCO_65), U27.E10 (MGTVCCAUX_R), U27.G10 (MGTVCCAUX_R), U27.K10 (VCCAUX), U27.L10 (VCCAUX), U27.M10 (VCCAUX_IO), U27.N10 (VCCAUX_IO), U27.P10 (VCCAUX_IO), U27.R15 (VCCADC), U27.T22 (VCC_PSAUX), U27.U21 (VCC_PSAUX), U27.V21 (VCC_PSAUX), U27.V22 (VCC_PSAUX); also elsewhere on the board
+1V8_CLEAN: C193.2, C196.2, C202.1, U27.T18 (VCC_PSPLL), U27.T20 (VCC_PSPLL), U27.T21 (VCC_PSPLL); also elsewhere on the board
+1V8_MGTRAVTT: C213.2, C216.2, C226.1, U27.H25 (PS_MGTRAVTT), U27.K25 (PS_MGTRAVTT), U27.L27 (PS_MGTRAVTT); also elsewhere on the board
+1V8_VCCADC: C197.2, U27.W22 (VCC_PSADC); also elsewhere on the board
+3V3: C227.2, C228.2, C233.2, C237.2, C240.2, C241.1, C242.1, C247.1, C251.1, U27.B22 (VCCO_PSIO1_501), U27.B27 (VCCO_PSIO2_502), U27.D13 (VCCO_46), U27.D18 (VCCO_PSIO0_500), U27.D23 (VCCO_PSIO1_501), U27.D28 (VCCO_PSIO2_502), U27.E16 (VCCO_45), U27.E21 (VCCO_PSIO1_501), U27.E26 (VCCO_PSIO2_502), U27.F19 (VCCO_PSIO0_500), U27.G12 (VCCO_46), U27.H15 (VCCO_45), U27.J18 (VCCO_PSIO0_500), U27.N20 (VCCO_PSIO3_503), U27.P18 (VCCO_PSIO3_503); also elsewhere on the board
ADC_CLKOUTM: U27.AE9 (IO_L10P_T1U_N6_QBC_AD4P_65); also elsewhere on the board
ADC_CLKOUTP: U27.AE8 (IO_L10N_T1U_N7_QBC_AD4N_65); also elsewhere on the board
ADC_DA0_M: U27.AK10 (IO_L5N_T0U_N9_AD14N_65); also elsewhere on the board
ADC_DA0_P: U27.AJ10 (IO_L5P_T0U_N8_AD14P_65); also elsewhere on the board
ADC_DA2_M: U27.AJ9 (IO_L8N_T1L_N3_AD5N_65); also elsewhere on the board
ADC_DA2_P: U27.AH9 (IO_L8P_T1L_N2_AD5P_65); also elsewhere on the board
ADC_DA4_M: U27.AK11 (IO_L4N_T0U_N7_DBC_AD7N_65); also elsewhere on the board
ADC_DA4_P: U27.AJ11 (IO_L4P_T0U_N6_DBC_AD7P_SMBALERT_65); also elsewhere on the board
ADC_DA6_M: U27.AJ7 (IO_L12N_T1U_N11_GC_65); also elsewhere on the board
ADC_DA6_P: U27.AJ6 (IO_L13N_T2L_N1_GC_QBC_65); also elsewhere on the board
ADC_DA8_M: U27.AH7 (IO_L12P_T1U_N10_GC_65); also elsewhere on the board
ADC_DA8_P: U27.AH8 (IO_L11N_T1U_N9_GC_65); also elsewhere on the board
ADC_DA10_M: U27.AG10 (IO_L6N_T0U_N11_AD6N_65); also elsewhere on the board
ADC_DA10_P: U27.AF10 (IO_L6P_T0U_N10_AD6P_65); also elsewhere on the board
ADC_DA12_M: U27.AF7 (IO_L9N_T1L_N5_AD12N_65); also elsewhere on the board
ADC_DA12_P: U27.AF8 (IO_L9P_T1L_N4_AD12P_65); also elsewhere on the board
ADC_DB0_M: U27.AK7 (IO_L15P_T2L_N4_AD11P_65); also elsewhere on the board
ADC_DB0_P: U27.AK6 (IO_L15N_T2L_N5_AD11N_65); also elsewhere on the board
ADC_DB2_M: U27.AJ4 (IO_L17P_T2U_N8_AD10P_65); also elsewhere on the board
ADC_DB2_P: U27.AK4 (IO_L17N_T2U_N9_AD10N_65); also elsewhere on the board
ADC_DB4_M: U27.AF5 (IO_L18N_T2U_N11_AD2N_65); also elsewhere on the board
ADC_DB4_P: U27.AF6 (IO_L18P_T2U_N10_AD2P_65); also elsewhere on the board
ADC_DB6_M: U27.AJ1 (IO_L20N_T3L_N3_AD1N_65); also elsewhere on the board
ADC_DB6_P: U27.AJ2 (IO_L20P_T3L_N2_AD1P_65); also elsewhere on the board
ADC_DB8_M: U27.AK2 (IO_L19N_T3L_N1_DBC_AD9N_65); also elsewhere on the board
ADC_DB8_P: U27.AK3 (IO_L19P_T3L_N0_DBC_AD9P_65); also elsewhere on the board
ADC_DB10_M: U27.AG3 (IO_L22N_T3U_N7_DBC_AD0N_65); also elsewhere on the board
ADC_DB10_P: U27.AG4 (IO_L22P_T3U_N6_DBC_AD0P_65); also elsewhere on the board
ADC_DB12_M: U27.AH2 (IO_L21N_T3L_N5_AD8N_65); also elsewhere on the board
ADC_DB12_P: U27.AH3 (IO_L21P_T3L_N4_AD8P_65); also elsewhere on the board
ADS_CS: U27.G16 (IO_L5P_HDGC_45); also elsewhere on the board
ADS_DIN: U27.E17 (IO_L7P_HDGC_45); also elsewhere on the board
ADS_DOUT: U27.E15 (IO_L8P_HDGC_45); also elsewhere on the board
ADS_DRDY: U27.D16 (IO_L9P_AD11P_45); also elsewhere on the board
ADS_SCLK: U27.F16 (IO_L6P_HDGC_45); also elsewhere on the board
ADS_SYNC: U27.C17 (IO_L10P_AD10P_45); also elsewhere on the board
CAM_PWDN: U27.F18 (PS_MIO10); also elsewhere on the board
CAM_RST_N: U27.H18 (PS_MIO12); also elsewhere on the board
DP_AUX_N: U27.E20 (PS_MIO8); also elsewhere on the board
DP_AUX_P: U27.E19 (PS_MIO7); also elsewhere on the board
DP_RX0_N: U27.H28 (PS_MGTRRXN2_505)
DP_RX0_P: U27.H27 (PS_MGTRRXP2_505)
DP_TX0_N: U27.J26 (PS_MGTRTXN2_505); also elsewhere on the board
DP_TX0_P: U27.J25 (PS_MGTRTXP2_505); also elsewhere on the board
EXP_LANE0_RX_N: U27.C3 (MGTHRXN1_226)
EXP_LANE0_RX_P: U27.C4 (MGTHRXP1_226)
EXP_LANE0_TX_N: U27.C7 (MGTHTXN1_226)
EXP_LANE0_TX_P: U27.C8 (MGTHTXP1_226)
EXP_LANE1_RX_N: U27.B1 (MGTHRXN2_226)
EXP_LANE1_RX_P: U27.B2 (MGTHRXP2_226)
EXP_LANE1_TX_N: U27.B5 (MGTHTXN2_226)
EXP_LANE1_TX_P: U27.B6 (MGTHTXP2_226)
EXP_LANE2_RX_N: U27.A3 (MGTHRXN3_226)
EXP_LANE2_RX_P: U27.A4 (MGTHRXP3_226)
EXP_LANE2_TX_N: U27.A7 (MGTHTXN3_226)
EXP_LANE2_TX_P: U27.A8 (MGTHTXP3_226)
EXP_LANE3_RX_N: U27.H1 (MGTHRXN0_225)
EXP_LANE3_RX_P: U27.H2 (MGTHRXP0_225)
EXP_LANE3_TX_N: U27.H5 (MGTHTXN0_225)
EXP_LANE3_TX_P: U27.H6 (MGTHTXP0_225)
EXP_LANE4_RX_N: U27.G3 (MGTHRXN1_225)
EXP_LANE4_RX_P: U27.G4 (MGTHRXP1_225)
EXP_LANE4_TX_N: U27.G7 (MGTHTXN1_225)
EXP_LANE4_TX_P: U27.G8 (MGTHTXP1_225)
FAN_TACH: U27.J21 (PS_MIO48); also elsewhere on the board
GEM_RST: U27.C23 (PS_MIO38); also elsewhere on the board
GEM_RXC: U27.D26 (PS_MIO70); also elsewhere on the board
GEM_RXD0: U27.D30 (PS_MIO71); also elsewhere on the board
GEM_RXD1: U27.E27 (PS_MIO72); also elsewhere on the board
GEM_RXD2: U27.E30 (PS_MIO73); also elsewhere on the board
GEM_RXD3: U27.E29 (PS_MIO74); also elsewhere on the board
GEM_RX_CTL: U27.D29 (PS_MIO75); also elsewhere on the board
GEM_TXC: U27.B30 (PS_MIO64); also elsewhere on the board
GEM_TXD0: U27.D25 (PS_MIO65); also elsewhere on the board
GEM_TXD1: U27.C27 (PS_MIO66); also elsewhere on the board
GEM_TXD2: U27.C28 (PS_MIO67); also elsewhere on the board
GEM_TXD3: U27.C29 (PS_MIO68); also elsewhere on the board
GEM_TX_CTL: U27.D27 (PS_MIO69); also elsewhere on the board
GND: C121.1, C122.1, C123.1, C124.1, C125.1, C126.1, C127.1, C128.1, C129.1, C130.1, C131.1, C132.1, C133.1, C134.1, C135.1, C136.1, C137.1, C138.1, C139.1, C140.2, C141.2, C142.2, C143.2, C144.2, C145.2, C146.2, C147.2, C148.2, C149.2, C150.2, C151.2, C152.2, C153.2, C154.2, C155.2, C156.2, C157.2, C158.2, C159.1, C160.1, C161.1, C162.1, C163.1, C164.1, C165.1, C166.1, C167.1, C168.1, C169.1, C170.1, C171.1, C172.1, C173.1, C174.2, C175.1, C176.2, C177.2, C178.2, C179.2, C180.2, C181.2, C182.2, C183.2, C184.2, C185.2, C186.2, C187.2, C188.2, C189.1, C190.1, C191.1, C193.1, C194.1, C195.1, C196.1, C197.1, C198.2, C199.2, C200.2, C202.2, C203.2, C204.1, C205.1, C206.1, C207.1, C208.1, C209.1, C210.1, C211.1, C212.1, C213.1, C214.1, C215.2, C216.1, C217.2, C218.2, C219.2, C220.2, C221.2, C222.2, C223.2, C224.2, C225.2, C226.2, C227.1, C228.1, C229.1, C230.1, C231.1, C232.1, C233.1, C234.1, C235.1, C236.1, C237.1, C238.1, C239.2, C240.1, C241.2, C242.2, C243.2, C244.2, C245.2, C246.2, C247.2, C248.2, C249.2, C250.2, C251.2, R103.2, U27.A1 (GND), U27.A2 (GND), U27.A5 (GND), U27.A9 (GND), U27.A11 (GND), U27.A30 (GND), U27.AA9 (GND), U27.AA19 (GND), U27.AA29 (GND), U27.AB2 (GND), U27.AB7 (GND), U27.AB12 (GND), U27.AB17 (GND), U27.AB22 (GND), U27.AC5 (GND), U27.AC10 (GND), U27.AC20 (GND), U27.AD13 (GND), U27.AD18 (GND), U27.AD23 (GND), U27.AE6 (GND), U27.AE16 (GND), U27.AE21 (GND), U27.AF4 (GND), U27.AF9 (GND), U27.AF19 (GND), U27.AF24 (GND), U27.AF29 (GND), U27.AG2 (GND), U27.AG12 (GND), U27.AG22 (GND), U27.AH5 (GND), U27.AH15 (GND), U27.AH20 (GND), U27.AH25 (GND), U27.AJ3 (GND), U27.AJ8 (GND), U27.AJ13 (GND), U27.AJ18 (GND), U27.AJ23 (GND), U27.AJ28 (GND), U27.AK1 (GND), U27.AK30 (GND), U27.B3 (GND), U27.B4 (GND), U27.B7 (GND), U27.B11 (GND), U27.B13 (GND), U27.B17 (GND), U27.C1 (GND), U27.C2 (GND), U27.C5 (GND), U27.C9 (GND), U27.C11 (GND), U27.C15 (GND), U27.C20 (GND), U27.C25 (GND), U27.C30 (GND), U27.D3 (GND), U27.D4 (GND), U27.D7 (GND), U27.D11 (GND), U27.E1 (GND), U27.E2 (GND), U27.E5 (GND), U27.E9 (GND), U27.E11 (GND), U27.F3 (GND), U27.F4 (GND), U27.F7 (GND), U27.F11 (GND), U27.F14 (GND), U27.F24 (GND), U27.F25 (GND), U27.F26 (GND), U27.F27 (GND), U27.F28 (GND), U27.F29 (GND), U27.F30 (GND), U27.G1 (GND), U27.G2 (GND), U27.G5 (GND), U27.G9 (GND), U27.G11 (GND), U27.G17 (GND), U27.G22 (GND), U27.G23 (GND), U27.G24 (GND), U27.G27 (GND), U27.G28 (GND), U27.H3 (GND), U27.H4 (GND), U27.H7 (GND), U27.H11 (GND), U27.H20 (GND), U27.H22 (GND), U27.H26 (GND), U27.H29 (GND), U27.H30 (GND), U27.J1 (GND), U27.J2 (GND), U27.J5 (GND), U27.J9 (GND), U27.J10 (GND), U27.J11 (GND), U27.J13 (GND), U27.J22 (GND), U27.J24 (GND), U27.J27 (GND), U27.J28 (GND), U27.K3 (GND), U27.K4 (GND), U27.K9 (GND), U27.K22 (GND), U27.K26 (GND), U27.K29 (GND), U27.K30 (GND), U27.L1 (GND), U27.L2 (GND), U27.L5 (GND), U27.L9 (GND), U27.L12 (GND), U27.L16 (GND), U27.L18 (GND), U27.L22 (GND), U27.L24 (GND), U27.L28 (GND), U27.M3 (GND), U27.M4 (GND), U27.M7 (GND), U27.M9 (GND), U27.M11 (GND), U27.M13 (GND), U27.M15 (GND), U27.M17 (GND), U27.M22 (GND), U27.M26 (GND), U27.M29 (GND), U27.M30 (GND), U27.N1 (GND), U27.N2 (GND), U27.N5 (GND), U27.N9 (GND), U27.N12 (GND), U27.N14 (GND), U27.N16 (GND), U27.N23 (GND), U27.N24 (GND), U27.N25 (GND), U27.N26 (GND), U27.N27 (GND), U27.N28 (GND), U27.N29 (GND), U27.N30 (GND), U27.P3 (GND), U27.P4 (GND), U27.P7 (GND), U27.P9 (GND), U27.P11 (GND), U27.P13 (GND), U27.P15 (GND), U27.P17 (GND), U27.R1 (GND), U27.R2 (GND), U27.R5 (GND), U27.R9 (GND), U27.R12 (GND), U27.R14 (GNDADC), U27.R16 (GND), U27.R21 (GND), U27.R26 (GND), U27.T3 (GND), U27.T4 (GND), U27.T7 (GND), U27.T8 (GND), U27.T11 (GND), U27.T13 (GND), U27.T14 (VREFN), U27.T17 (GND), U27.T19 (GND), U27.T24 (GND), U27.T29 (GND), U27.U1 (GND), U27.U2 (GND), U27.U5 (GND), U27.U7 (GND), U27.U12 (GND), U27.U16 (GND), U27.U20 (VCC_PSBATT), U27.U22 (GND), U27.U27 (GND), U27.V3 (GND), U27.V4 (GND), U27.V7 (GND), U27.V9 (GND), U27.V11 (GND), U27.V13 (GND), U27.V20 (GND), U27.V25 (GND), U27.W1 (GND), U27.W2 (GND), U27.W5 (GND), U27.W6 (GND), U27.W12 (GND), U27.W14 (GND), U27.W16 (GND), U27.W18 (GND), U27.W21 (GND_PSADC), U27.W23 (GND), U27.W28 (GND), U27.Y2 (GND), U27.Y3 (GND), U27.Y4 (GND), U27.Y5 (GND), U27.Y11 (GND), U27.Y13 (GND), U27.Y15 (GND), U27.Y21 (GND), U27.Y26 (GND); also elsewhere on the board
GNSS_PPS: U27.F20 (PS_MIO9); also elsewhere on the board
GPIO_BMC_IRQ: U27.B24 (PS_MIO34)
GPIO_BOOT_LED: U27.F21 (PS_MIO37)
GPIO_ESP_IRQ: U27.K21 (PS_MIO47)
GPIO_EXP_RST: U27.K20 (PS_MIO46)
GPIO_PD_IRQ: U27.B23 (PS_MIO35), U27.G18 (PS_MIO11)
GPIO_SD1_PWR_EN: U27.D22 (PS_MIO36)
GTH_REFCLK0_156M_N: U27.D9 (MGTREFCLK0N_226)
GTH_REFCLK0_156M_P: U27.D10 (MGTREFCLK0P_226)
GTH_REFCLK1_156M_N: U27.B9 (MGTREFCLK1N_226)
GTH_REFCLK1_156M_P: U27.B10 (MGTREFCLK1P_226)
I2C0_SCL: U27.A22 (PS_MIO31); also elsewhere on the board
I2C0_SDA: U27.C22 (PS_MIO33); also elsewhere on the board
I2C1_SCL: U27.C21 (PS_MIO30); also elsewhere on the board
I2C1_SDA: U27.G20 (PS_MIO32); also elsewhere on the board
LMS_SCK: U27.J16 (IO_L4P_AD12P_45); also elsewhere on the board
LMX_CSB: U27.J15 (IO_L3P_AD13P_45); also elsewhere on the board
LMX_MUXOUT: U27.L15 (IO_L1P_AD15P_45); also elsewhere on the board
LMX_SDI: U27.K15 (IO_L2P_AD14P_45); also elsewhere on the board
MDIO_MDC: U27.E28 (PS_MIO76); also elsewhere on the board
MDIO_MDIO: U27.E25 (PS_MIO77); also elsewhere on the board
MIO50: U27.J20 (PS_MIO50); also elsewhere on the board
MIO51: U27.H21 (PS_MIO51); also elsewhere on the board
MIPI_CLK_N: U27.AC11 (IO_L3N_T0L_N5_AD15N_66); also elsewhere on the board
MIPI_CLK_P: U27.AB11 (IO_L3P_T0L_N4_AD15P_66); also elsewhere on the board
MIPI_D0_N: U27.AA11 (IO_L2N_T0L_N3_66); also elsewhere on the board
MIPI_D0_P: U27.AA12 (IO_L2P_T0L_N2_66); also elsewhere on the board
MIPI_D1_N: U27.AD12 (IO_L1N_T0L_N1_DBC_66); also elsewhere on the board
MIPI_D1_P: U27.AC12 (IO_L1P_T0L_N0_DBC_66); also elsewhere on the board
MIPI_D2_N: U27.AD10 (IO_L4N_T0U_N7_DBC_AD7N_66); also elsewhere on the board
MIPI_D2_P: U27.AD11 (IO_L4P_T0U_N6_DBC_AD7P_66); also elsewhere on the board
MIPI_D3_N: U27.AB9 (IO_L5N_T0U_N9_AD14N_66); also elsewhere on the board
MIPI_D3_P: U27.AB10 (IO_L5P_T0U_N8_AD14P_66); also elsewhere on the board
unnamed: C122.2, C141.1
unnamed: C123.2, C142.1
unnamed: C124.2, C143.1
unnamed: C125.2, C144.1
unnamed: C126.2, C145.1
unnamed: C127.2, C146.1
unnamed: C128.2, C147.1
unnamed: C129.2, C148.1
unnamed: C130.2, C149.1
unnamed: C131.2, C150.1
unnamed: C132.2, C151.1
unnamed: C133.2, C152.1
unnamed: C134.2, C153.1
unnamed: C160.2, C177.1
unnamed: C163.2, C180.1
unnamed: C190.2, C199.1
unnamed: C192.1, C201.2
unnamed: C205.2, C218.1
unnamed: C208.2, C221.1
unnamed: C209.2, C222.1
unnamed: C210.2, C223.1
unnamed: C234.2, C248.1
unnamed: C235.2, C249.1
unnamed: C236.2, C250.1
unnamed: R103.1, U27.M25 (PS_MGTRREF_505)
PCIE_RX_N: U27.J30 (PS_MGTRRXN1_505); also elsewhere on the board
PCIE_RX_P: U27.J29 (PS_MGTRRXP1_505); also elsewhere on the board
PCIE_TX_N: U27.K28 (PS_MGTRTXN1_505); also elsewhere on the board
PCIE_TX_P: U27.K27 (PS_MGTRTXP1_505); also elsewhere on the board
PS_DDR_A0: U27.AH30 (PS_DDR_A0); also elsewhere on the board
PS_DDR_A1: U27.AG30 (PS_DDR_A1); also elsewhere on the board
PS_DDR_A2: U27.AK29 (PS_DDR_A2); also elsewhere on the board
PS_DDR_A3: U27.AJ30 (PS_DDR_A3); also elsewhere on the board
PS_DDR_A4: U27.AK28 (PS_DDR_A4); also elsewhere on the board
PS_DDR_A5: U27.AK27 (PS_DDR_A5); also elsewhere on the board
PS_DDR_A6: U27.AF27 (PS_DDR_A6); also elsewhere on the board
PS_DDR_A7: U27.AE27 (PS_DDR_A7); also elsewhere on the board
PS_DDR_A8: U27.AF26 (PS_DDR_A8); also elsewhere on the board
PS_DDR_A9: U27.AG26 (PS_DDR_A9); also elsewhere on the board
PS_DDR_A10: U27.AE29 (PS_DDR_A10); also elsewhere on the board
PS_DDR_A11: U27.AE28 (PS_DDR_A11); also elsewhere on the board
PS_DDR_A12: U27.AH29 (PS_DDR_A12); also elsewhere on the board
PS_DDR_A13: U27.AH28 (PS_DDR_A13); also elsewhere on the board
PS_DDR_A14: U27.AG29 (PS_DDR_A14); also elsewhere on the board
PS_DDR_A15: U27.AJ29 (PS_DDR_A15); also elsewhere on the board
PS_DDR_A16: U27.AH27 (PS_DDR_A16); also elsewhere on the board
PS_DDR_A17: U27.AJ27 (PS_DDR_A17)
PS_DDR_ACT_N: U27.AD26 (PS_DDR_ACT_N); also elsewhere on the board
PS_DDR_ALERT_N: U27.AB24 (PS_DDR_ALERT_N); also elsewhere on the board
PS_DDR_BA0: U27.AD27 (PS_DDR_BA0); also elsewhere on the board
PS_DDR_BA1: U27.AC26 (PS_DDR_BA1); also elsewhere on the board
PS_DDR_BG0: U27.AC28 (PS_DDR_BG0); also elsewhere on the board
PS_DDR_BG1: U27.AC27 (PS_DDR_BG1)
PS_DDR_CK0: U27.AE30 (PS_DDR_CK0); also elsewhere on the board
PS_DDR_CK1: U27.AF28 (PS_DDR_CK1)
PS_DDR_CKE0: U27.AC30 (PS_DDR_CKE0); also elsewhere on the board
PS_DDR_CKE1: U27.AB28 (PS_DDR_CKE1)
PS_DDR_CK_N0: U27.AF30 (PS_DDR_CK_N0); also elsewhere on the board
PS_DDR_CK_N1: U27.AG28 (PS_DDR_CK_N1)
PS_DDR_CS_N0: U27.AD30 (PS_DDR_CS_N0); also elsewhere on the board
PS_DDR_CS_N1: U27.AD29 (PS_DDR_CS_N1)
PS_DDR_DM0: U27.AJ20 (PS_DDR_DM0); also elsewhere on the board
PS_DDR_DM1: U27.AJ25 (PS_DDR_DM1); also elsewhere on the board
PS_DDR_DM2: U27.AF21 (PS_DDR_DM2); also elsewhere on the board
PS_DDR_DM3: U27.AE25 (PS_DDR_DM3); also elsewhere on the board
PS_DDR_DM4: U27.Y24 (PS_DDR_DM4); also elsewhere on the board
PS_DDR_DM5: U27.R24 (PS_DDR_DM5); also elsewhere on the board
PS_DDR_DM6: U27.V28 (PS_DDR_DM6); also elsewhere on the board
PS_DDR_DM7: U27.P28 (PS_DDR_DM7); also elsewhere on the board
PS_DDR_DM8: U27.AA27 (PS_DDR_DM8)
PS_DDR_DQ0: U27.AH22 (PS_DDR_DQ0); also elsewhere on the board
PS_DDR_DQ1: U27.AH21 (PS_DDR_DQ1); also elsewhere on the board
PS_DDR_DQ2: U27.AJ22 (PS_DDR_DQ2); also elsewhere on the board
PS_DDR_DQ3: U27.AK22 (PS_DDR_DQ3); also elsewhere on the board
PS_DDR_DQ4: U27.AK20 (PS_DDR_DQ4); also elsewhere on the board
PS_DDR_DQ5: U27.AJ19 (PS_DDR_DQ5); also elsewhere on the board
PS_DDR_DQ6: U27.AK19 (PS_DDR_DQ6); also elsewhere on the board
PS_DDR_DQ7: U27.AH19 (PS_DDR_DQ7); also elsewhere on the board
PS_DDR_DQ8: U27.AH23 (PS_DDR_DQ8); also elsewhere on the board
PS_DDR_DQ9: U27.AK23 (PS_DDR_DQ9); also elsewhere on the board
PS_DDR_DQ10: U27.AG24 (PS_DDR_DQ10); also elsewhere on the board
PS_DDR_DQ11: U27.AK24 (PS_DDR_DQ11); also elsewhere on the board
PS_DDR_DQ12: U27.AJ26 (PS_DDR_DQ12); also elsewhere on the board
PS_DDR_DQ13: U27.AK25 (PS_DDR_DQ13); also elsewhere on the board
PS_DDR_DQ14: U27.AG25 (PS_DDR_DQ14); also elsewhere on the board
PS_DDR_DQ15: U27.AH26 (PS_DDR_DQ15); also elsewhere on the board
PS_DDR_DQ16: U27.AD22 (PS_DDR_DQ16); also elsewhere on the board
PS_DDR_DQ17: U27.AE22 (PS_DDR_DQ17); also elsewhere on the board
PS_DDR_DQ18: U27.AF22 (PS_DDR_DQ18); also elsewhere on the board
PS_DDR_DQ19: U27.AG21 (PS_DDR_DQ19); also elsewhere on the board
PS_DDR_DQ20: U27.AD20 (PS_DDR_DQ20); also elsewhere on the board
PS_DDR_DQ21: U27.AF20 (PS_DDR_DQ21); also elsewhere on the board
PS_DDR_DQ22: U27.AE20 (PS_DDR_DQ22); also elsewhere on the board
PS_DDR_DQ23: U27.AG20 (PS_DDR_DQ23); also elsewhere on the board
PS_DDR_DQ24: U27.AG23 (PS_DDR_DQ24); also elsewhere on the board
PS_DDR_DQ25: U27.AF23 (PS_DDR_DQ25); also elsewhere on the board
PS_DDR_DQ26: U27.AF25 (PS_DDR_DQ26); also elsewhere on the board
PS_DDR_DQ27: U27.AE23 (PS_DDR_DQ27); also elsewhere on the board
PS_DDR_DQ28: U27.AC22 (PS_DDR_DQ28); also elsewhere on the board
PS_DDR_DQ29: U27.AC23 (PS_DDR_DQ29); also elsewhere on the board
PS_DDR_DQ30: U27.AD25 (PS_DDR_DQ30); also elsewhere on the board
PS_DDR_DQ31: U27.AC24 (PS_DDR_DQ31); also elsewhere on the board
PS_DDR_DQ32: U27.U24 (PS_DDR_DQ32); also elsewhere on the board
PS_DDR_DQ33: U27.V23 (PS_DDR_DQ33); also elsewhere on the board
PS_DDR_DQ34: U27.U25 (PS_DDR_DQ34); also elsewhere on the board
PS_DDR_DQ35: U27.V24 (PS_DDR_DQ35); also elsewhere on the board
PS_DDR_DQ36: U27.Y25 (PS_DDR_DQ36); also elsewhere on the board
PS_DDR_DQ37: U27.AA23 (PS_DDR_DQ37); also elsewhere on the board
PS_DDR_DQ38: U27.AA25 (PS_DDR_DQ38); also elsewhere on the board
PS_DDR_DQ39: U27.Y23 (PS_DDR_DQ39); also elsewhere on the board
PS_DDR_DQ40: U27.P23 (PS_DDR_DQ40); also elsewhere on the board
PS_DDR_DQ41: U27.R23 (PS_DDR_DQ41); also elsewhere on the board
PS_DDR_DQ42: U27.T23 (PS_DDR_DQ42); also elsewhere on the board
PS_DDR_DQ43: U27.P26 (PS_DDR_DQ43); also elsewhere on the board
PS_DDR_DQ44: U27.T25 (PS_DDR_DQ44); also elsewhere on the board
PS_DDR_DQ45: U27.U23 (PS_DDR_DQ45); also elsewhere on the board
PS_DDR_DQ46: U27.T26 (PS_DDR_DQ46); also elsewhere on the board
PS_DDR_DQ47: U27.P24 (PS_DDR_DQ47); also elsewhere on the board
PS_DDR_DQ48: U27.U26 (PS_DDR_DQ48); also elsewhere on the board
PS_DDR_DQ49: U27.V26 (PS_DDR_DQ49); also elsewhere on the board
PS_DDR_DQ50: U27.U28 (PS_DDR_DQ50); also elsewhere on the board
PS_DDR_DQ51: U27.V27 (PS_DDR_DQ51); also elsewhere on the board
PS_DDR_DQ52: U27.U30 (PS_DDR_DQ52); also elsewhere on the board
PS_DDR_DQ53: U27.V30 (PS_DDR_DQ53); also elsewhere on the board
PS_DDR_DQ54: U27.W30 (PS_DDR_DQ54); also elsewhere on the board
PS_DDR_DQ55: U27.W29 (PS_DDR_DQ55); also elsewhere on the board
PS_DDR_DQ56: U27.R30 (PS_DDR_DQ56); also elsewhere on the board
PS_DDR_DQ57: U27.T30 (PS_DDR_DQ57); also elsewhere on the board
PS_DDR_DQ58: U27.P30 (PS_DDR_DQ58); also elsewhere on the board
PS_DDR_DQ59: U27.P29 (PS_DDR_DQ59); also elsewhere on the board
PS_DDR_DQ60: U27.T28 (PS_DDR_DQ60); also elsewhere on the board
PS_DDR_DQ61: U27.T27 (PS_DDR_DQ61); also elsewhere on the board
PS_DDR_DQ62: U27.P27 (PS_DDR_DQ62); also elsewhere on the board
PS_DDR_DQ63: U27.R27 (PS_DDR_DQ63); also elsewhere on the board
PS_DDR_DQ64: U27.AB29 (PS_DDR_DQ64)
PS_DDR_DQ65: U27.AA30 (PS_DDR_DQ65)
PS_DDR_DQ66: U27.Y30 (PS_DDR_DQ66)
PS_DDR_DQ67: U27.Y29 (PS_DDR_DQ67)
PS_DDR_DQ68: U27.AA26 (PS_DDR_DQ68)
PS_DDR_DQ69: U27.W27 (PS_DDR_DQ69)
PS_DDR_DQ70: U27.Y27 (PS_DDR_DQ70)
PS_DDR_DQ71: U27.W26 (PS_DDR_DQ71)
PS_DDR_DQS_N0: U27.AK21 (PS_DDR_DQS_N0); also elsewhere on the board
PS_DDR_DQS_N1: U27.AJ24 (PS_DDR_DQS_N1); also elsewhere on the board
PS_DDR_DQS_N2: U27.AD21 (PS_DDR_DQS_N2); also elsewhere on the board
PS_DDR_DQS_N3: U27.AE24 (PS_DDR_DQS_N3); also elsewhere on the board
PS_DDR_DQS_N4: U27.W25 (PS_DDR_DQS_N4); also elsewhere on the board
PS_DDR_DQS_N5: U27.R25 (PS_DDR_DQS_N5); also elsewhere on the board
PS_DDR_DQS_N6: U27.V29 (PS_DDR_DQS_N6); also elsewhere on the board
PS_DDR_DQS_N7: U27.R29 (PS_DDR_DQS_N7); also elsewhere on the board
PS_DDR_DQS_N8: U27.AA28 (PS_DDR_DQS_N8)
PS_DDR_DQS_P0: U27.AJ21 (PS_DDR_DQS_P0); also elsewhere on the board
PS_DDR_DQS_P1: U27.AH24 (PS_DDR_DQS_P1); also elsewhere on the board
PS_DDR_DQS_P2: U27.AC21 (PS_DDR_DQS_P2); also elsewhere on the board
PS_DDR_DQS_P3: U27.AD24 (PS_DDR_DQS_P3); also elsewhere on the board
PS_DDR_DQS_P4: U27.W24 (PS_DDR_DQS_P4); also elsewhere on the board
PS_DDR_DQS_P5: U27.P25 (PS_DDR_DQS_P5); also elsewhere on the board
PS_DDR_DQS_P6: U27.U29 (PS_DDR_DQS_P6); also elsewhere on the board
PS_DDR_DQS_P7: U27.R28 (PS_DDR_DQS_P7); also elsewhere on the board
PS_DDR_DQS_P8: U27.Y28 (PS_DDR_DQS_P8)
PS_DDR_ODT0: U27.AB30 (PS_DDR_ODT0); also elsewhere on the board
PS_DDR_ODT1: U27.AC29 (PS_DDR_ODT1)
PS_DDR_PARITY: U27.AB26 (PS_DDR_PARITY); also elsewhere on the board
PS_DDR_RAM_RST_N: U27.AB25 (PS_DDR_RAM_RST_N); also elsewhere on the board
PS_DONE: U27.N22 (PS_DONE)
PS_ERROR_OUT: U27.R22 (PS_ERROR_OUT)
PS_ERROR_STATUS: U27.R20 (PS_ERROR_STATUS)
PS_INIT_B: U27.N18 (PS_INIT_B)
PS_JTAG_TCK: U27.L19 (PS_JTAG_TCK); also elsewhere on the board
PS_JTAG_TDI: U27.L20 (PS_JTAG_TDI); also elsewhere on the board
PS_JTAG_TDO: U27.M20 (PS_JTAG_TDO); also elsewhere on the board
PS_JTAG_TMS: U27.L21 (PS_JTAG_TMS); also elsewhere on the board
PS_MODE0: U27.R18 (PS_MODE0)
PS_MODE1: U27.R19 (PS_MODE1)
PS_MODE2: U27.P21 (PS_MODE2)
PS_MODE3: U27.P22 (PS_MODE3)
PS_POR_B: U27.N19 (PS_POR_B); also elsewhere on the board
PS_PROG_B: U27.M19 (PS_PROG_B)
PS_REFCLK0_100M_N: U27.M24 (PS_MGTREFCLK0N_505)
PS_REFCLK0_100M_P: U27.M23 (PS_MGTREFCLK0P_505)
PS_REFCLK1_27M_N: U27.L26 (PS_MGTREFCLK1N_505)
PS_REFCLK1_27M_P: U27.L25 (PS_MGTREFCLK1P_505)
PS_REF_CLK: U27.P19 (PS_REF_CLK); also elsewhere on the board
PS_SRST_B: U27.P20 (PS_SRST_B); also elsewhere on the board
QSPI_FEEDBACK_CLK: U27.D20 (PS_MIO6)
QSPI_IO0: U27.A20 (PS_MIO1); also elsewhere on the board
QSPI_IO1: U27.B19 (PS_MIO2); also elsewhere on the board
QSPI_IO2: U27.D19 (PS_MIO3); also elsewhere on the board
QSPI_IO3: U27.J17 (PS_MIO4); also elsewhere on the board
QSPI_SCLK: U27.H17 (PS_MIO0); also elsewhere on the board
QSPI_SS: U27.C19 (PS_MIO5); also elsewhere on the board
SD0_CD: U27.A18 (PS_MIO24)
SD0_CLK: U27.G19 (PS_MIO13); also elsewhere on the board
SD0_CMD: U27.E18 (PS_MIO14); also elsewhere on the board
SD0_D0: U27.J19 (PS_MIO15); also elsewhere on the board
SD0_D1: U27.K17 (PS_MIO16); also elsewhere on the board
SD0_D2: U27.C18 (PS_MIO17); also elsewhere on the board
SD0_D3: U27.K18 (PS_MIO18); also elsewhere on the board
SD0_D4: U27.K16 (PS_MIO19); also elsewhere on the board
SD0_D5: U27.A19 (PS_MIO20); also elsewhere on the board
SD0_D6: U27.H19 (PS_MIO21); also elsewhere on the board
SD0_D7: U27.F17 (PS_MIO22); also elsewhere on the board
SD0_RST: U27.K19 (PS_MIO23); also elsewhere on the board
SD0_WP: U27.B18 (PS_MIO25)
SD1_CD: U27.F23 (PS_MIO45); also elsewhere on the board
SD1_CLK: U27.E22 (PS_MIO39); also elsewhere on the board
SD1_CMD: U27.C24 (PS_MIO40); also elsewhere on the board
SD1_D0: U27.D24 (PS_MIO41); also elsewhere on the board
SD1_D1: U27.E23 (PS_MIO42); also elsewhere on the board
SD1_D2: U27.F22 (PS_MIO43); also elsewhere on the board
SD1_D3: U27.E24 (PS_MIO44); also elsewhere on the board
SFP_RX_N: U27.D1 (MGTHRXN0_226); also elsewhere on the board
SFP_RX_P: U27.D2 (MGTHRXP0_226); also elsewhere on the board
SFP_TX_N: U27.D5 (MGTHTXN0_226); also elsewhere on the board
SFP_TX_P: U27.D6 (MGTHTXP0_226); also elsewhere on the board
SYSMON_DXN: U27.V14 (DXN)
SYSMON_DXP: U27.V15 (DXP)
SYSMON_VN: U27.U14 (VN)
SYSMON_VP: U27.T15 (VP)
SYSMON_VREFP: U27.U15 (VREFP)
UART0_RX: U27.D21 (PS_MIO29); also elsewhere on the board
UART0_TX: U27.B20 (PS_MIO26); also elsewhere on the board
UART1_RX: U27.A21 (PS_MIO28); also elsewhere on the board
UART1_TX: U27.B21 (PS_MIO27); also elsewhere on the board
USB2_CLK: U27.A24 (PS_MIO52); also elsewhere on the board
USB2_D0: U27.A25 (PS_MIO56); also elsewhere on the board
USB2_D1: U27.A26 (PS_MIO57); also elsewhere on the board
USB2_D2: U27.A28 (PS_MIO58); also elsewhere on the board
USB2_D3: U27.A27 (PS_MIO59); also elsewhere on the board
USB2_D4: U27.C26 (PS_MIO60); also elsewhere on the board
USB2_D5: U27.B29 (PS_MIO61); also elsewhere on the board
USB2_D6: U27.B28 (PS_MIO62); also elsewhere on the board
USB2_D7: U27.A29 (PS_MIO63); also elsewhere on the board
USB2_DIR: U27.B25 (PS_MIO53); also elsewhere on the board
USB2_NXT: U27.A23 (PS_MIO54); also elsewhere on the board
USB2_STP: U27.B26 (PS_MIO55); also elsewhere on the board
USB3_RX_N: U27.L30 (PS_MGTRRXN0_505); also elsewhere on the board
USB3_RX_P: U27.L29 (PS_MGTRRXP0_505); also elsewhere on the board
USB3_TX_N: U27.M28 (PS_MGTRTXN0_505); also elsewhere on the board
USB3_TX_P: U27.M27 (PS_MGTRTXP0_505); also elsewhere on the board
USB3_VBUS_NET: U27.G21 (PS_MIO49); also elsewhere on the board

Notes on the sheet:
VCCINT
VCCADC
VCC_45+46
VCC_PSIO
VCCINT_IO
VCCO_PSDDR_504
VCC_PSAUX
VCC_PSPLL
MGTVCCAUX
VREFP
PS_MGTRAVTT
DECOUPLING CAPACITORS
VCCINT_VCU
VCC_PSADC
SECTION 04a : Zynq Core
VCCO_64+65+66
MGTAVCC
VCCAUX+IO
VCCBRAM
VCC_PSDDR_PLL
VCC_PSINTFP + PSINTLP + DDR
PS_MGTRAVCC

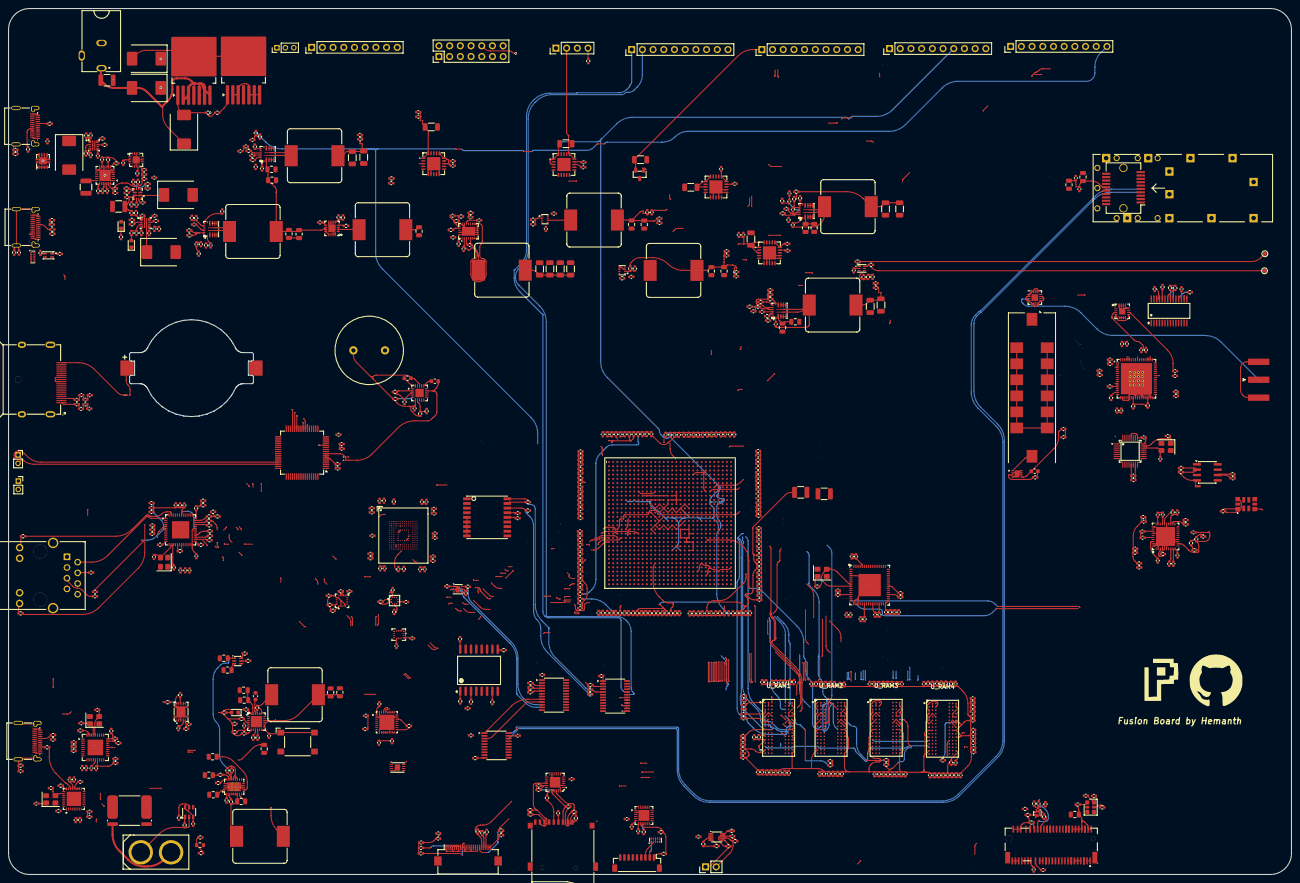
[picture p65: board Devboard.kicad_pcb from above]

Board: 16 copper layers, 304.6 x 205.6 mm, 875 parts (0 on the bottom side), 644 nets.
