damnitzhemanth-oss/FusionBoard/PCB/Devboard/schematics/01_Power/Power_Input_Protection.kicad_sch

## KiCad design PCB/Devboard/schematics/01_Power/Power_Input_Protection.kicad_sch (2026-10-21)

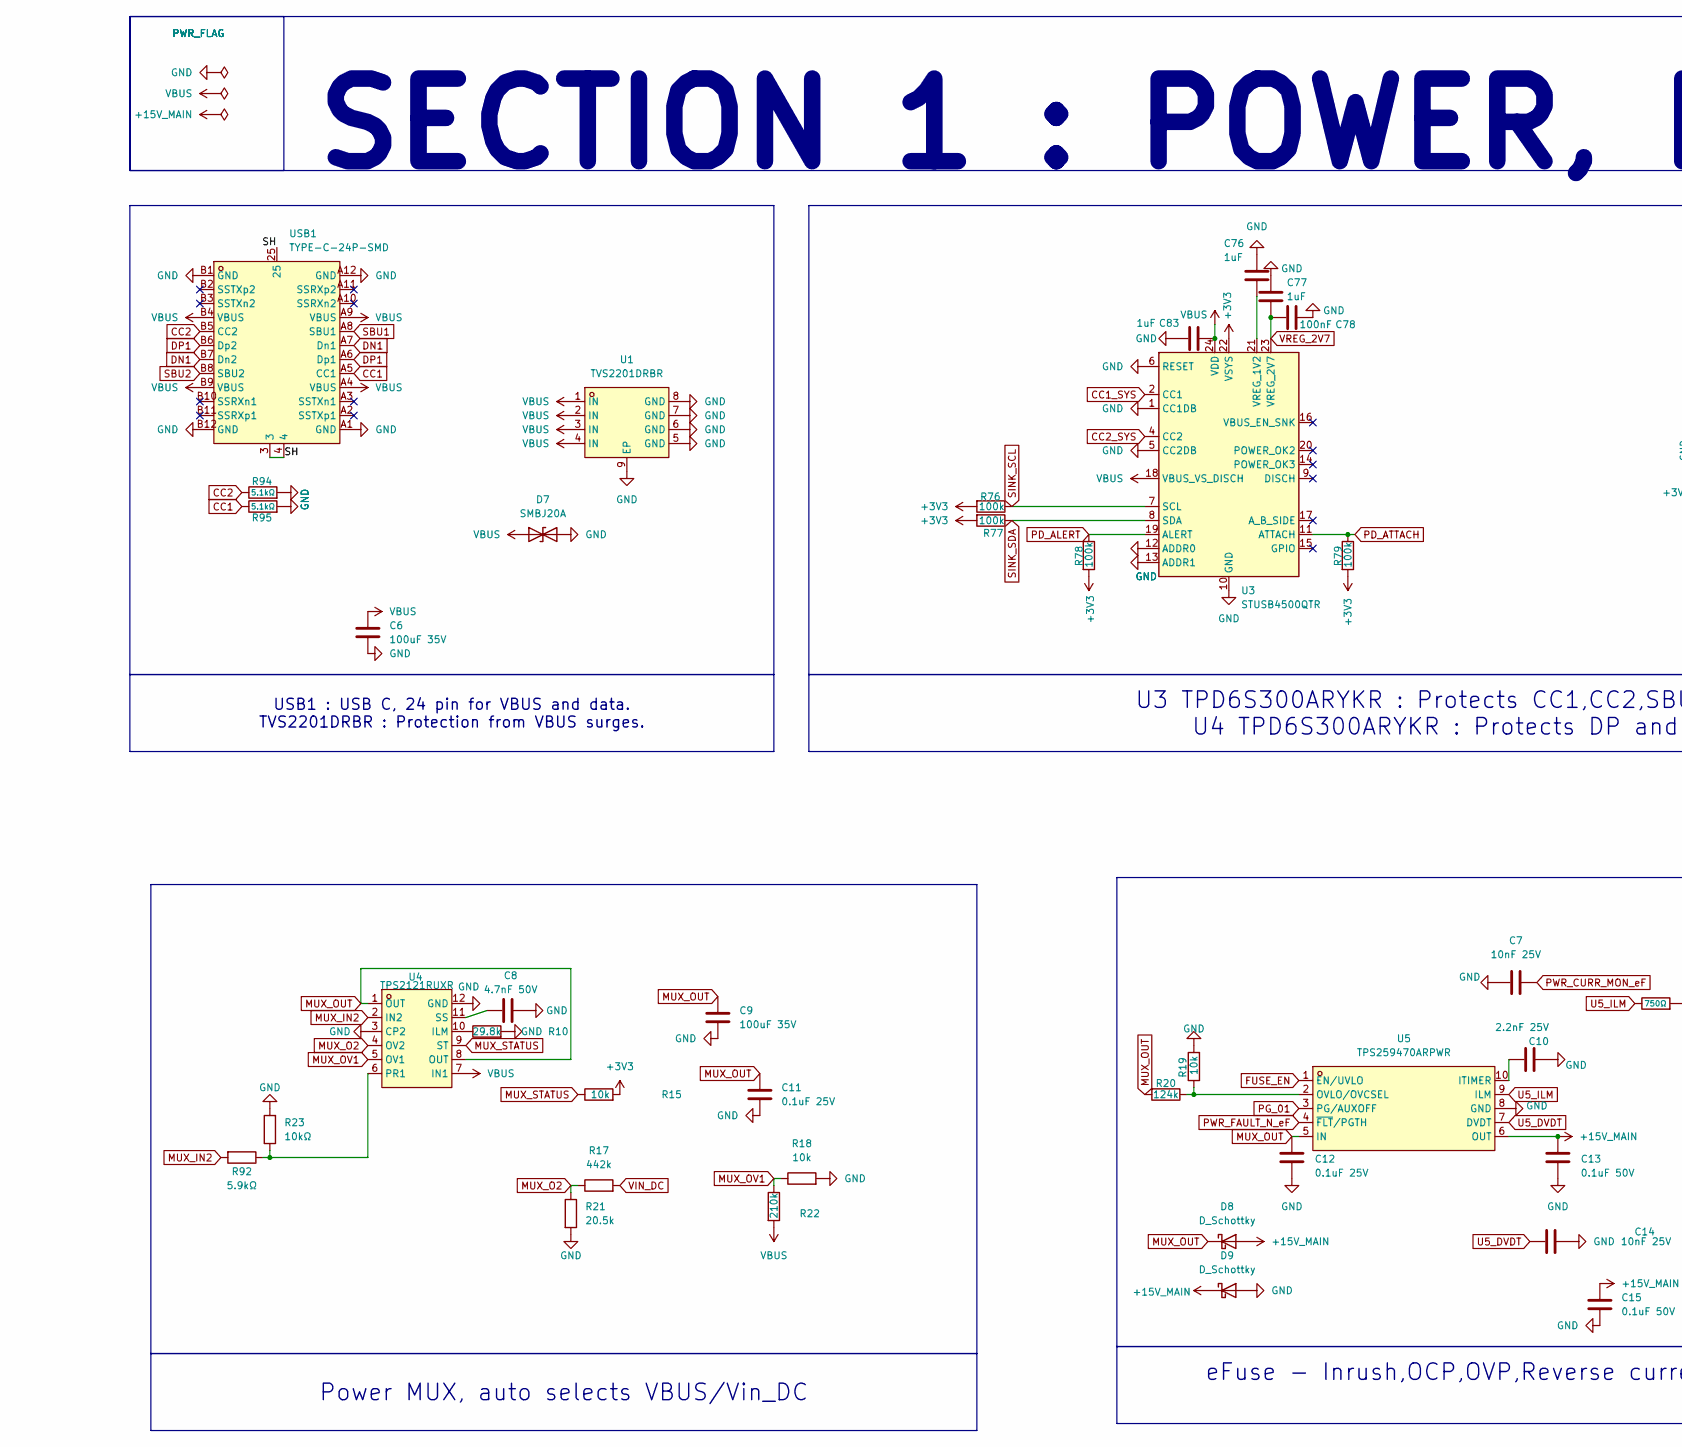
[picture p66: schematic Power_Input_Protection.kicad_sch, part in row 1, column 1]

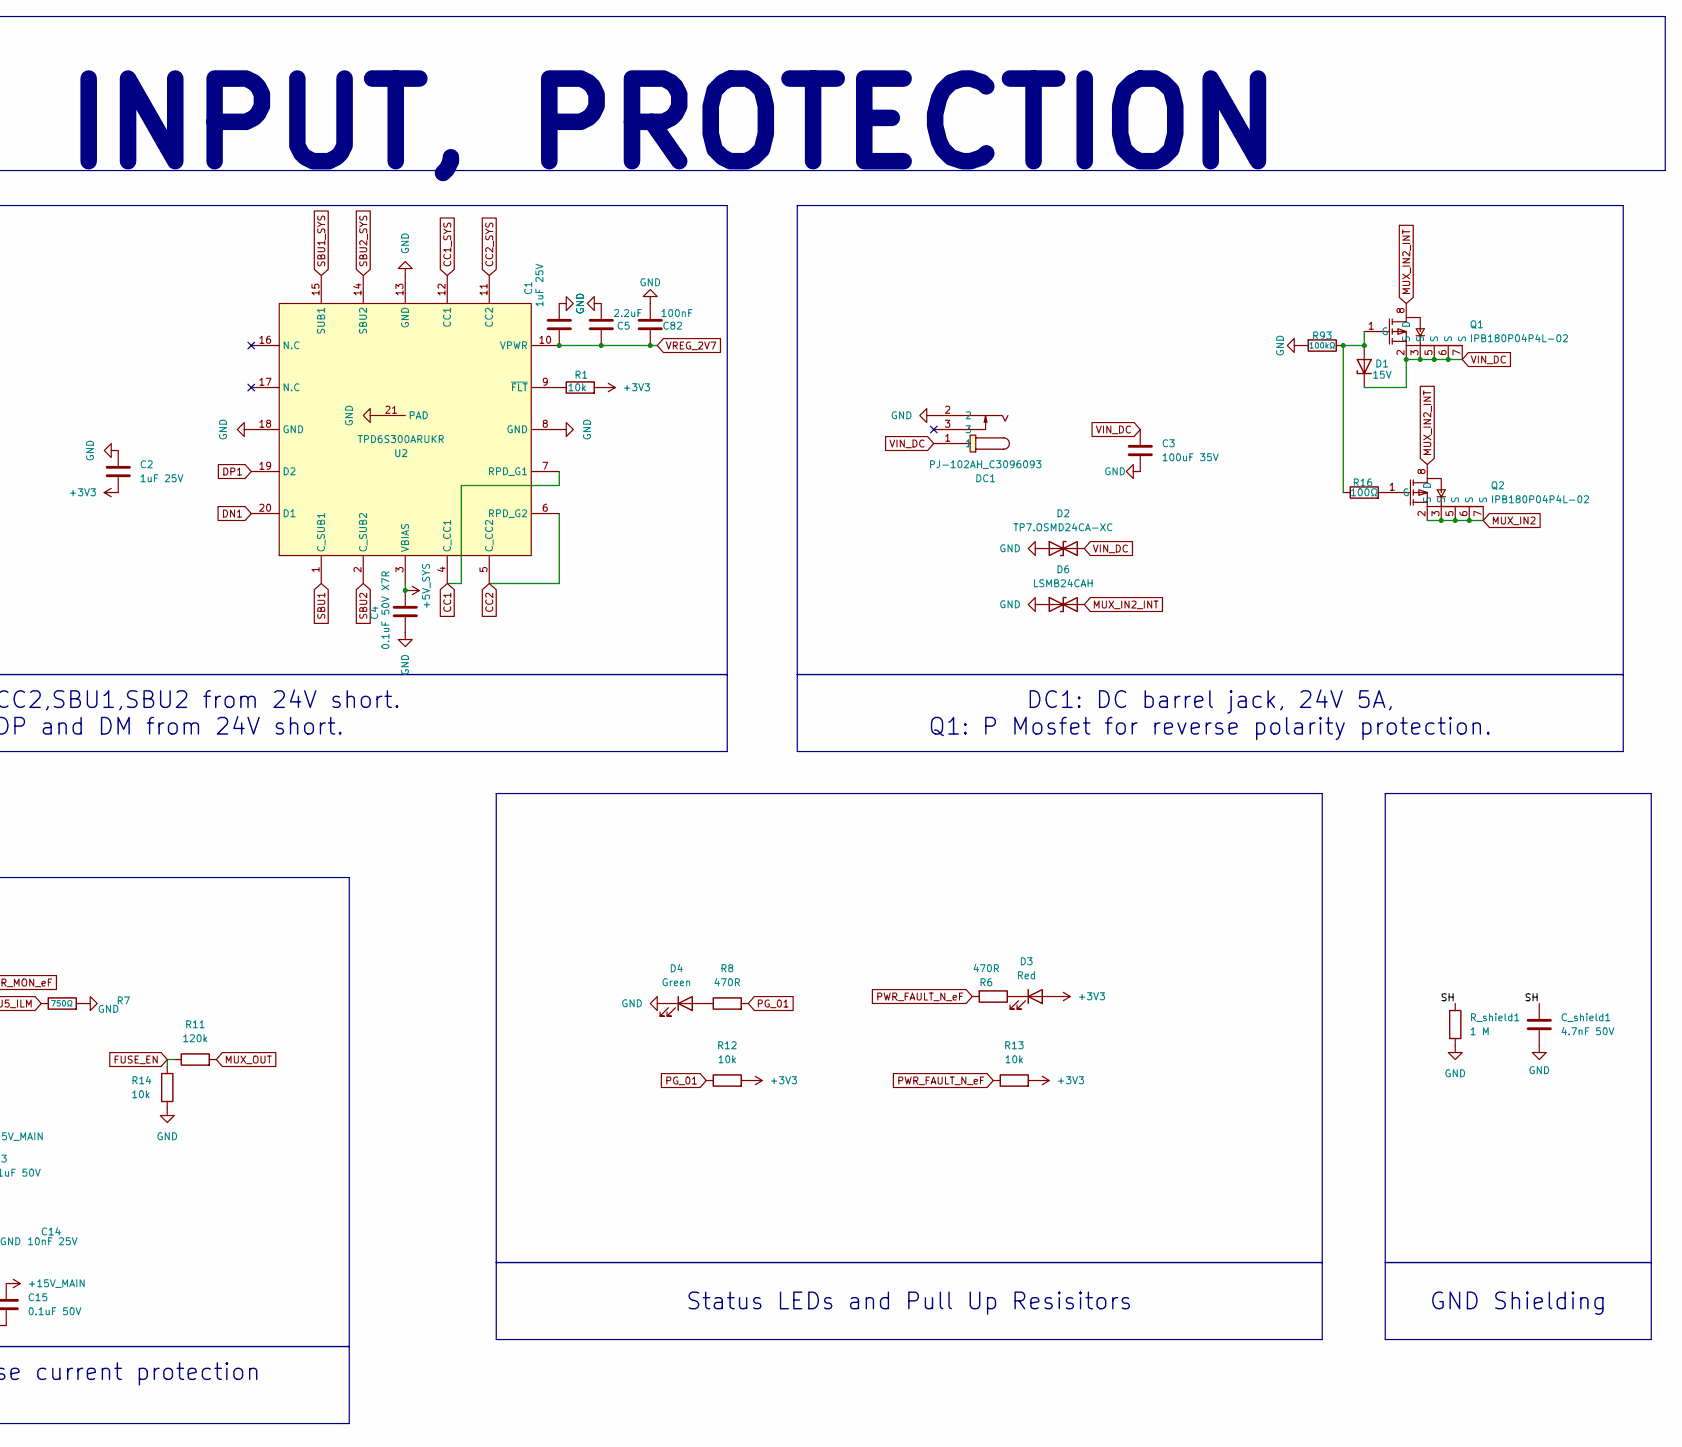
[picture p67: schematic Power_Input_Protection.kicad_sch, part in row 1, column 2]

Parts:
C1, C2: 1uF 25V; C_0402_1005Metric
C3, C6, C9: 100uF 35V; C_1210_3225Metric
C4: 0.1uF 50V X7R; C_0402_1005Metric
C5: 2.2uF; C_0402_1005Metric
C7, C14: 10nF 25V; C_0402_1005Metric
C8: 4.7nF 50V; C_0402_1005Metric
C10: 2.2nF 25V; C_0402_1005Metric
C11, C12: 0.1uF 25V; C_0402_1005Metric
C13, C15: 0.1uF 50V; C_0402_1005Metric
C76, C77, C83: 1uF; C_1210_3225Metric
C78: 100nF; C_1210_3225Metric
C82: 100nF; C_0402_1005Metric
C_shield1: 4.7nF 50V; C_0402_1005Metric
D1: 15V; D_SMC
D2: TP7.OSMD24CA-XC; D_SMC
D3: Red; LED_0603_1608Metric
D4: Green; LED_0603_1608Metric
D6: LSMB24CAH; D_SMC
D7: SMBJ20A; D_SMC
D8, D9: D_Schottky; D_SMC
DC1: PJ-102AH_C3096093; DC-IN-TH_PJ-102AH; MPN PJ-102AH; LCSC Part C3096093
Q1, Q2: IPB180P04P4L-02; TO-263-7_TabPin8; MPN IPB180P04P4L-02(TOKMAS); LCSC Part C21547650
R1, R12, R13, R14, R15, R18, R19: 10k; R_0402_1005Metric
R6, R8: 470R; R_0402_1005Metric
R7: 750Ω; R_0402_1005Metric
R10: 29.8k; R_0402_1005Metric
R11: 120k; R_0402_1005Metric
R16: 100Ω; R_0402_1005Metric
R17: 442k; R_0402_1005Metric
R20: 124k; R_0402_1005Metric
R21: 20.5k; R_0402_1005Metric
R22: 210k; R_0402_1005Metric
R23: 10kΩ; R_0402_1005Metric
R76, R77, R78, R79: 100k; R_0402_1005Metric
R92: 5.9kΩ; R_0402_1005Metric
R93: 100kΩ; R_0402_1005Metric
R94, R95: 5.1kΩ; R_0402_1005Metric
R_shield1: 1 M; R_0402_1005Metric
U1: TVS2201DRBR; VSON-8_L3.0-W3.0-P0.65-BL-EP; MPN TVS2201DRBR; LCSC Part C1849889
U2: TPD6S300ARUKR; WQFN-20_L3.0-W3.0-P0.40-TL-EP1.7; MPN TPD6S300ARUKR; LCSC Part C2876380
U3: STUSB4500QTR; QFN-24-1EP_4x4mm_P0.5mm_EP2.7x2.7mm
U4: TPS2121RUXR; VQFN-HR-12_L2.5-W2.0-P0.50-BL; MPN TPS2121RUXR; LCSC Part C485916
U5: TPS259470ARPWR; VQFN-10_L2.0-W2.0-P0.45-TL; MPN TPS259470ARPWR; LCSC Part C3662799
USB1: TYPE-C-24P-SMD; USB-C-SMD_TYPE-C-24P-SMD; MPN TYPE-C-24P-SMD; LCSC Part C53207146

Connections:
+3V3: C2.2, D3.2 (A), R1.2, R12.2, R13.2, R15.2, R76.2, R77.2, R78.2, R79.2, U3.22 (VSYS)
+5V_SYS: C4.2, U2.3 (VBIAS)
+15V_MAIN: C13.1, C15.1, D8.2 (A), D9.1 (K), U5.6 (OUT)
CC1: R95.1, U2.4 (C_CC1), U2.7 (RPD_G1), USB1.A5 (CC1)
CC1_SYS: U2.12 (CC1), U3.2 (CC1)
CC2: R94.1, U2.5 (C_CC2), U2.6 (RPD_G2), USB1.B5 (CC2)
CC2_SYS: U2.11 (CC2), U3.4 (CC2)
DN1: U2.20 (D1), USB1.A7 (Dn1), USB1.B7 (Dn2)
DP1: U2.19 (D2), USB1.A6 (Dp1), USB1.B6 (Dp2)
FUSE_EN: R11.1, R14.1, U5.1 (EN/UVLO)
GND: C1.1, C2.1, C3.2, C4.1, C5.1, C6.2, C7.1, C8.2, C9.2, C10.2, C11.2, C12.2, C13.2, C14.2, C15.2, C76.2, C77.2, C78.1, C82.1, C83.2, C_shield1.2, D2.1 (A1), D4.1 (K), D6.1 (A1), D7.2 (A2), D9.2 (A), DC1.2, R7.2, R10.2, R14.2, R18.2, R19.2, R21.2, R23.2, R93.2, R94.2, R95.2, R_shield1.2, U1.5 (GND), U1.6 (GND), U1.7 (GND), U1.8 (GND), U1.9 (EP), U2.8 (GND), U2.13 (GND), U2.18 (GND), U2.21 (PAD), U3.1 (CC1DB), U3.5 (CC2DB), U3.6 (RESET), U3.10 (GND), U3.12 (ADDR0), U3.13 (ADDR1), U3.25 (GND), U4.3 (CP2), U4.12 (GND), U5.8 (GND), USB1.A1 (GND), USB1.A12 (GND), USB1.B1 (GND), USB1.B12 (GND)
MUX_IN2: Q2.2 (S), Q2.3 (S), Q2.5 (S), Q2.6 (S), Q2.7 (S), R92.2, U4.2 (IN2)
MUX_IN2_INT: D6.2 (A2), Q1.8 (D), Q2.8 (D)
MUX_O2: R17.1, R21.1, U4.4 (OV2)
MUX_OUT: C9.1, C11.1, C12.1, D8.1 (K), R11.2, R20.2, U4.1 (OUT), U4.8 (OUT), U5.5 (IN)
MUX_OV1: R18.1, R22.1, U4.5 (OV1)
MUX_STATUS: R15.1, U4.9 (ST)
unnamed: C8.1, U4.11 (SS)
unnamed: C10.1, U5.10 (ITIMER)
unnamed: C76.1, U3.21 (VREG_1V2)
unnamed: D1.2 (A), Q1.1 (G), R16.1, R93.1
unnamed: D3.1 (K), R6.1
unnamed: D4.2 (A), R8.1
unnamed: Q2.1 (G), R16.2
unnamed: R1.1, U2.9 (~FLT)
unnamed: R10.1, U4.10 (ILM)
unnamed: R19.1, R20.1, U5.2 (OVLO/OVCSEL)
unnamed: R23.1, R92.1, U4.6 (PR1)
PD_ALERT: R78.1, U3.19 (ALERT)
PD_ATTACH: R79.1, U3.11 (ATTACH)
PG_01: R8.2, R12.1, U5.3 (PG/AUXOFF)
PWR_CURR_MON_eF: C7.2
PWR_FAULT_N_eF: R6.2, R13.1, U5.4 (~FLT/PGTH)
SBU1: U2.1 (C_SUB1), USB1.A8 (SBU1)
SBU1_SYS: U2.15 (SUB1)
SBU2: U2.2 (C_SUB2), USB1.B8 (SBU2)
SBU2_SYS: U2.14 (SBU2)
SH: C_shield1.1, R_shield1.1, USB1.3, USB1.4, USB1.25
SINK_SCL: R76.1, U3.7 (SCL)
SINK_SDA: R77.1, U3.8 (SDA)
U5_DVDT: C14.1, U5.7 (DVDT)
U5_ILM: R7.1, U5.9 (ILM)
VBUS: C6.1, C83.1, D7.1 (A1), R22.2, U1.1 (IN), U1.2 (IN), U1.3 (IN), U1.4 (IN), U3.18 (VBUS_VS_DISCH), U3.24 (VDD), U4.7 (IN1), USB1.A4 (VBUS), USB1.A9 (VBUS), USB1.B4 (VBUS), USB1.B9 (VBUS)
VIN_DC: C3.1, D1.1 (K), D2.2 (A2), DC1.1, Q1.2 (S), Q1.3 (S), Q1.5 (S), Q1.6 (S), Q1.7 (S), R17.2
VREG_2V7: C1.2, C5.2, C77.1, C78.2, C82.2, U2.10 (VPWR), U3.23 (VREG_2V7)

Notes on the sheet:
SECTION 1 : POWER, INPUT, PROTECTION
USB1 : USB C, 24 pin for VBUS and data. TVS2201DRBR : Protection from VBUS surges.
eFuse - Inrush,OCP,OVP,Reverse current protection
DC1: DC barrel jack, 24V 5A, Q1: P Mosfet for reverse polarity protection.
Power MUX, auto selects VBUS/Vin_DC
Status LEDs and Pull Up Resisitors
U3 TPD6S300ARYKR : Protects CC1,CC2,SBU1,SBU2 from 24V short. U4 TPD6S300ARYKR : Protects DP and DM from 24V short.
GND Shielding
