damnitzhemanth-oss/FusionBoard/PCB/Devboard/schematics/02_Battery/Battery_Charger_FuelGauge.kicad_sch

## KiCad design PCB/Devboard/schematics/02_Battery/Battery_Charger_FuelGauge.kicad_sch (2026-10-17)

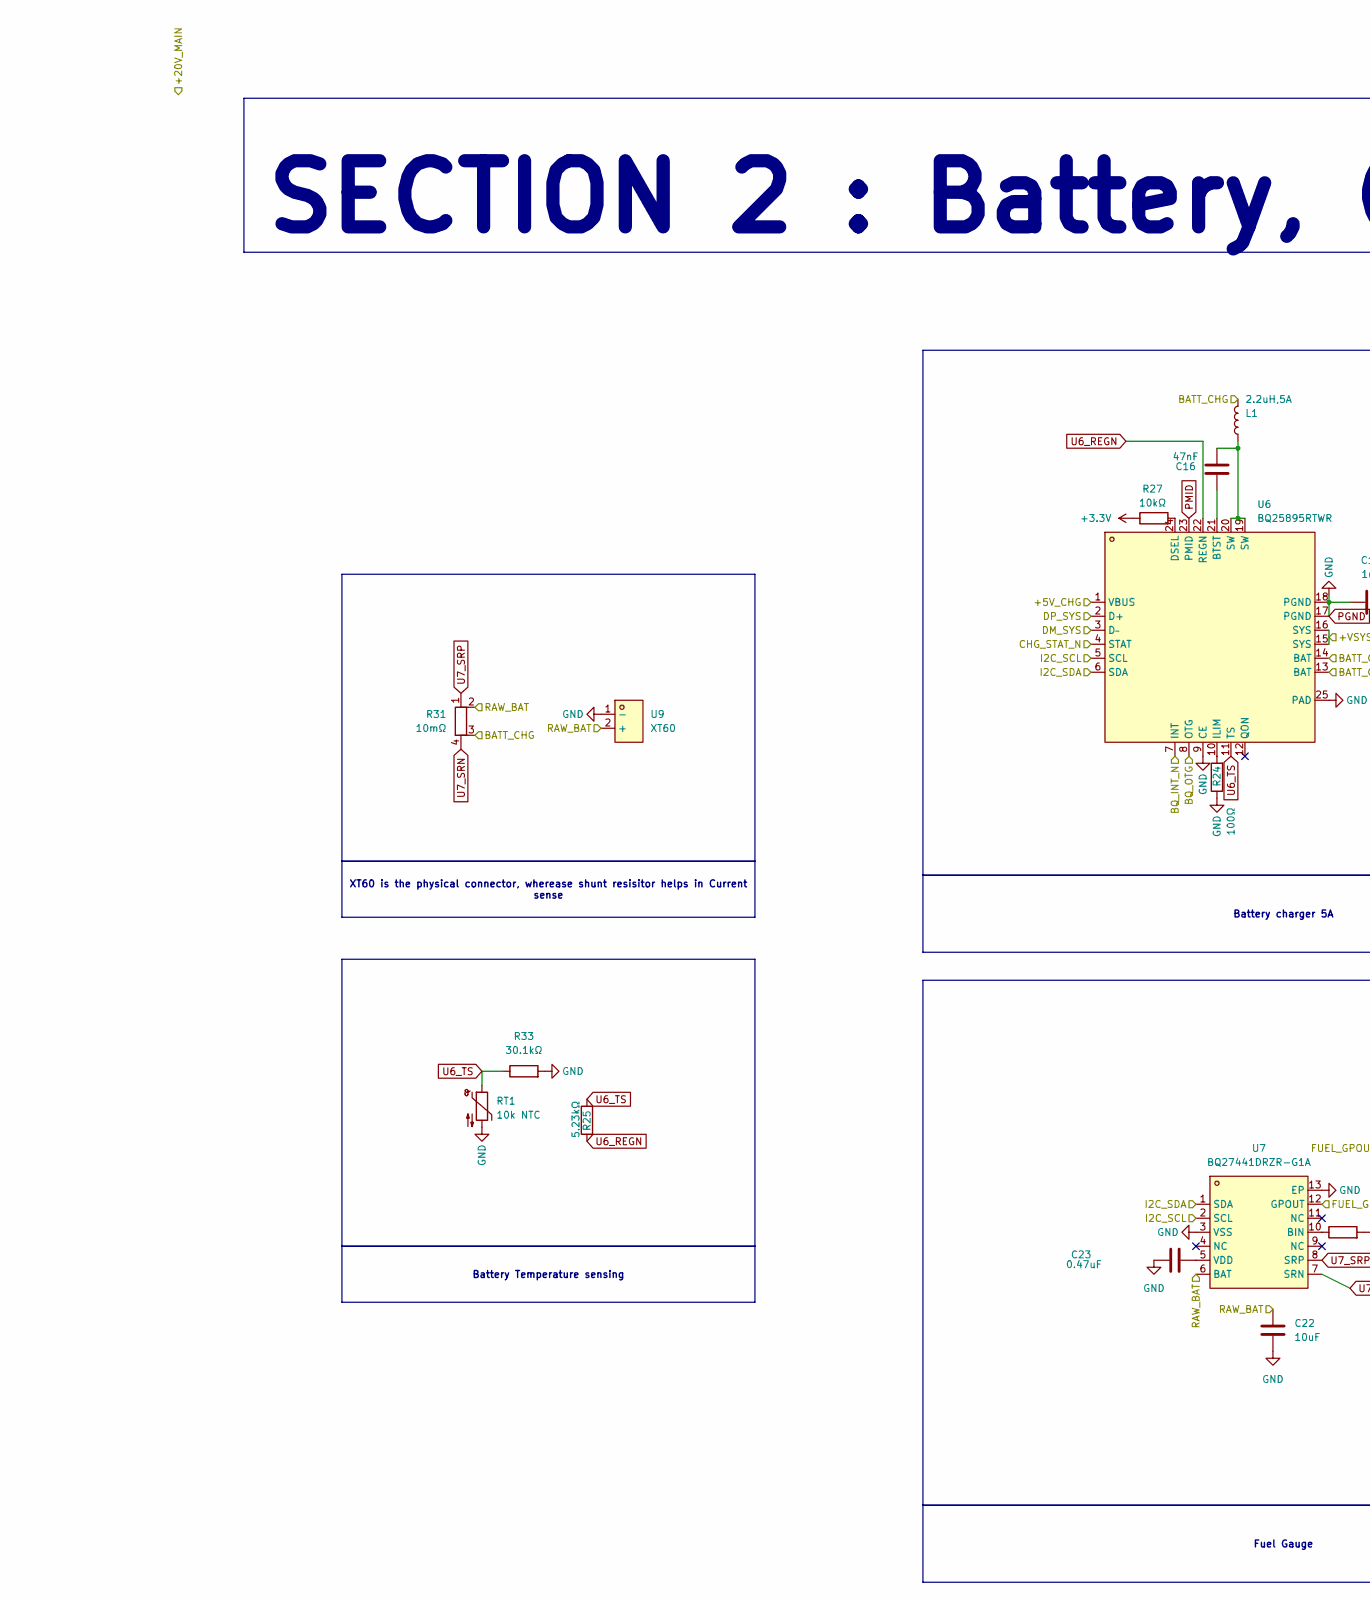
[picture p68: schematic Battery_Charger_FuelGauge.kicad_sch, part in row 1, column 1]

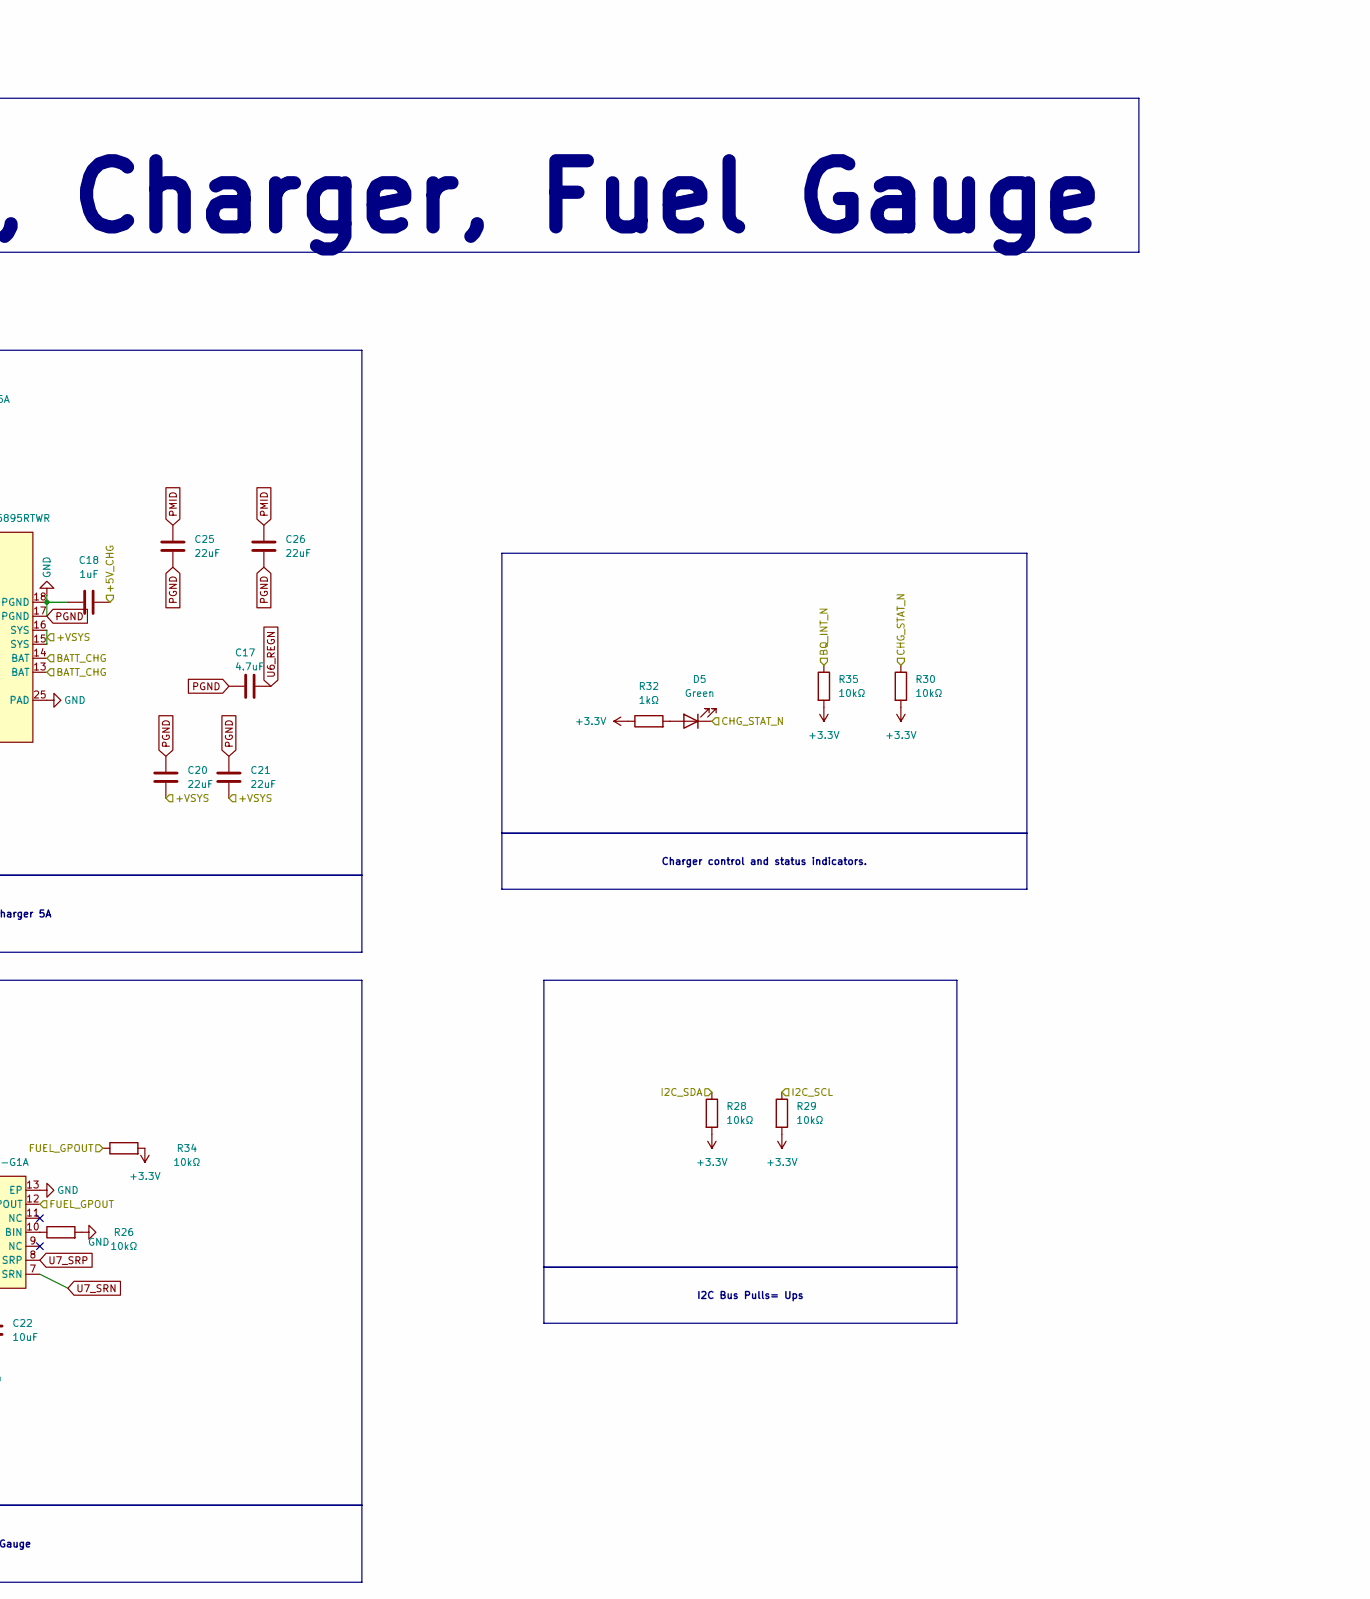
[picture p69: schematic Battery_Charger_FuelGauge.kicad_sch, part in row 1, column 2]

Parts:
C16: 47nF; C_0402_1005Metric
C17: 4.7uF; C_0603_1608Metric
C18: 1uF; C_0402_1005Metric
C20, C21, C25, C26: 22uF; C_0805_2012Metric
C22: 10uF; C_0402_1005Metric
C23: 0.47uF; C_0402_1005Metric
D5: Green; C_0603_1608Metric
L1: 2.2uH,5A; L_Bourns_SRP1245A
R24: 100Ω; R_0402_1005Metric
R25: 5.23kΩ; R_0402_1005Metric
R26, R27, R28, R29, R30, R34, R35: 10kΩ; R_0402_1005Metric
R31: 10mΩ; R_2512_6332Metric
R32: 1kΩ; R_0402_1005Metric
R33: 30.1kΩ; R_0402_1005Metric
RT1: 10k NTC; R_0603_1608Metric
U6: BQ25895RTWR; QFN-24_L4.0-W4.0-P0.50-TL-EP2.7; MPN BQ25895RTWR; LCSC Part C80200
U7: BQ27441DRZR-G1A; SON-12_L4.0-W2.5-P0.40-BL-EP; MPN BQ27441DRZR-G1A; LCSC Part C473397
U9: XT60; CONN-TH_XT60; MPN XT60-M.; LCSC Part C98733

Connections:
+3.3V: R27.1, R28.2, R29.2, R30.2, R32.1, R34.2, R35.2
+5V_CHG: C18.2, U6.1 (VBUS)
+VSYS: C20.1, C21.1, U6.15 (SYS), U6.16 (SYS)
BATT_CHG: L1.2, R31.3, U6.13 (BAT), U6.14 (BAT)
BQ_INT_N: R35.1, U6.7 (INT)
BQ_OTG: U6.8 (OTG)
CHG_STAT_N: D5.1 (K), R30.1, U6.4 (STAT)
DM_SYS: U6.3 (D–)
DP_SYS: U6.2 (D+)
FUEL_GPOUT: R34.1, U7.12 (GPOUT)
GND: C17.2, C18.1, C20.2, C21.2, C22.1, C23.1, C25.1, C26.1, R24.1, R26.2, R33.2, RT1.2, U6.9 (CE), U6.17 (PGND), U6.18 (PGND), U6.25 (PAD), U7.3 (VSS), U7.13 (EP), U9.1 (-)
I2C_SCL: R29.1, U6.5 (SCL), U7.2 (SCL)
I2C_SDA: R28.1, U6.6 (SDA), U7.1 (SDA)
unnamed: C16.1, U6.21 (BTST)
unnamed: C16.2, L1.1, U6.19 (SW), U6.20 (SW)
unnamed: C23.2, U7.5 (VDD)
unnamed: D5.2 (A), R32.2
unnamed: R24.2, U6.10 (ILIM)
unnamed: R26.1, U7.10 (BIN)
unnamed: R27.2, U6.24 (DSEL)
PMID: C25.2, C26.2, U6.23 (PMID)
RAW_BAT: C22.2, R31.2, U7.6 (BAT), U9.2 (+)
U6_REGN: C17.1, R25.1, U6.22 (REGN)
U6_TS: R25.2, R33.1, RT1.1, U6.11 (TS)
U7_SRN: R31.4, U7.7 (SRN)
U7_SRP: R31.1, U7.8 (SRP)

Notes on the sheet:
SECTION 2 : Battery, Charger, Fuel Gauge
I2C Bus Pulls= Ups
Charger control and status indicators.
Battery Temperature sensing
Fuel Gauge
XT60 is the physical connector, wherease shunt resisitor helps in Current sense
Battery charger 5A
