damnitzhemanth-oss/FusionBoard/PCB/Devboard/schematics/03_Power_Tree/03_Power_Tree.kicad_sch

## KiCad design PCB/Devboard/schematics/03_Power_Tree/03_Power_Tree.kicad_sch (2026-10-21)

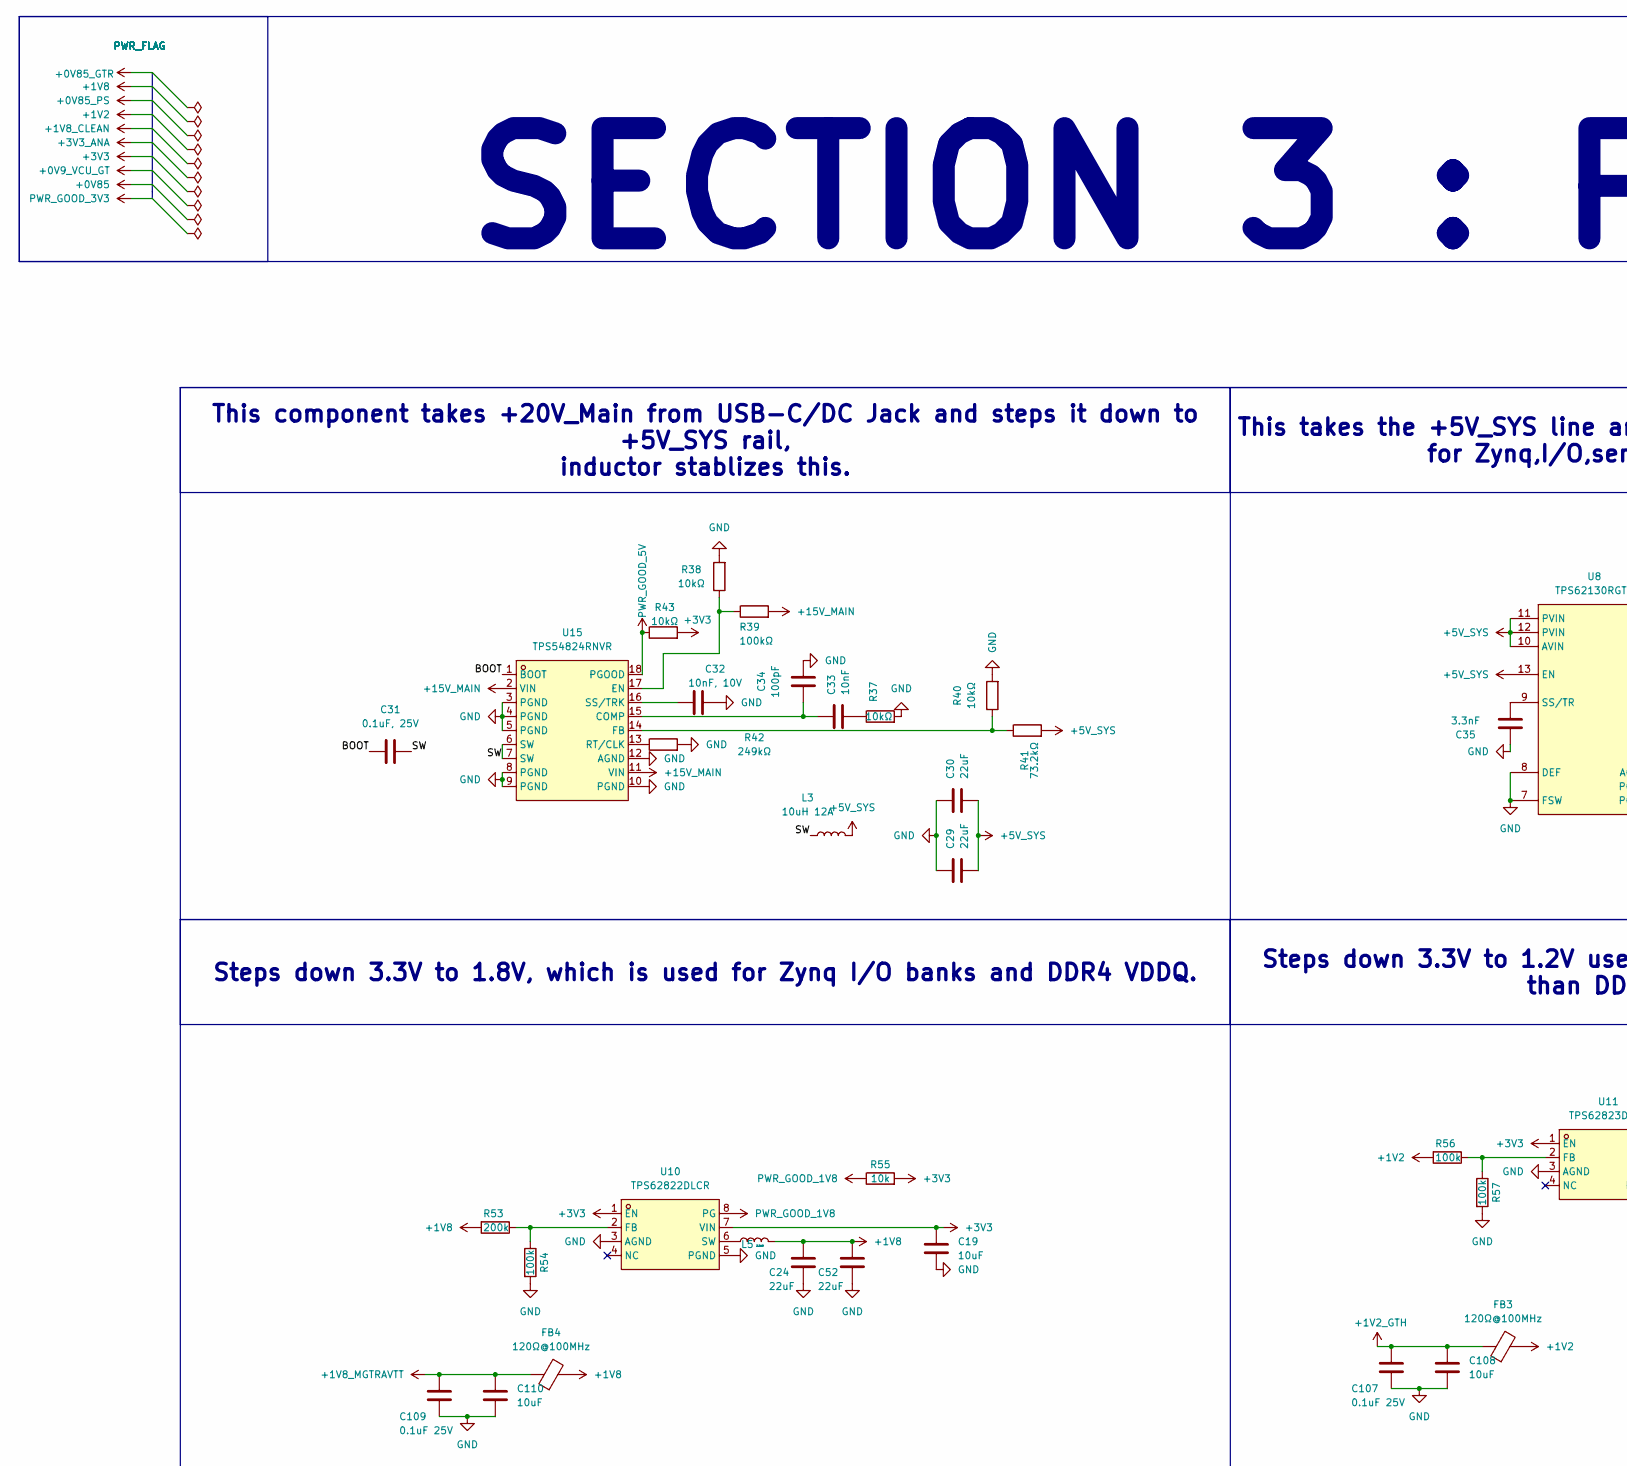
[picture p70: schematic 03_Power_Tree.kicad_sch, part in row 1, column 1]

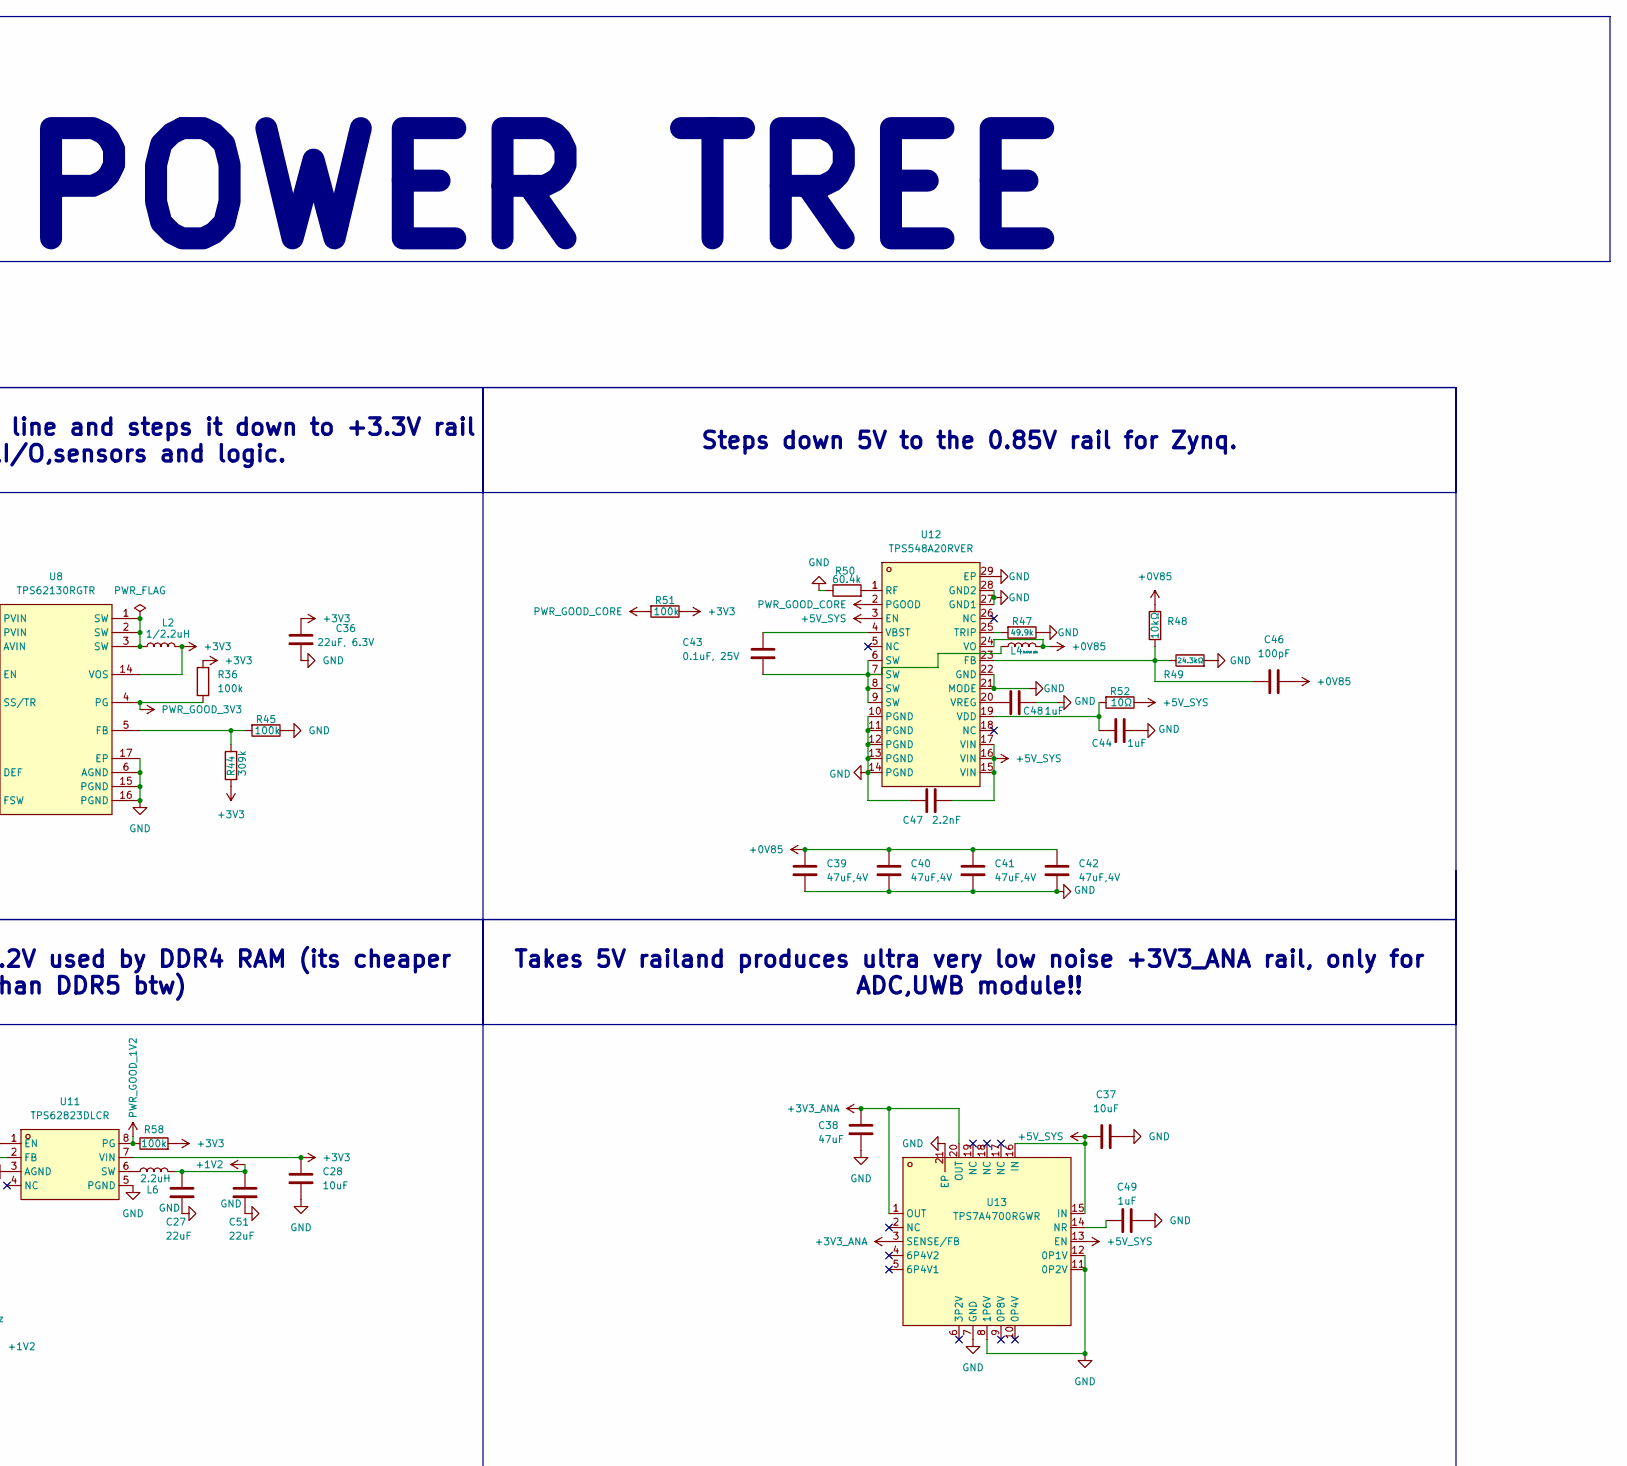
[picture p71: schematic 03_Power_Tree.kicad_sch, part in row 1, column 2]

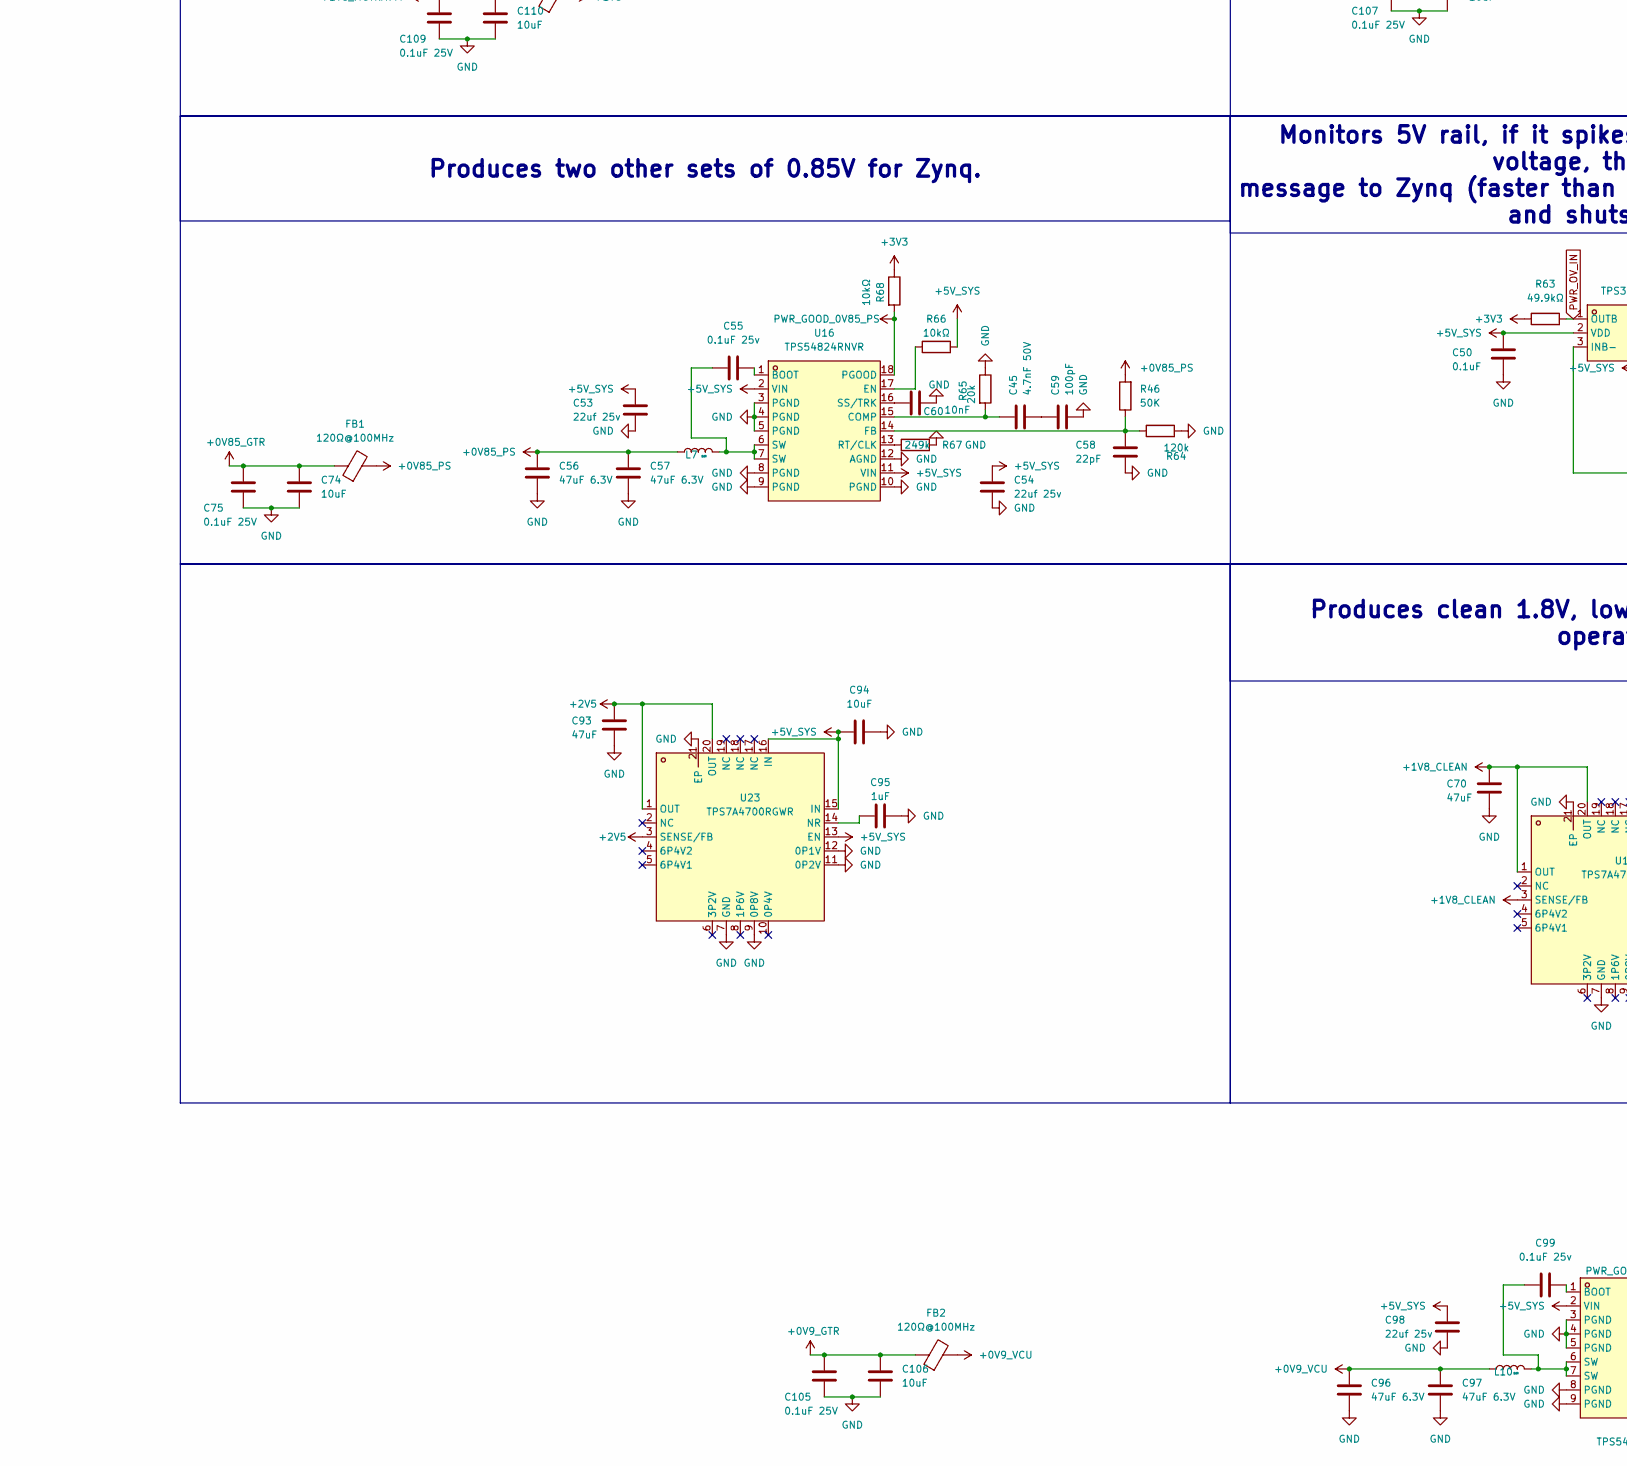
[picture p72: schematic 03_Power_Tree.kicad_sch, part in row 2, column 1]

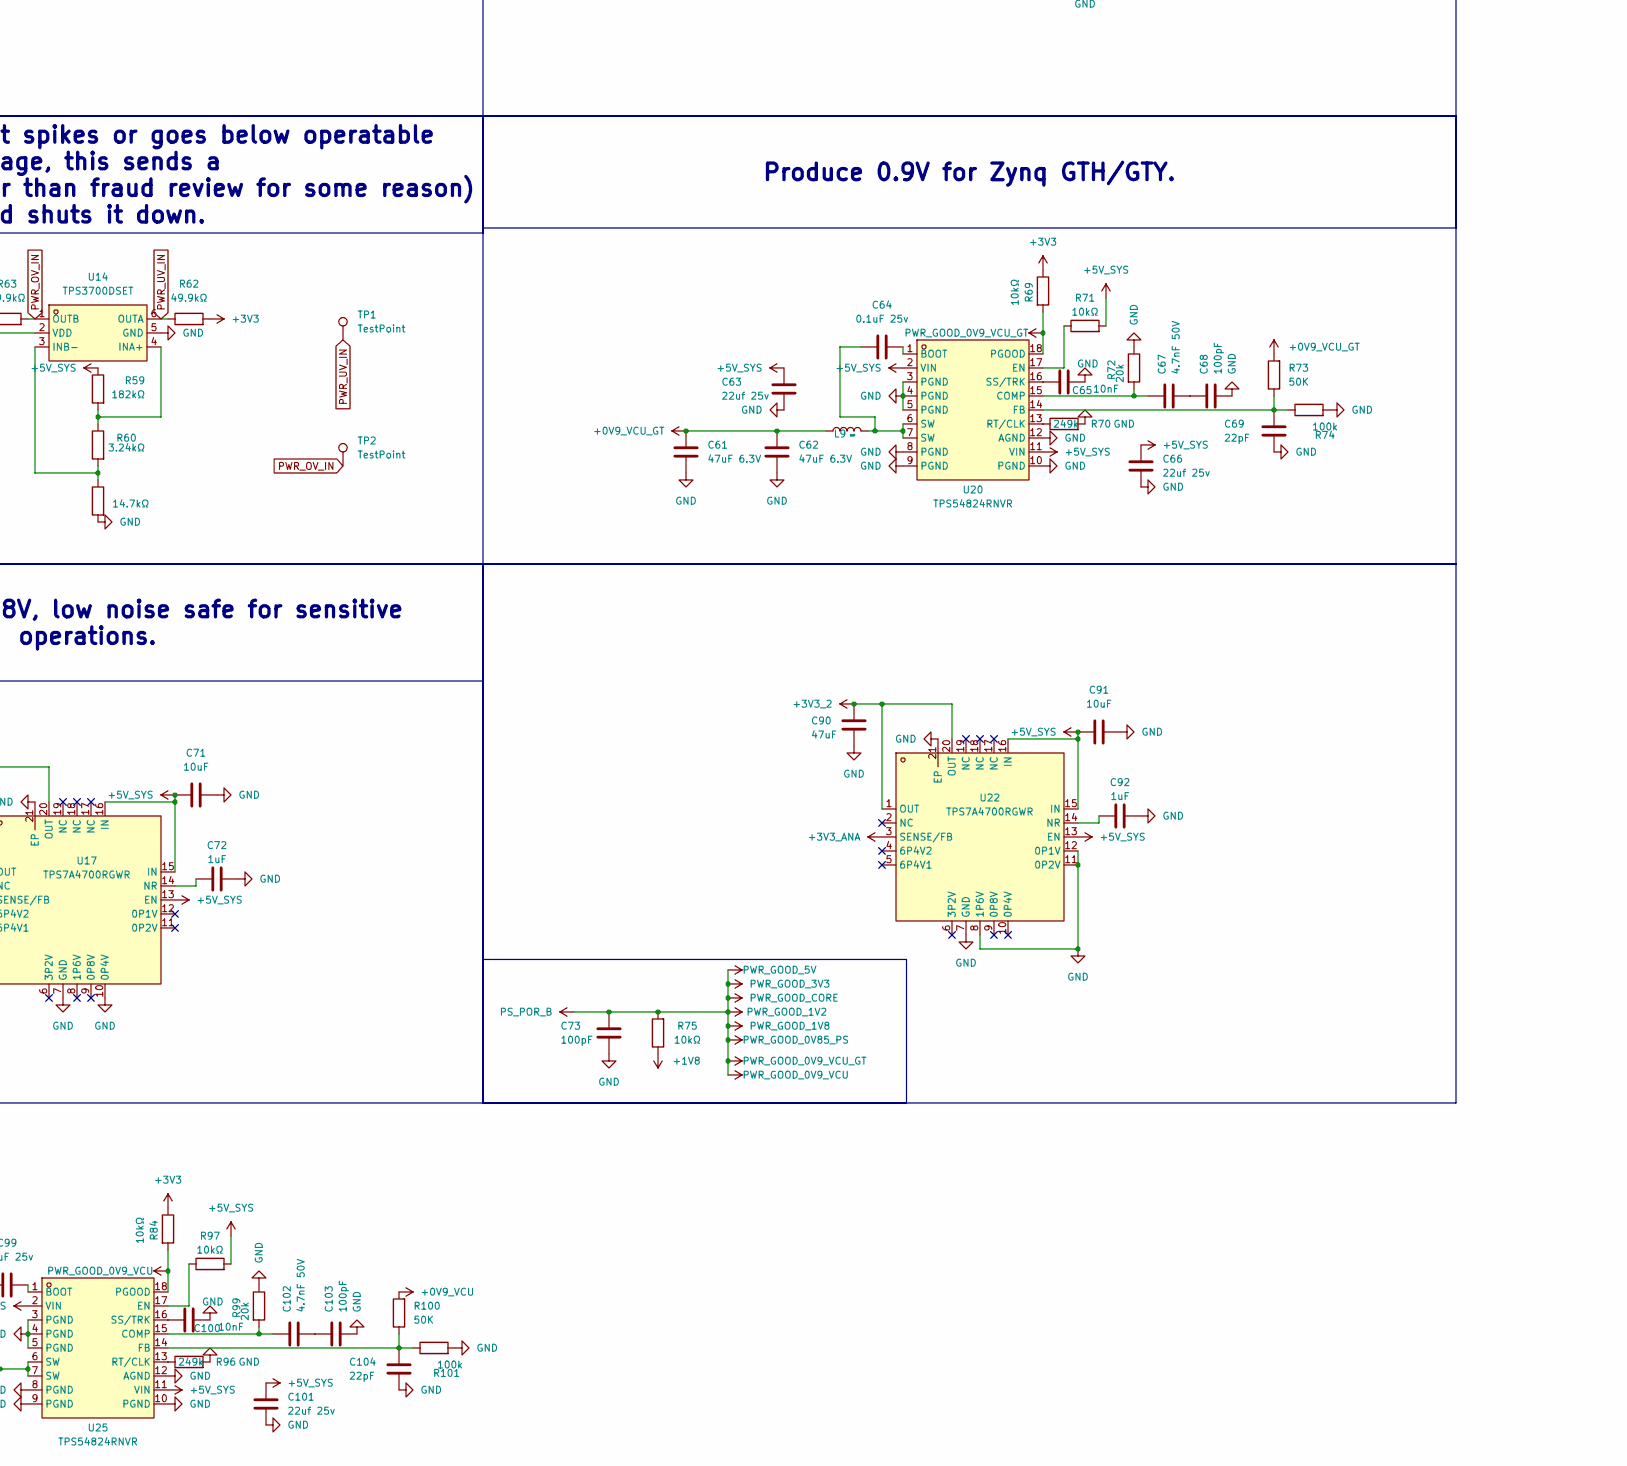
[picture p73: schematic 03_Power_Tree.kicad_sch, part in row 2, column 2]

Parts:
C19, C28, C37, C71, C74, C91, C94, C106, C108, C110: 10uF; C_0402_1005Metric
C24, C27, C29, C30, C51, C52: 22uF; C_0805_2012Metric
C31, C43: 0.1uF, 25V; C_0402_1005Metric
C32: 10nF, 10V; C_0402_1005Metric
C33, C60, C65, C100: 10nF; C_0402_1005Metric
C34, C46, C59, C68, C73, C103: 100pF; C_0402_1005Metric
C35: 3.3nF; C_0402_1005Metric
C36: 22uF, 6.3V; C_0805_2012Metric
C38, C70, C90, C93: 47uF; C_1206_3216Metric
C39, C40, C41, C42: 47uF,4V; C_1206_3216Metric
C44, C48, C49, C72, C92, C95: 1uF; C_0402_1005Metric
C45, C67, C102: 4.7nF 50V; C_0402_1005Metric
C47: 2.2nF; C_0402_1005Metric
C50: 0.1uF; C_0402_1005Metric
C53, C54, C63, C66, C98, C101: 22uf 25v; C_0805_2012Metric
C55, C64, C99: 0.1uF 25v; C_0402_1005Metric
C56, C57, C61, C62, C96, C97: 47uF 6.3V; C_1206_3216Metric
C58, C69, C104: 22pF; C_0402_1005Metric
C75, C105, C107, C109: 0.1uF 25V; C_0402_1005Metric
FB1, FB2, FB3, FB4: 120Ω@100MHz; L_01005_0402Metric
L2: 1/2.2uH; L_Bourns_SRP1245A
L3: 10uH 12A; L_Bourns_SRP1245A
L4: 0.47uH 15A; L_Bourns_SRP1245A
L5, L6: 2.2uH; L_Bourns_SRP1245A
L7, L9, L10: 1uH; L_Bourns_SRP1245A
R36, R45, R51, R54, R56, R57, R58, R74, R101: 100k; R_0402_1005Metric
R37, R38, R40, R43, R48, R66, R68, R69, R71, R75, R84, R97: 10kΩ; R_0402_1005Metric
R39: 100kΩ; R_0402_1005Metric
R41: 73.2kΩ; R_0402_1005Metric
R42: 249kΩ; R_0402_1005Metric
R44: 309k; R_0402_1005Metric
R46, R73, R100: 50K; R_0402_1005Metric
R47: 49.9k; R_0402_1005Metric
R49: 24.3kΩ; R_0402_1005Metric
R50: 60.4k; R_0402_1005Metric
R52: 10Ω; R_0402_1005Metric
R53: 200k; R_0402_1005Metric
R55: 10k; R_0402_1005Metric
R59: 182kΩ; R_0402_1005Metric
R60: 3.24kΩ; R_0402_1005Metric
R61: 14.7kΩ; R_0402_1005Metric
R62, R63: 49.9kΩ; R_0402_1005Metric
R64: 120k; R_0402_1005Metric
R65, R72, R99: 20k; R_0402_1005Metric
R67, R70, R96: 249k; R_0402_1005Metric
TP1, TP2: TestPoint; TestPoint_Pad_D1.0mm
U8: TPS62130RGTR; QFN-16_L3.0-W3.0-P0.50-TL-EP1.7; MPN TPS62130RGTR; LCSC Part C43590
U10: TPS62822DLCR; VSON-8_L2.0-W1.5-P0.50-BL; MPN TPS62822DLCR; LCSC Part C473385
U11: TPS62823DLCR; VSON-8_L2.0-W1.5-P0.50-BL; MPN TPS62823DLCR; LCSC Part C2693497
U12: TPS548A20RVER; VQFN-CLIP-28_L4.5-W3.5-P0.40-BL-EP; MPN TPS548A20RVER; LCSC Part C468255
U13, U17, U22, U23: TPS7A4700RGWR; VQFN-20_L5.0-W5.0-P0.65-TL-EP; MPN TPS7A4700RGWR; LCSC Part C114839
U14: TPS3700DSET; WSON-6_L1.5-W1.5-P0.50-TL; MPN TPS3700DSET; LCSC Part C2869244
U15, U16, U20, U25: TPS54824RNVR; VQFN-18_L3.5-W3.5-P0.50-BL_TPS54824RNVR; MPN TPS54824RNVR; LCSC Part C2070614

Connections:
+0V9_GTR: C105.1, C106.2, FB2.1
+0V9_VCU: C96.1, C97.1, FB2.2, L10.1, R100.2
+0V9_VCU_GT: C61.1, C62.1, L9.1, R73.2
+0V85: C39.1, C40.1, C41.1, C42.1, C46.2, L4.2, R48.2, U12.24 (VO)
+0V85_GTR: C74.2, C75.1, FB1.1
+0V85_PS: C56.1, C57.1, FB1.2, L7.1, R46.2
+1V2: C27.1, C51.1, FB3.2, L6.2, R56.2
+1V2_GTH: C107.1, C108.2, FB3.1
+1V8: C24.1, C52.1, FB4.2, L5.2, R53.2, R75.1
+1V8_CLEAN: C70.1, U17.1 (OUT), U17.3 (SENSE/FB), U17.20 (OUT)
+1V8_MGTRAVTT: C109.1, C110.2, FB4.1
+2V5: C93.1, U23.1 (OUT), U23.3 (SENSE/FB), U23.20 (OUT)
+3V3: C19.1, C28.1, C36.1, L2.2, R36.2, R43.2, R44.1, R51.1, R55.2, R58.2, R62.2, R63.1, R68.1, R69.1, R84.1, U8.14 (VOS), U10.1 (EN), U10.7 (VIN), U11.1 (EN), U11.7 (VIN)
+3V3_2: C90.1, U22.1 (OUT), U22.20 (OUT)
+3V3_ANA: C38.1, U13.1 (OUT), U13.3 (SENSE/FB), U13.20 (OUT), U22.3 (SENSE/FB)
+5V_SYS: C29.2, C30.2, C37.1, C47.2, C50.1, C53.1, C54.1, C63.1, C66.1, C71.1, C91.1, C94.1, C98.1, C101.1, L3.2, R41.2, R52.1, R59.1, R66.2, R71.2, R97.2, U8.10 (AVIN), U8.11 (PVIN), U8.12 (PVIN), U8.13 (EN), U12.3 (EN), U12.15 (VIN), U12.16 (VIN), U12.17 (VIN), U13.13 (EN), U13.15 (IN), U13.16 (IN), U14.2 (VDD), U16.2 (VIN), U16.11 (VIN), U17.13 (EN), U17.15 (IN), U17.16 (IN), U20.2 (VIN), U20.11 (VIN), U22.13 (EN), U22.15 (IN), U22.16 (IN), U23.13 (EN), U23.15 (IN), U23.16 (IN), U25.2 (VIN), U25.11 (VIN)
+15V_MAIN: R39.2, U15.2 (VIN), U15.11 (VIN)
BOOT: C31.1, U15.1 (BOOT)
GND: C19.2, C24.2, C27.2, C28.2, C29.1, C30.1, C32.2, C34.2, C35.1, C36.2, C37.2, C38.2, C39.2, C40.2, C41.2, C42.2, C44.2, C47.1, C48.2, C49.2, C50.2, C51.2, C52.2, C53.2, C54.2, C56.2, C57.2, C58.2, C59.2, C60.2, C61.2, C62.2, C63.2, C65.2, C66.2, C68.2, C69.2, C70.2, C71.2, C72.2, C73.1, C74.1, C75.2, C90.2, C91.2, C92.2, C93.2, C94.2, C95.2, C96.2, C97.2, C98.2, C100.2, C101.2, C103.2, C104.2, C105.2, C106.1, C107.2, C108.1, C109.2, C110.1, R37.2, R38.2, R40.2, R42.2, R45.1, R47.1, R49.2, R50.1, R54.2, R57.2, R61.2, R64.2, R65.1, R67.2, R70.2, R72.1, R74.2, R96.2, R99.1, R101.2, U8.6 (AGND), U8.7 (FSW), U8.8 (DEF), U8.15 (PGND), U8.16 (PGND), U8.17 (EP), U10.3 (AGND), U10.5 (PGND), U11.3 (AGND), U11.5 (PGND), U12.10 (PGND), U12.11 (PGND), U12.12 (PGND), U12.13 (PGND), U12.14 (PGND), U12.21 (MODE), U12.22 (GND), U12.27 (GND1), U12.28 (GND2), U12.29 (EP), U13.7 (GND), U13.8 (1P6V), U13.11 (0P2V), U13.12 (0P1V), U13.21 (EP), U14.5 (GND), U15.3 (PGND), U15.4 (PGND), U15.5 (PGND), U15.8 (PGND), U15.9 (PGND), U15.10 (PGND), U15.12 (AGND), U16.3 (PGND), U16.4 (PGND), U16.5 (PGND), U16.8 (PGND), U16.9 (PGND), U16.10 (PGND), U16.12 (AGND), U17.7 (GND), U17.10 (0P4V), U17.21 (EP), U20.3 (PGND), U20.4 (PGND), U20.5 (PGND), U20.8 (PGND), U20.9 (PGND), U20.10 (PGND), U20.12 (AGND), U22.7 (GND), U22.8 (1P6V), U22.11 (0P2V), U22.12 (0P1V), U22.21 (EP), U23.7 (GND), U23.9 (0P8V), U23.11 (0P2V), U23.12 (0P1V), U23.21 (EP), U25.3 (PGND), U25.4 (PGND), U25.5 (PGND), U25.8 (PGND), U25.9 (PGND), U25.10 (PGND), U25.12 (AGND)
unnamed: C32.1, U15.16 (SS/TRK)
unnamed: C33.1, C34.1, U15.15 (COMP)
unnamed: C33.2, R37.1
unnamed: C35.2, U8.9 (SS/TR)
unnamed: C43.1, L4.1, U12.6 (SW), U12.7 (SW), U12.8 (SW), U12.9 (SW)
unnamed: C43.2, U12.4 (VBST)
unnamed: C44.1, R52.2, U12.19 (VDD)
unnamed: C45.1, R65.2, U16.15 (COMP)
unnamed: C45.2, C59.1
unnamed: C46.1, R48.1, R49.1, U12.23 (FB)
unnamed: C48.1, U12.20 (VREG)
unnamed: C49.1, U13.14 (NR)
unnamed: C55.1, L7.2, U16.6 (SW), U16.7 (SW)
unnamed: C55.2, U16.1 (BOOT)
unnamed: C58.1, R46.1, R64.1, U16.14 (FB)
unnamed: C60.1, U16.16 (SS/TRK)
unnamed: C64.1, L9.2, U20.6 (SW), U20.7 (SW)
unnamed: C64.2, U20.1 (BOOT)
unnamed: C65.1, U20.16 (SS/TRK)
unnamed: C67.1, R72.2, U20.15 (COMP)
unnamed: C67.2, C68.1
unnamed: C69.1, R73.1, R74.1, U20.14 (FB)
unnamed: C72.1, U17.14 (NR)
unnamed: C92.1, U22.14 (NR)
unnamed: C95.1, U23.14 (NR)
unnamed: C99.1, L10.2, U25.6 (SW), U25.7 (SW)
unnamed: C99.2, U25.1 (BOOT)
unnamed: C100.1, U25.16 (SS/TRK)
unnamed: C102.1, R99.2, U25.15 (COMP)
unnamed: C102.2, C103.1
unnamed: C104.1, R100.1, R101.1, U25.14 (FB)
unnamed: L2.1, U8.1 (SW), U8.2 (SW), U8.3 (SW)
unnamed: L5.1, U10.6 (SW)
unnamed: L6.1, U11.6 (SW)
unnamed: R38.1, R39.1, U15.17 (EN)
unnamed: R40.1, R41.1, U15.14 (FB)
unnamed: R42.1, U15.13 (RT/CLK)
unnamed: R44.2, R45.2, U8.5 (FB)
unnamed: R47.2, U12.25 (TRIP)
unnamed: R50.2, U12.1 (RF)
unnamed: R53.1, R54.1, U10.2 (FB)
unnamed: R56.1, R57.1, U11.2 (FB)
unnamed: R59.2, R60.1, U14.4 (INA+)
unnamed: R60.2, R61.1, U14.3 (INB-)
unnamed: R66.1, U16.17 (EN)
unnamed: R67.1, U16.13 (RT/CLK)
unnamed: R70.1, U20.13 (RT/CLK)
unnamed: R71.1, U20.17 (EN)
unnamed: R96.1, U25.13 (RT/CLK)
unnamed: R97.1, U25.17 (EN)
PS_POR_B: C73.2, R36.1, R43.1, R51.2, R55.1, R58.1, R68.2, R69.2, R75.2, R84.2, U8.4 (PG), U10.8 (PG), U11.8 (PG), U12.2 (PGOOD), U15.18 (PGOOD), U16.18 (PGOOD), U20.18 (PGOOD), U25.18 (PGOOD)
PWR_OV_IN: R63.2, TP2.1, U14.1 (OUTB)
PWR_UV_IN: R62.1, TP1.1, U14.6 (OUTA)
SW: C31.2, L3.1, U15.6 (SW), U15.7 (SW)

Notes on the sheet:
SECTION 3 : POWER TREE
Steps down 5V to the 0.85V rail for Zynq.
This component takes +20V_Main from USB-C/DC Jack and steps it down to +5V_SYS rail, inductor stablizes this.
This takes the +5V_SYS line and steps it down to +3.3V rail for Zynq,I/O,sensors and logic.
Steps down 3.3V to 1.8V, which is used for Zynq I/O banks and DDR4 VDDQ.
Monitors 5V rail, if it spikes or goes below operatable voltage, this sends a message to Zynq (faster than fraud review for some reason) and shuts it down.
Steps down 3.3V to 1.2V used by DDR4 RAM (its cheaper than DDR5 btw)
Produce 0.9V for Zynq GTH/GTY.
Produces two other sets of 0.85V for Zynq.
Takes 5V railand produces ultra very low noise +3V3_ANA rail, only for ADC,UWB module!!
Produces clean 1.8V, low noise safe for sensitive operations.
