damnitzhemanth-oss/FusionBoard/PCB/Devboard/_restore_backup_2026-10-17T13-50-13-028/schematics/03_Power_Tree/03_Power_Tree.kicad_sch

## KiCad design PCB/Devboard/_restore_backup_2026-10-17T13-50-13-028/schematics/03_Power_Tree/03_Power_Tree.kicad_sch (2026-10-17)

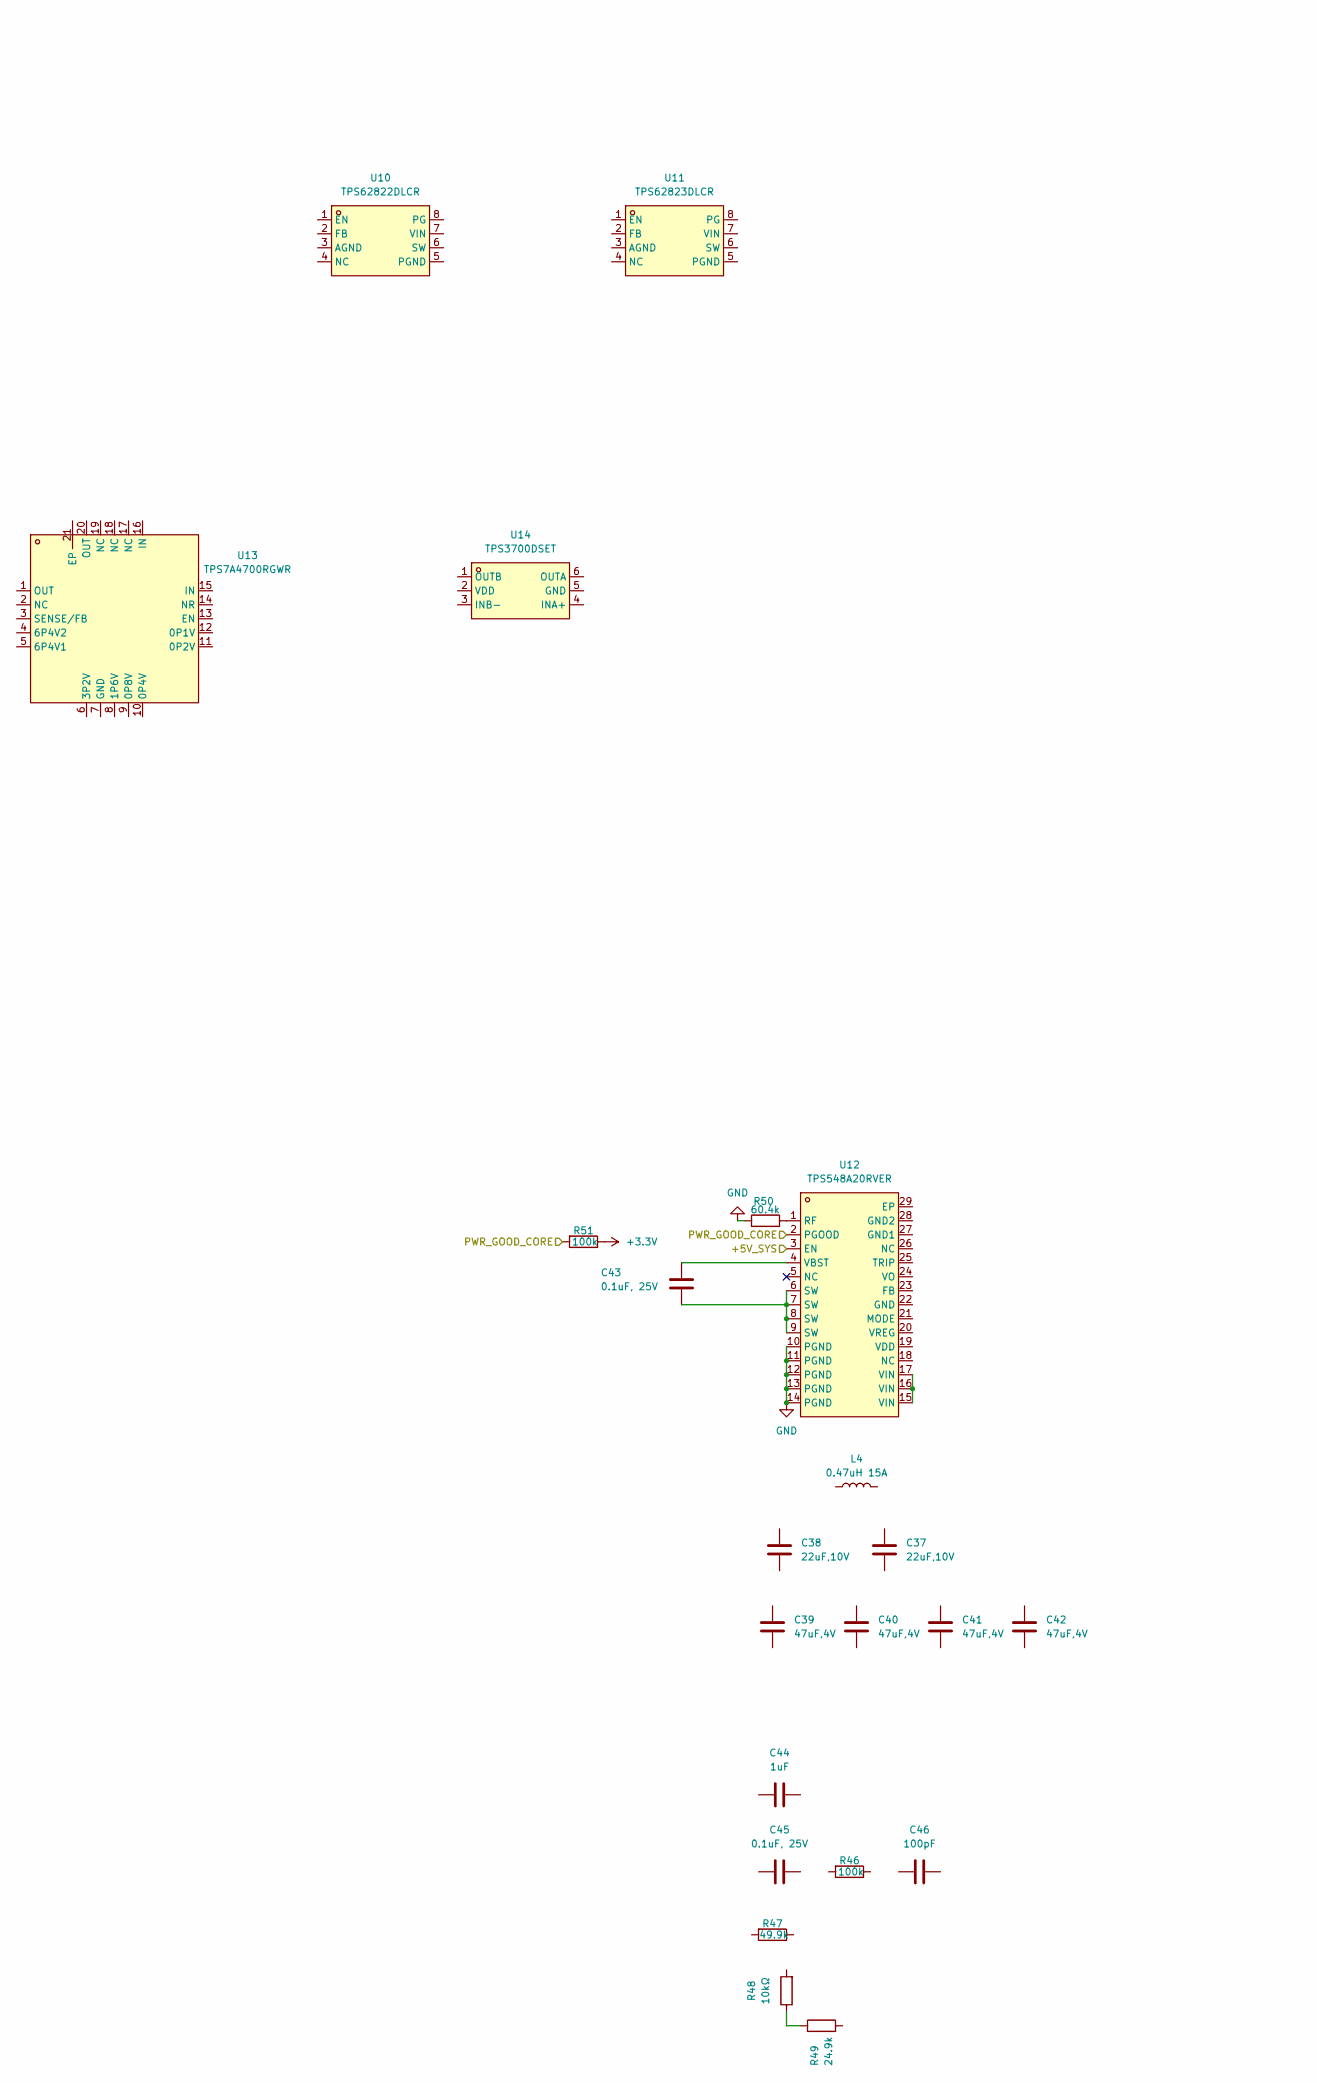
[picture p76: schematic 03_Power_Tree.kicad_sch, part in row 1, column 1]

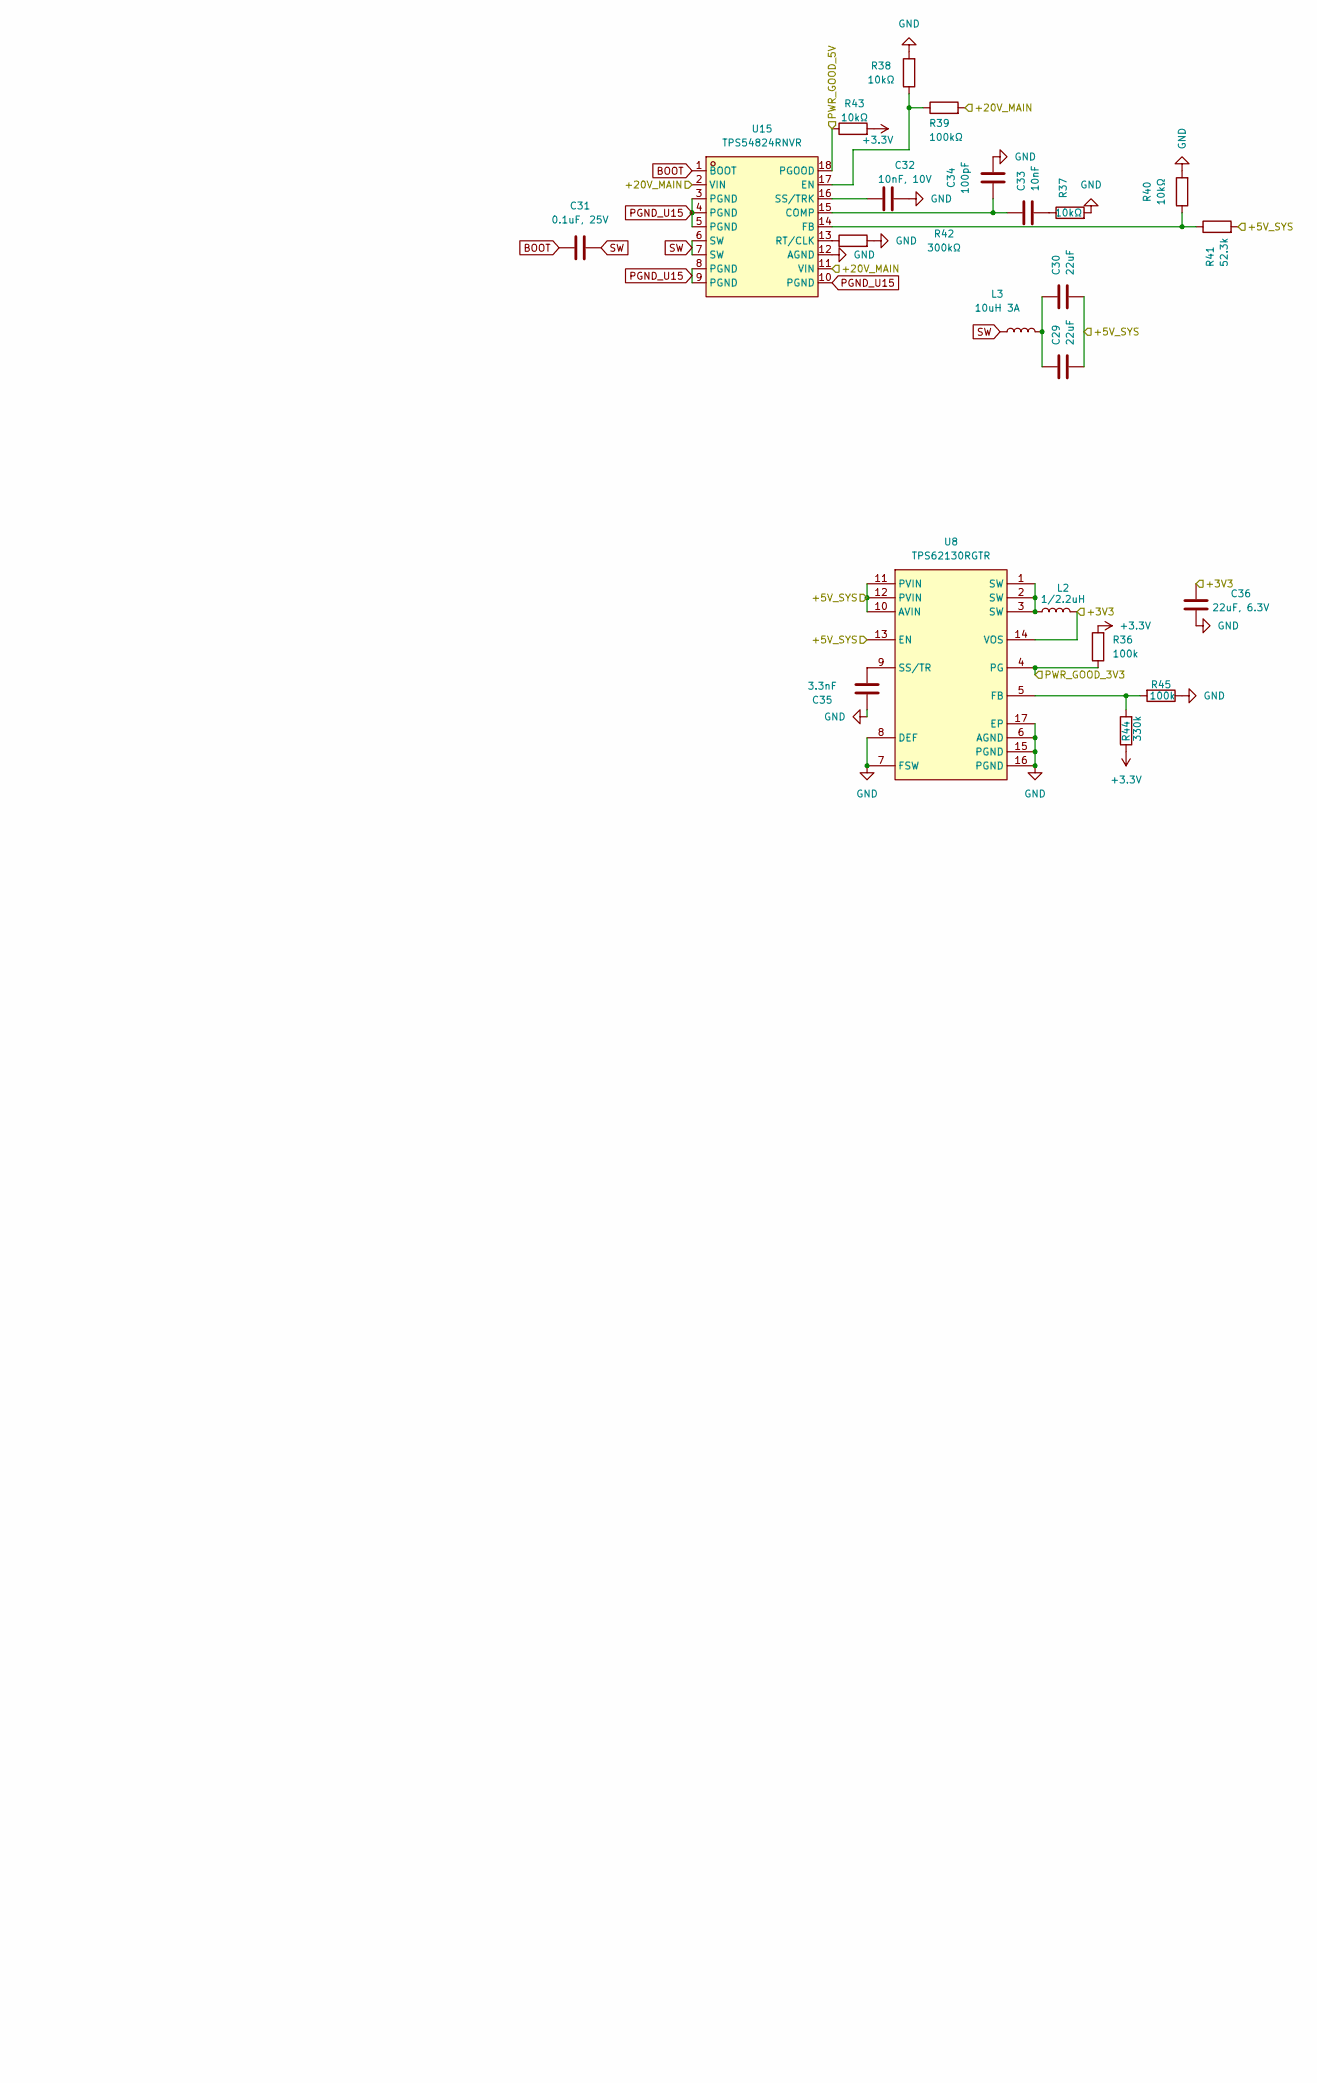
[picture p77: schematic 03_Power_Tree.kicad_sch, part in row 1, column 2]

Parts:
C29, C30: 22uF
C31, C43, C45: 0.1uF, 25V
C32: 10nF, 10V
C33: 10nF
C34, C46: 100pF
C35: 3.3nF
C36: 22uF, 6.3V
C37, C38: 22uF,10V
C39, C40, C41, C42: 47uF,4V
C44: 1uF
L2: 1/2.2uH
L3: 10uH 3A
L4: 0.47uH 15A
R36, R45, R46, R51: 100k
R37, R38, R40, R43, R48: 10kΩ
R39: 100kΩ
R41: 52.3k
R42: 300kΩ
R44: 330k
R47: 49.9k
R49: 24.9k
R50: 60.4k
U8: TPS62130RGTR; QFN-16_L3.0-W3.0-P0.50-TL-EP1.7; MPN TPS62130RGTR; LCSC Part C43590
U10: TPS62822DLCR; VSON-8_L2.0-W1.5-P0.50-BL; MPN TPS62822DLCR; LCSC Part C473385
U11: TPS62823DLCR; VSON-8_L2.0-W1.5-P0.50-BL; MPN TPS62823DLCR; LCSC Part C2693497
U12: TPS548A20RVER; VQFN-CLIP-28_L4.5-W3.5-P0.40-BL-EP; MPN TPS548A20RVER; LCSC Part C468255
U13: TPS7A4700RGWR; VQFN-20_L5.0-W5.0-P0.65-TL-EP; MPN TPS7A4700RGWR; LCSC Part C114839
U14: TPS3700DSET; WSON-6_L1.5-W1.5-P0.50-TL; MPN TPS3700DSET; LCSC Part C2869244
U15: TPS54824RNVR; VQFN-18_L3.5-W3.5-P0.50-BL_TPS54824RNVR; MPN TPS54824RNVR; LCSC Part C2070614

Connections:
+3.3V: R36.2, R43.2, R44.1, R51.1
+3V3: C36.1, L2.2, U8.14 (VOS)
+5V_SYS: C29.2, C30.2, R41.2, U8.10 (AVIN), U8.11 (PVIN), U8.12 (PVIN), U8.13 (EN), U12.3 (EN)
+20V_MAIN: R39.2, U15.2 (VIN), U15.11 (VIN)
BOOT: C31.1, U15.1 (BOOT)
GND: C32.2, C34.2, C35.1, C36.2, R37.2, R38.2, R40.2, R42.2, R45.1, R50.1, U8.6 (AGND), U8.7 (FSW), U8.8 (DEF), U8.15 (PGND), U8.16 (PGND), U8.17 (EP), U12.10 (PGND), U12.11 (PGND), U12.12 (PGND), U12.13 (PGND), U12.14 (PGND), U15.12 (AGND)
unnamed: C29.1, C30.1, L3.2
unnamed: C32.1, U15.16 (SS/TRK)
unnamed: C33.1, C34.1, U15.15 (COMP)
unnamed: C33.2, R37.1
unnamed: C35.2, U8.9 (SS/TR)
unnamed: C43.1, U12.6 (SW), U12.7 (SW), U12.8 (SW), U12.9 (SW)
unnamed: C43.2, U12.4 (VBST)
unnamed: L2.1, U8.1 (SW), U8.2 (SW), U8.3 (SW)
unnamed: R38.1, R39.1, U15.17 (EN)
unnamed: R40.1, R41.1, U15.14 (FB)
unnamed: R42.1, U15.13 (RT/CLK)
unnamed: R44.2, R45.2, U8.5 (FB)
unnamed: R48.1, R49.1
unnamed: R50.2, U12.1 (RF)
unnamed: U12.15 (VIN), U12.16 (VIN), U12.17 (VIN)
PGND_U15: U15.3 (PGND), U15.4 (PGND), U15.5 (PGND), U15.8 (PGND), U15.9 (PGND), U15.10 (PGND)
PWR_GOOD_3V3: R36.1, U8.4 (PG)
PWR_GOOD_5V: R43.1, U15.18 (PGOOD)
PWR_GOOD_CORE: R51.2, U12.2 (PGOOD)
SW: C31.2, L3.1, U15.6 (SW), U15.7 (SW)
