damnitzhemanth-oss/FusionBoard/(commit log)

2026-10-31 Feat : Schematics Complete
2026-10-31 Added Schematic Images
2026-11-01 Feat: PCB Done
2026-11-05 Added Gerbers.zip
